sgeisser1/Tr-pfli/app/docs/screenshots/01_uebersicht_desktop.png

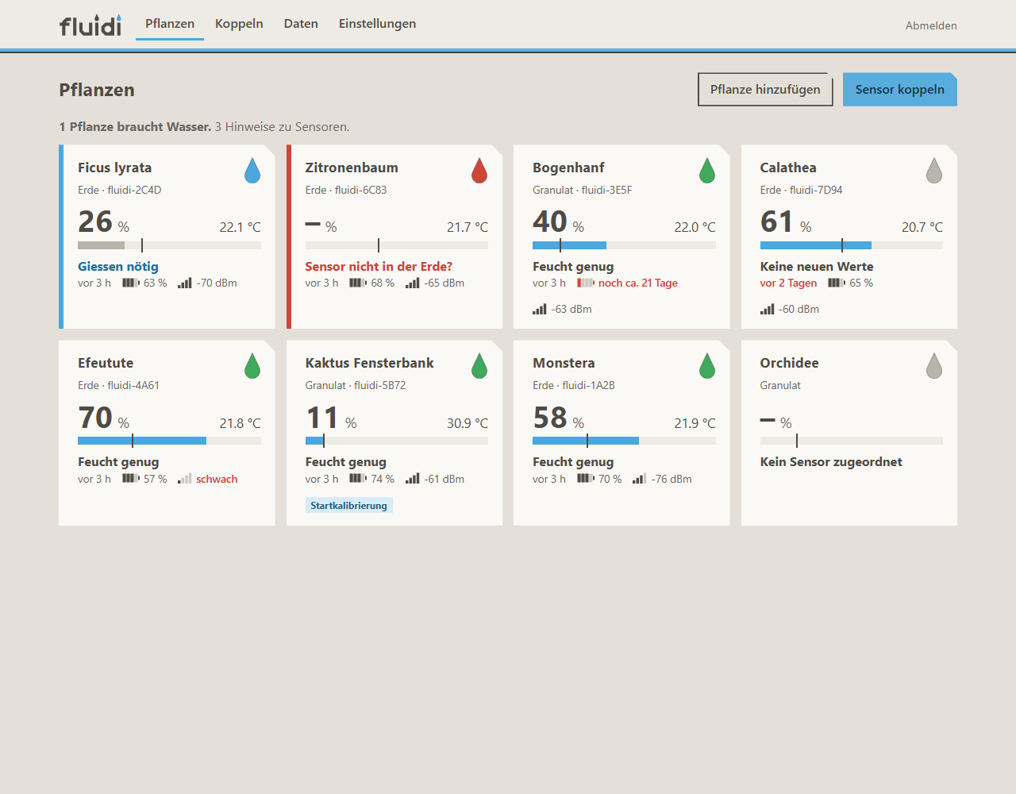
app/docs/screenshots/01_uebersicht_desktop.png
