sgeisser1/Tr-pfli/app/docs/screenshots/02_uebersicht_schmal.png

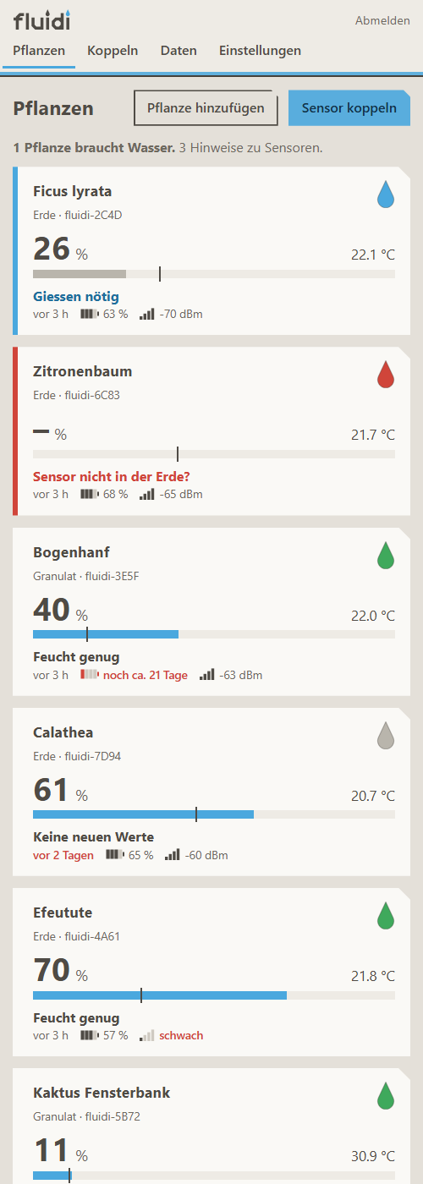
app/docs/screenshots/02_uebersicht_schmal.png
