sgeisser1/Tr-pfli/app/docs/screenshots/03_detail_woche_desktop.png

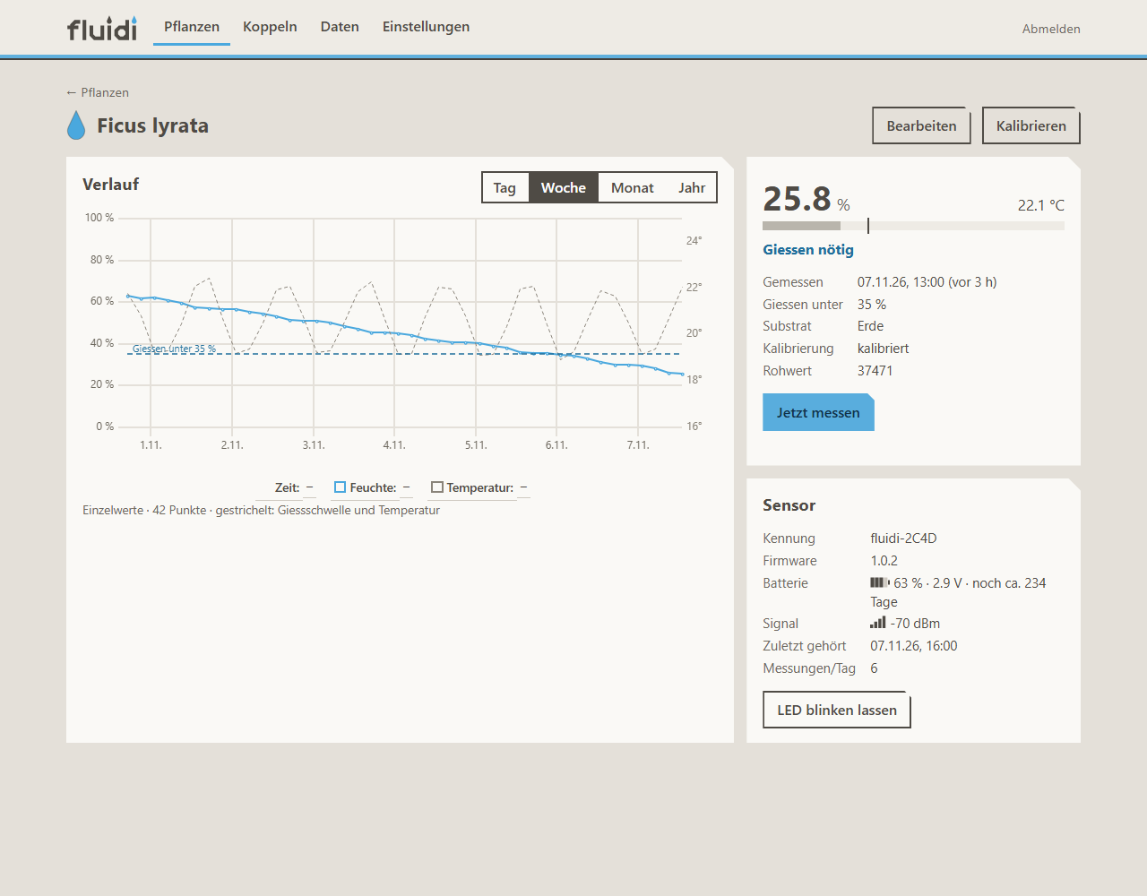
app/docs/screenshots/03_detail_woche_desktop.png
