sgeisser1/Tr-pfli/app/docs/screenshots/04_detail_jahr_schmal.png

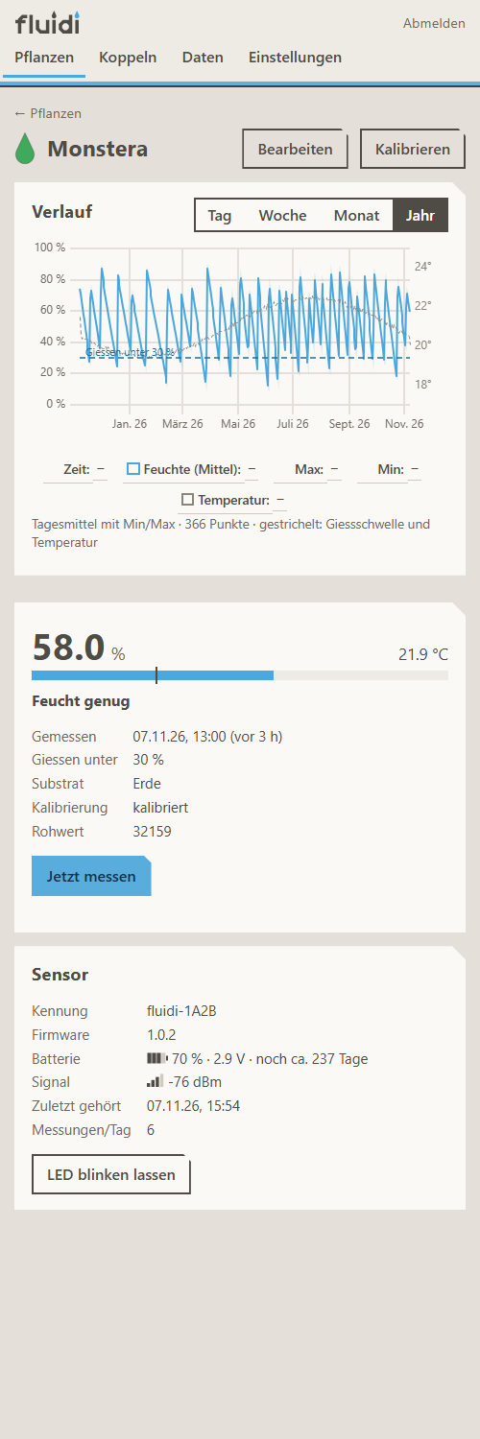
app/docs/screenshots/04_detail_jahr_schmal.png
