sgeisser1/Tr-pfli/app/docs/screenshots/06_bearbeiten.png

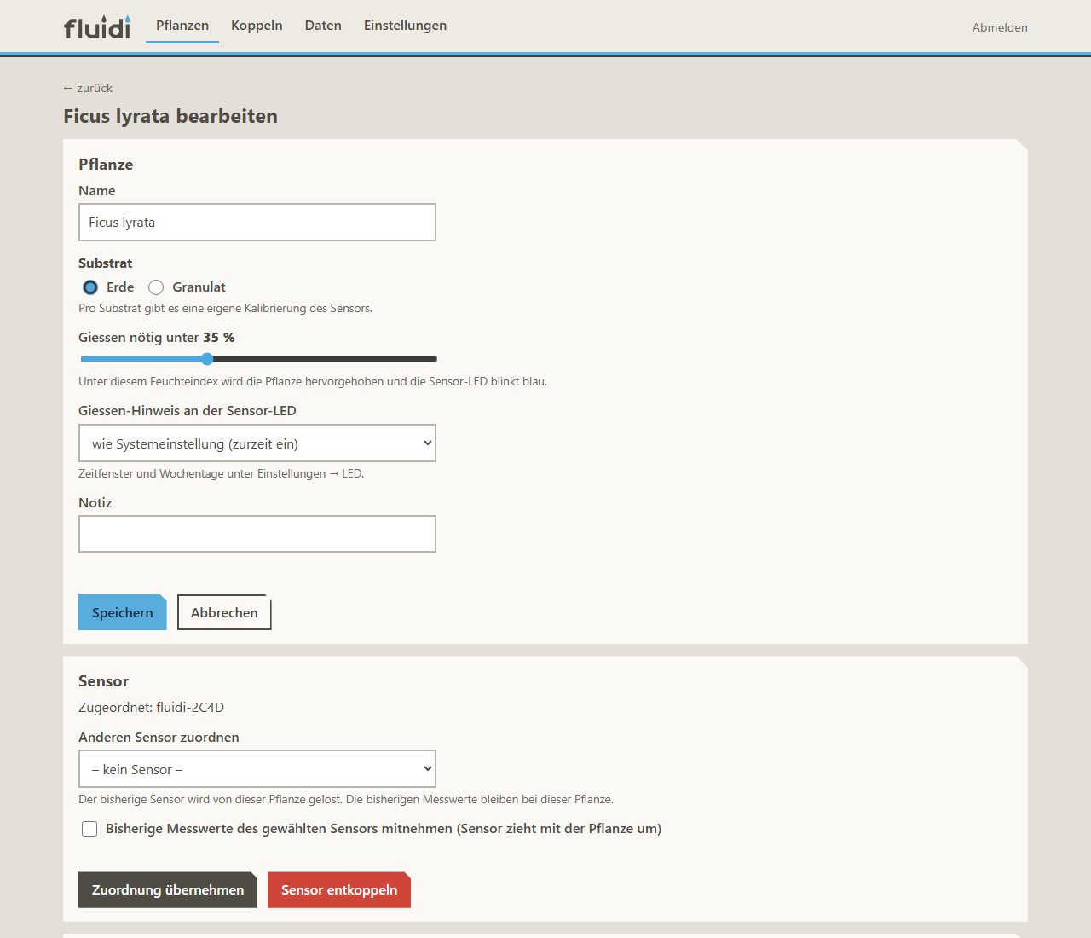
app/docs/screenshots/06_bearbeiten.png
