sgeisser1/Tr-pfli/app/docs/screenshots/08_koppeln.png

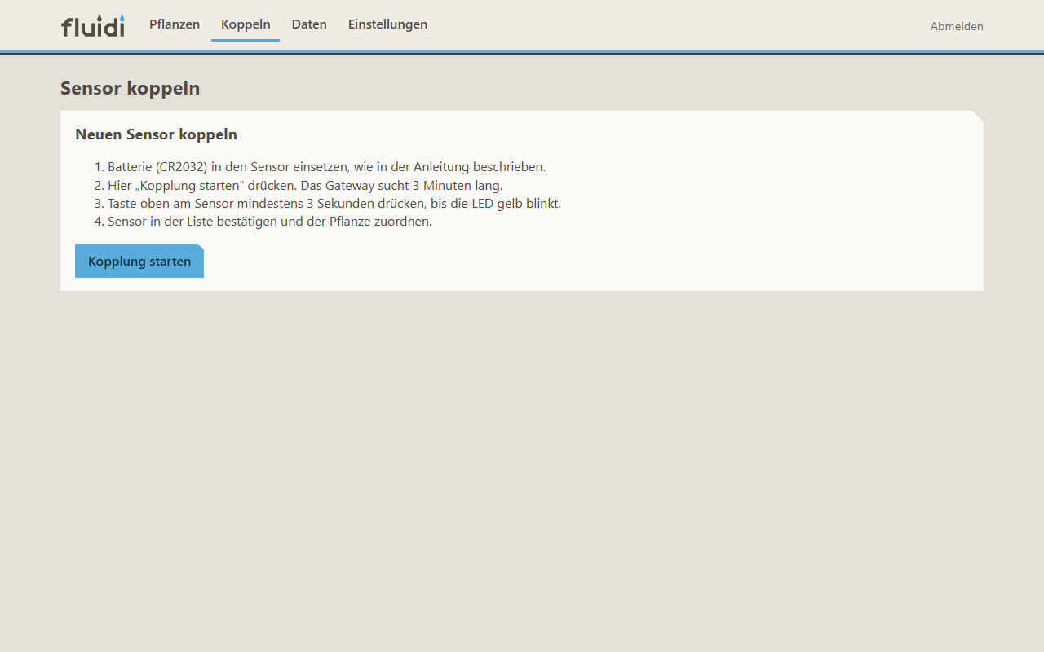
app/docs/screenshots/08_koppeln.png
