sgeisser1/Tr-pfli/app/docs/screenshots/09_einstellungen.png

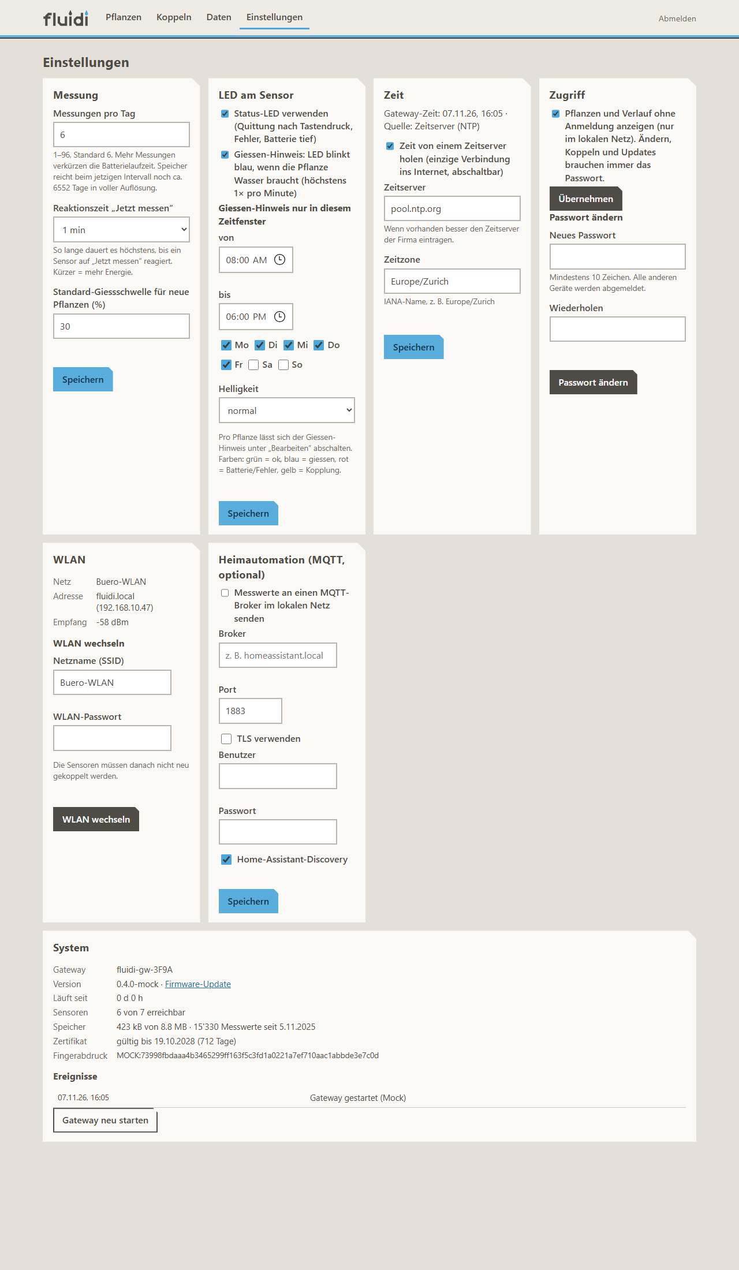
app/docs/screenshots/09_einstellungen.png
