sgeisser1/Tr-pfli/app/docs/screenshots/10_firmware.png

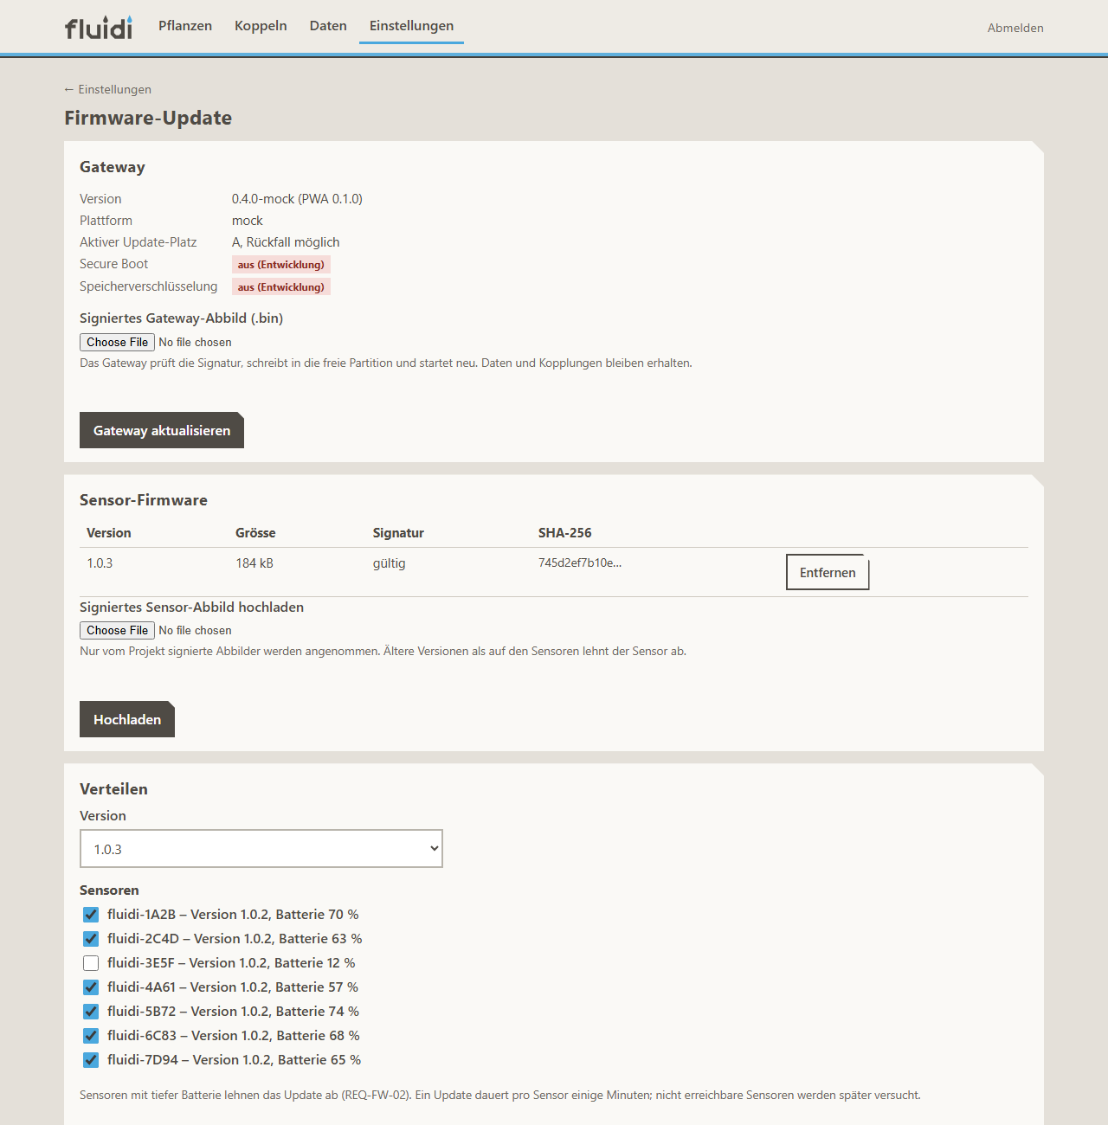
app/docs/screenshots/10_firmware.png
