sgeisser1/Tr-pfli/app/docs/screenshots/11_daten.png

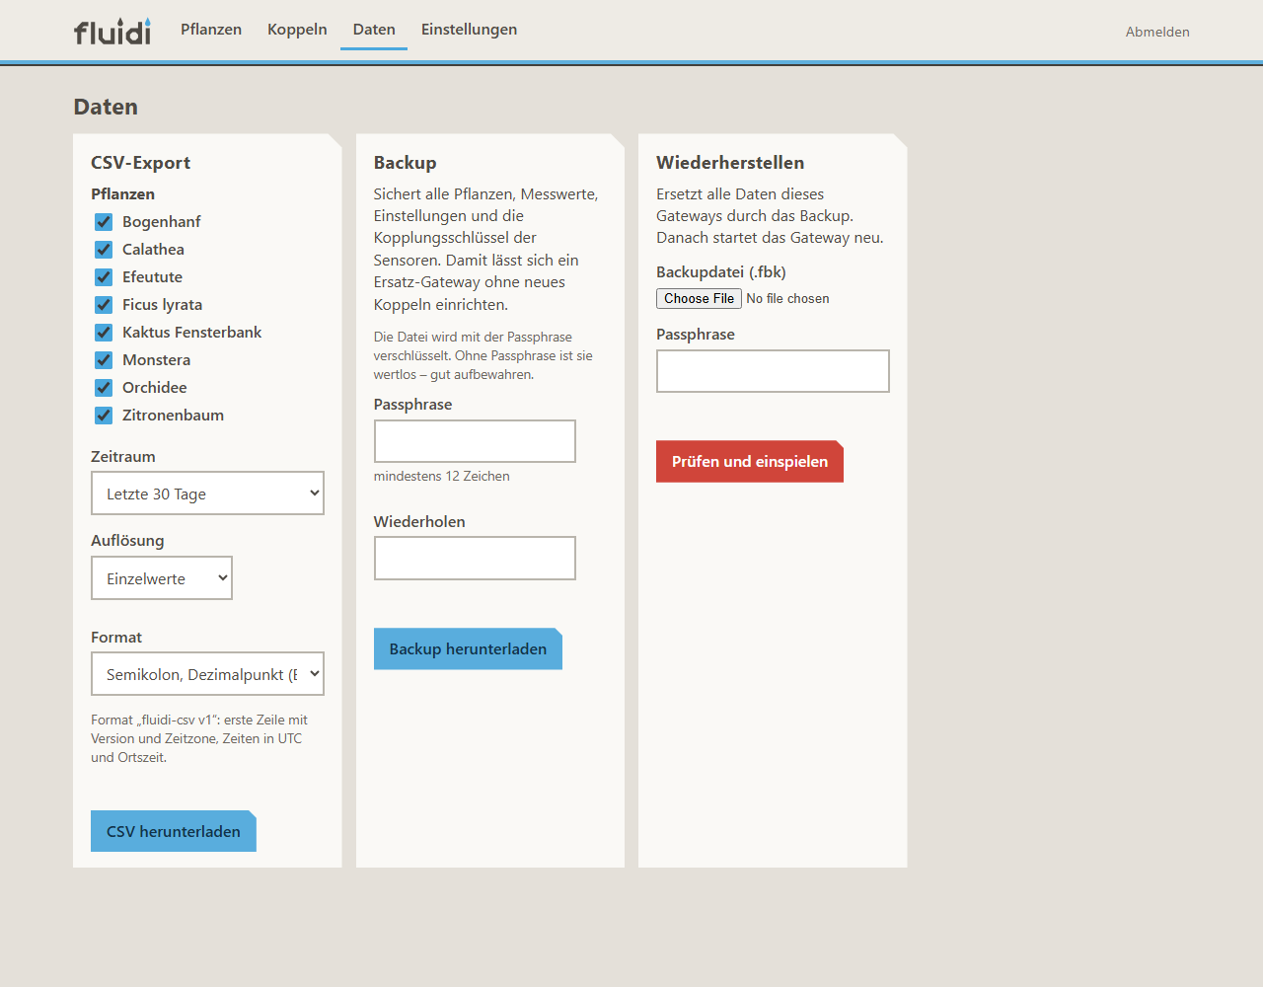
app/docs/screenshots/11_daten.png
