sgeisser1/Tr-pfli/app/docs/screenshots/12_anmelden_schmal.png

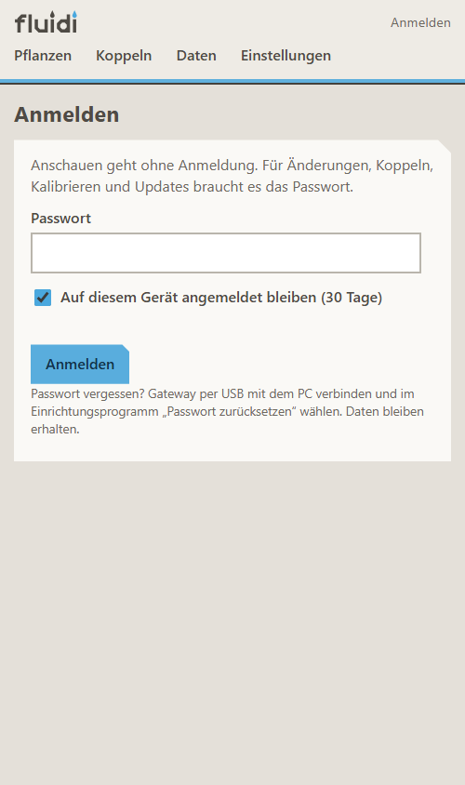
app/docs/screenshots/12_anmelden_schmal.png
