sgeisser1/Tr-pfli/app/docs/screenshots/13_einrichten_schmal.png

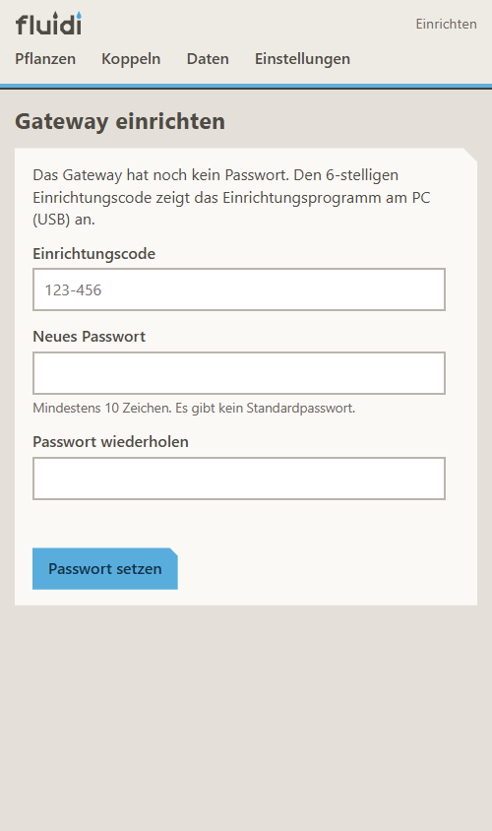
app/docs/screenshots/13_einrichten_schmal.png
