sgeisser1/Tr-pfli/app/docs/screenshots/14_detail_luft_schmal.png

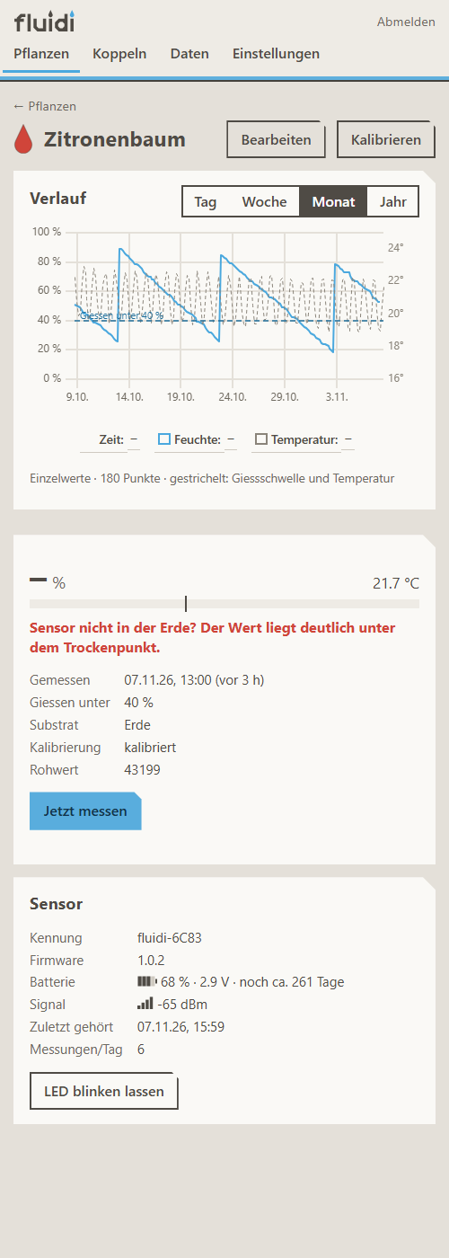
app/docs/screenshots/14_detail_luft_schmal.png
