sgeisser1/Tr-pfli/docs/datasheets/Adafruit_5776_SHT41_Schematic_2023-07.png

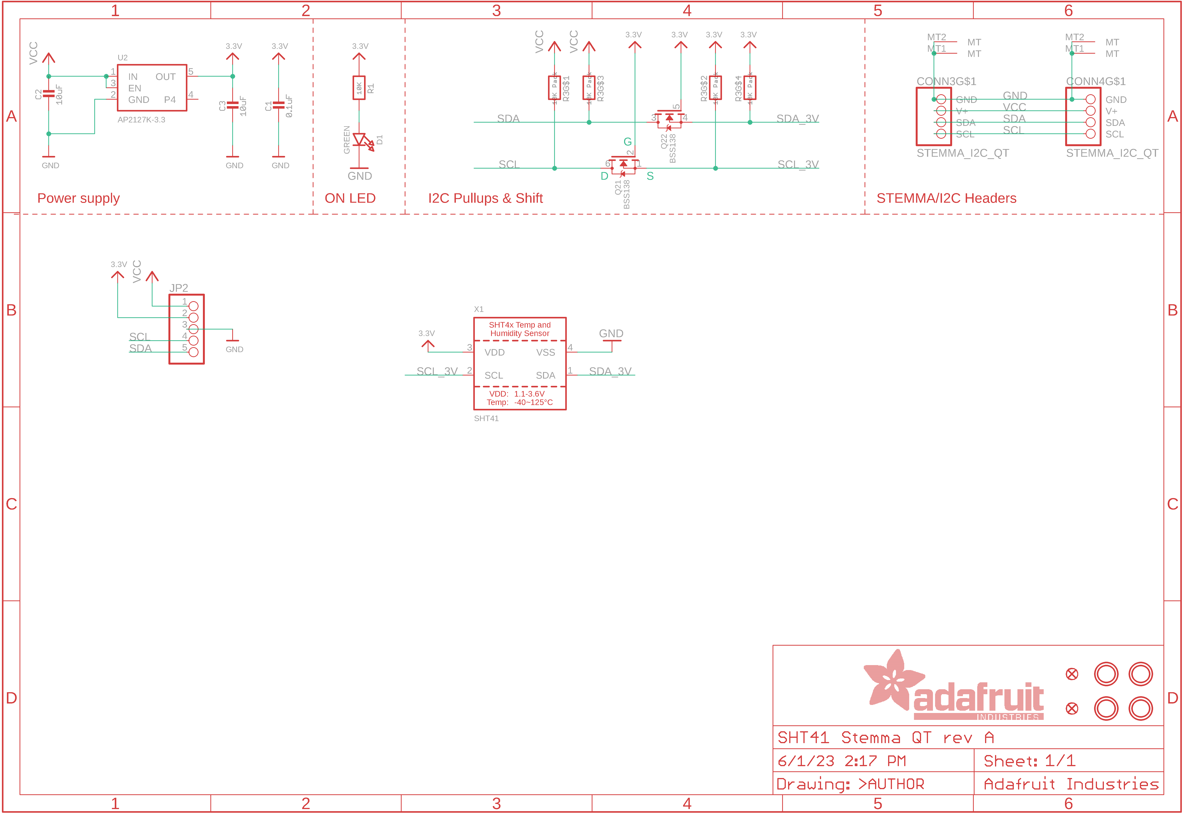
docs/datasheets/Adafruit_5776_SHT41_Schematic_2023-07.png
