sgeisser1/Tr-pfli/docs/datasheets/DFRobot_SEN0428_Dimensions_V0.1.png

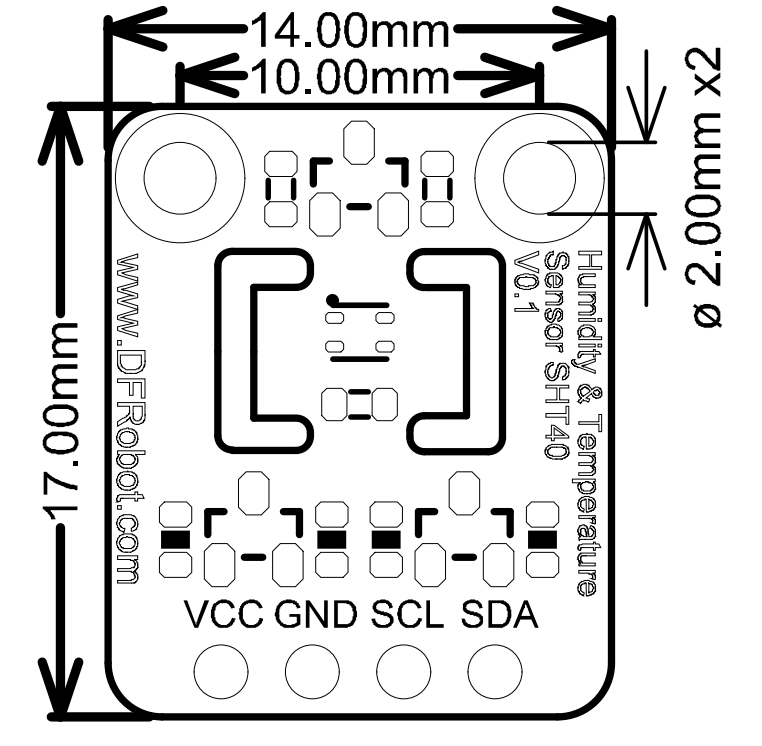
docs/datasheets/DFRobot_SEN0428_Dimensions_V0.1.png
