sgeisser1/Tr-pfli/docs/references/JLCPCB_ExtraCharges_SmallBoards_Tabelle_2026-11-08.png

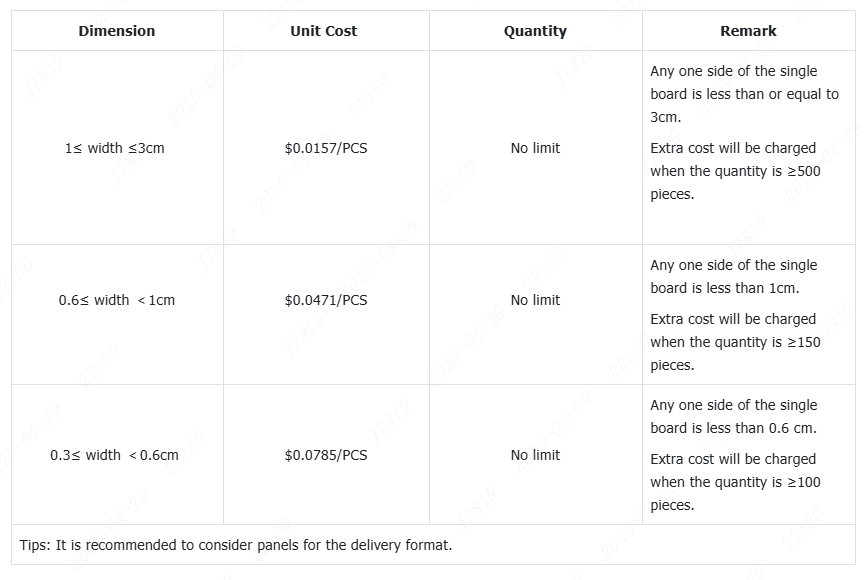
docs/references/JLCPCB_ExtraCharges_SmallBoards_Tabelle_2026-11-08.png
