sgeisser1/Tr-pfli/hardware/programmer/out/behelf_lageplan.png

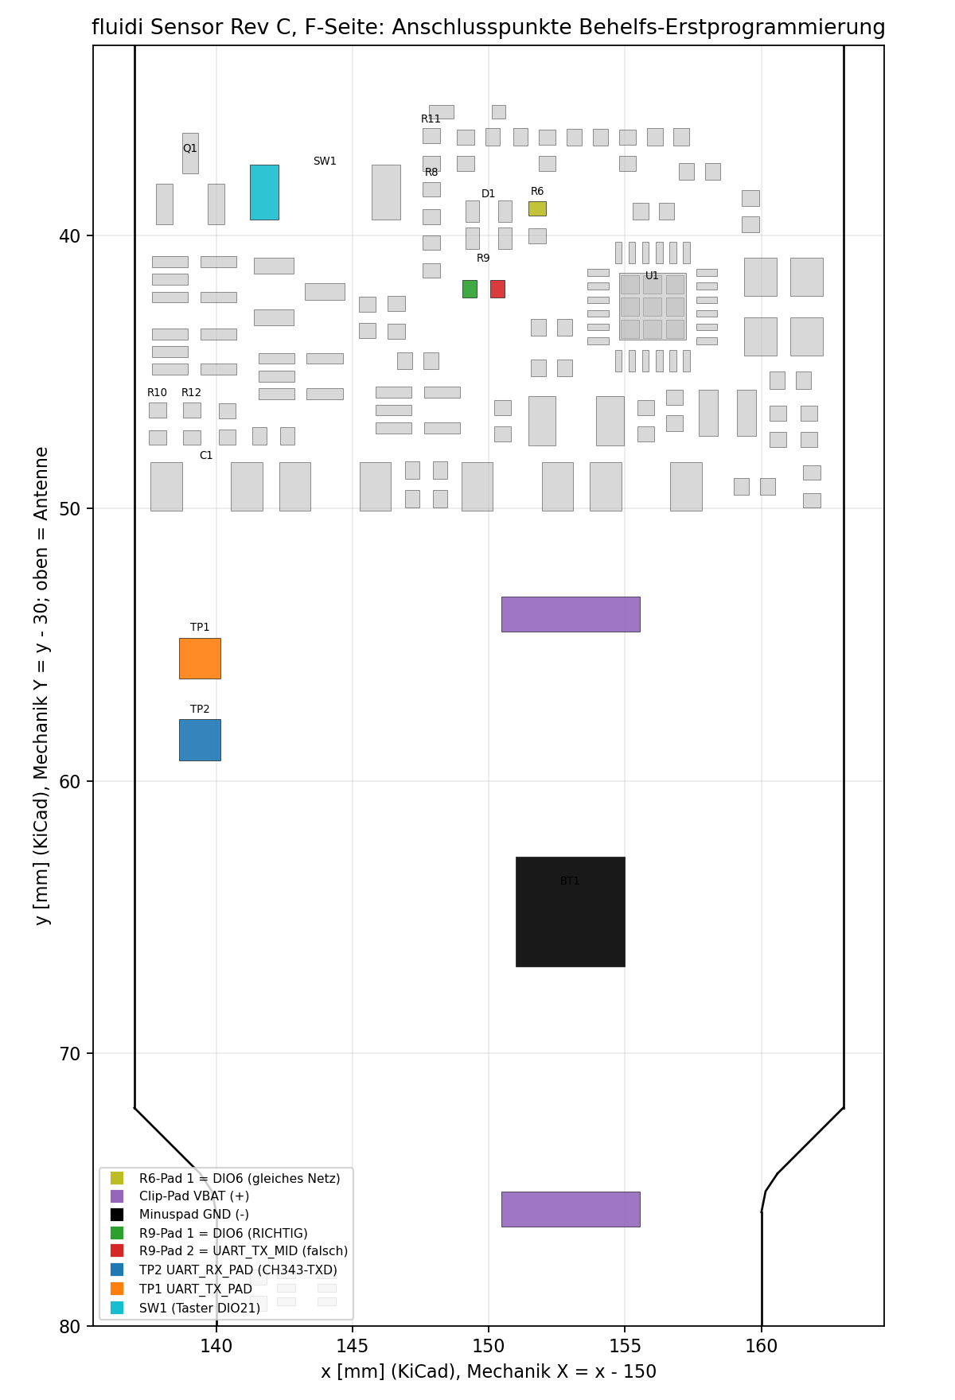
hardware/programmer/out/behelf_lageplan.png
