sgeisser1/Tr-pfli/hardware/sensor/out/floorplan_options.png

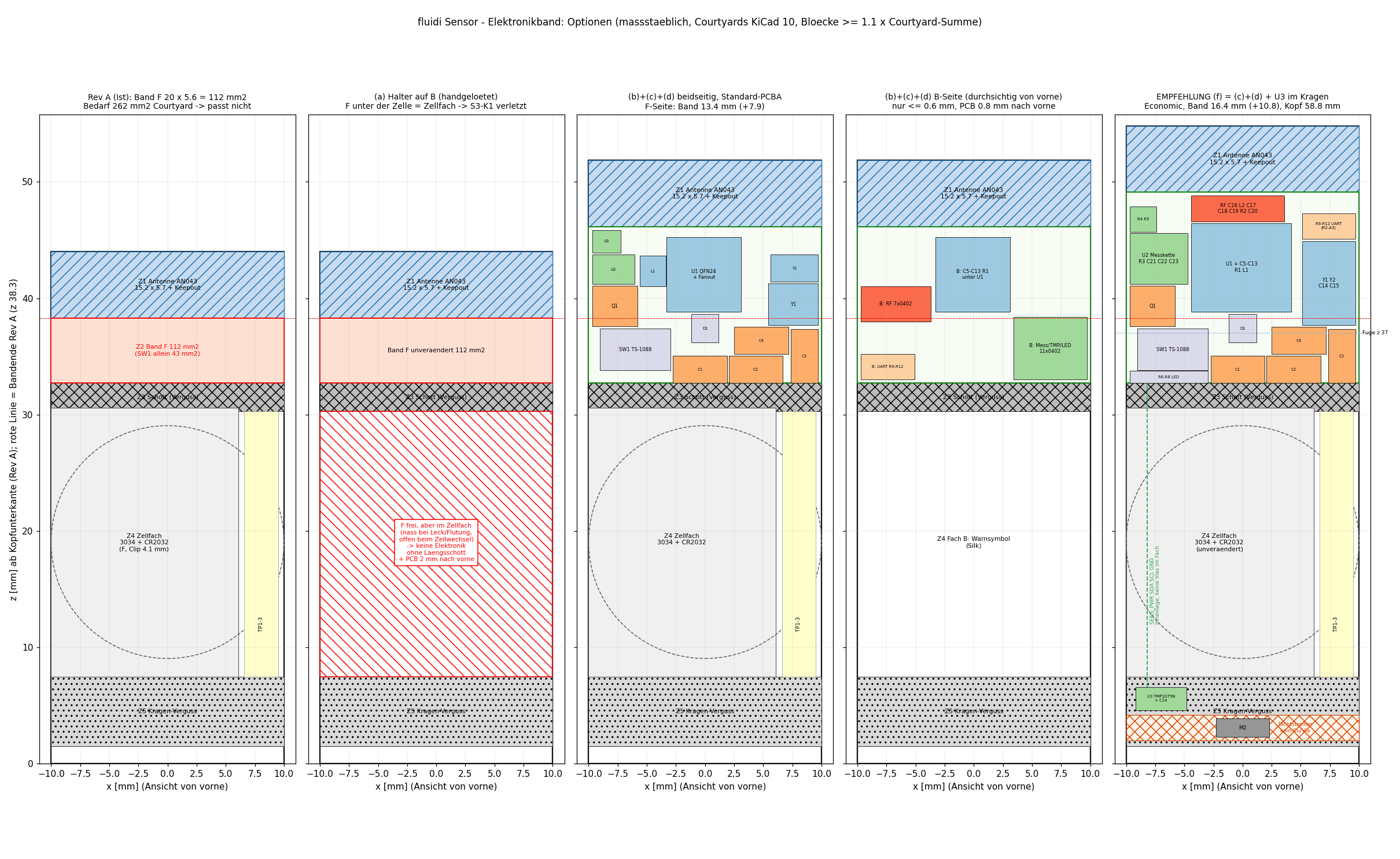
hardware/sensor/out/floorplan_options.png
