sgeisser1/Tr-pfli/hardware/sensor/out/layout_band_routing.png

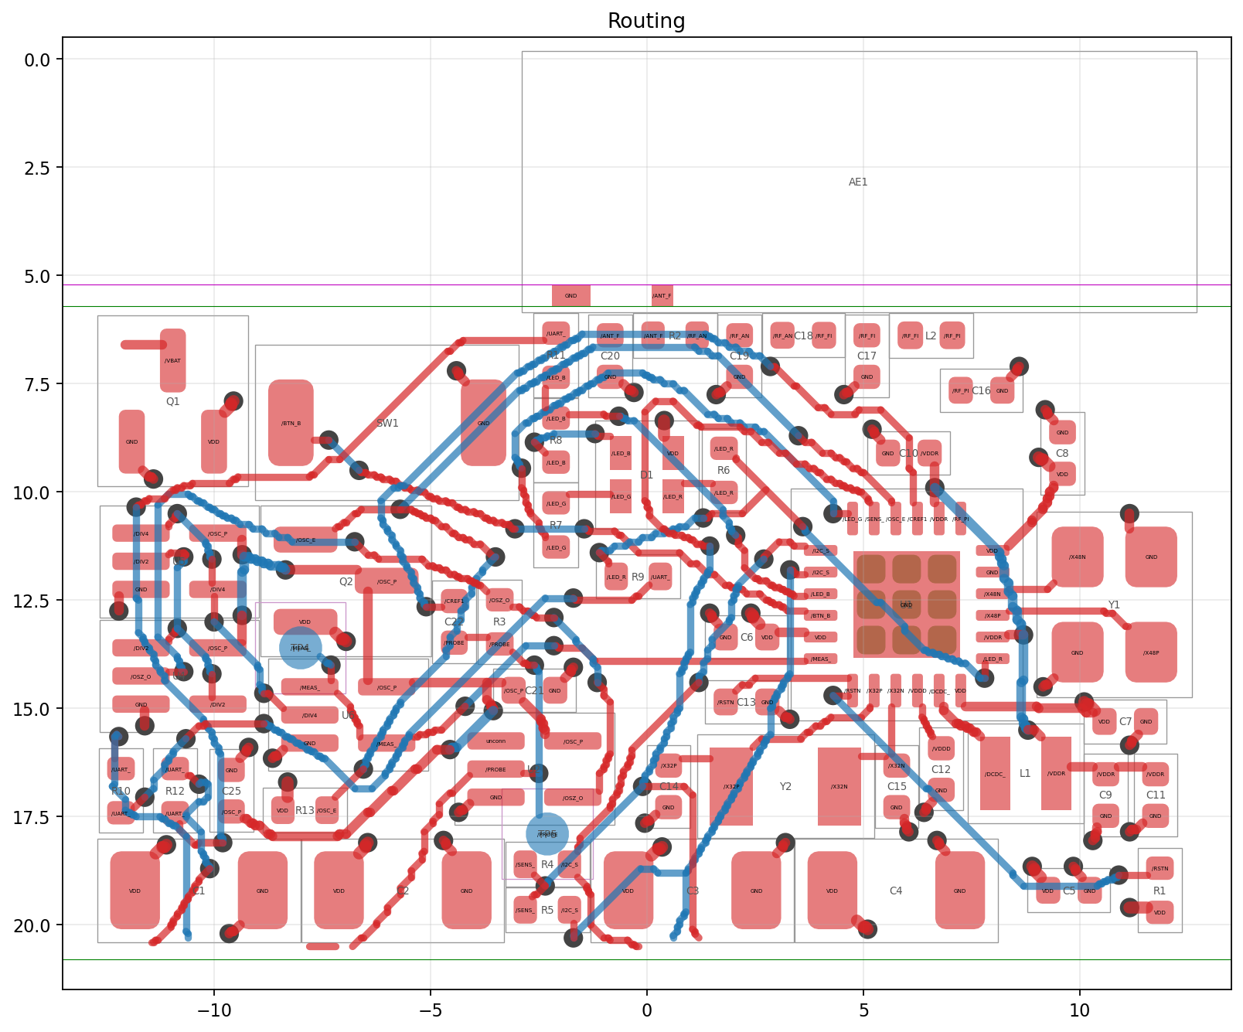
hardware/sensor/out/layout_band_routing.png
