sgeisser1/Tr-pfli/hardware/sensor/out/render/fluidi_sensor_bottom.png

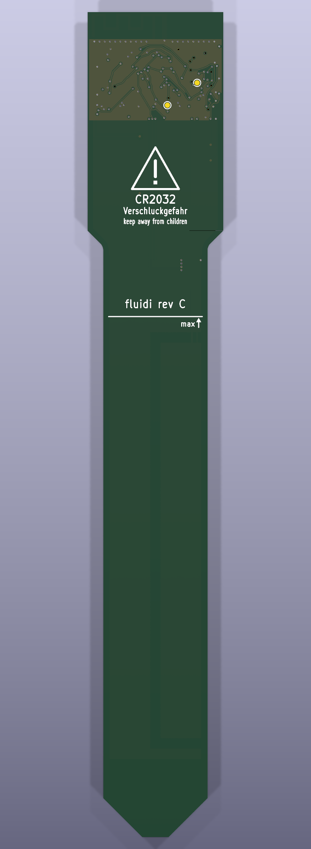
hardware/sensor/out/render/fluidi_sensor_bottom.png
