sgeisser1/Tr-pfli/hardware/sensor/out/render/fluidi_sensor_kopf_top.png

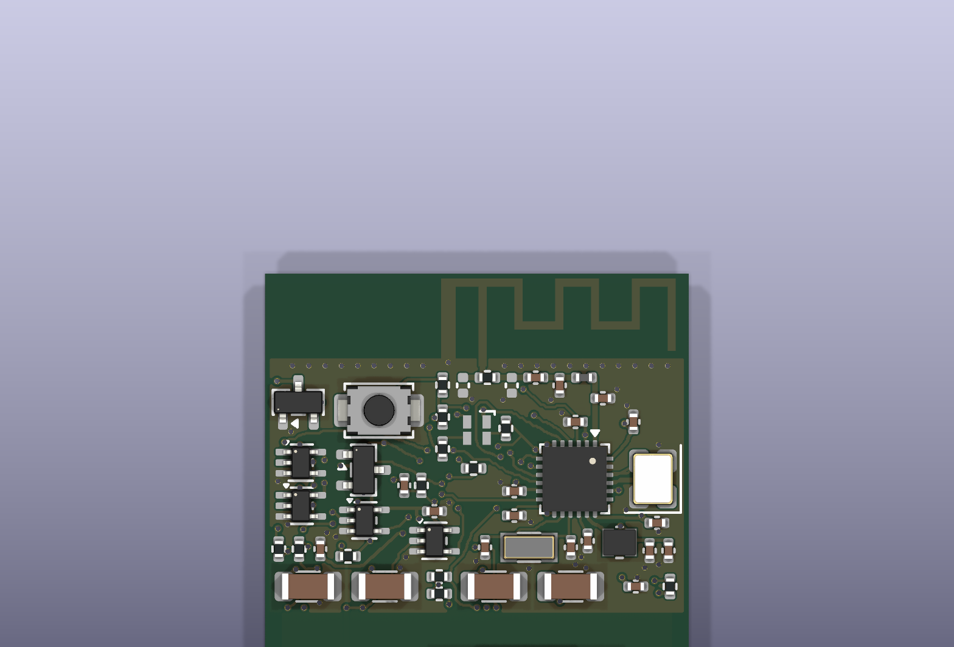
hardware/sensor/out/render/fluidi_sensor_kopf_top.png
