sgeisser1/Tr-pfli/mechanical/gateway_pi/preview.png

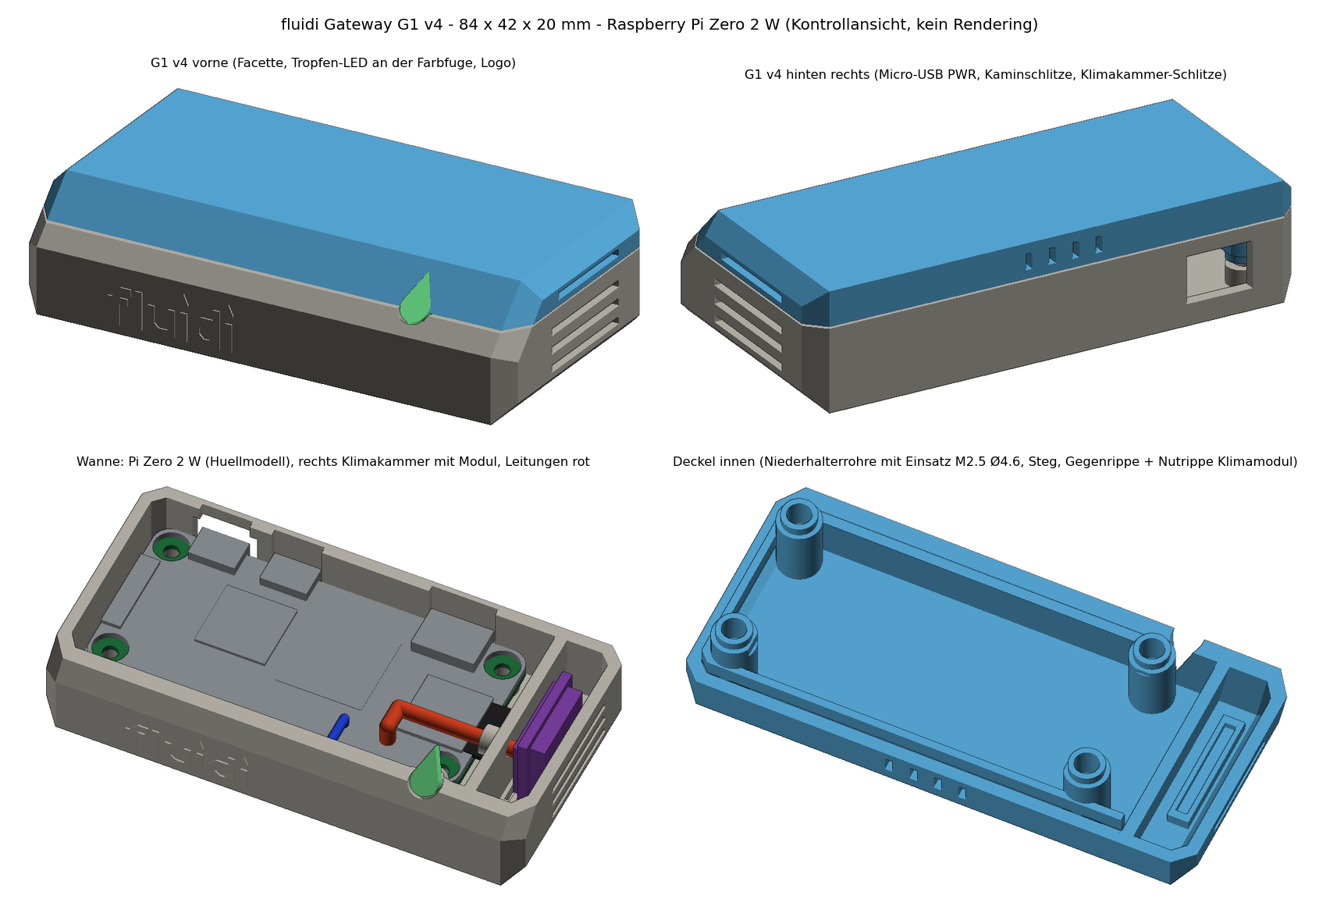
mechanical/gateway_pi/preview.png
