sgeisser1/Tr-pfli/mechanical/interfaces/pcb_rev_b_floorplan.png

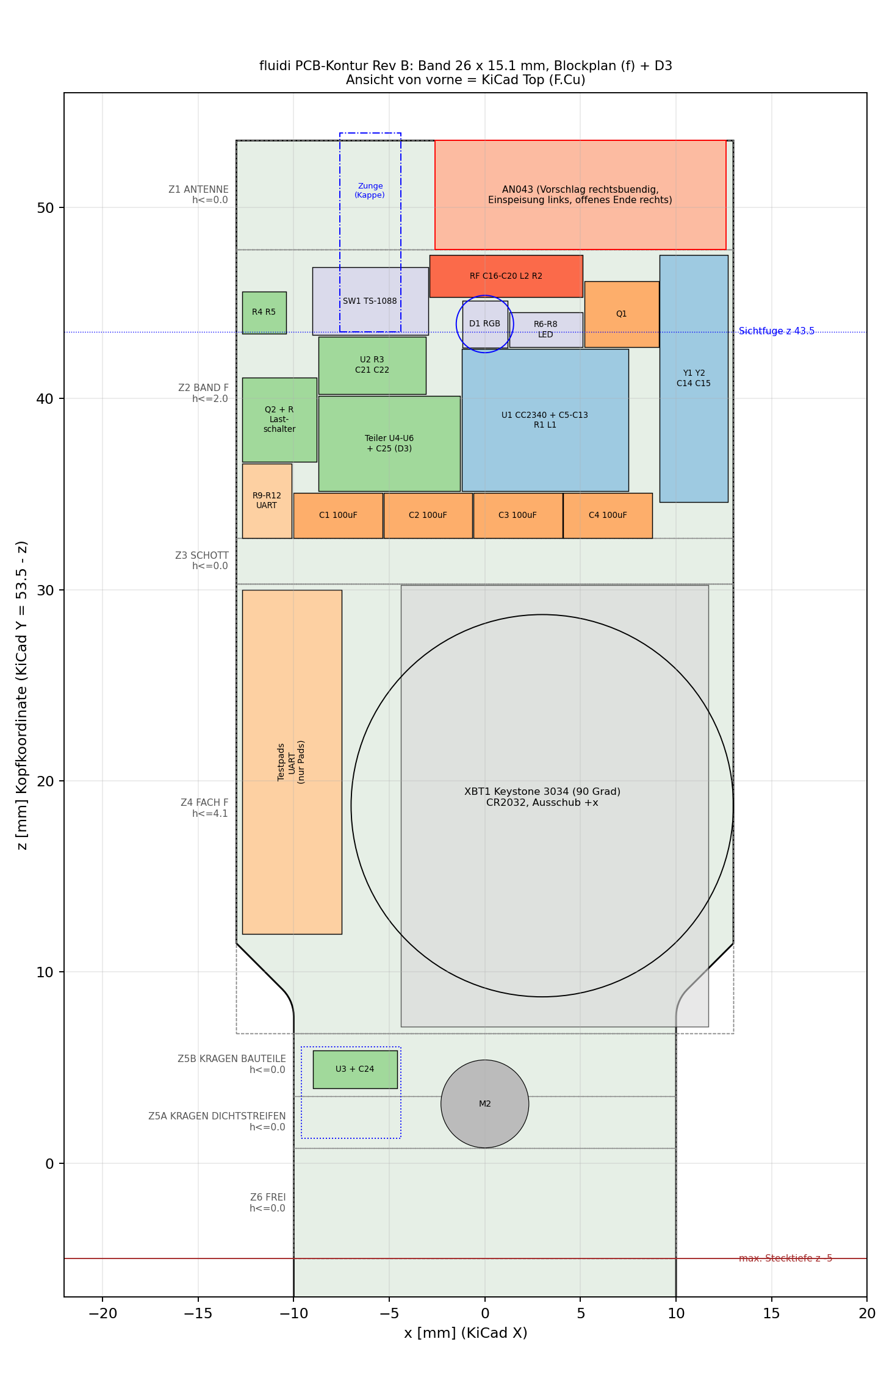
mechanical/interfaces/pcb_rev_b_floorplan.png
