sgeisser1/Tr-pfli/production/rev-C/9_renderings/fluidi_01_topf_led_gruen.png

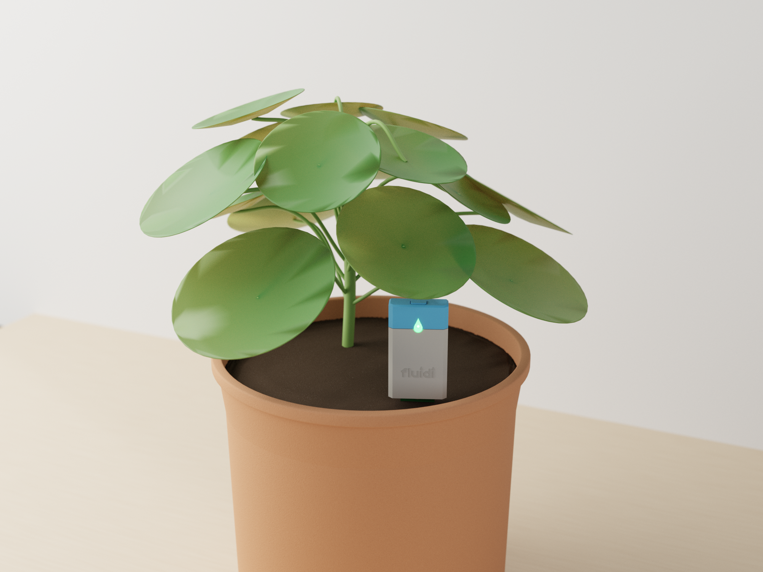
production/rev-C/9_renderings/fluidi_01_topf_led_gruen.png
