sgeisser1/Tr-pfli/production/rev-C/9_renderings/fluidi_02_nah_led_blau.png

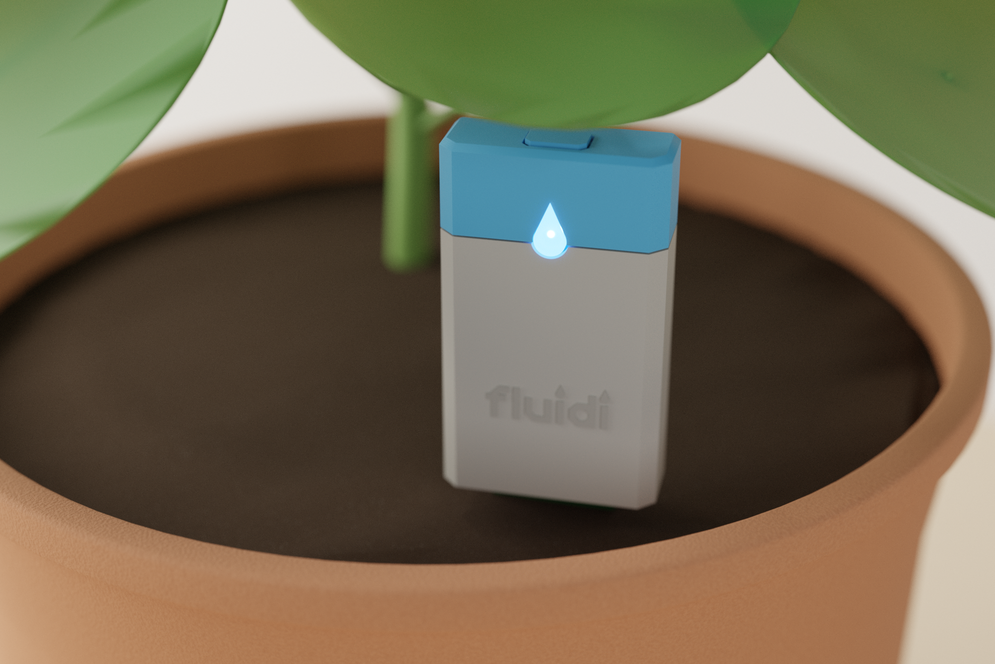
production/rev-C/9_renderings/fluidi_02_nah_led_blau.png
