sgeisser1/Tr-pfli/production/rev-C/9_renderings/fluidi_03_explosion.png

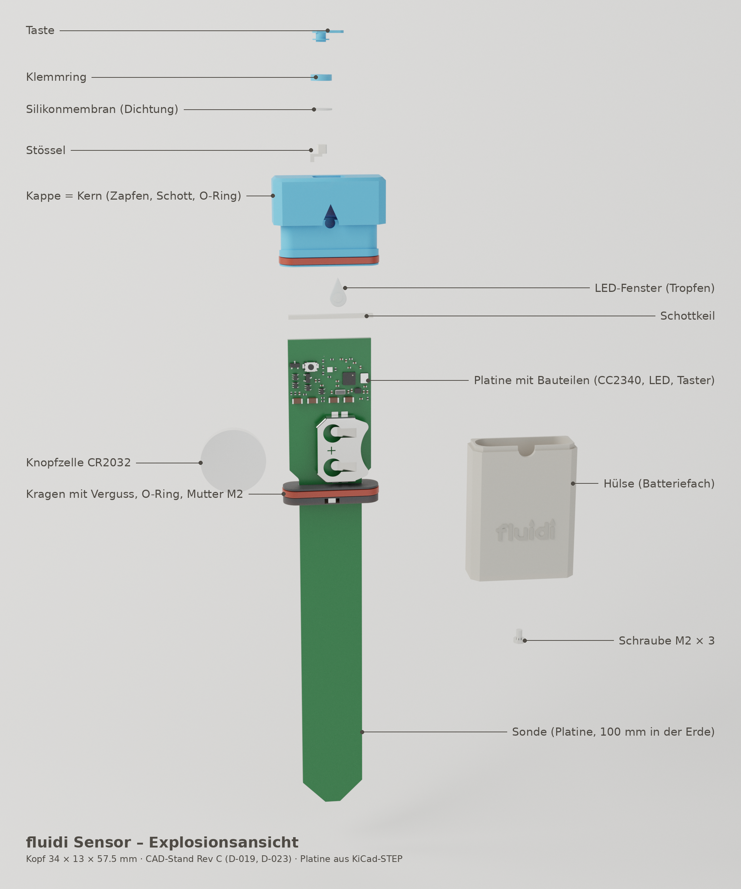
production/rev-C/9_renderings/fluidi_03_explosion.png
