sgeisser1/Tr-pfli/production/rev-C/9_renderings/fluidi_04_batteriewechsel.png

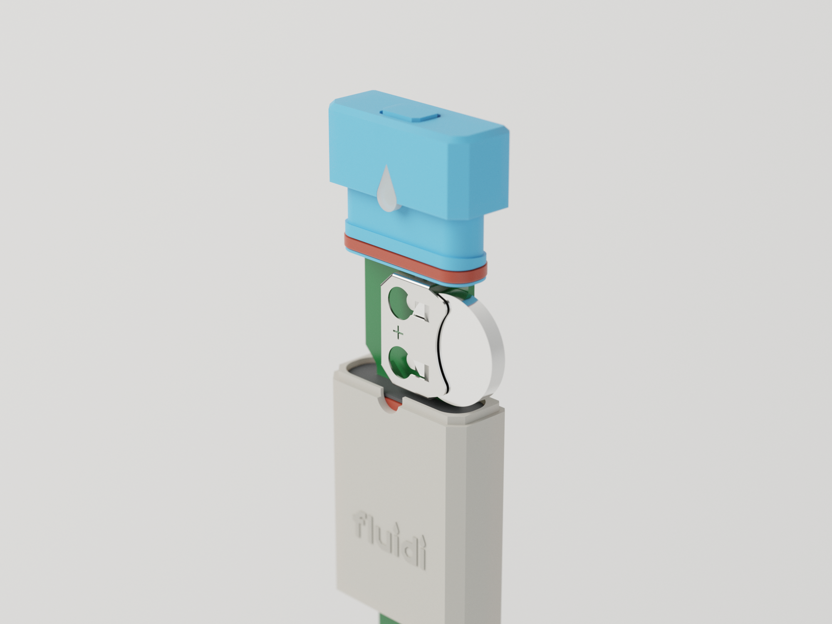
production/rev-C/9_renderings/fluidi_04_batteriewechsel.png
