sgeisser1/Tr-pfli/production/rev-C/9_renderings/fluidi_05_gateway_buero.png

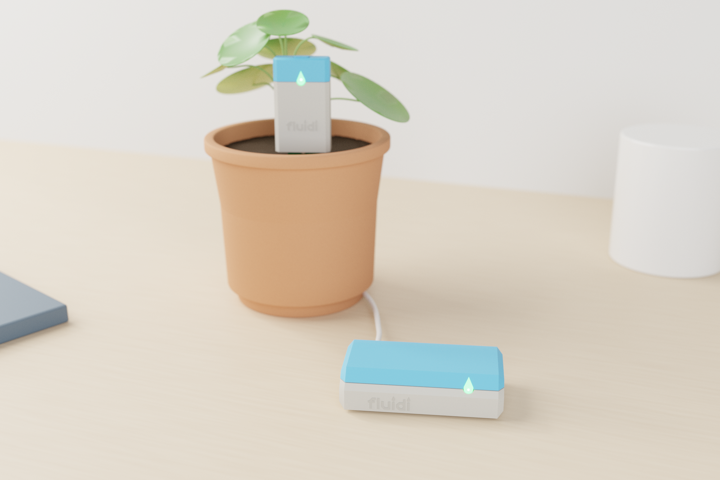
production/rev-C/9_renderings/fluidi_05_gateway_buero.png
