sgeisser1/Tr-pfli/production/rev-C/9_renderings/fluidi_06_produktfoto.png

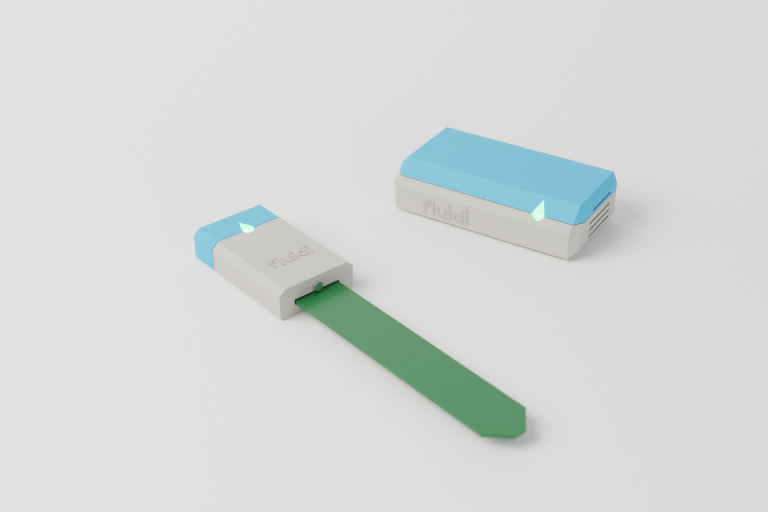
production/rev-C/9_renderings/fluidi_06_produktfoto.png
