sgeisser1/Tr-pfli/production/rev-C/9_renderings/pcb/fluidi_pcb_iso.png

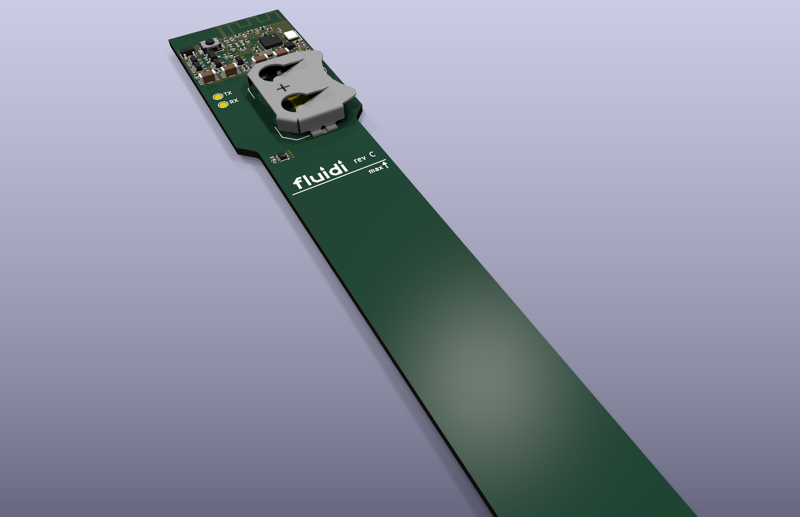
production/rev-C/9_renderings/pcb/fluidi_pcb_iso.png
