sgeisser1/Tr-pfli/production/rev-C/9_renderings/pcb/fluidi_pcb_top.png

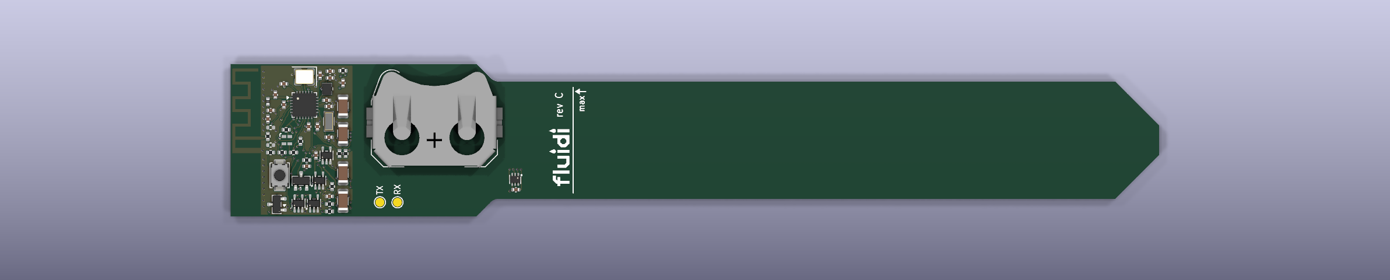
production/rev-C/9_renderings/pcb/fluidi_pcb_top.png
