sgeisser1/Tr-pfli/renders/phase4_prop/prop_nah_V4.png

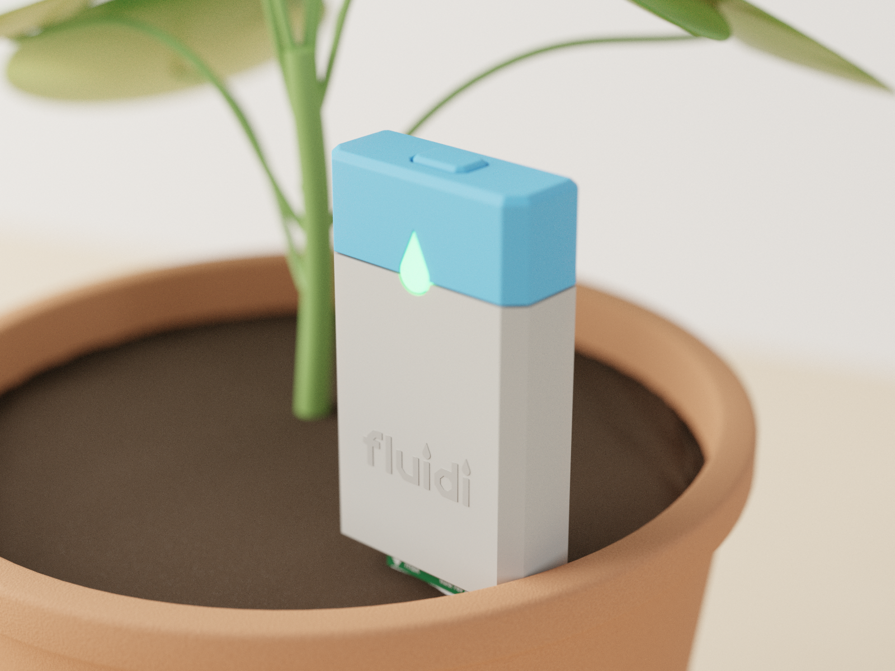
renders/phase4_prop/prop_nah_V4.png
