sgeisser1/Tr-pfli/simulation/field/plots/2d_feldbild_eindringtiefe.png

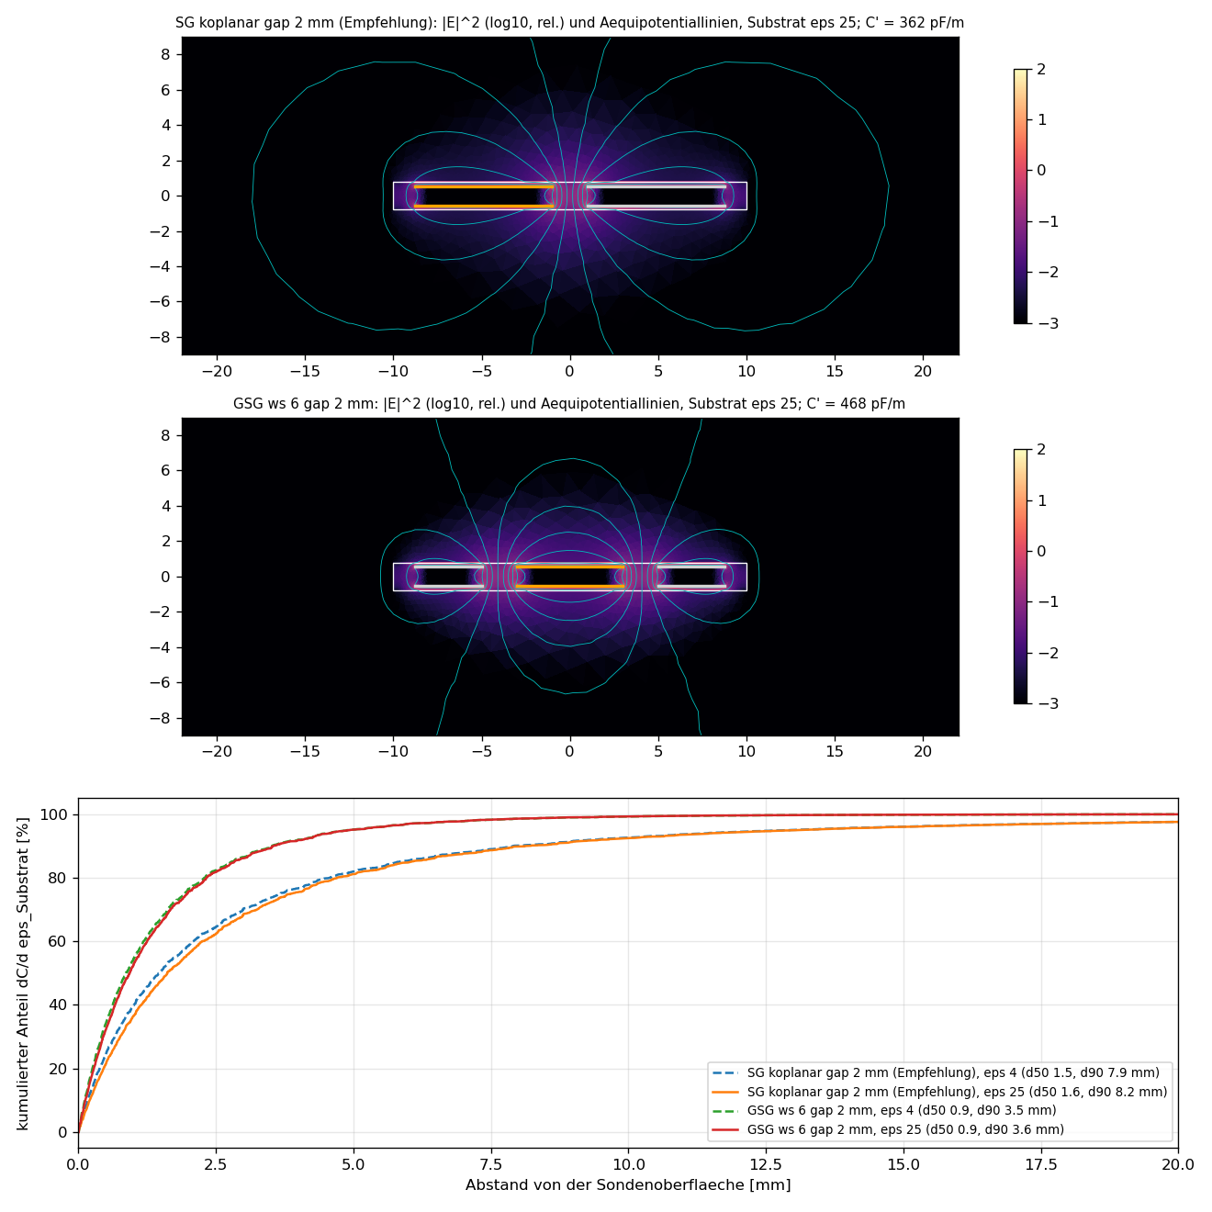
simulation/field/plots/2d_feldbild_eindringtiefe.png
