sgeisser1/Tr-pfli/simulation/field/plots/2d_isolation_2L4L.png

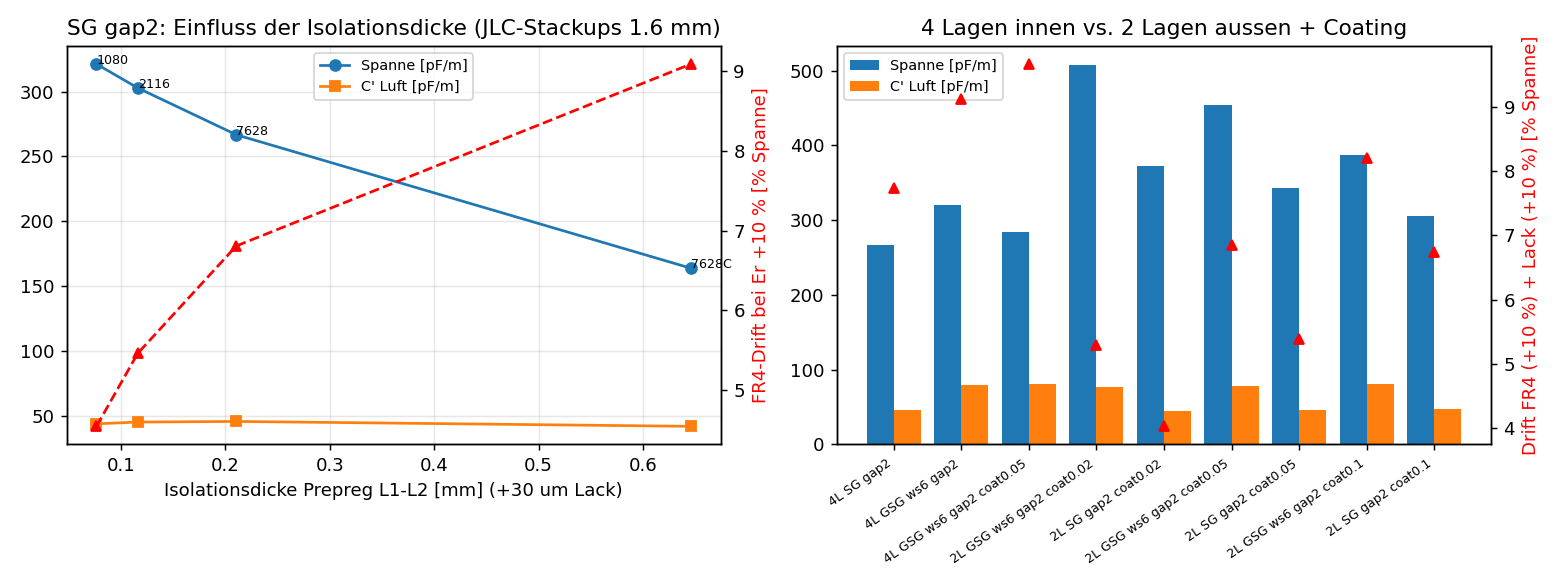
simulation/field/plots/2d_isolation_2L4L.png
