sgeisser1/Tr-pfli/simulation/field/plots/2d_salt_ceff.png

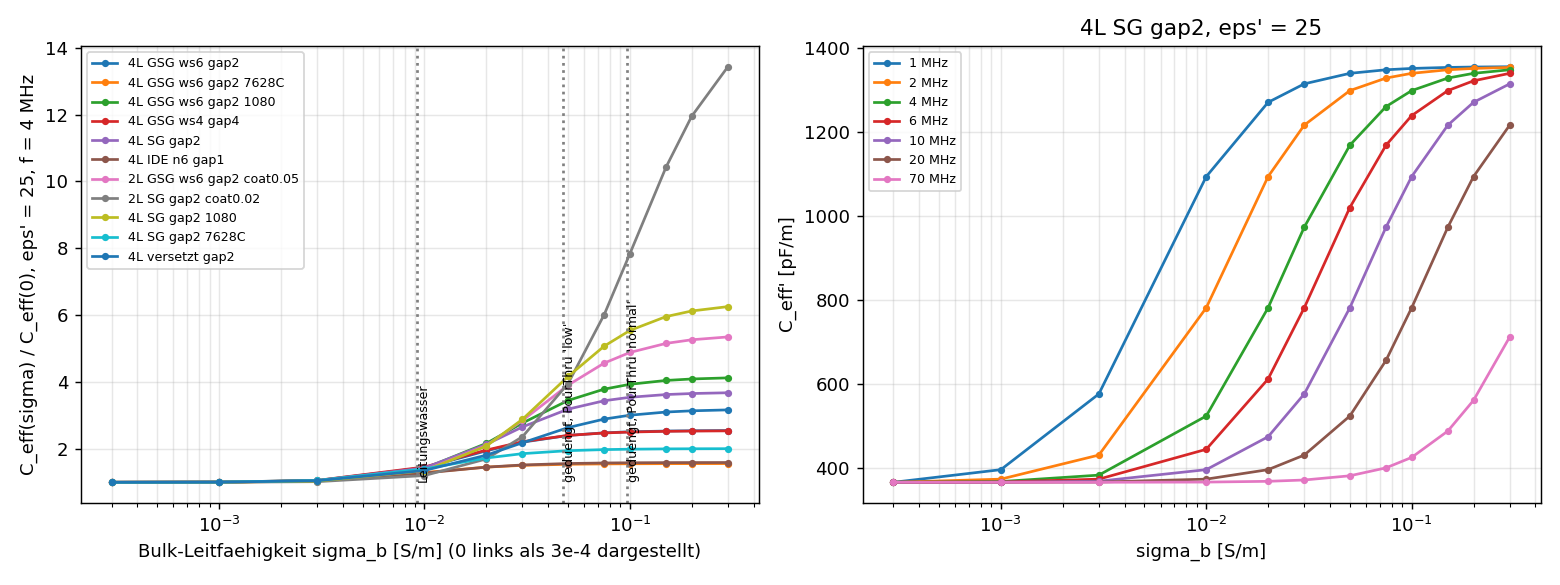
simulation/field/plots/2d_salt_ceff.png
