sgeisser1/Tr-pfli/simulation/field/plots/2d_topologien.png

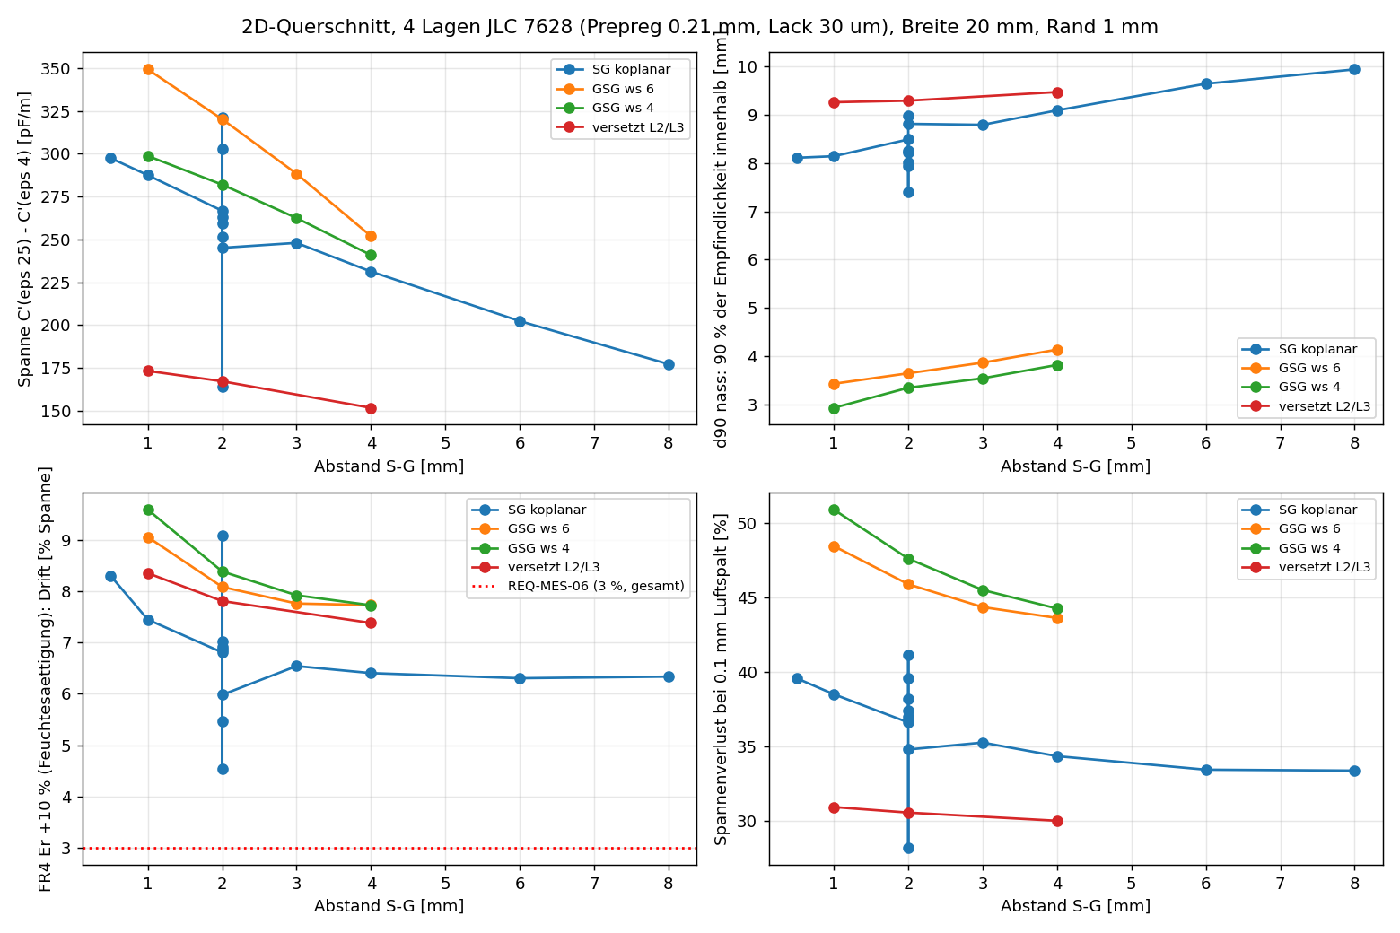
simulation/field/plots/2d_topologien.png
