sgeisser1/Tr-pfli/simulation/field/plots/3d_fill.png

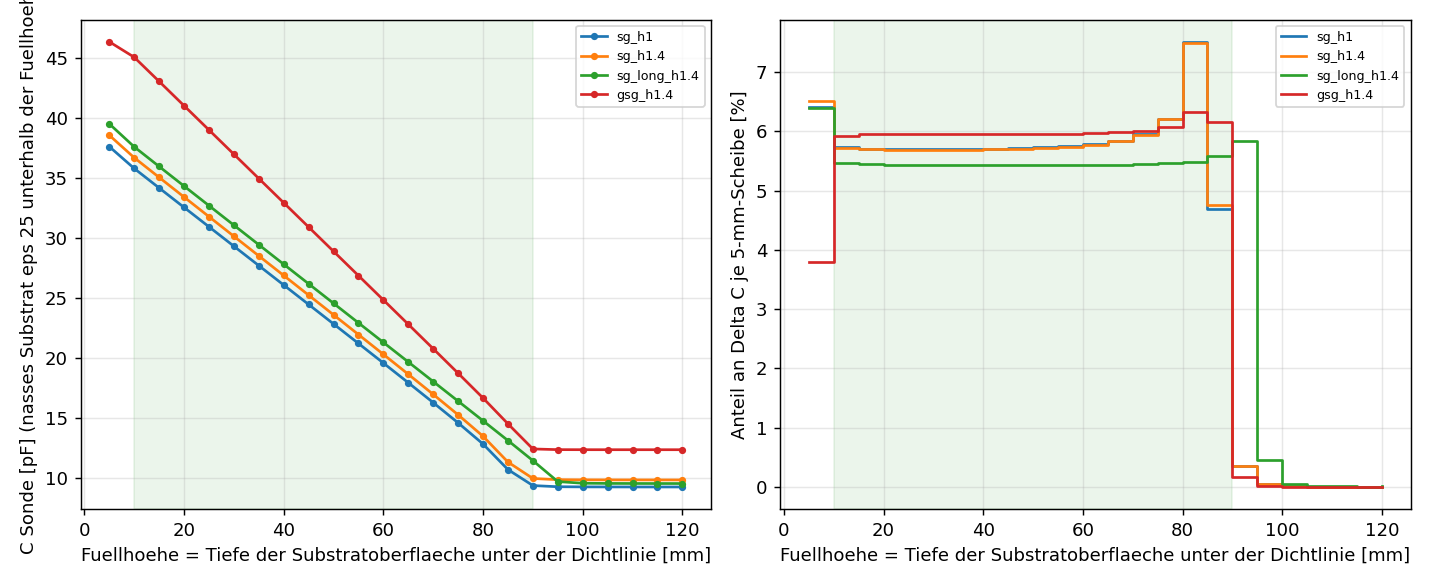
simulation/field/plots/3d_fill.png
