sgeisser1/Tr-pfli/simulation/field/plots/sketch_electrodes.png

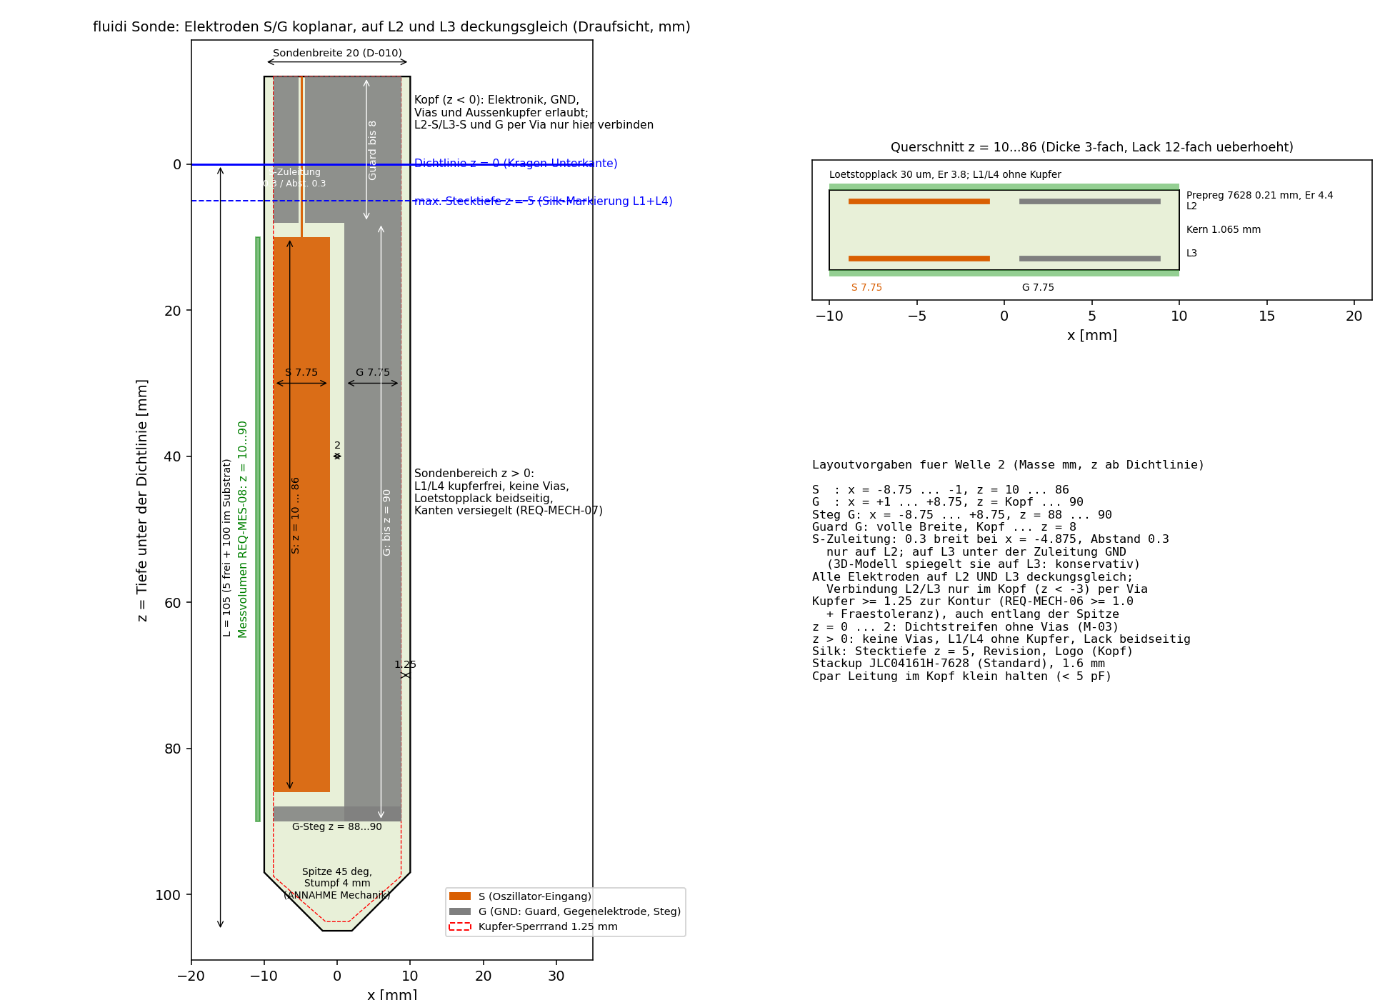
simulation/field/plots/sketch_electrodes.png
