sgeisser1/Tr-pfli/simulation/spice/osc/osc_freq.png

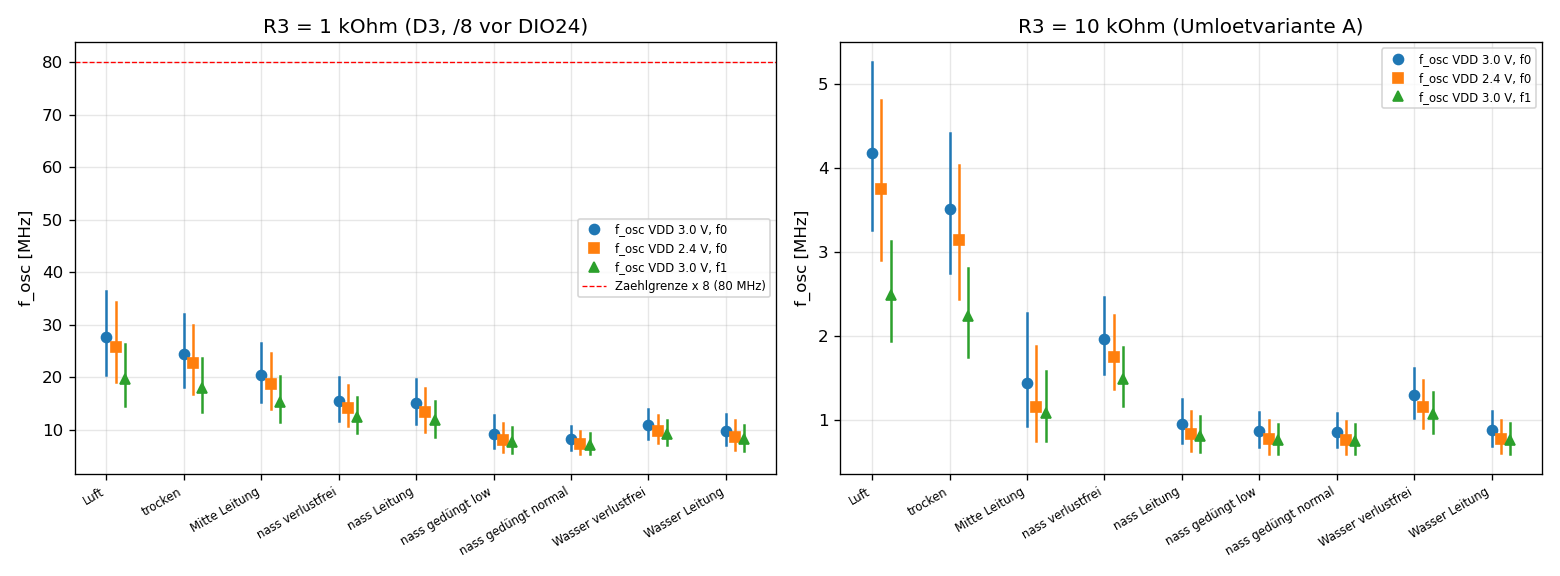
simulation/spice/osc/osc_freq.png
