sgeisser1/Tr-pfli/simulation/spice/osc/osc_waveforms.png

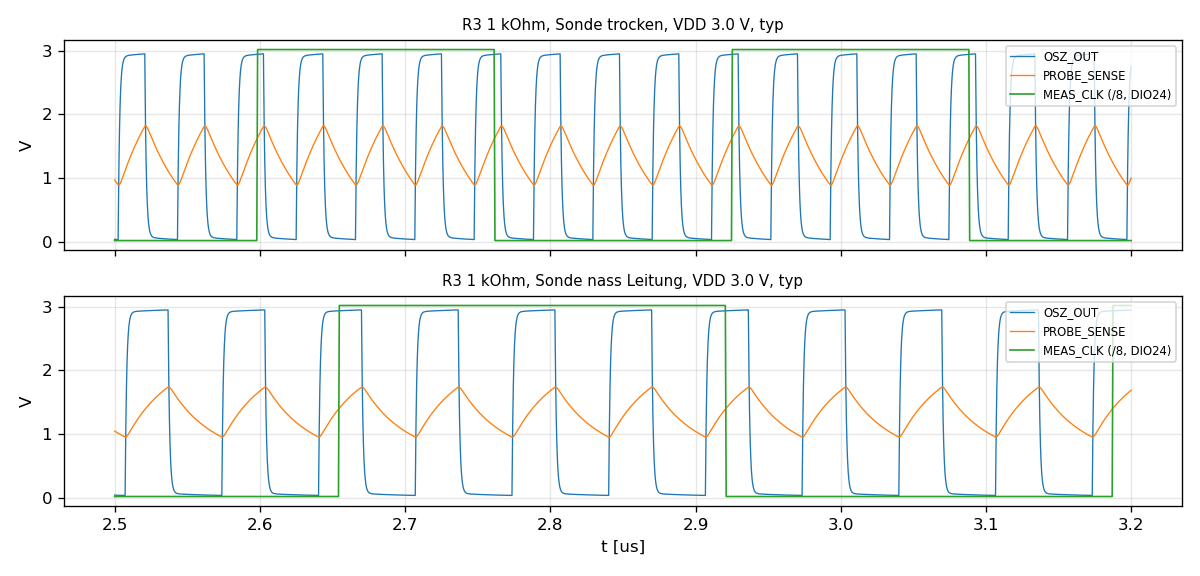
simulation/spice/osc/osc_waveforms.png
