sgeisser1/Tr-pfli/simulation/spice/programmer/prog_uart_pl2303_pwr.png

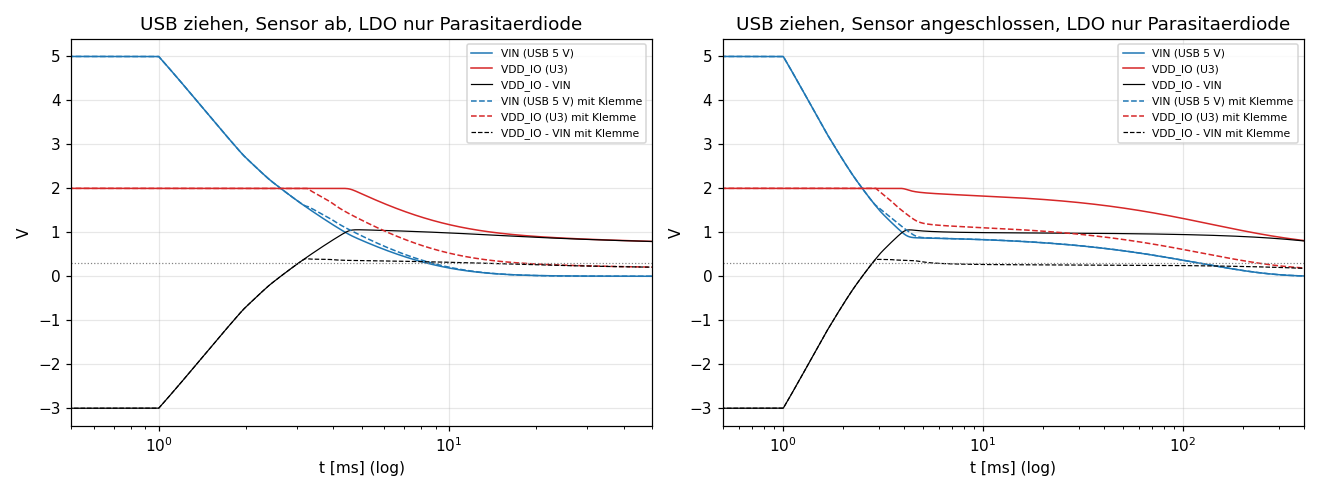
simulation/spice/programmer/prog_uart_pl2303_pwr.png
