sgeisser1/Tr-pfli/simulation/spice/programmer/prog_uart_waveforms.png

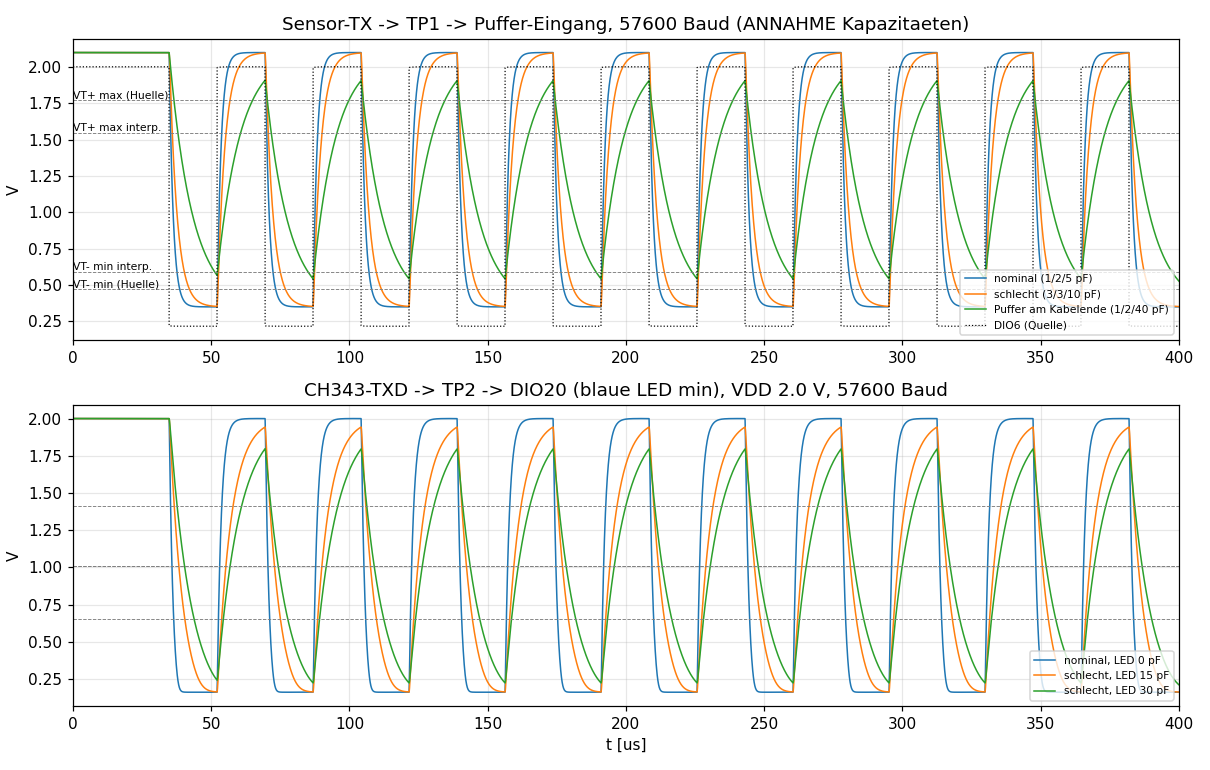
simulation/spice/programmer/prog_uart_waveforms.png
