sgeisser1/Tr-pfli/simulation/spice/supply/supply_drop.png

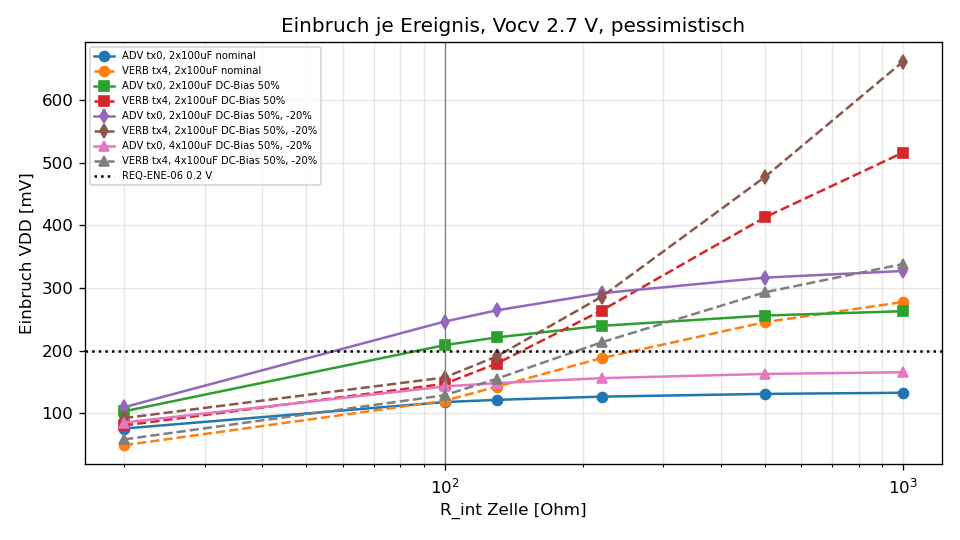
simulation/spice/supply/supply_drop.png
