sgeisser1/Tr-pfli/simulation/spice/supply/supply_waveforms.png

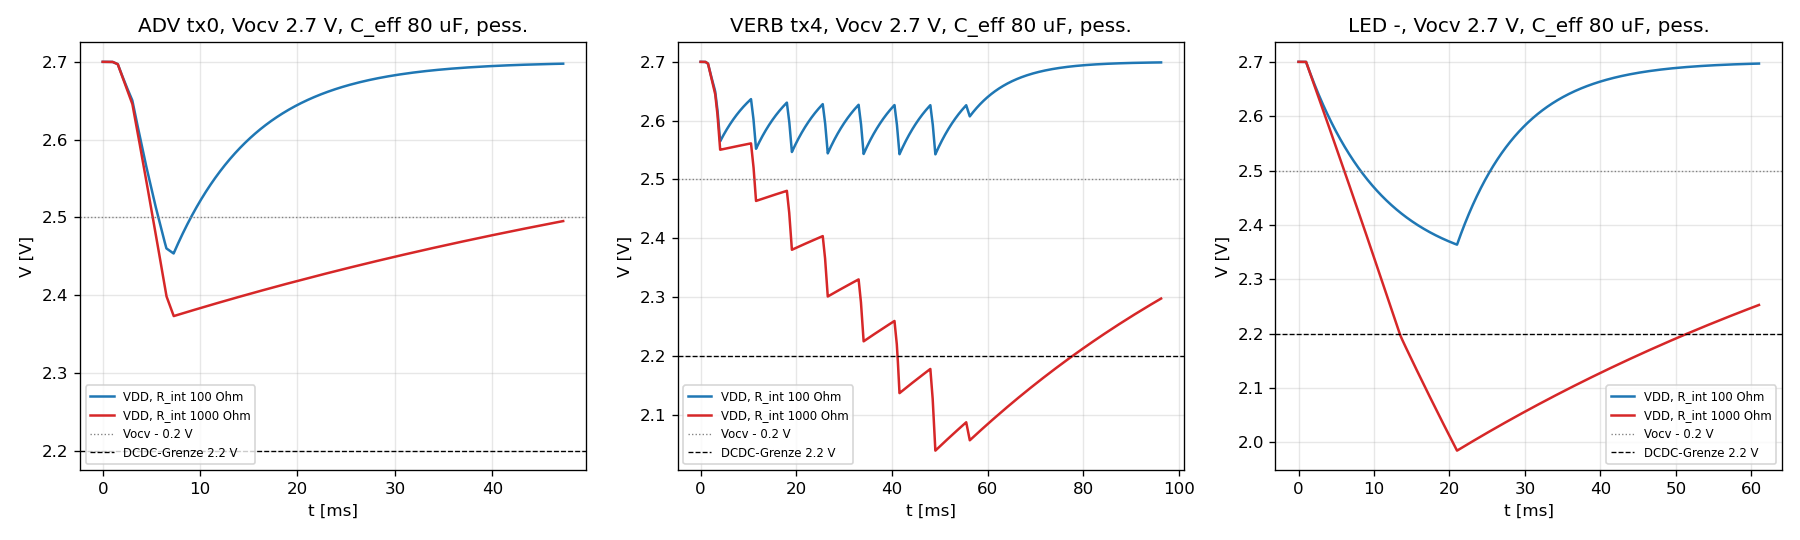
simulation/spice/supply/supply_waveforms.png
