sgeisser1/Tr-pfli/simulation/spice/uart_backfeed/uart_backfeed.png

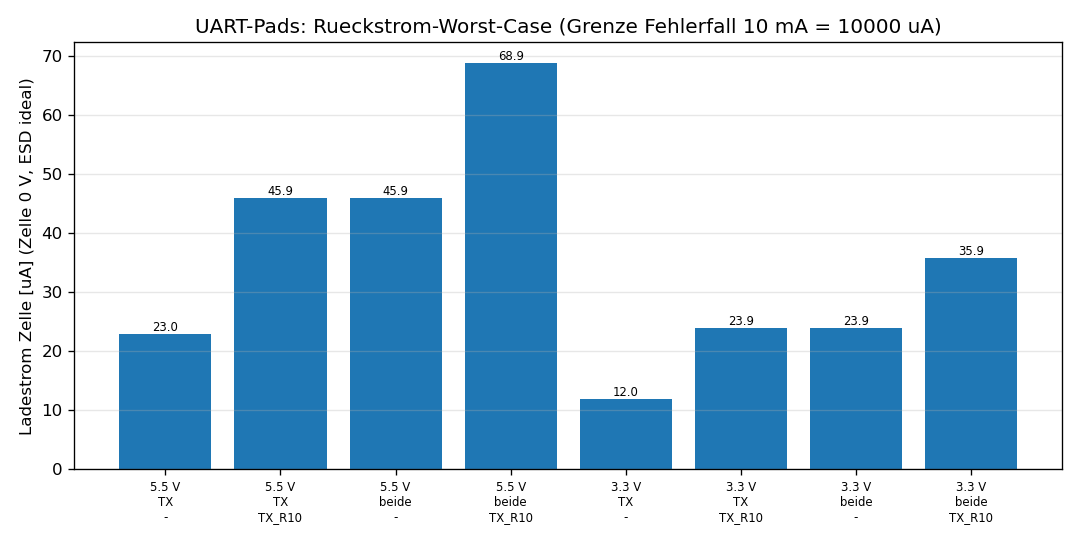
simulation/spice/uart_backfeed/uart_backfeed.png
