sgeisser1/Tr-pfli/docs/references/JLCPCB_PartsPreorder_Auszug_2026-11-09.txt

Quelle: JLCPCB Help Center (HTML), Parts Pre-order / private Teilebibliothek
Abgerufen: 2026-11-09 01:28 mit curl (Browser-User-Agent), HTTP 200; Textauszug (Tags entfernt), nur relevante Zeilen
Verwendung: hardware/sensor/out/ORDER_JLC_REV_C.md Kap. 4/7, docs/manuals/BESTELLEN_JLC.md (Red Team Phase 6 W-4: BT1-Vorrat)
======================================================================

### URL: https://jlcpcb.com/help/article/what-is-jlcpcb-parts-pre-order-service
sha256 Roh-HTML: 3ad3ecb5203fb58fa43836b085f06057ccd1baed9f5be11bd82a5a74c5fb2922
What is JLCPCB Parts Pre-order Service?
say, "parts Pre-order  Service provides customers order components and saves them for their JLCPCB SMT service." Consumers prepay for the parts and buy the required components in advance to ensure sufficient components are ready anytime. Meanwhile, they can immediately arrange the supply of parts through the advance sale for their electronic products. The parts save in their own library, safe and easy. Pre-order service accumulates different demands from people all around the world, is making parts need more clear and easier, therefore JLCPCB cooperates with customers to help complete orders, the order in large quantities, help win more discounts, and create maximum value and benefits for customers.
JLCPCB Parts Pre-order build up supply amid the global shortage
Therefore from this point of view, the production capacity of components is insufficient, and the demand for terminal electronic products has increased day by day, which has increased component consumption. Due to insufficient production capacity but increasing consumer demand is continuing, leading many technology companies or the consumer electronics industry to start a global search for components to ensure stable production and operation. Coupled with the rise of the online education industry in 2020, many schools arrange students to study at home, and the demand for educational electronic products has also grown sharply. Components are downstream products. The insufficient supply of terminal products has caused many consumer electronics companies to directly join the ranks of competing for components. The lack of supply has caused global electronic businesses to panic, and components have also risen due to the situation, and prices have continued to rise. Many merchants are facing the same difficulties that they are pouring more money, but cannot buy it, so the emergence of component pre-order services can reduce the insecurity, help to solve the global shortage.
A good PCB Supplier is expected to have a stable supply foundation: replenishing goods in time when demand increases; inventory prepared even demand decreases. We are facing a global component supply shortage, although every PCB manufacturer makes every effort to ensure that its SMT service is not affected in any way, things are always out of control. Global production capacity cannot keep up when the world is unstable, the reasons many from the global economy, the global political situation, the epidemic, etc. The shortage of components will continue. What should we do?
Therefore, pre-determining components and ensuring a stable supply is one of the ways to solve the problem. As a PCB manufacturer, it is impossible to estimate or correctly understand the component needs of each customer. It is difficult to guarantee that there will be no shortage of materials. When there are many parts in stock, and a customer may order a lot at a time. It seems parts pre-order service make everything go easily. Customers request parts in their account, it is a private library. requesting and saving parts in the personal account, just take them out when you have SMT order needs.
Price discount is one of the advantages of component pre-order service. Since it is purchased online, all prices are open and fair. Customers have a choice for whether to buy after confirming the price of the components. JLCPCB also implements a policy of more refunds and less replenishment for the pre-ordered components, so it's worry less about payment is gone because pre-order service failed cause. As we know, the global PCB company has good service for both price and quality. They are able to gain more low-cost but high-quality parts from global components suppliers. And also we know the components from component agents or original manufacturers, there will be a corresponding purchase price. In order to protect their own interests, MOQ is a common method to components suppliers. Generally speaking, different purchase quantities have a corresponding purchase price. Only when the purchased quantity reaches the corresponding standard line will the price change. Component vendors will naturally give larger customers more favorable prices, while SMEs or individual customers bear greater cost prices. Therefore, JLCPCB is equivalent to providing a platform for the collection of component requirements. When it reaches the larger MOQ of component vendors, the preferential strength will be even greater. Therefore, it is not difficult for us to see that the pre-order service prices of JLCPCB components are more favorable.
How to use  JLCPCB parts pre-order service
Step 1: Log into JLCPCB
My Parts Lib
Order Parts
Step 2: Check the guidelines to determine if there is a need to use the pre-order service
*My Parts Lib Instruction
1. Customer can build their own parts lib for JLCPCB assembly service via pre-ordering parts, there is no inventory cost when using for assembly orders
2. Inventory loss equals 0.03% of minimum package each year
3. Please consider the minimum required quantity and attraction quantity during the assembly process
Step 3: confirm whether the component can be pre-ordered before placing an order
*Basic parts can be pre-ordered, minimum quantity required.
*In-stock extended parts can be pre-ordered, no minimum quantity required.
*Non-stock extended parts recommended to the pre-order, minimum quantity required.
Step 4： Order Parts
*Instruction for the minimum and maximum quantity
*Pre-order parts at LCSC
There is a minimum order quantity requirement
Step 5: Payment
* JLCPCB will email the pre-order customers when the quote is ready to check the price, leading time, etc.
*The order is kept in the shopping cart for 1 hour, and the payment will be automatically canceled if the payment is overdue; when the customer is added to the shopping cart and has not paid, the system will have an email reminder (the link in the email will go to the private library page)
*Please note that those parts are only used for your SMT orders, so they won't be shipped separately.
*Please complete the payment within one hour, or the order will be canceled automatically because the parts' inventory may change each second.
Step 6: Confirmation
check the status of the ordered parts on the " Parts Order History " page.For in-stock items, the parts will usually be shown in your own library immediately after you make the payment.For the pre-order items, the exact price will be confirmed within 48 hours after the initial payment is done. Money will be refunded or will need to be refilled, depending on the final quotation.
Step 7: Cancellation
Step 8: Making new parts request
Making a new part request is a little bit different from the pre-order service, which needs to submit a request, once the “new parts request” is approved, then you can pre-order them.
You can apply for the new parts request, when the new parts request is approved, you can pre-order the parts you requested.

### URL: https://jlcpcb.com/help/article/how-to-build-your-own-parts-library-in-jlcpcb
sha256 Roh-HTML: 8f0fe6c8be98c3f8433d5bbda86f39472ffed2a72c2ab68324b039016f844e31
To solve this issue, JLCPCB provides a pre-order parts service. It allows you to order parts before you place a PCB-assembly order, and hold the inventory at JLCPCB until you need the PCBA service. Therefore you can get enough parts to be assembled on your boards all the time.
Please note that the parts pre-ordering service is for your PCB assembly orders, so the parts won't be shipped separately to you.
Parts pre-ordered from Global Sourcing can only be chosen together with the parts consigned by the customer when making a PCBA order.
For the same part, Global Sourcing&Consigned parts inventory cannot be used together with Pre-order parts&JLCPCB Parts stock. While, Global Sourcing and Consigned part inventory can be used together, the same to Pre-order parts and JLCPCB Parts stock.  For different types of parts, there's no such restriction.
How to pre-order your parts?
My Parts Lib
Order Parts
As JLCPCB needs to keep enough basic parts on the feeder, so the Basic Parts only can be pre-ordered, and there has a minimum order quantity. But normally the basic parts have enough stock, you don't need to pre-order them.
in-stock extended parts
in JLCPCB warehouse, no minimum order quantity is required. You can directly buy those in-stock parts.
non-stock extended parts
in JLCPCB warehouse, you need to pre-order them, and there has a minimum order quantity.
The minimum order quantity (MOQ) for components can vary due to factors such as manufacturing processes, economies of scale, customization, specialization, and supply chain considerations.
Please note that those parts are only used for your PCBA orders, so they won't be shipped separately.
168 hours
, or the order will be cancelled automatically because the parts' inventory may change each second.
For the pre-order items, the exact price will be confirmed within 48 hours after the initial payment is done. Money will be refunded or will need to be refilled, depending on the final quotation.
If you don't want to place a PCB-assembly order at JLCPCB, we recommend that you don't order any parts separately, because inventory cost and pickup service fee are charged when you need to pick up the components.
