sgeisser1/Tr-pfli/hardware/gateway/BOM_GATEWAY.csv

Pos | Teil | Hersteller_Typ | Menge | Preis_CHF_Stk | Status | Preisquelle | Abruf | Lager_Abruf | Beleg_lokal | Bemerkung
G1 | Einplatinenrechner Gateway (D-014) | Raspberry Pi Zero 2 W | 1 | 17.15 | vorhanden | pi-shop.ch https://www.pi-shop.ch/raspberry-pi-zero-2-w | 2026-11-08 | nicht an Lager | docs/references/pi-shop_Gateway-Teile_Auszug_2026-11-08.txt | Beim Auftraggeber vorhanden (D-014) -> nicht im Kaufbetrag, nur im Neuwert. Product Brief docs/datasheets/RaspberryPi_Zero2W_ProductBrief_2024-04.pdf: 5 V 2.5 A Eingang, keine RTC
G2 | Netzteil 5 V 2.5 A Micro-USB (REQ-SAF-DOC-02 gepruefte Speisung) | Raspberry Pi Ltd, Original 12.5 W Micro-USB Steckernetzteil | 1 | 11.90 | kauffertig | pi-shop.ch https://www.pi-shop.ch/raspberry-pi-12-5w-micro-usb-power-supply-2254 | 2026-11-09 | Sofort-Versand ab Lager | docs/datasheets/RaspberryPi_12W5-MicroUSB-PSU_EU-DoC_RP-001257-CF-3.pdf + docs/references/Haendler_Einkauf_Auszug_2026-11-09.txt | EU-Konformitaetserklaerung RP-001257-CF-3 (11.08.2026, LVD EN 62368-1, EMV, RoHS, ErP) lokal, Register GW-PSU (Sicherheit Schluss K-1, F-8 geschlossen). Wareneingang: Typ/CE/Herstellername, Gehaeuse und Kabel unbeschaedigt, Stecker 2-polig, kein Fremdnetzteil. Entfaellt, falls ein Original-Netzteil vorhanden ist
G3 | microSD Industrial 16 GB (Stromausfall/Schreibzyklen, ARCHITECTURE Kap. 14.4) | Kingston SDCIT2/16GB (microSDHC Industrial UHS-I 16 GB, pSLC) | 1 | 27.90 | nicht an Lager | pi-shop.ch https://www.pi-shop.ch/kingston-microsdhc-karte-industrial-uhs-i-16-gb | 2026-11-09 | nicht an Lager | docs/references/Haendler_Einkauf_Auszug_2026-11-09.txt | Datenblatt docs/datasheets/Kingston_SDCIT2_Datasheet_MKD-02122026.pdf S. 1: TLC im pSLC-Modus, bis 3840 TBW/30K P/E, -40...85 C, GATEWAY_SETUP Kap. 1: Industrial/pSLC >= 8 GB. Bezug: pi-shop.ch Art. 10951 (Benachrichtigung bei Lagereingang), Grosshandel alltron.ch meldet 100 Stk auf 23.11.2026 (ANNAHME: pi-shop wird danach beliefert). Sofort lieferbare Alternative gleicher Klasse (gleiche Serie): mediamarkt.ch Marktplatz Ultimus.ch SDCIT2/8GB CHF 56.95 bzw. 16 GB CHF 63.95, versandkostenfrei, Lieferung 19.-23.11. bzw. 27.11.-01.12.2026 -> teuer, nur falls Termin drueckt
G6 | Raumklima-Sensor-Breakout (D-017/D-029, SHT40 an I2C 0x44) | DFRobot Fermion SHT40 Breakout (SEN0428) | 1 | 11.90 | kauffertig | bastelgarage.ch Art. 421989 https://www.bastelgarage.ch/fermion-temperatur-und-feuchtigkeitssensor-sht40 | 2026-11-09 | Lagernd | docs/references/Haendler_Einkauf_Auszug_2026-11-09.txt | D-029 (Teilewahl), D-032 (Halter). 14.0 x 17.0 mm, Bohrungen 2 x Ø2.0 Raster 10.0 (docs/datasheets/DFRobot_SEN0428_Dimensions_V0.1.png), VCC 3.3-5 V, Pinout VCC/GND/SCL/SDA (wiki.dfrobot.com/sen0428). Schaltplan docs/datasheets/DFRobot_SEN0428_Schematic_V0.1.pdf: LDO + 2N7002-Pegelwandler + 10 kOhm Pull-ups (Plan traegt Titel SHTC3 -> PROTOTYP-PRUEFUNG 3V-Schiene/Pull-ups/i2cdetect 0x44). Einbau hochkant 17 (y) x 14 (z) in Bodenschiene (Nut 1.90, Eingriff 1.00) + Deckelrippe (Eingriff 0.80), mechanical/gateway_pi/check_gateway_pi.txt Pkt. 14, Platinendicke 1.6 ANNAHME -> am Muster messen. Ersetzt Grove SHT41 (20 x 40 mm)
G7 | Gehaeuse G1 v4 ASA (Wanne grau + Deckel blau + Fenster) | Eigendruck Bambu (mechanical/gateway_pi/print) | 1 | 0.97 | Eigenfertigung | ANNAHME ASA 0.035 CHF/g (scripts/concept_costs.py ASA_CHF_PER_G) | 2026-11-08 | - | mechanical/gateway_pi/check_gateway_pi.txt Nr. 7 | Wanne 14.0 g + Deckel 9.7 g + Fenster 0.1 g + 4 g AMS-Spuelung (ANNAHME) = 27.8 g
G8a | Gewindeeinsaetze M2.5 Deckel-Niederhalterrohre (4 je Gateway, Packung 100) | Messing M2.5 x 4 x Ø4.6 (bastelgarage.ch Art. 425681) | 1 | 15.90 | kauffertig | bastelgarage.ch Art. 425681 https://www.bastelgarage.ch/m2-5-4mm-gewindeeinsatze-messing-heat-insert-100stk | 2026-11-09 | Lagernd | docs/references/Haendler_Einkauf_Auszug_2026-11-09.txt | D-032: Bohrung 3.9, Rohr Ø7.0 mit Fuss Ø5.6, Bohrtiefe 5.2 (mechanical/gateway_pi/check_gateway_pi.txt Pkt. 33). Ganze Packung gerechnet (kleinere nicht gefunden), Register GW-MECH-INS1
G8b | Schrauben M2.5 x 8 ISO 7380 (4 je Gateway) | Handelsware (Quelle offen) | 4 | 0.25 | kauffertig | ANNAHME (kein Angebot, docs/manuals/EINKAUFSLISTE.csv G8b) | 2026-11-09 | - | - | Einschraubtiefe 3.1 mm (check_gateway_pi.txt Pkt. 46). bastelgarage M2.5-Sortiment DIN 912 ausverkauft und Zylinderkopf. Nylon als Option (PRINT_SETTINGS)
G9 | Status-LED Gateway (D-027 vorlaeufig): 3-mm-LED gruen + Vorwiderstand 470 Ohm an GPIO17, ohne Platine | Kingbright WP710A10GD (LCSC C6001420) + CCO MF1/4W-470R 1 % (LCSC C119317) | 1 | 0.08 | kauffertig | JLC/LCSC-Teilesuche 2026-11-09 01:20 (0.0813 + 0.0112 USD, Kurs 0.8189 + 1.5 %) | 2026-11-09 | 71 / 16455 | docs/manuals/EINKAUFSLISTE.csv G9 | D-027. Red Team W-3c: ueber LCSC mit den Programmieradapter-Teilen bestellen (kein Digi-Key-Versand). LED Datenblatt GW-LED1 lokal; YAGEO MFR-25 bei LCSC nicht an Lager -> Widerstand CCO (Register GW-R2, Datenblatt nicht herunterladbar)
G10 | Litze AWG 28, Schrumpfschlauch | Werkstattbestand | 1 | 0.00 | vorhanden | ANNAHME | 2026-11-08 | - | - | Pi ohne Stiftleiste, Leitungen direkt an die Loetaugen (check_gateway_pi.txt Nr. 5)
G11 | Zusatz-BLE-Empfaenger (nur falls Koexistenz W-7 nicht genuegt) | Seeed XIAO nRF52840 Sense | 1 | 0.00 | vorhanden (optional) | - | 2026-11-08 | - | - | Beim Auftraggeber vorhanden (D-014)
V1 | Versand pi-shop.ch (B-Post Economy, Sammelbestellung G2, G3, Werkstatt) | Schweizer Post | 1 | 7.90 | kauffertig | pi-shop.ch https://www.pi-shop.ch/versandkosten/ | 2026-11-08 | - | docs/references/pi-shop_Gateway-Teile_Auszug_2026-11-08.txt | A-Post 9.90 CHF
V2 | Versand bastelgarage.ch (PostPac Economy, entfaellt ab CHF 80 Warenwert der Sammelbestellung, docs/manuals/EINKAUFSLISTE.md) | Schweizer Post | 1 | 0.00 | kauffertig | bastelgarage.ch https://www.bastelgarage.ch/lieferung-versandkosten | 2026-11-09 | - | docs/references/Haendler_Einkauf_Auszug_2026-11-09.txt | Sammelbestellung bastelgarage.ch laut docs/manuals/EINKAUFSLISTE.md Kap. 7 >= CHF 80 -> versandkostenfrei (sonst PostPac Economy 6.90)
