sgeisser1/Tr-pfli/hardware/sensor/out/fluidi_sensor_bom_raw.csv

Ref | Value | Footprint | LCSC | MPN | Hersteller | JLC | DNP | ExclBOM
BT1 | CR2032 / Keystone 3034TR | fluidi:BatteryHolder_Keystone_3034_1x20mm_NegPad4mm_W23p1 | C5213768 | 3034TR | Keystone | Extended
C1 | 100uF | Capacitor_SMD:C_1206_3216Metric | C15008 | CL31A107MQHNNNE | Samsung Electro-Mechanics | Basic
C2 | 100uF | Capacitor_SMD:C_1206_3216Metric | C15008 | CL31A107MQHNNNE | Samsung Electro-Mechanics | Basic
C3 | 100uF | Capacitor_SMD:C_1206_3216Metric | C15008 | CL31A107MQHNNNE | Samsung Electro-Mechanics | Basic
C4 | 100uF | Capacitor_SMD:C_1206_3216Metric | C15008 | CL31A107MQHNNNE | Samsung Electro-Mechanics | Basic
C5 | 10uF | Capacitor_SMD:C_0402_1005Metric | C15525 | CL05A106MQ5NUNC | Samsung Electro-Mechanics | Basic
C6 | 100nF | Capacitor_SMD:C_0402_1005Metric | C1525 | CL05B104KO5NNNC | Samsung Electro-Mechanics | Basic
C7 | 100nF | Capacitor_SMD:C_0402_1005Metric | C1525 | CL05B104KO5NNNC | Samsung Electro-Mechanics | Basic
C8 | 100nF | Capacitor_SMD:C_0402_1005Metric | C1525 | CL05B104KO5NNNC | Samsung Electro-Mechanics | Basic
C9 | 10uF | Capacitor_SMD:C_0402_1005Metric | C15525 | CL05A106MQ5NUNC | Samsung Electro-Mechanics | Basic
C10 | 100nF | Capacitor_SMD:C_0402_1005Metric | C1525 | CL05B104KO5NNNC | Samsung Electro-Mechanics | Basic
C11 | 100nF | Capacitor_SMD:C_0402_1005Metric | C1525 | CL05B104KO5NNNC | Samsung Electro-Mechanics | Basic
C12 | 1uF | Capacitor_SMD:C_0402_1005Metric | C52923 | CL05A105KA5NQNC | Samsung Electro-Mechanics | Basic
C13 | 100nF | Capacitor_SMD:C_0402_1005Metric | C1525 | CL05B104KO5NNNC | Samsung Electro-Mechanics | Basic
C14 | 15pF | Capacitor_SMD:C_0402_1005Metric | C1548 | 0402CG150J500NT | FH (Fenghua) | Basic
C15 | 15pF | Capacitor_SMD:C_0402_1005Metric | C1548 | 0402CG150J500NT | FH (Fenghua) | Basic
C16 | 1.5pF | Capacitor_SMD:C_0402_1005Metric | C1552 | 0402CG1R5C500NT | FH (Fenghua) | Preferred
C17 | 1.5pF | Capacitor_SMD:C_0402_1005Metric | C1552 | 0402CG1R5C500NT | FH (Fenghua) | Preferred
C18 | 15pF | Capacitor_SMD:C_0402_1005Metric | C1548 | 0402CG150J500NT | FH (Fenghua) | Basic
C19 | DNM | Capacitor_SMD:C_0402_1005Metric |  | nicht bestueckt (Wert nach Abstimmung) | - | - | DNP
C20 | DNM | Capacitor_SMD:C_0402_1005Metric |  | nicht bestueckt (Wert nach Abstimmung) | - | - | DNP
C21 | 100nF | Capacitor_SMD:C_0402_1005Metric | C1525 | CL05B104KO5NNNC | Samsung Electro-Mechanics | Basic
C22 | 22pF | Capacitor_SMD:C_0402_1005Metric | C1555 | 0402CG220J500NT | FH (Fenghua) | Basic
C24 | 100nF | Capacitor_SMD:C_0402_1005Metric | C1525 | CL05B104KO5NNNC | Samsung Electro-Mechanics | Basic
C25 | 100nF | Capacitor_SMD:C_0402_1005Metric | C1525 | CL05B104KO5NNNC | Samsung Electro-Mechanics | Basic
D1 | RGB 1615 | fluidi:LED_RGB_TUOZHAN_1615 | C7496855 | P4-1615G2B2R4TS2-06T-001-24 | TUOZHAN | Extended
L1 | 10uH | fluidi:L_Sunlord_WPN201610H | C89132 | WPN201610H100MT | Sunlord | Extended
L2 | 2.7nH | Inductor_SMD:L_0402_1005Metric | C27123 | SDCL1005C2N7STDF | Sunlord | Extended
Q1 | AO3401A | Package_TO_SOT_SMD:SOT-23 | C15127 | AO3401A | Alpha & Omega | Basic
Q2 | AO3401A | Package_TO_SOT_SMD:SOT-23 | C15127 | AO3401A | Alpha & Omega | Basic
R1 | 100k | Resistor_SMD:R_0402_1005Metric | C25741 | 0402WGF1003TCE | UNI-ROYAL | Basic
R2 | 0R | Resistor_SMD:R_0402_1005Metric | C17168 | 0402WGF0000TCE | UNI-ROYAL | Basic
R3 | 1k | Resistor_SMD:R_0402_1005Metric | C11702 | 0402WGF1001TCE | UNI-ROYAL | Basic
R4 | 4.7k | Resistor_SMD:R_0402_1005Metric | C25900 | 0402WGF4701TCE | UNI-ROYAL | Basic
R5 | 4.7k | Resistor_SMD:R_0402_1005Metric | C25900 | 0402WGF4701TCE | UNI-ROYAL | Basic
R6 | 470 | Resistor_SMD:R_0402_1005Metric | C25117 | 0402WGF4700TCE | UNI-ROYAL | Basic
R7 | 200 | Resistor_SMD:R_0402_1005Metric | C25087 | 0402WGF2000TCE | UNI-ROYAL | Basic
R8 | 100 | Resistor_SMD:R_0402_1005Metric | C25076 | 0402WGF1000TCE | UNI-ROYAL | Basic
R9 | 100k | Resistor_SMD:R_0402_1005Metric | C25741 | 0402WGF1003TCE | UNI-ROYAL | Basic
R10 | 100k | Resistor_SMD:R_0402_1005Metric | C25741 | 0402WGF1003TCE | UNI-ROYAL | Basic
R11 | 100k | Resistor_SMD:R_0402_1005Metric | C25741 | 0402WGF1003TCE | UNI-ROYAL | Basic
R12 | 100k | Resistor_SMD:R_0402_1005Metric | C25741 | 0402WGF1003TCE | UNI-ROYAL | Basic
R13 | 100k | Resistor_SMD:R_0402_1005Metric | C25741 | 0402WGF1003TCE | UNI-ROYAL | Basic
SW1 | TS-1088 | Button_Switch_SMD:SW_SPST_TS-1088-xR020 | C720477 | TS-1088-AR02016 | XUNPU | Basic
U1 | CC2340R52E0RGER | Package_DFN_QFN:VQFN-24-1EP_4x4mm_P0.5mm_EP2.45x2.45mm | C20416850 | CC2340R52E0RGER | Texas Instruments | Extended
U2 | SN74LVC1G14DCKR | Package_TO_SOT_SMD:SOT-353_SC-70-5 | C35740 | SN74LVC1G14DCKR | Texas Instruments | Extended
U3 | TMP1075NDRLR | fluidi:SOT-563_TI_DRL0006A | C3663690 | TMP1075NDRLR | Texas Instruments | Extended
U4 | SN74LVC1G80DCKR | Package_TO_SOT_SMD:SOT-353_SC-70-5 | C473331 | SN74LVC1G80DCKR | Texas Instruments | Extended
U5 | SN74LVC1G80DCKR | Package_TO_SOT_SMD:SOT-353_SC-70-5 | C473331 | SN74LVC1G80DCKR | Texas Instruments | Extended
U6 | SN74LVC1G80DCKR | Package_TO_SOT_SMD:SOT-353_SC-70-5 | C473331 | SN74LVC1G80DCKR | Texas Instruments | Extended
Y1 | 48MHz 8pF | Crystal:Crystal_SMD_3225-4Pin_3.2x2.5mm | C2925606 | XC32M4-48.000-F08NLDT | HCI (Suzhou HangJing) | Extended
Y2 | 32.768kHz 9pF | Crystal:Crystal_SMD_3215-2Pin_3.2x1.5mm | C99010 | Q13FC13500003 | Seiko Epson | Extended
