sgeisser1/Tr-pfli/docs/datasheets/INDEX.csv

Ref | Funktion | Hersteller | Teilenummer | LCSC | Basic/Extended | Gehaeuse/Footprint | Dok-Revision | Quelle-URL | Abrufdatum | Lokaler Pfad | Bemerkung
U-SOC1 | BLE-SoC Kandidat | Texas Instruments | CC2340R52E0RGER | C20416850 | Extended | VQFN-24 4x4 | SWRS272F (2026-05) | https://www.ti.com/lit/ds/symlink/cc2340r5.pdf | 2026-11-06 | docs/datasheets/TI_CC2340R5_Datasheet_SWRS272F.pdf | Datenblatt gilt fuer CC2340R2 und CC2340R5 / JLC Lager 9278, 1.34 USD @10+ (2026-11-06)
U-SOC1-TRM | BLE-SoC Referenzhandbuch | Texas Instruments | CC23xx | - | - | - | SWCU193A (2024-08) | https://www.ti.com/lit/ug/swcu193/swcu193.pdf | 2026-11-06 | docs/datasheets/TI_CC23xx_TechnicalReferenceManual_SWCU193A.pdf | Technical Reference Manual (Timer, Bootloader, LPCOMP)
U-SOC1-AN1 | HW-Design-Guide BLE-SoC | Texas Instruments | CC23xx/CC27xx | - | - | - | SWRA834A (2026-02) | https://www.ti.com/lit/pdf/swra834 | 2026-11-06 | docs/appnotes/TI_CC23xx_HWDesignGuide_SWRA834A.pdf | Referenzdesigns, RF-Filter, Bootloader-Pins, Layout
ANT-AN043 | PCB-Antenne 2.4 GHz klein | Texas Instruments | AN043 | - | - | 15.2 x 5.7 mm | SWRA117D | https://www.ti.com/lit/an/swra117d/swra117d.pdf | 2026-11-06 | docs/appnotes/TI_AN043_SmallPCBAntenna_SWRA117D.pdf | Meander-IFA, Referenz fuer schmale PCB
U-SOC2 | BLE-SoC Kandidat | WCH (Nanjing Qinheng) | CH592F | C39831287 | Extended | QFN-28 4x4 | V1.9 | https://raw.githubusercontent.com/openwch/ch592/main/Datasheet/CH592DS1_EN.PDF | 2026-11-06 | docs/datasheets/WCH_CH592_Datasheet_V1.9.pdf | Quelle: offizielles WCH-GitHub openwch/ch592 (wch-ic.com ist JS-Seite ohne Direktlink) / JLC Lager 27866, 0.67 USD @10+
U-SOC3 | BLE-SoC Kandidat (verworfen) | WCH (Nanjing Qinheng) | CH582F | C3001175 | Extended | QFN-28 4x4 | V1.9 | https://raw.githubusercontent.com/openwch/ch583/main/Datasheet/CH583DS1_en.PDF | 2026-11-06 | docs/datasheets/WCH_CH583_Datasheet_V1.9.pdf | Datenblatt CH583/CH582 / CH582 VDD min 2.3 V (S.138 Tab. 20-2) -> verworfen
U-SOC4 | BLE-SoC Kandidat | Nordic Semiconductor | nRF52832-QFAA-R | C77540 | Extended | QFN-48 6x6 | - | https://docs.nordicsemi.com/bundle/ps_nrf52832 | 2026-11-06 | - | NICHT HERUNTERLADBAR: Cloudflare-Bot-Schutz (docs-be.nordicsemi.com, infocenter.nordicsemi.com) / manuell laden
U-SOC5 | BLE-SoC Kandidat | Nordic Semiconductor | nRF52805-CAAA-R | C1512175 | Extended | WLCSP-28 2.5x2.5 | - | https://docs.nordicsemi.com/bundle/ps_nrf52805 | 2026-11-06 | - | NICHT HERUNTERLADBAR (Cloudflare) / WLCSP fuer JLC/Handloeten ungeeignet
U-SOC6 | BLE-SoC Kandidat | Nordic Semiconductor | nRF52810-QCAA-R | C519278 | Extended | QFN-32 5x5 | - | https://docs.nordicsemi.com/bundle/ps_nrf52810 | 2026-11-06 | - | NICHT HERUNTERLADBAR (Cloudflare)
U-SOC7 | BLE-SoC Kandidat | Nordic Semiconductor | nRF52833-QDAA-R | C2895249 | Extended | QFN-40 5x5 | - | https://docs.nordicsemi.com/bundle/ps_nrf52833 | 2026-11-06 | - | NICHT HERUNTERLADBAR (Cloudflare)
U-SOC8 | BLE-SoC Kandidat | Silicon Labs | EFR32BG22C224F512GM32-C | C1015253 | Extended | QFN-32 4x4 | - | https://www.silabs.com/documents/public/data-sheets/efr32bg22-datasheet.pdf | 2026-11-06 | - | NICHT HERUNTERLADBAR: HTTP 403 (Akamai) / manuell laden
U-CDC1 | Kapazitaets-Digital-Wandler | Texas Instruments | FDC1004DGSR | C2865994 | Extended | VSSOP-10 | SNOSCY5C (2024-10) | https://www.ti.com/lit/ds/symlink/fdc1004.pdf | 2026-11-06 | docs/datasheets/TI_FDC1004_Datasheet_SNOSCY5C.pdf | VDD 3.0-3.6 V, Anregung 25 kHz
U-CDC1-AN | App Note kapazitive Messung | Texas Instruments | FDC1004 | - | - | - | SNOA927A (2021-06) | https://www.ti.com/lit/an/snoa927a/snoa927a.pdf | 2026-11-06 | docs/appnotes/TI_FDC1004_CapSensingBasics_SNOA927A.pdf | Grundlagen, Shield
U-CDC2 | Kapazitaets-Digital-Wandler (LC) | Texas Instruments | FDC2212DNTR | C968585 | Extended | WSON-12 4x4 | SNOSCZ5B (2024-10) | https://www.ti.com/lit/ds/symlink/fdc2212.pdf | 2026-11-06 | docs/datasheets/TI_FDC2212_Datasheet_SNOSCZ5B.pdf | VDD 2.7-3.6 V, 0.01-10 MHz / JLC Lager nur 310
U-OSC1 | Schmitt-Trigger RC-Oszillator | Texas Instruments | SN74LVC1G14DCKR | C35740 | Extended | SC-70-5 | SCES218AA (2025-10) | https://www.ti.com/lit/ds/symlink/sn74lvc1g14.pdf | 2026-11-06 | docs/datasheets/TI_SN74LVC1G14_Datasheet_SCES218AA.pdf | auch SOT-23-5 C7835 (Lager 227396)
U-T1 | Bodentemperatur digital | Texas Instruments | TMP1075DSGR | C2870250 | Extended | WSON-8 2x2 | SBOS854F (2024-06) | https://www.ti.com/lit/ds/symlink/tmp1075.pdf | 2026-11-06 | docs/datasheets/TI_TMP1075_Datasheet_SBOS854F.pdf | +-1 C max -40..75 C (DSG) / Alternative TMP1075NDRLR C3663690 SOT-563 +-1 C -10..60 C
U-T2 | Bodentemperatur digital (verworfen) | Texas Instruments | TMP102AIDRLR | C99269 | Extended | SOT-563 | SBOS397I (2024-06) | https://www.ti.com/lit/ds/symlink/tmp102.pdf | 2026-11-06 | docs/datasheets/TI_TMP102_Datasheet_SBOS397I.pdf | +-2 C max -25..85 C -> erfuellt REQ-TMP-01 nicht garantiert
U-T3 | Bodentemperatur digital praezise | Texas Instruments | TMP117AIDRVR | C699536 | Extended | WSON-6 2x2 | SNOSD82D (2022-09) | https://www.ti.com/lit/ds/symlink/tmp117.pdf | 2026-11-06 | docs/datasheets/TI_TMP117_Datasheet_SNOSD82D.pdf | +-0.3 C max / teurer
RT-NTC1 | Bodentemperatur NTC | Murata | NCP15XH103F03RC | C77131 | Extended | 0402 | - | https://www.murata.com/en-global/products/productdetail?partno=NCP15XH103F03RC | 2026-11-06 | - | NICHT HERUNTERLADBAR: Murata-PDF-API liefert HTML / manuell laden
RT-NTC2 | Bodentemperatur NTC | Murata | NCP18XH103F03RB | C13564 | Extended | 0603 | - | https://www.murata.com/en-us/products/productdetail?partno=NCP18XH103F03RB | 2026-11-06 | - | NICHT HERUNTERLADBAR / laut Octopart/RS NRND bzw. abgekuendigt (Sekundaerquelle) -> nicht verwenden
Y-LF1 | 32.768-kHz-Quarz | Seiko Epson | Q13FC13500004 | C32346 | Basic | SMD3215-2P | - | - | 2026-11-06 | - | Datenblatt noch nicht geladen / Lastkapazitaet gegen SoC-Bereich pruefen (CC2340: 6-12 pF, DS S.27)
BT1 (Kand. CC) | Knopfzelle Li/MnO2 225 mAh | Renata | CR2032 MFR | - | nicht bestueckt | Ø20 x 3.2 mm | Rev. CR2032MFR.07 / 06.2021 | https://www.renata.com/en/downloads/?product=cr2032-mfr&fileid=b6020c63213e306540522d7121 | 2026-11-06 | docs/datasheets/Renata_CR2032MFR_Datasheet_Rev07.pdf | Swiss Made, -30..+85 C, ab 60 C Renata konsultieren
BT1 (Kand. CC) | Knopfzelle Li/MnO2 540 mAh | Renata | CR2450N | - | nicht bestueckt | Ø24.5 x 5.0 mm | Rev. CR2450N.08 / 08.2019 | https://www.renata.com/en/downloads/?product=cr2450n&fileid=9f8cfd15a2edecb64af4a7a69d | 2026-11-06 | docs/datasheets/Renata_CR2450N_Datasheet_Rev08.pdf | -40..+85 C, ab 70 C Renata konsultieren
BT1 (Kand. CC) | Knopfzelle Li/MnO2 950 mAh | Renata | CR2477N | - | nicht bestueckt | Ø24.5 x 7.7 mm | Rev. CR2477N.08 / 08.2019 | https://www.renata.com/en/downloads/?product=cr2477n&fileid=ddf767e9b62d9de0e394ce33ed | 2026-11-06 | docs/datasheets/Renata_CR2477N_Datasheet_Rev08.pdf | -40..+85 C, ab 70 C Renata konsultieren
- | Sicherheitshinweise 3-V-Lithiumzellen | Renata | 3V Lithium Safety Guidelines | - | - | - | Rev. 10/02 | https://www.renata.com/en/downloads/?product=cr2032-mfr&fileid=68c9bfea3edf06129d29d1811a | 2026-11-06 | docs/appnotes/Renata_3VLithium_SafetyGuidelines.pdf | Ladeschutz (Dioden), kindersicheres Fach, keine direkte Sonne
BT1 (Vergleich) | Knopfzelle 225 mAh | Panasonic | CR2032 | - | nicht bestueckt | Ø20 x 3.2 mm | Stand Februar 2026 | https://energy.panasonic.com/dam/master/pdf/en/datasheet/lithium/CR2032_Datasheet_EN.pdf | 2026-11-06 | docs/datasheets/Panasonic_CR2032_Datasheet_2026-02.pdf | -30..+85 C, ab 70 C Panasonic konsultieren
BT1 (Vergleich) | Knopfzelle 620 mAh | Panasonic | CR2450 | - | nicht bestueckt | Ø24.5 x 5.0 mm | Stand Februar 2026 | https://energy.panasonic.com/dam/master/pdf/en/datasheet/lithium/CR2450_Datasheet_EN.pdf | 2026-11-06 | docs/datasheets/Panasonic_CR2450_Datasheet_2026-02.pdf | -30..+85 C
BT1 (Vergleich) | Knopfzelle 1000 mAh | Panasonic | CR2477 | - | nicht bestueckt | Ø24.5 x 7.7 mm | Stand Juli 2024 | https://energy.panasonic.com/dam/master/pdf/en/datasheet/lithium/CR2477_Datasheet_EN.pdf | 2026-11-06 | docs/datasheets/Panasonic_CR2477_Datasheet_2024-07.pdf | -30..+85 C, 10.5 g
BT1 (Vergleich) | Knopfzelle hitzebestaendig 550 mAh | Maxell | CR2450HR | C115412 | nicht bestueckt (LCSC Lager 0) | Ø24.5 x 5.0 mm | Data Sheet (ohne Rev.) | https://maxell.com.tw/assets/download/CR%20Heat%20Resistant%20Lithium%20Manganese%20Dioxide%20Battery/CR2450HR_table.pdf | 2026-11-06 | docs/datasheets/Maxell_CR2450HR_Datasheet_table.pdf | -40..+125 C, laut Maxell nur fuer Geraetehersteller
BT1 (Vergleich) | Knopfzelle 570 mAh | Varta | CR2450 (6450) | - | nicht bestueckt | Ø24.5 x 5.0 mm | Date of issue 2014-09-03 | Mirror (Hornbach), aus Phase-1-Pruefung | 2026-11-06 | docs/datasheets/Varta_CR2450-6450_Datasheet_2014-09.pdf | Entladung -20..65 C, kein Original-Download bei Varta gefunden
BT1 (Vergleich) | Knopfzelle 630/550 mAh | Ansmann | CR2450 | - | nicht bestueckt | Ø24.5 x 5.0 mm | Data sheet no. 5020112 (2010) | aus Phase-1-Pruefung (Ansmann) | 2026-11-06 | docs/datasheets/Ansmann_CR2450_Datasheet_5020112.pdf | Betrieb -20..60 C -> fuer RB-03 ungeeignet
BT1 (Vergleich) | Knopfzelle 254 mAh | Energizer | CR2032 | - | nicht bestueckt | Ø20 x 3.2 mm | Form UltimateCR2032EU0920 | aus Phase-1-Pruefung (Energizer) | 2026-11-06 | docs/datasheets/Energizer_CR2032_Datasheet_EU0920.pdf | Pulsdiagramm 6.8 mA, IR-Kurve
BT1 (Vergleich) | Knopfzelle CR2032 | Murata | CR2032 | - | - | - | - | https://www.murata.com/products/productdata/8808561147934/CR2032-DATASHEET.pdf | 2026-11-06 | NICHT HERUNTERLADBAR | murata.com liefert Fehlerseite (Bot-Sperre)
BT1 (Vergleich) | Knopfzelle CR2450 | Energizer | CR2450 | - | - | - | - | https://data.energizer.com/pdfs/cr2450.pdf | 2026-11-06 | NICHT HERUNTERLADBAR | liefert HTML statt PDF
BT1 (Kand. LI) | LiPo-Pack 130 mAh mit Schutzschaltung | Renata | ICP401230UPR | - | nicht bestueckt | 31 x 12.7 x 4.5 mm | Rev. ICP401230 V02 08/2019 | https://www.renata.com/en/downloads/?product=icp401230upr&fileid=c3ffa3e27d8b9b28a9de2a7c18 | 2026-11-06 | docs/datasheets/Renata_ICP401230UPR_Datasheet_V02.pdf | Laden 0..45 C, Entladen -20..60 C, Lagern -20..45 C, Schutzschaltungsdaten 'on request'
BT1 (Kand. LI) | LiPo-Pack 80 mAh mit Schutzschaltung | Renata | ICP501022UPM | - | nicht bestueckt | 24 x 10 x 5.5 mm | Rev. ICP501022 V02 08/2019 | https://www.renata.com/en/downloads/?product=icp501022upm&fileid=1ee829f0b5a731cd359417fdfe | 2026-11-06 | docs/datasheets/Renata_ICP501022UPM_Datasheet_V02.pdf | IEC62133, Temperaturgrenzen wie oben
BT1 (Kand. LI) | LiPo-Pack 155 mAh mit Schutzschaltung | Renata | ICP402025PC-01 | - | nicht bestueckt | 27.5 x 20.5 x 4.3 mm | Rev. ICP402025 V02 08/2019 | https://www.renata.com/en/downloads/?product=icp402025pc-01&fileid=7c3ca5178ae13a0827c8eaa4b0 | 2026-11-06 | docs/datasheets/Renata_ICP402025PC-01_Datasheet_V02.pdf | mit Stecker
BT1 (Kand. LI) | LiPo-Pack 135 mAh mit Schutzschaltung | Renata | ICP501230PS-03 | - | nicht bestueckt | 31.5 x 12 x 5.5 mm | Rev. ICP501230 V04 08/2019 | https://www.renata.com/en/downloads/?product=icp501230ps-03&fileid=c1e31d433098c6e9ba5da180bf | 2026-11-06 | docs/datasheets/Renata_ICP501230PS-03_Datasheet_V04.pdf | mit Litzen
BT1 (Kand. LI) | LiPo-Pack 85 mAh | Renata | ICP390831PR | - | nicht bestueckt | 33 x 8.7 x 4.3 mm | Rev. ICP390831PR V01 11/2022 | https://www.renata.com/en/downloads/?product=icp390831pr&fileid=b620afd221a9d466451d0bdeb9 | 2026-11-06 | docs/datasheets/Renata_ICP390831PR_Datasheet_V01.pdf | schmal
XBT1 (Kand.) | Halter CR2032 SMD, Clip | TE Connectivity (Linx) | BAT-HLD-001 | C7501066 | Extended | SMD 22.9 x 15.3 mm, Minuspol = PCB-Pad | Rev. E1 (11/15/23) | https://www.lcsc.com/datasheet/lcsc_datasheet_2411212321_TE-Connectivity-BAT-HLD-001_C7501066.pdf | 2026-11-06 | docs/datasheets/TE_BAT-HLD-001_Drawing_RevE1.pdf | Phosphorbronze vernickelt, Herstellerzeichnung via LCSC
XBT1 (Kand.) | Halter CR2032 SMD, Gehaeuse | Q&J | CR2032-BS-6-1 | C70377 | Extended | SMD | Zeichnung (chin.) | https://www.lcsc.com/datasheet/lcsc_datasheet_1811061923_Q-J-CR2032-BS-6-1_C70377.pdf | 2026-11-06 | docs/datasheets/QJ_CR2032-BS-6-1_Drawing.pdf | Phosphorbronze, guenstig, Lager 57793
XBT1 (Kand.) | Halter CR2032 SMD | Keystone | 3034TR | C5213768 | Extended | SMD 21.2 mm | Katalog M65 (2015) | https://wmsc.lcsc.com/wmsc/upload/file/pdf/v2/lcsc/2303201000_Keystone-3034TR_C5213768.pdf | 2026-11-06 | docs/datasheets/Keystone_3034_Catalog_M65.pdf | Phosphorbronze, Zinn-Nickel
XBT1 (Kand.) | Halter CR2450 SMD, Gehaeuse LCP | MYOUNG | BS-24-B4AA016 | C964809 | Extended | SMD 37 x 29.75 mm Pads, H 7.5 mm | A/0 (2018-05-30) | https://www.lcsc.com/datasheet/lcsc_datasheet_2012181809_MYOUNG-BS-24-B4AA016_C964809.pdf | 2026-11-06 | docs/datasheets/MYOUNG_BS-24-B4AA016_Drawing_A0.pdf | Kontakte Phosphorbronze vergoldet, -25..85 C
XBT1 (Kand.) | Halter CR2477 SMD, Clip | MYOUNG | MY-2477-02 | C2979175 | Extended | SMD 37 x 22.9 mm, H 8.3 mm, Minuspol = PCB-Pad | A/0 (2021-04-26) | https://wmsc.lcsc.com/wmsc/upload/file/pdf/v2/lcsc/2203021630_MYOUNG-MY-2477-02_C2979175.pdf | 2026-11-06 | docs/datasheets/MYOUNG_MY-2477-02_Drawing_A0.pdf | C5191 Phosphorbronze vernickelt, -25..85 C
Q1 (Kand. CC) | Verpolschutz P-MOSFET | Alpha & Omega | AO3401A | C15127 | Basic | SOT-23 | Rev 3.1 December 2023 | https://www.aosmd.com/res/datasheets/AO3401A.pdf | 2026-11-06 | docs/datasheets/AOS_AO3401A_Datasheet_Rev3.1.pdf | VGS(th) -0.5..-1.3 V, RDS(on) 85 mOhm @ -2.5 V, IGSS 100 nA
Q1 (Alt.) | Verpolschutz P-MOSFET | Diodes Inc. | DMG2305UX-7 | C150470 | Extended | SOT-23 | DS36196 Rev. 8-2 | https://www.diodes.com/assets/Datasheets/DMG2305UX.pdf | 2026-11-06 | docs/datasheets/Diodes_DMG2305UX_Datasheet_DS36196Rev8.pdf | VGS(th) max -0.9 V, RDS(on) 200 mOhm @ -1.8 V
D1 (Alt.) | Schottky (Rueckstromsperre/Verpol) | Jiangsu Changjing (CJ) | RB751S-40 | C8524 | Extended | SOD-523 | - | https://www.lcsc.com/datasheet/lcsc_datasheet_1809212211_Jiangsu-Changjing-Electronics-Technology-Co---Ltd--RB751S-40_C8524.pdf | 2026-11-06 | docs/datasheets/CJ_RB751S-40_Datasheet.pdf | VF 0.37 V @ 1 mA, IR 0.5 uA @ 30 V, als Verpolschutz zu viel Spannungsverlust
C1 (Kand.) | Pufferkondensator 100 uF 6.3 V X5R 1206 | Murata | GRM31CR60J107ME39L | C77085 | Extended | 1206 | Spezifikation (ohne Rev.) | https://www.lcsc.com/datasheet/lcsc_datasheet_1810201321_Murata-Electronics-GRM31CR60J107ME39L_C77085.pdf | 2026-11-06 | docs/datasheets/Murata_GRM31CR60J107ME39L_Datasheet.pdf | IR > 50 Ohm*F (S.2) -> max 6 uA bei 3 V, DC-Bias-Kurve nicht enthalten
C1 (Kand.) | Pufferkondensator 100 uF 6.3 V X5R 1206 | Samsung | CL31A107MQHNNNE | C15008 | Basic | 1206 | Katalog November 2015 | https://www.lcsc.com/datasheet/lcsc_datasheet_2304140030_Samsung-Electro-Mechanics-CL31A107MQHNNNE_C15008.pdf | 2026-11-06 | docs/datasheets/Samsung_CL31A107MQHNNNE_Catalog_2015-11.pdf | Allg. MLCC-Katalog, IR nach Dauertest 25 MOhm*uF (S.55), typenspezifisches Datenblatt nicht gefunden
U2 (Kand. LI) | Laderegler 1 Zelle, TS/NTC, OVP 6.65 V, 30 V abs. max | Texas Instruments | BQ21040DBVR | C202311 | Extended | SOT-23-6 | SLUSCE2D (Jan. 2019) | https://www.ti.com/lit/ds/symlink/bq21040.pdf | 2026-11-06 | docs/datasheets/TI_BQ21040_Datasheet_RevD.pdf | Ladestrom per ISET-Widerstand (Hardware), TS 0/45 C, offener NTC: 237 kOhm TS-GND noetig (S.3)
U2 (Alt.) | Laderegler, JEITA-TS, 30 V | Texas Instruments | BQ24040DSQR | C81080 | Extended | WSON-10 2x2 | SLUS941H (Feb. 2021) | https://www.ti.com/lit/ds/symlink/bq24040.pdf | 2026-11-06 | docs/datasheets/TI_BQ24040_Datasheet_RevH.pdf | laedt 45..60 C mit 4.1 V weiter -> Renata-Zelle nur 0..45 C
U2 (Alt.) | Laderegler 10..250 mA, 30 V | Texas Instruments | BQ25100YFPR | C527572 | Extended | DSBGA-6 | SLUSBV8C (Nov. 2014) | https://www.ti.com/lit/ds/symlink/bq25100.pdf | 2026-11-06 | docs/datasheets/TI_BQ25100_Datasheet_RevC.pdf | IOUT(PDWN) 75 nA, WLCSP, JLC-Lager 0 (BQ25100BYFPR C2871905: 6 Stk)
U2 (verworfen) | Laderegler | Microchip | MCP73831T-2ACI/OT | C424093 | Extended | SOT-23-5 | DS20001984H | https://ww1.microchip.com/downloads/aemDocuments/documents/APID/ProductDocuments/DataSheets/MCP73831-Family-Data-Sheet-DS20001984H.pdf | 2026-11-06 | docs/datasheets/Microchip_MCP73831_Datasheet_RevH.pdf | kein NTC-Eingang, VDD abs. max 7 V -> REQ-SAF-LI-02/-08 nicht erfuellt
U2 (verworfen) | Laderegler | TOPPOWER | TP4056-42-ESOP8 | C16581 | Extended (Preferred) | ESOP-8 | - | https://www.lcsc.com/datasheet/lcsc_datasheet_1809261820_TOPPOWER-Nanjing-Extension-Microelectronics-TP4056-42-ESOP8_C16581.pdf | 2026-11-06 | docs/datasheets/TOPPOWER_TP4056_Datasheet.pdf | VCC abs. max 8 V, kein OVP -> REQ-SAF-LI-08 nur mit externem OVP
U3 (Kand. LI) | Li-Ion-Schutz-IC 1 Zelle | Texas Instruments | BQ29700DSER | C183096 | Extended | WSON-6 1.5x1.5 | SLUSBU9I (Aug. 2024) | https://www.ti.com/lit/ds/symlink/bq2970.pdf | 2026-11-06 | docs/datasheets/TI_BQ2970_Datasheet_RevI.pdf | INORMAL 4 uA typ / 5.5 uA max (S.5), braucht externe Doppel-N-FET
U3 (Alt.) | Li-Ion-Schutz-IC 1 Zelle | PUOLOP | DW01A | C351410 | Extended | SOT-23-6 | - | https://www.lcsc.com/datasheet/lcsc_datasheet_1912111437_PUOLOP-DW01A_C351410.pdf | 2026-11-06 | docs/datasheets/PUOLOP_DW01A_Datasheet.pdf | ICC 3.0 typ / 6.0 uA max (S.4), VOD 2.4..2.6 V
Q2 (Alt.) | Doppel-N-MOSFET fuer Schutz-IC | FUXINSEMI | FS8205A | C908265 | Extended | SOT-23-6 | - | https://www.lcsc.com/datasheet/lcsc_datasheet_2010271837_FUXINSEMI-FS8205A_C908265.pdf | 2026-11-06 | docs/datasheets/FUXINSEMI_FS8205A_Datasheet.pdf | IDSS 1 uA @ 20 V
U3 (Alt.) | Schutz-IC mit integriertem FET | XySemi | XB5353A | C80628 | Extended | SOT-23-5 | - | https://www.lcsc.com/datasheet/lcsc_datasheet_1811151533_XySemi-XB5353A_C80628.pdf | 2026-11-06 | docs/datasheets/XySemi_XB5353A_Datasheet.pdf | IOPE 2.8 typ / 6 uA max (S.3)
U4 (Kand. LI) | LDO 3.0/3.3 V, 25 nA IQ | Texas Instruments | TPS7A0230PDBVR | C3747031 | Extended | SOT-23-5 | SBVS277C (Sept. 2022) | https://www.ti.com/lit/ds/symlink/tps7a02.pdf | 2026-11-06 | docs/datasheets/TI_TPS7A02_Datasheet_RevC.pdf | IGND 25 nA typ, 60 nA max (S.6), VIN 1.5..6.0 V
U4 (Alt.) | LDO 3.3 V | Richtek | RT9080-33GJ5 | C841192 | Extended | TSOT-23-5 | DS9080-05 (June 2017) | https://www.lcsc.com/datasheet/lcsc_datasheet_2009192305_Richtek-Tech-RT9080-33GJ5_C841192.pdf | 2026-11-06 | docs/datasheets/Richtek_RT9080_Datasheet_DS9080-05.pdf | IQ 2 uA (S.1)
U4 (Alt.) | LDO 3.3 V | Torex | XC6206P332MR-G | C5446 | Basic | SOT-23-3 | ETR0305_004b | https://www.lcsc.com/datasheet/lcsc_datasheet_2304140030_Torex-Semicon-XC6206P332MR-G_C5446.pdf | 2026-11-06 | docs/datasheets/Torex_XC6206_Datasheet_ETR0305-004b.pdf | IDD 1.0 typ / 3.0 uA max (S.4)
U4 (Alt.) | LDO 3.3 V, 30 V | Holtek | HT7533-1 | C14289 | Basic | SOT-89-3 | Rev. 2.80 (2024-04-10) | https://www.lcsc.com/datasheet/lcsc_datasheet_2312191111_Holtek-Semicon-HT7533-1_C14289.pdf | 2026-11-06 | docs/datasheets/Holtek_HT7533_Datasheet_V2.80.pdf | ISS 2.5 typ / 4.0 uA max (S.5)
J1 (Kand. LI) | USB-C Buchse 6 Pin (nur Laden) | SHOU HAN | TYPE-C 6P | C456012 | Extended | SMD | - | https://www.lcsc.com/datasheet/lcsc_datasheet_2012031006_SHOU-HAN-TYPE-C-6P_C456012.pdf | 2026-11-06 | docs/datasheets/SHOUHAN_TYPE-C-6P_Datasheet.pdf | Rating 5 V 3 A, -30..85 C (S.3)
D2 (Kand. LI) | TVS VBUS 20 V | Littelfuse | SMAJ20A | C148209 | Extended | SMA | Revised 11/20/15 | https://www.lcsc.com/datasheet/lcsc_datasheet_2304140030_Littelfuse-SMAJ20A_C148209.pdf | 2026-11-06 | docs/datasheets/Littelfuse_SMAJ_Datasheet.pdf | VR 20 V, VBR 22.2..24.5 V, VC 32.4 V @ 12.3 A, IR 1 uA (S.2)
F1 (Kand. LI) | PPTC VBUS 1206 500 mA 24 V | DOWO | 500mA/24V | C2984676 | Extended | 1206 | - | https://wmsc.lcsc.com/wmsc/upload/file/pdf/v2/lcsc/2203252253_DOWO-500mA-24V_C2984676.pdf | 2026-11-06 | docs/datasheets/DOWO_PPTC1206-500mA-24V_Datasheet.pdf | Vmax 24 V
RT1 (Kand. LI) | NTC 10 k B3380 0402 | Murata | NCP15XH103F03RC | C77131 | Extended | 0402 | Katalog | https://www.lcsc.com/datasheet/lcsc_datasheet_2304140030_Murata-Electronics-NCP15XH103F03RC_C77131.pdf | 2026-11-06 | docs/datasheets/Murata_NCP15XH103F03RC_Datasheet.pdf | thermische Kopplung an Zelle konstruktiv loesen
- | White Paper Knopfzellen und Pulsstrom | Texas Instruments | SWRA349 | - | - | - | SWRA349 | aus Phase-1-Pruefung (ti.com) | 2026-11-06 | docs/appnotes/TI_SWRA349_WhitePaper.pdf | Nutzbare Kapazitaet mit/ohne Puffer-C, IR-Verlauf
- | Schutzschaltungsdaten LiPo-Pack | Renata | ICP-Serie Safety Circuit | - | - | - | - | Renata: 'Safety Circuit on request' | 2026-11-06 | NICHT VERFUEGBAR | Ruhestrom/Schwellen der zelleninternen PCM bei Renata anfragen
- | DC-Bias-Kurve 100 uF 1206 | Murata | GRM31CR60J107ME39 (SimSurfing) | - | - | - | - | https://ds.murata.co.jp/simsurfing/ | 2026-11-06 | NICHT HERUNTERLADBAR | murata.com Bot-Sperre, DC-Bias als ANNAHME 50 %
GW-MCU1 | Gateway-Modul Variante A (WLAN+BLE, BLE-Central, HTTPS) | Espressif | ESP32-S3-WROOM-1 (-N8/-N16, ggf. R2/R8) |  | n/a (Fertigboard) | Modul 18.0x25.5 mm | Datasheet v1.8 | https://www.espressif.com/sites/default/files/documentation/esp32-s3-wroom-1_wroom-1u_datasheet_en.pdf | 2026-11-06 | docs/datasheets/Espressif_ESP32-S3-WROOM-1_Datasheet_v1.8.pdf | Kandidat Gateway (Phase 2) | BLE RX 93 mA, TX 202 mA @9 dBm (S. 28 Tab. 6-5) | Flash 100k Zyklen (S. 30 Tab. 6-8)
GW-MCU1-SoC | SoC zu GW-MCU1 | Espressif | ESP32-S3 |  | n/a | QFN56 | Datasheet v2.2 | https://www.espressif.com/sites/default/files/documentation/esp32-s3_datasheet_en.pdf | 2026-11-06 | docs/datasheets/Espressif_ESP32-S3_Datasheet_v2.2.pdf | Kandidat Gateway (Phase 2) | BLE RX 93 mA (S. 67 Tab. 5-8)
GW-MCU2 | Gateway-Modul Variante A' (WLAN6+BLE5, NimBLE-Controller) | Espressif | ESP32-C6-WROOM-1 |  | n/a (Fertigboard) | Modul | Datasheet v1.4 | https://www.espressif.com/sites/default/files/documentation/esp32-c6-wroom-1_wroom-1u_datasheet_en.pdf | 2026-11-06 | docs/datasheets/Espressif_ESP32-C6-WROOM-1_Datasheet_v1.4.pdf | Alternative | BLE RX 73 mA (S. 27 Tab. 6-5) | nur 1 CPU-Kern
GW-SBC1 | Gateway Variante B (Linux, BlueZ, SQLite) | Raspberry Pi Ltd | Raspberry Pi Zero 2 W |  | n/a (Fertigboard) | 65x30 mm | Product Brief April 2024 | https://datasheets.raspberrypi.com/rpizero2/raspberry-pi-zero-2-w-product-brief.pdf | 2026-11-06 | docs/datasheets/RaspberryPi_Zero2W_ProductBrief_2024-04.pdf | Kandidat | 5 V 2.5 A Eingang, BT 4.2/BLE, Produktion bis mind. Jan 2030 (S. 2) | kein RTC | ausfuehrliches Datenblatt nicht vorhanden (nur Product Brief)
GW-RTC | Echtzeituhr mit Pufferung fuer Gateway (REQ-GW-09, OP-GW-3, W-8), Vorschlag Phase 5 | Analog Devices (Maxim) | DS3231 (auf Adafruit PiRTC 4282) |  | n/a (Fertigmodul) | SO-16 300 mil (IC2 /SO im Adafruit-Schaltplan) | 19-5170 Rev 10 (3/15) | https://cdn-shop.adafruit.com/product-files/3013/DS3231.pdf | 2026-11-08 | docs/datasheets/Maxim_DS3231_Datasheet_19-5170Rev10.pdf | +-2 ppm 0-40 C (S. 1), IBATT max 3.0 uA (S. 3), VBAT-Pin UL-anerkannt gegen Rueckladung Lithium-Primaerzelle (S. 9 Pin 14); I2C 0x68 (Guide S. 10; Datenblatt Slave-Adresse 1101000), keine Kollision mit SHT4x 0x44. Kopie vom Adafruit-CDN, weil analog.com aus WSL nicht erreichbar (2026-11-08) -> ob Rev 10 die neueste ist, nicht geprueft
GW-RTC-MOD | RTC-Modul Gateway (DS3231 + CR1220-Halter, ohne Ladepfad) | Adafruit | PiRTC Precise DS3231 (4282) |  | n/a (Fertigmodul) | 21.3 x 20.0 x 13.6 mm inkl. Buchsenleiste (Produktseite) | Eagle-Schaltplan Commit 2021-02-22 | https://github.com/adafruit/Adafruit-PiRTC-DS3231-PCB | 2026-11-08 | docs/datasheets/Adafruit_4282_PiRTC-DS3231_Schematic_2021-02-22.sch | Netz VBAT = nur B1(+) und IC2 VBAT -> kein Ladepfad (hardware/gateway/check_rtc_schematic.py); Masse/Preis: docs/references/Adafruit_4282_PiRTC-DS3231_Produktseite_Auszug_2026-11-08.txt, pi-shop.ch CHF 18.90 an Lager (2026-11-08). Passt nicht in CAD-Rahmen 15 x 12 x 4 mm -> Mechanik
GW-RTC-AN (AppNote) | RTC am Raspberry Pi einrichten (dtoverlay=i2c-rtc,ds3231) | Adafruit | Adding a Real Time Clock to Raspberry Pi (Learn Guide) | - | - | - | Last updated 2026-04-07 | https://cdn-learn.adafruit.com/downloads/pdf/adding-a-real-time-clock-to-raspberry-pi.pdf | 2026-11-08 | docs/appnotes/Adafruit_AddingRTC-RaspberryPi_Guide_2026-04-07.pdf | Adresse 0x68 S. 10, dtoverlay=i2c-rtc,ds3231 S. 11; PiRTC auf Pins 1-6
GW-RTC-CELL | Pufferzelle RTC | offen | CR1220 (Lithium-Primaerzelle 3 V) |  | n/a (Zukauf) | CR1220 | - | - | 2026-11-08 | - | KEIN Datenblatt lokal (Hersteller offen) -> beim Kauf ablegen; Preis ANNAHME 3.00 CHF (hardware/gateway/BOM_GATEWAY.csv G5)
GW-CLIM1-BRD (Kandidat) | SHT4x-Breakout Gateway (D-017) | Seeed Studio | Grove - Temperature & Humidity Sensor (SHT41) |  | n/a (Fertigmodul) | 20 x 40 mm (Haendlerangabe) | - | https://www.pi-shop.ch/grove-temperature-humidity-sensor-sht41 | 2026-11-08 | - | Breakout-Schaltplan NICHT lokal (Regler/Pull-ups unbekannt) -> Orchestrator melden; pi-shop.ch CHF 8.90, nicht an Lager (2026-11-08). Masse 20 x 40 mm belegt: docs/references/Seeed_Grove-SHT4x_Wiki_Auszug_2026-11-08.txt (Bauhoehe nicht angegeben). Passt nicht in Klimakammer G1 v4 (innen 8 x 38 x 16, check_gateway_pi.txt 14)
GW-PSU | Netzteil Gateway 5 V 2.5 A Micro-USB | Raspberry Pi Ltd | Original 12.5 W Micro-USB Steckernetzteil |  | n/a (Zukauf) | Steckernetzteil | EU DoC RP-001257-CF-3 (Date of Issue 11 August 2026) | https://pip-assets.raspberrypi.com/categories/499-approvals/documents/RP-001257-CF-3-EU%20CE%20Declaration%20of%20Conformity.pdf | 2026-11-09 | docs/datasheets/RaspberryPi_12W5-MicroUSB-PSU_EU-DoC_RP-001257-CF-3.pdf | EU-Konformitaetserklaerung S. 1-2: RoHS 2011/65/EU, EMV 2014/30/EU, LVD 2014/35/EU, ErP 2009/125/EC + (EU) 2019/1782; Normen EN 55032/55035, EN 62368-1:2014+A11:2017, EN IEC 63000, EN 50563 (S. 2). Schliesst F-8/Register-Luecke G2 (Sicherheit Schluss K-1). Wareneingang: Typ/CE/Herstellername, Gehaeuse und Kabel unbeschaedigt, Stecker 2-polig, kein Fremdnetzteil. pi-shop.ch Art. 11715 CHF 11.90
GW-SD | microSD Gateway (Industrial, pSLC) G3 | Kingston | SDCIT2/16GB (microSDHC Industrial UHS-I 16 GB, Alternativen SDCIT2/8GB) |  | n/a (Zukauf) | microSD | MKD-02122026 (PDF 2026-04-06) | https://www.kingston.com/datasheets/SDCIT2_en.pdf | 2026-11-09 | docs/datasheets/Kingston_SDCIT2_Datasheet_MKD-02122026.pdf | Datenblatt S. 1: TLC im pSLC-Modus, bis 3840 TBW / 30K P/E (hoechste Kapazitaet, Fussnote 3), -40...85 C, Varianten 8/16/32/64/128 GB (S. 2). pi-shop.ch Art. 10951 CHF 27.90 nicht an Lager (2026-11-09); Grosshandel alltron.ch: 16 GB Lager 0, 100 Stk bestellt auf 23.11.2026; mediamarkt.ch Marktplatz (Ultimus.ch) 16 GB CHF 63.95 / 8 GB CHF 56.95 an Lager (docs/references/Haendler_Einkauf_Auszug_2026-11-09.txt)
Y-LF2 (Konz. A/C) | 32.768-kHz-Quarz 9 pF fuer CC2340 (CL 6-12 pF) | Seiko Epson | Q13FC13500003 (FC-135) | C99010 | Extended | SMD3215-2P | LCSC-Kopie (Herstellerkatalog FC-135R/135/255, chin.) | https://www.lcsc.com/datasheet/lcsc_datasheet_1810181110_Seiko-Epson-Q13FC13500003_C99010.pdf | 2026-11-06 | docs/datasheets/Epson_Q13FC13500003_Datasheet_LCSC-2018-10.pdf | LCSC-Datenblatt; +-20 ppm, B -0.04 ppm/K2 max, ESR 70 kOhm max (S.1); Lager 33692, 0.204 USD (JLC-API 2026-11-06)
Y-LF1 (Konz. B) | 32.768-kHz-Quarz 12.5 pF fuer CH592 (intern 12-27 pF) | Seiko Epson | Q13FC13500004 (FC-135) | C32346 | Basic | SMD3215-2P | LCSC-Kopie | https://www.lcsc.com/datasheet/lcsc_datasheet_2404180925_Seiko-Epson-Q13FC13500004_C32346.pdf | 2026-11-06 | docs/datasheets/Epson_Q13FC13500004_Datasheet_LCSC-2024-04.pdf | LCSC-Datenblatt; CL 12.5 pF -> NICHT fuer CC2340 (6-12 pF, SWRS272F S.27); Lager 483710, 0.1715 USD (JLC-API 2026-11-06)
Y-HF1 (Konz. A/C) | 48-MHz-Quarz CC2340 | TAITIEN | XXHCELNANF-48MHZ | C5160139 | Extended | SMD3225-4P | LCSC-Kopie | https://wmsc.lcsc.com/wmsc/upload/file/pdf/v2/lcsc/2210111800_TAITIEN-Elec-XXHCELNANF-48MHZ_C5160139.pdf | 2026-11-06 | docs/datasheets/TAITIEN_XXHCELNANF-48MHZ_Datasheet_LCSC-2022-10.pdf | LCSC-Datenblatt; Toleranz/ESR gegen CC2340-DS S.27 in Phase 3 pruefen; Lager 1804, 0.143 USD (JLC-API 2026-11-06)
Y-HF2 (Konz. B) | 32-MHz-Quarz CH592 | YXC | X322532MOB4SI | C9009 | Extended | SMD3225-4P | LCSC-Kopie | https://www.lcsc.com/datasheet/lcsc_datasheet_2403291504_YXC-Crystal-Oscillators-X322532MOB4SI_C9009.pdf | 2026-11-06 | docs/datasheets/YXC_X322532MOB4SI_Datasheet_LCSC-2024-03.pdf | LCSC-Datenblatt; CL 12 pF; Lager 296728, 0.0957 USD (JLC-API 2026-11-06)
L1 (alle) | Leistungsspule 10 uH DC/DC (CC2340 VDDR bzw. CH592 VSW) | Sunlord | WPN201610H100MT | C89132 | Extended | 0806 (2.0 x 1.6 x 1.0 mm) | LCSC-Kopie (Katalog WPN, Rev. 2023/06/01) | https://wmsc.lcsc.com/wmsc/upload/file/pdf/v2/lcsc/2310241732_Sunlord-WPN201610H100MT_C89132.pdf | 2026-11-06 | docs/datasheets/Sunlord_WPN201610H100MT_Datasheet_LCSC-2023-10.pdf | LCSC-Datenblatt; DCR max 0.826 Ohm, Isat max 0.80 A, Irms max 0.65 A (S.2); kein Basic-Leistungsinduktor 10 uH gefunden; Lager 5075, 0.0418 USD (JLC-API 2026-11-06)
L2 (Konz. C) | Spule 10 uH 0603 fuer LC-Tank FDC2212 (NICHT fuer DC/DC) | Sunlord | SDFL1608S100KTF | C1035 | Basic | 0603 | LCSC/JLC-Kopie | JLC dataManualFileAccessIdUrl (C1035) | 2026-11-06 | docs/datasheets/Sunlord_SDFL1608S100KTF_Datasheet_LCSC-2023-10.pdf | LCSC-Datenblatt; Nennstrom nur 3 mA (JLC-Attribut) -> als DC/DC-Spule ungeeignet (Korrektur zu research_elektronik.md 3.3/10); Lager 418483, 0.0279 USD (JLC-API 2026-11-06)
L-RF (Konz. A/C) | HF-Spule 2.7 nH 0402 LC-Filter | Sunlord | SDCL1005C2N7STDF | C27123 | Extended | 0402 | LCSC/JLC-Kopie (Serie SDCL1005) | JLC dataManualFileAccessIdUrl (C27123) | 2026-11-06 | docs/datasheets/Sunlord_SDCL1005-Serie_Datasheet_LCSC-2023-10.pdf | LCSC-Datenblatt; TI-Referenz 2.8 nH (SWRA834A S.5) -> 2.7 nH, Abstimmung PROTOTYP-PRUEFUNG; Option 2 nH C43365 (Pi-Netz); Lager 110991
C-RF (Konz. A/C) | C 1.5 pF C0G 0402 LC-Filter | FH (Fenghua) | 0402CG1R5C500NT | C1552 | Extended | 0402 | LCSC-Kopie (Serie 0402CG) | https://www.lcsc.com/datasheet/lcsc_datasheet_2304140030_FH--Guangdong-Fenghua-Advanced-Tech-0402CG220J500NT_C1555.pdf | 2026-11-06 | docs/datasheets/FH_0402CG-Serie_Datasheet_LCSC-2023-04.pdf | LCSC-Datenblatt (gilt fuer C1548 15 pF Basic, C1555 22 pF Basic, C1551 1.2 pF Ext.); Lager 171124, 0.0045 USD
C (alle) | MLCC 0402 100 nF / 1 uF / 4.7 uF (C1525, C52923, C23733) | Samsung Electro-Mechanics | CL05B104KO5NNNC; CL05A105KA5NQNC; CL05A475MP5NRNC | C1525; C52923; C23733 | Basic | 0402 | LCSC-Kopie (Samsung-MLCC-Katalog) | https://datasheet.lcsc.com/datasheet/pdf/02336ea48ea44ca18c72517dd3cb7b47.pdf | 2026-11-06 | docs/datasheets/Samsung_CL05-Serie_Datasheet_LCSC-2023-04.pdf | LCSC-Datenblatt; Lager 34.7 Mio / 11.7 Mio / 1.08 Mio (JLC-API 2026-11-06)
C (alle) | MLCC 10 uF 6.3 V X5R 0402 | Samsung Electro-Mechanics | CL05A106MQ5NUNC | C15525 | Basic | 0402 | LCSC-Kopie | https://www.lcsc.com/datasheet/lcsc_datasheet_2208231630_Samsung-Electro-Mechanics-CL05A106MQ5NUNC_C15525.pdf | 2026-11-06 | docs/datasheets/Samsung_CL05A106MQ5NUNC_Datasheet_LCSC-2022-08.pdf | LCSC-Datenblatt; Lager 9187221, 0.0258 USD
R (alle) | Dickschicht-R 0402 1 % (0R, 100R, 470R, 1k, 2.2k, 4.7k, 5.1k, 10k, 22k, 100k, 237k, 1M) | UNI-ROYAL | 0402WGF-Serie | C17168; C25076; C25117; C11702; C25879; C25900; C25905; C25744; C25768; C25741; C27001; C26083 | Basic (C27001 237k: Extended) | 0402 | LCSC-Kopie | https://www.lcsc.com/datasheet/lcsc_datasheet_2411221126_UNI-ROYAL-Uniroyal-Elec-0402WGF1002TCE_C25744.pdf | 2026-11-06 | docs/datasheets/UNI-ROYAL_0402WGF-Serie_Datasheet_LCSC-2024-11.pdf | LCSC-Datenblatt; alle per JLC-API 2026-11-06 geprueft
D1 (alle) | Status-LED rot 0603 | Hubei KENTO | KT-0603R | C2286 | Basic | 0603 | LCSC-Kopie | https://www.lcsc.com/datasheet/lcsc_datasheet_1810231112_Hubei-KENTO-Elec-KT-0603R_C2286.pdf | 2026-11-06 | docs/datasheets/KENTO_KT-0603R_Datasheet_LCSC-2018-10.pdf | LCSC-Datenblatt; VF 1.8-2.4 V; Lager 6652313, 0.0077 USD; gruene 0603 nur Extended (C72043 Lager 0)
SW1 (alle) | Taster SMD 5.1 x 5.1 mm | XKB Connection | TS-1187A-B-A-B | C318884 | Basic | SMD-4P 5.1x5.1 | LCSC-Kopie | https://www.lcsc.com/datasheet/lcsc_datasheet_2304140030_XKB-Connection-TS-1187A-B-A-B_C318884.pdf | 2026-11-06 | docs/datasheets/XKB_TS-1187A-B-A-B_Datasheet_LCSC-2023-04.pdf | LCSC-Datenblatt; 1.6 N, 100000 Zyklen, Hoehe 1.5 mm (JLC-Attribut); Lager 968165
D2 (alle) | Rueckstromsperre Programmier-Versorgung | Jiangsu Changjing (CJ) | 1N4148WS | C2128 | Basic | SOD-323 | LCSC-Kopie | https://www.lcsc.com/datasheet/lcsc_datasheet_1810101110_Jiangsu-Changjing-Electronics-Technology-Co---Ltd--1N4148WS_C2128.pdf | 2026-11-06 | docs/datasheets/CJ_1N4148WS_Datasheet_LCSC-2018-10.pdf | LCSC-Datenblatt; IR 1 uA @ 75 V (JLC-Attribut); zusammen mit 100 Ohm = 2 Rueckstrombegrenzungen (REQ-SAF-CC-03)
Q3 (Konz. C) | N-MOSFET Schalter Batteriespannungsteiler | Jiangsu Changjing (CJ) | 2N7002 | C8545 | Basic | SOT-23 | LCSC-Kopie | https://www.lcsc.com/datasheet/lcsc_datasheet_2304140030_Jiangsu-Changjing-Electronics-Technology-Co---Ltd--2N7002_C8545.pdf | 2026-11-06 | docs/datasheets/CJ_2N7002_Datasheet_LCSC-2023-04.pdf | LCSC-Datenblatt; Lager 4181046, 0.0171 USD
U-WLAN (C-WLAN) | WLAN/BLE-SoC (nur Variante C-WLAN, Bewertung) | Espressif | ESP32-C3 | - | - | QFN32 | Datasheet v2.4 | https://www.espressif.com/sites/default/files/documentation/esp32-c3_datasheet_en.pdf | 2026-11-06 | docs/datasheets/Espressif_ESP32-C3_Datasheet_v2.4.pdf | Deep-sleep 5 uA (S.57 Tab. 5-9), TX 335 mA Spitze (S.56 Tab. 5-7), VDD 3.0-3.6 V (S.54 Tab. 5-2)
U-WLAN-Mod (C-WLAN) | WLAN-Modul mit PCB-Antenne | Espressif | ESP32-C3-MINI-1-N4 | C2838502 | Extended | SMD 13.2 x 16.6 x 2.4 mm | Datasheet v2.2 | https://www.espressif.com/sites/default/files/documentation/esp32-c3-mini-1_datasheet_en.pdf | 2026-11-06 | docs/datasheets/Espressif_ESP32-C3-MINI-1_Datasheet_v2.2.pdf | Abmessungen S.3; JLC Lager 12670, 2.6865 USD @20 (JLC-API 2026-11-06); nur Kurzbewertung
Y-HF1 (Konz. A/A-32/C, v0.2) | 48-MHz-Quarz CC2340 (ersetzt C5160139) | HCI (Suzhou HangJing) | XC32M4-48.000-F08NLDT | C2925606 | Extended | SMD3225-4P | LCSC-Kopie (Seriendatenblatt XC32M4) | https://wmsc.lcsc.com/wmsc/upload/file/pdf/v2/lcsc/2205251400_HCI-XC32M4-48-000-F08NLDT_C2925606.pdf | 2026-11-06 | docs/datasheets/HCI_XC32M4-48.000-F08NLDT_Datasheet_LCSC-2022-05.pdf | LCSC-Datenblatt; Serie: CL 6-32 pF waehlbar, ESR < 40 Ohm (30-54 MHz), +-10 ppm (S.1); CL 8 pF laut JLC-Attribut/Bestellcode F08 (ANNAHME bis Herstellerbestaetigung); CC2340 verlangt CL 5-9 pF, ESR <= 60 Ohm (SWRS272F S.26); Lager 8817, 0.0993 USD (JLC-API 2026-11-06)
C (alle, v0.2) | C0G 0402 15 pF / 22 pF / 100 pF (C1548, C1555, C1546) | FH (Fenghua) | 0402CG150J500NT; 0402CG220J500NT; 0402CG101J500NT | C1548; C1555; C1546 | Basic | 0402 | LCSC-Kopie (Serie 0402CG) | https://www.lcsc.com/datasheet/lcsc_datasheet_2304140030_FH--Guangdong-Fenghua-Advanced-Tech-0402CG220J500NT_C1555.pdf | 2026-11-06 | docs/datasheets/FH_0402CG-Serie_Datasheet_LCSC-2023-04.pdf | Seriendatenblatt deckt die Werte ab (Pruefbericht Fertigung k-3); C1546 100 pF neu als Cref2 (Messkette v0.2); Lager 1.2 / 1.7 / 2.7 Mio
XBT1 (geprueft, nicht lieferbar) | Halter CR2450 kompakt | Keystone | 3008TR (SMT) / 3009 (THM) | C238100 / C238101 | Extended | SMD/THM 25.4 x 22.6 mm | Katalog M65 (3008) | - | 2026-11-06 | docs/datasheets/Keystone_3034_Catalog_M65.pdf | JLC-Lager nur 4 (3008TR) bzw. 21 (3009) Stk (JLC-API 2026-11-06) -> fuer Serie nicht verfuegbar
U-T1 (Konz. A/A-32/B/C, v0.3) | Bodentemperatur digital, VSSOP-8 (E2) | Texas Instruments | TMP1075DGKR | C2864807 | Extended | VSSOP-8 3 x 3 mm | SBOS854F | https://www.ti.com/lit/ds/symlink/tmp1075.pdf | 2026-11-06 | docs/datasheets/TI_TMP1075_Datasheet_SBOS854F.pdf | Datenblatt gilt fuer D/DGK/DSG; DGK: +-1 C -40..110 C (S.4 Tab. 4-1), Pinout DGK Abb. 5-2 / Tab. 5-1 (S.5): SDA 1, SCL 2, ALERT 3, GND 4, A2 5, A1 6, A0 7, V+ 8; nicht leadless -> keine Roentgengebuehr; Lager 15773, 0.3995 USD @1 / 0.316 @10 (JLC-API 2026-11-06, bestaetigt Projektleiter)
REF-LI1 | Herstellerregeln Rueckstrom Lithium-Knopfzellen (Back-up-Schaltung) | Maxell | CR Coin Type Lithium Manganese Dioxide Battery - Warnings | - | - | - | 12e (2012) | maxell.com.tw (via Sicherheits-Agent) | 2026-11-06 | docs/references/Maxell_CR_Warnings_12e_2012.pdf | S.2 "Circuit Design for Back-up Use": Ladung durch Leckstrom <= 1 % Nennkapazitaet; Strom bei Diodenausfall max. 10 mA (CR2032) / 15 mA (CR2450)
REF-LI2 | Panasonic Lithium Handbook, Design Tips (Reverse current blocking diode) | Panasonic | Lithium Handbook LiThb-BSG | - | - | - | 2005 | master-instruments.com.au (via Sicherheits-Agent) | 2026-11-06 | docs/references/Panasonic_LithiumHandbook_DesignTips_LiThb-BSG_2005.pdf | S.1: Gesamtladung ueber Nutzungsdauer <= 3 % der Nennkapazitaet (Knopfzellen); Diode und Schutzwiderstand in Serie
D1 (RGB, gewaehlt) | Status-LED RGB gemeinsame Anode 1615 | TUOZHAN (ShenZhen TUOZHAN Optoelectronics) | F.1615.00026/P4-1615G2B2R4TS2-06T-001-24 | C7496855 | Extended | SMD-4P 1.6x1.5 mm (Pin 1 = Anode, 2 = R, 3 = G, 4 = B; S.4) | A0 (2021-12-26) | https://datasheet.lcsc.com/datasheet/pdf/105736f0352aed0945b821dfe5f0605e.pdf?productCode=C7496855 | 2026-11-07 | docs/datasheets/TUOZHAN_P4-1615G2B2R4TS2-06T-001-24_Datasheet_A0.pdf | LCSC-Datenblatt; VF@5mA R 1.8-2.2, G 2.5-2.9, B 2.6-3.0 V; Iv@5mA R 70-90, G 250-350, B 60-80 mcd; 120 Grad; VR 5 V; IF 30 mA (S.5); JLC 2026-11-07: Lager 74324, 0.0131 USD @1, 0.0114 @500
D1 (RGB, Zweitquelle) | Status-LED RGB gemeinsame Anode 1615 | XINGLIGHT | XL-1615RGBC-RF | C965840 | Extended | SMD-4P 1.6x1.5 mm (Pinbelegung vor Einsatz gegen S.8 pruefen) | LCSC 2024-10 | https://datasheet.lcsc.com/datasheet/pdf/0158170cd0ba772dd3d9a22a67a63b28.pdf?productCode=C965840 | 2026-11-07 | docs/datasheets/XINGLIGHT_XL-1615RGBC-RF_Datasheet_LCSC-2024-10.pdf | LCSC-Datenblatt; VF@20mA R 1.8-2.4, G/B 2.6-3.4 V (S.4); Iv@20mA B 120-180 mcd; JLC 2026-11-07: Lager 715582, 0.0197 USD @1; nur Zweitquelle (VF-Spezifikation nur bei 20 mA)
D1 (Referenz Kennlinie) | RGB-LED 1010 (nicht gewaehlt, liefert I-U-Kennlinie 1-10 mA) | Foshan NationStar Optoelectronics | FC-B1010RGBT-HG | C158099 | Extended | SMD-4P 1.0x1.0 mm | A1 (2024-07-25) | https://datasheet.lcsc.com/datasheet/pdf/b6b25b1f7fcd4dfbc4615cf841db1550.pdf?productCode=C158099 | 2026-11-07 | docs/datasheets/NationStar_FC-B1010RGBT-HG_Datasheet_A1.pdf | LCSC-Datenblatt; VF@2mA G 2.2-3.2 (typ 2.6), B 2.3-3.2 (typ 2.7) V, Iv@2mA B 3-10 mcd (S.2/13); I-U-Kurve S.3/13 fuer SPICE-Modell; JLC Lager 11466, 0.027 USD
R-LED-G | Vorwiderstand LED gruen 200R 0402 1 % | UNI-ROYAL | 0402WGF2000TCE | C25087 | Basic | 0402 | LCSC-Kopie (Serie) | https://www.lcsc.com/datasheet/lcsc_datasheet_2411221126_UNI-ROYAL-Uniroyal-Elec-0402WGF1002TCE_C25744.pdf | 2026-11-07 | docs/datasheets/UNI-ROYAL_0402WGF-Serie_Datasheet_LCSC-2024-11.pdf | Seriendatenblatt wie R (alle); JLC 2026-11-07: Basic, Lager 1752012, 0.0029 USD;VERALTET (Konzeptname; Rev C: R7 im Block Rev C): R 470R C25117 und B 100R C25076 bereits in R (alle)"
U-LEDCP (verworfen) | Inverter-Ladungspumpe fuer LED (Option, nicht empfohlen) | Texas Instruments | LM2664M6X/NOPB | C108573 | Extended | SOT-23-6 | SNVS005E (Dez. 2014) | https://www.ti.com/lit/ds/symlink/lm2664.pdf | 2026-11-07 | docs/datasheets/TI_LM2664_Datasheet_SNVS005E.pdf | V+ 1.8-5.5 V, IQ 220/500 uA, ISD 1 uA typ (S.5, V+ = 5 V); JLC 2026-11-07: Lager 162442, 0.3337 USD; verworfen (Pin, Ruhestrom, Kosten)
GW-AN1 (AppNote) | Hardware-Design-Richtlinie ESP32-S3 (Antennen-Keepout, 15 mm Freiraum im Gehaeuse) | Espressif | ESP32-S3 Hardware Design Guidelines | - | - | - | Release master (PDF erzeugt 2026-11-05) | https://docs.espressif.com/projects/esp-hardware-design-guidelines/en/latest/esp32s3/esp-hardware-design-guidelines-en-master-esp32s3.pdf | 2026-11-07 | docs/appnotes/Espressif_ESP32-S3_HardwareDesignGuidelines_master-2026-11.pdf | Abschn. 1.4.7 (Doku-S.30, PDF-S.33): mind. 15 mm Freiraum in alle Richtungen im Gehaeuse
GW-ANT1 (Kandidat) | FPC-Antenne 2.4 GHz U.FL fuer XIAO ESP32-S3 (A-02) | Seeed Studio | FPC Antenna A-02 (1.16 dBi) | - | n/a (Zukauf) | FPC mit U.FL-Kabel | - | https://www.unmannedtechshop.co.uk/blogs/knowledge-base/xiao-fpc-antenna-a01-vs-a02-esp32-c3-c5-s3 | 2026-11-07 | - | KEIN Herstellerdatenblatt lokal (nur Haendlerangaben: 2400-2500 MHz, 1.16 dBi Spitze, VSWR <= 4.5); CH-Preis nicht gefunden -> Orchestrator melden
GW-ANT2 (Kandidat) | FPC-Antenne 2.4 GHz U.FL selbstklebend 100 mm Kabel | TE Connectivity Linx | ANT-2.4-FPC-LV100UF | - | n/a (Zukauf) | FPC 45x7 (Haendlerangabe), U.FL/MHF1 | - | https://www.digikey.ch/en/products/detail/te-connectivity-linx/ANT-2-4-FPC-LV100UF/16570602 | 2026-11-07 | - | Datenblatt NICHT ladbar (te.com: Access Denied aus WSL) -> Orchestrator melden; DigiKey CH 2026-11-07: CHF 3.77 @1, 3.643 @10, Lager 944, 4.3 dBi (> zertifizierte Antenne, EIRP pruefen)
GW-BRD1 | Gateway-Board (ESP32-S3R8, 16 MB Flash PY25Q128HA, 8 MB PSRAM in-package, U.FL) | Seeed Studio | XIAO ESP32-S3 Plus | - | n/a (Fertigboard) | XIAO-Formfaktor (Masse nicht geprueft) | Schematic V1.1 (2026-01-15) | https://files.seeedstudio.com/wiki/SeeedStudio-XIAO-ESP32S3/res/XIAO_ESP32S3_Plus_V1.1_SCH_260115.pdf | 2026-11-07 | docs/datasheets/Seeed_XIAO-ESP32S3-Plus_Schematic_V1.1-260115.pdf | Kein Hersteller-Datenblatt fuer das Board | Flash-Baustein PY25Q128HA-DFH-IR (Schaltplan S. 4), Block Diagram S. 3 (Internal PSRAM, External Flash) | Speicherangaben 16 MB Flash/8 MB PSRAM/ESP32-S3R8 laut Wiki-Auszug docs/references/Seeed_XIAO-ESP32S3_Wiki_Auszug_2026-11-07.txt | Lizenz Schaltplan CC BY-SA 4.0 | Board hat Li-Lade-Schaltung (BAT-Pads) -> im Gateway unbeschaltet lassen (S2-W06)
TOOL-UART1 (Werkzeug) | USB-UART-Bruecke fuer Programmieradapter (VIO 1.8 V extern) | WCH (Board: Waveshare CH343 USB UART Board) | CH343G | - | n/a (Werkzeug, nicht auf Sensor-PCB) | SSOP-16 (CH343G) auf Fertigboard | V1E | https://files.waveshare.com/upload/a/a3/CH343DS1-en.PDF | 2026-11-07 | docs/datasheets/WCH_CH343_Datasheet_V1E.pdf | VIO 1.7-5.5 V (S. 8 Tab. 6.2), kein Rueckstrom VIO->VDD5/V3 (S. 4 Abschn. 5.2), RXD mit internem Pull-up IPUP 3-21 uA bei VIO 1.8 V, VIL max 0.5 V (S. 8) -> ueber 2 x 100 kOhm nicht lesbar, Puffer im Adapter noetig (PROTOCOL/INSTALL-Anleitung), Board-Preis Waveshare USD 3.49 (Micro), eckstein-shop.de EUR 4.15 (Type-C), 2026-11-07
REF-FLD1 | FR4 Dk/Df trocken und feuchtegesaettigt 1 MHz-1.5 GHz (Feldsimulation Sonde) | DuPont Advanced Fiber Systems (S. Khan) | Comparison of the Dielectric Constant and Dissipation Factors of non-woven Aramid/FR4 and Glass/FR4 Laminates | - | - | - | 1999 (PDF 2000-09) | https://hallaweb.jlab.org/tech/Detectors/public_html/manuals/data_sheets-manuals/D-F/D/dupont/comparison.pdf | 2026-11-07 | docs/references/DuPont_Khan_DkDf_Aramid-vs-GlassFR4_1999.pdf | Tab. 1 (S.5): Glass/FR4 7628, 25 degC: Dk 4.83/Df 0.015 @1 MHz trocken, 5.38/0.020 gesaettigt 85/85 (0.68 %); 4.69/0.012 bzw. 5.15/0.018 @10 MHz
REF-FLD2 | Bodendielektrik, Maxwell-Wagner-Effekt, Porenwasser-Leitfaehigkeit (Feldsimulation Sonde) | Wageningen UR (M. A. Hilhorst) | Dielectric Characterisation of Soil (Dissertation) | - | - | - | 1998 | https://edepot.wur.nl/202070 | 2026-11-07 | docs/references/WUR_Hilhorst_DielectricCharacterisationOfSoil_Thesis_1998.pdf | Kap. 2.4 Maxwell-Wagner (S.21 ff.), Kap. 4.2 Gl. 4.16/4.17 sigma_p aus eps' und sigma_b (S.83-87); Scan mit OCR-Text
REF-FLD3 | Leitfaehigkeit Trinkwasser Kanton Zuerich (Feldsimulation Salz) | Kantonales Labor Zuerich | Trinkwasseruntersuchung Wasserversorgung Aesch ZH | - | - | - | Probenahme 2026-02-02 | https://www.aesch-zh.ch/_doc/6785845 | 2026-11-07 | docs/references/KantonalesLaborZH_Trinkwasser_Aesch_2026-02.pdf | Leitfaehigkeit 307-359 uS/cm @25 degC (S.2-3), Einzelprobe 721 uS/cm
REF-FLD4 | Schutzlack Er/Df fuer 2-Lagen-Vergleich (Feldsimulation Sonde) | MG Chemicals | 4200UV UV Curable Conformal Coating TDS | - | - | - | ohne Rev. | https://res.cloudinary.com/iwh/image/upload/q_auto,g_center/assets/1/26/4200UV-_Data_Sheet.pdf | 2026-11-07 | docs/references/MGChemicals_4200UV_TDS.pdf | S.2: Dielectric Constant 3.3 @1 MHz, Df 0.03 (ASTM D150), Schichtdicke 50-125 um; nur Beispielwert Acryl-/UV-Lack, nicht gewaehlt
REF-VG2 | SDB Vergussmasse ER2223 Teil A (Harz), EN | Electrolube | Epoxy Resin ER2223 part A SDS | - | - | - | Revision 0 (2016-10-19) | https://res.cloudinary.com/electrolube/image/upload/v1573042102/044-ER2223A-SDS532_n9s3vc.pdf | 2026-11-08 | docs/references/Electrolube_ER2223-PartA_SDS_Rev0-2016-10-19_EN.pdf | S.1: Warning, H315 H317 H319 H411; S.6 Abschn. 8: Handschuhe EN 374 (Material vom Handschuhhersteller), Schutzbrille EN 166
REF-VG3 | SDB Vergussmasse ER2223 Teil A, aktueller Stand (schwedisch) | Electrolube | Epoxy Resin ER2223 part A SDS | - | - | - | Revision 0.64 (2023-10-27) | https://docs.rs-online.com/857a/A700000014863335.pdf | 2026-11-08 | docs/references/Electrolube_ER2223-PartA_SDS_Rev0.64-2023-10-27_SV.pdf | S.1 Produktcodes EER2223RP250G, EER2223K5K; S.2 H315 H317 H319 H411; deutschsprachige Fassung nicht gefunden -> beim Haendler anfordern
REF-VG4 | SDB Vergussmasse ER2223 Teil B (Haerter), ungarisch | Electrolube | Epoxy Resin ER2223 part B SDS | - | - | - | 2023-10-02 | https://media.distrelec.com/Web/Downloads/20/71/30116965_hun_hu_20231030_msds.pdf | 2026-11-08 | docs/references/Electrolube_ER2223-PartB_SDS_2023-10-02_HU.pdf | S.2: Gefahr, H302 H314 H317 H318 H373; S.3: 4,4-Methylenbis(cyclohexylamin) CAS 1761-71-3 60-100 %; nur ungarisch gefunden (H-Saetze sprachunabhaengig) -> SDB in DE/EN/FR/IT beim Haendler anfordern, Voraussetzung vor dem ersten Beutel (offen); Datei enthaelt ab S. 14 zusaetzlich Teil A (HU, 2023-10-27)
REF-VG5 | Vergleich Vergussmasse (gefuellt, CTE 30, Tg nicht angegeben) - nicht gewaehlt, Rueckfall F-1 | Electrolube | ER2221 TDS | - | - | - | Revision 8 (Mar 2019) | https://res.cloudinary.com/electrolube/image/upload/v1573044143/ER2221_zbl4ld.pdf | 2026-11-08 | docs/references/Electrolube_ER2221_TDS_Rev8-2019-03.pdf | S.1: 6000 mPa s, 13.91:1 Gewicht, 60 min; S.2: CTE 30, 1.88 g/ml, Permittivitaet 6.0 @50 Hz; kein Tg
REF-VG6 | SDB ER2221 Teil A (Vergleich) | Electrolube | Epoxy Resin ER2221 Part A SDS | - | - | - | Revision 1.2 (2019-10-09) | https://www.farnell.com/datasheets/3201851.pdf | 2026-11-08 | docs/references/Electrolube_ER2221-PartA_SDS_Rev1.2-2019-10-09_EN.pdf | S.1 Warning, H315 ...; Teil B nicht beschafft
REF-VG7 | Vergleich Vergussmasse (Tg/HDT zu tief) - ausgeschieden | Electrolube | ER2188 TDS | - | - | - | Revision 3 (Dec 2015) | https://www.simpex.ch/wp-content/uploads/2021/03/Technisches-Datenblatt_EER2188.pdf | 2026-11-08 | docs/references/Electrolube_ER2188_TDS_Rev3-2015-12.pdf | S.2: Deflection Temperature 50 C, CTE 40, gefuellt; S.1: 9000 mPa s, 10.97:1
REF-VG8 | Vergleich Vergussmasse (Tg 89 C, 22000 cP) - nicht gewaehlt (H360) | MG Chemicals | 832HT TDS | - | - | - | Ver. 6.2 (2026-06-18) | https://mgchemicals.com/downloads/tds/tds-832ht-2parts.pdf | 2026-11-08 | docs/references/MGChemicals_832HT_TDS_V6.2-2026-06-18.pdf | S.2: Tg 89 C, CTE 86, 22000 cP, 1.6:1 Vol.; S.3: Er 2.8 @1 MHz (als untere Er-Grenze in coat_epoxy.py), Lap shear ABS 3.5 N/mm2
REF-VG9 | SDB 832HT Kit (Vergleich) | MG Chemicals | 832HT Kit SDS (WHMIS/HCS) | - | - | - | Ver. 6.13 (2026-07-17) | https://mgchemicals.com/downloads/kits/01%20English%20Can-USA/sds-832ht-kit.pdf | 2026-11-08 | docs/references/MGChemicals_832HT-Kit_SDS_V6.13-2026-07-17_EN-CA.pdf | S.2-3: Teil A Repr. 1B H360, H315 H317 H319 H411; S.15-16: Teil B H314 H317 H411
REF-VG10 | Vergleich Vergussmasse (Tg 49 C) - ausgeschieden | MG Chemicals | 832B TDS | - | - | - | Ver. 5.4 (2026-04-29) | https://mgchemicals.com/downloads/tds/tds-832b-2parts.pdf | 2026-11-08 | docs/references/MGChemicals_832B_TDS_V5.4-2026-04-29.pdf | S.2: Tg 49 C, 3300 cP
REF-VG11 | Vergleich Vergussmasse gefuellt (Tg 117 C) - nicht gewaehlt (Kosten) | Henkel | Loctite Stycast 2651-40 W1 + Cat 9 TDS | - | - | - | May 2019 | https://datasheets.tdx.henkel.com/LOCTITE-STYCAST-2651-40-W1-CAT-9-en_GL.pdf | 2026-11-08 | docs/references/Henkel_LoctiteStycast2651-40W1-Cat9_TDS_2019-05.pdf | S.1: Tg 117 C TMA, CTE 60, 100:9 Gewicht, 45 min, Er 3.9 @1 MHz; SDB nicht beschafft (Henkel-Portal)
REF-VG12 | Vergleich Stycast 2651-40 mit Cat 9M (Mischviskositaet) | Henkel | Loctite Stycast 2651-40 Cat 9M TDS | - | - | - | March 2022 | https://datasheets.tdx.henkel.com/LOCTITE-STYCAST-2651-40-CAT-9M-en_GL.pdf | 2026-11-08 | docs/references/Henkel_LoctiteStycast2651-40-Cat9M_TDS_2022-03.pdf | S.1: Mischviskositaet 9733 mPa s, Tg 78 C, CTE 48
C1 C2 | MLCC 100 uF 6.3 V X5R 1206 | Samsung Electro-Mechanics | CL31A107MQHNNNE | C15008 | Basic | Capacitor_SMD:C_1206_3216Metric | siehe INDEX (bestehender Eintrag) | - | 2026-11-07 | docs/datasheets/Samsung_CL31A107MQHNNNE_Catalog_2015-11.pdf | VERALTET (Ref-Block Schaltplan Rev A/B-Entwurf; gueltig ist Block Rev C 2026-11-08, W-7): Schaltplan Rev A, Wert 100uF, 2 Stk; JLC-Abfrage 2026-11-07: base, Lager 1598560, 0.109 USD @1"
C6 C7 C8 C10 C11 C13 C21 C24 | MLCC 100 nF 16 V X7R 0402 | Samsung Electro-Mechanics | CL05B104KO5NNNC | C1525 | Basic | Capacitor_SMD:C_0402_1005Metric | siehe INDEX (bestehender Eintrag) | - | 2026-11-07 | docs/datasheets/Samsung_CL05-Serie_Datasheet_LCSC-2023-04.pdf | VERALTET (Ref-Block Schaltplan Rev A/B-Entwurf; gueltig ist Block Rev C 2026-11-08, W-7): Schaltplan Rev A, Wert 100nF, 8 Stk; JLC-Abfrage 2026-11-07: base, Lager 34377126, 0.0031 USD @1"
C12 | MLCC 1 uF 25 V X5R 0402 | Samsung Electro-Mechanics | CL05A105KA5NQNC | C52923 | Basic | Capacitor_SMD:C_0402_1005Metric | siehe INDEX (bestehender Eintrag) | - | 2026-11-07 | docs/datasheets/Samsung_CL05-Serie_Datasheet_LCSC-2023-04.pdf | VERALTET (Ref-Block Schaltplan Rev A/B-Entwurf; gueltig ist Block Rev C 2026-11-08, W-7): Schaltplan Rev A, Wert 1uF, 1 Stk; JLC-Abfrage 2026-11-07: base, Lager 11569897, 0.0058 USD @1"
C14 C15 C18 | MLCC 15 pF C0G 0402 | FH (Fenghua) | 0402CG150J500NT | C1548 | Basic | Capacitor_SMD:C_0402_1005Metric | siehe INDEX (bestehender Eintrag) | - | 2026-11-07 | docs/datasheets/FH_0402CG-Serie_Datasheet_LCSC-2023-04.pdf | VERALTET (Ref-Block Schaltplan Rev A/B-Entwurf; gueltig ist Block Rev C 2026-11-08, W-7): Schaltplan Rev A, Wert 15pF, 3 Stk; JLC-Abfrage 2026-11-07: base, Lager 1206221, 0.0026 USD @1"
C22 | MLCC 22 pF C0G 0402 | FH (Fenghua) | 0402CG220J500NT | C1555 | Basic | Capacitor_SMD:C_0402_1005Metric | siehe INDEX (bestehender Eintrag) | - | 2026-11-07 | docs/datasheets/FH_0402CG-Serie_Datasheet_LCSC-2023-04.pdf | VERALTET (Ref-Block Schaltplan Rev A/B-Entwurf; gueltig ist Block Rev C 2026-11-08, W-7): Schaltplan Rev A, Wert 22pF, 1 Stk; JLC-Abfrage 2026-11-07: base, Lager 1709535, 0.0019 USD @1"
C23 | MLCC 100 pF C0G 0402 | FH (Fenghua) | 0402CG101J500NT | C1546 | Basic | Capacitor_SMD:C_0402_1005Metric | siehe INDEX (bestehender Eintrag) | - | 2026-11-07 | docs/datasheets/FH_0402CG-Serie_Datasheet_LCSC-2023-04.pdf | VERALTET (Ref-Block Schaltplan Rev A/B-Entwurf; gueltig ist Block Rev C 2026-11-08, W-7): Schaltplan Rev A, Wert 100pF, 1 Stk; JLC-Abfrage 2026-11-07: base, Lager 2680322, 0.003 USD @1"
D1 | RGB-LED 1615 gem. Anode | TUOZHAN | P4-1615G2B2R4TS2-06T-001-24 | C7496855 | Extended | fluidi:LED_RGB_TUOZHAN_1615 | siehe INDEX (bestehender Eintrag) | - | 2026-11-07 | docs/datasheets/TUOZHAN_P4-1615G2B2R4TS2-06T-001-24_Datasheet_A0.pdf | VERALTET (Ref-Block Schaltplan Rev A/B-Entwurf; gueltig ist Block Rev C 2026-11-08, W-7): Schaltplan Rev A, Wert RGB 1615, 1 Stk; JLC-Abfrage 2026-11-07: expand, Lager 74324, 0.0131 USD @1"
R1 R9 R10 R11 R12 | R 100 kOhm 1 % 0402 | UNI-ROYAL | 0402WGF1003TCE | C25741 | Basic | Resistor_SMD:R_0402_1005Metric | siehe INDEX (bestehender Eintrag) | - | 2026-11-07 | docs/datasheets/UNI-ROYAL_0402WGF-Serie_Datasheet_LCSC-2024-11.pdf | VERALTET (Ref-Block Schaltplan Rev A/B-Entwurf; gueltig ist Block Rev C 2026-11-08, W-7): Schaltplan Rev A, Wert 100k, 5 Stk; JLC-Abfrage 2026-11-07: base, Lager 8800911, 0.0012 USD @1"
R2 | R 0 Ohm 0402 | UNI-ROYAL | 0402WGF0000TCE | C17168 | Basic | Resistor_SMD:R_0402_1005Metric | siehe INDEX (bestehender Eintrag) | - | 2026-11-07 | docs/datasheets/UNI-ROYAL_0402WGF-Serie_Datasheet_LCSC-2024-11.pdf | VERALTET (Ref-Block Schaltplan Rev A/B-Entwurf; gueltig ist Block Rev C 2026-11-08, W-7): Schaltplan Rev A, Wert 0R, 1 Stk; JLC-Abfrage 2026-11-07: base, Lager 17052344, 0.0012 USD @1"
R3 R4 R5 | R 4.7 kOhm 1 % 0402 | UNI-ROYAL | 0402WGF4701TCE | C25900 | Basic | Resistor_SMD:R_0402_1005Metric | siehe INDEX (bestehender Eintrag) | - | 2026-11-07 | docs/datasheets/UNI-ROYAL_0402WGF-Serie_Datasheet_LCSC-2024-11.pdf | VERALTET (Ref-Block Schaltplan Rev A/B-Entwurf; gueltig ist Block Rev C 2026-11-08, W-7): Schaltplan Rev A, Wert 4.7k, 3 Stk; JLC-Abfrage 2026-11-07: base, Lager 15773138, 0.0017 USD @1"
R6 | R 470 Ohm 1 % 0402 | UNI-ROYAL | 0402WGF4700TCE | C25117 | Basic | Resistor_SMD:R_0402_1005Metric | siehe INDEX (bestehender Eintrag) | - | 2026-11-07 | docs/datasheets/UNI-ROYAL_0402WGF-Serie_Datasheet_LCSC-2024-11.pdf | VERALTET (Ref-Block Schaltplan Rev A/B-Entwurf; gueltig ist Block Rev C 2026-11-08, W-7): Schaltplan Rev A, Wert 470, 1 Stk; JLC-Abfrage 2026-11-07: base, Lager 3053499, 0.001 USD @1"
R8 | R 100 Ohm 1 % 0402 | UNI-ROYAL | 0402WGF1000TCE | C25076 | Basic | Resistor_SMD:R_0402_1005Metric | siehe INDEX (bestehender Eintrag) | - | 2026-11-07 | docs/datasheets/UNI-ROYAL_0402WGF-Serie_Datasheet_LCSC-2024-11.pdf | VERALTET (Ref-Block Schaltplan Rev A/B-Entwurf; gueltig ist Block Rev C 2026-11-08, W-7): Schaltplan Rev A, Wert 100, 1 Stk; JLC-Abfrage 2026-11-07: base, Lager 11747227, 0.0012 USD @1"
Y2 | Quarz 32.768 kHz 9 pF FC-135 | Seiko Epson | Q13FC13500003 | C99010 | Extended | Crystal:Crystal_SMD_3215-2Pin_3.2x1.5mm | siehe INDEX (bestehender Eintrag) | - | 2026-11-07 | docs/datasheets/Epson_Q13FC13500003_Datasheet_LCSC-2018-10.pdf | VERALTET (Ref-Block Schaltplan Rev A/B-Entwurf; gueltig ist Block Rev C 2026-11-08, W-7): Schaltplan Rev A, Wert 32.768kHz 9pF, 1 Stk; JLC-Abfrage 2026-11-07: expand, Lager 33668, 0.2038 USD @1"
MECH-OR1 | O-Ring Sensor (Zapfen + Kragen, 2 Stk), Normmass | Norm SAE AS568 / ISO 3601-1 Kl. A (Hersteller offen) | AS568-017 (ID 17.17 x CS 1.78 mm), Silikon oder EPDM ohne Russ | - | n/a (Zukauf) | - | G.T. Weed AS568 Standard O-Ring Sizing (2026-08) | https://www.gtweed.com/wp-content/uploads/AS568-standard-o-ring-sizing.pdf | 2026-11-07 | docs/references/GTWeed_AS568_StandardOringSizing.pdf | Masstabelle S. 2 (Dash -017: CS 0.070+-0.003 in, ID 0.676+-0.009 in), Werkstoffdatenblatt des gewaehlten Lieferanten (Shore A, Temperatur, ohne Russ) noch offen
MECH-SCR1 | Schraube unverlierbar Huelse | Norm ISO 7045 (Hersteller offen) | M2 x 4 A2 Linsenkopf PH1 | - | n/a (Zukauf) | - | - | - | 2026-11-07 | - | Nennmasse (Kopf Ø3.8 x 1.3) ANNAHME bis Lieferantenzeichnung
MECH-NUT1 | Mutter im Kragen eingegossen | Norm ISO 4032 (Hersteller offen) | M2 A2 SW4 x 1.6 | - | n/a (Zukauf) | - | - | - | 2026-11-07 | - | Nennmasse ANNAHME bis Lieferantenzeichnung
MECH-MEM1 | Tastenmembran Sensor | offen | Silikonplatte 0.5 mm, Ø6.4 gestanzt | - | n/a (Zukauf) | - | - | - | 2026-11-07 | - | Shore A 40-60 ANNAHME, PROTOTYP-PRUEFUNG Betaetigungskraft
MAT-ASA | Gehaeusewerkstoff Sensor/Gateway | Bambu Lab | Bambu ASA | - | n/a | Filament 1.75 mm | Technical Data Sheet V2.0 | https://www.additive-x.com/shop/mpattachments/file/viewonline/id/612/product_id/2399 | 2026-11-07 | docs/references/BambuLab_ASA_TechnicalDataSheet_V2.0.pdf | HDT 92 C (ISO 75 1.8 MPa) / 100 C (0.45 MPa), Vicat 106 C, E 2450 MPa XY, Kopie eines Haendlers (nicht von bambulab.com)
MAT-FR4 | Leiterplatten-Basismaterial (Referenzwerte FEM) | Kingboard | KB-6160A (FR-4, Tg 135, IPC-4101E/21) | - | n/a | - | Technical Information (ohne Rev.) | https://www.intectiv.si/wp-content/uploads/2023/08/Technical-data-sheet-KB-6160A-min.pdf | 2026-11-07 | docs/references/Kingboard_KB-6160A_TechnicalInformation.pdf | Biegefestigkeit laengs >=415 / typ. 565 MPa, quer >=345 / typ. 446 MPa (IPC-TM-650 2.4.4), E-Modul nicht angegeben, JLC-Laminat = ANNAHME
SW1 (Kandidat Rev B) | Taster SMD 3.9 x 3.0 mm, H 2.0 mm (Flaechenreduktion Elektronikband) | XUNPU | TS-1088-AR02016 | C720477 | Basic | SMD 4x3 mm, KiCad Button_Switch_SMD:SW_SPST_TS-1088-xR020 | LCSC-Kopie Rev A (2022-06) | https://www.lcsc.com/datasheet/lcsc_datasheet_2304140030_XUNPU-TS-1088-AR02016_C720477.pdf (via JLC dataManualFileAccessIdUrl) | 2026-11-07 | docs/datasheets/XUNPU_TS-1088-AR02016_Datasheet_LCSC-2022-06.pdf | S.1: Koerper 3.90 x 3.00, mit Anschluessen 5.00, Hoehe H 2.0 (Code 020), Betaetiger Oe 1.80, Hub 0.2 +-0.1 mm, Kraft 160 gf (Code 16), Lotpads 2 x (2.0 x 1.05) Mittenabstand 4.45 / aussen 5.50; JLC Basic, Lager 748832, 0.0527 USD @1 (JLC-API 2026-11-07); Kandidat laut hardware/sensor/out/FLOORPLAN_OPTIONS.md
U3 (Kandidat Rev B) | Temperatursensor I2C SOT-563 (Flaechenreduktion Elektronikband) | Texas Instruments | TMP1075NDRLR | C3663690 | Extended | SOT-563 1.6 x 1.6 mm | SBOS854F (2024-06) | https://www.ti.com/lit/ds/symlink/tmp1075.pdf | 2026-11-07 | docs/datasheets/TI_TMP1075_Datasheet_SBOS854F.pdf | TMP1075N: V+ 1.62-3.6 V (S.5 Tab. 6.3), abs. max 4 V (S.5 Tab. 6.1), +-1 C -10..60 C (S.3 Tab. 4-1, S.7 Tab. 6.6), tCONV max 15 ms, One-Shot vorhanden (Kap. 7.4.2), Pinout DRL Abb. 5-4/Tab. 5-1: SCL 1, GND 2, ALERT 3, A0 4, V+ 5, SDA 6; A0 = GND -> 0x48 (Tab. 7-3); nicht leadless; JLC Extended, Lager 20063, 0.5414 USD @1 / 0.4563 @10 (JLC-API 2026-11-07)
GW-SBC1-MD | Gateway Pi Zero 2 W, Masszeichnung (Gehaeuse G1 v4) | Raspberry Pi Ltd | Raspberry Pi Zero 2 W |  | n/a (Fertigboard) | 65 x 30 mm, 4 Bohrungen 3.5 mm vom Rand (Raster 58 x 23) | RP-008358-DS-1 (2021-10-28) | https://pip.raspberrypi.com/documents/RP-008358-DS | 2026-11-07 | docs/datasheets/RaspberryPi_Zero2W_MechanicalDrawing_RP-008358-DS-1.pdf | identisch mit Abb. S. 4 im Product Brief 2024-04; nur Draufsicht: Umriss 65 x 30, Bohrungslage, Header (29 ab Bohrung), Mitten Mini-HDMI 12.4 / USB-OTG 41.4 / USB-PWR 54; KEINE Hoehen, KEIN Bohrungsdurchmesser, KEINE Lage ACT-LED/Antenne
GW-SBC1-SCH | Gateway Pi Zero 2 W, reduzierter Schaltplan | Raspberry Pi Ltd | Raspberry Pi Zero 2 W |  | n/a (Fertigboard) | - | RP-008360-DS-1 | https://pip.raspberrypi.com/documents/RP-008360-DS | 2026-11-07 | docs/datasheets/RaspberryPi_Zero2W_ReducedSchematics_RP-008360-DS-1.pdf | enthaelt Netz STATUS_LED / Bezeichnung STATUS ACT LED (keine Lageangabe)
U-DIV (Var. C/D3) | D-Flipflop als Teiler /2 je Stufe (Vorteiler vor Timer DIO24) | Texas Instruments | SN74LVC1G80DCKR | C473331 | Extended | SOT-353_SC-70-5 (DCK) | SCES221T (2026-08) | https://www.ti.com/lit/ds/symlink/sn74lvc1g80.pdf | 2026-11-07 | docs/datasheets/TI_SN74LVC1G80_Datasheet_SCES221T.pdf | fclock max 160 MHz bei 1.8-5.5 V (S.6 Tab. 5.6), tw >= 2.5 ns; tpd CLK->Q 1.3-4.2 ns @3.3 V (S.7 Tab. 5.8); Cpd 25 pF @3.3 V (S.8 Tab. 5.11); Ausgang Q invertiert (S.13 Tab. 7-1) -> Toggle mit D an Q; Pins D1 CLK2 GND3 Q4 VCC5 (S.3); ICC max 10 uA (S.6) -> geschaltet versorgen; JLC 2026-11-07 Lager 8059, 0.211 USD @1 / 0.169 @50; Entscheidungsvorlage docs/concepts/MESSKETTE_SALZ.md
U-OSC-HF (Var. C) | Unbuffered Inverter fuer Pierce-LC-Oszillator 70-100 MHz | Texas Instruments | SN74LVC1GU04DCKR | C485082 | Extended | SOT-353_SC-70-5 (DCK) | SCES215Y (2017-12) | https://www.ti.com/lit/ds/symlink/sn74lvc1gu04.pdf | 2026-11-07 | docs/datasheets/TI_SN74LVC1GU04_Datasheet_SCES215Y.pdf | tpd 1.1-3.7 ns @3.3 V, 1-4 ns @2.5 V (S.7 Tab. 6.6); Cpd 13 pF @3.3 V (S.7 Tab. 6.8); Oszillator-Anwendung S.11 (ohne Werte); Querstrom im linearen Arbeitspunkt nicht spezifiziert; JLC 2026-11-07 Lager 3895, 0.101 USD @1 / 0.0818 @50; nur Variante C (nicht empfohlen)
L-OSC-HF (Var. C) | Tankspule 220 nH 0402 fuer LC-Oszillator | Sunlord | SDCL1005CR22JTDF | C18834 | Extended | Inductor_SMD:L_0402_1005Metric | LCSC-Kopie Serie SDCL1005 (Revised 2023/06/01) | https://www.lcsc.com/datasheet/lcsc_datasheet_2310301641_Sunlord-SDCL1005CR22JTDF_C18834.pdf | 2026-11-07 | docs/datasheets/Sunlord_SDCL1005-Serie_Datasheet_LCSC-2023-10.pdf | bestehende Seriendatei (Bilddatei, kein Text): S.2 SDCL1005-D: 220 nH, Q min 8 / typ 12 @100 MHz, SRF >= 450 MHz, DCR max 4.0 Ohm, Ir 100 mA; JLC 2026-11-07 Lager 17641, 0.0136 USD @1; nur Variante C
U-SW (Var. B2) | Analogschalter zum Umschalten des Oszillator-R | Texas Instruments | SN74LVC1G66DCKR | C113518 | Extended | SOT-353_SC-70-5 (DCK) | SCES323R (2025-09) | https://www.ti.com/lit/ds/symlink/sn74lvc1g66.pdf | 2026-11-07 | docs/datasheets/TI_SN74LVC1G66_Datasheet_SCES323R.pdf | ron typ 7.5 / max 15 Ohm @3 V, Peak 11.5/25 Ohm (S.7 Tab. 5.5); Cio(off) 6 pF, Cio(on) 13-15 pF @5 V (S.7); Steuereingang braucht einen GPIO (DIO11 statt Cref2); JLC 2026-11-07 Lager 68645, 0.1602 USD @1 / 0.127 @50; nur Variante B2 (nicht empfohlen)
GW-CLIM1 | Raumklima-Sensor im Gateway (D-017), I2C an Pi-GPIO | Sensirion | SHT4x (SHT40/41/45, Breakout) |  | n/a (Breakout-Modul, Typ offen) | DFN 1.5x1.5 (auf Breakout) | Version 7.3 (Juni 2026) | https://sensirion.com/media/documents/33FD6951/6A7C10A0/HT_DS_Datasheet_SHT4x_V7.3.pdf | 2026-11-07 | docs/datasheets/Sensirion_SHT4x_Datasheet_V7.3.pdf | Treiber firmware/gateway/fluidi_gw/climate.py: Adresse 0x44 (S. 1), Befehl 0xFD 6 Byte (S. 12 Tab. 8), tMEAS,h max 8.3 ms (S. 10), CRC-8 Poly 0x31 Init 0xFF (S. 11 Tab. 7), Umrechnung (S. 12 Formel 1/2), VDD 1.08-3.6 V (S. 9) -> 3V3 vom Pi, konkretes Breakout-Modul noch nicht gewaehlt
MECH-OR1 (Rev B) | O-Ring Sensor (Zapfen + Kragen, 2 Stk), Normmass, ersetzt AS568-017 (Kopf V4 34 mm) | Norm SAE AS568 / ISO 3601-1 Kl. A (Hersteller offen) | AS568-019 (ID 20.35 x CS 1.78 mm), Silikon oder EPDM ohne Russ | - | n/a (Zukauf) | - | G.T. Weed AS568 Standard O-Ring Sizing (2026-08) | https://www.gtweed.com/wp-content/uploads/AS568-standard-o-ring-sizing.pdf | 2026-11-07 | docs/references/GTWeed_AS568_StandardOringSizing.pdf | Masstabelle S. 2 (Dash -019: CS 0.070+-0.003 in, ID 0.801+-0.009 in); Nutgrund-Eckradius 3.0 -> Dehnung 2.1 % (mechanical/sensor/check_sensor.txt Pkt. 7); Werkstoffdatenblatt Lieferant offen
EP-K (Rev B) | Vergussmasse Kragen + Schott + Kantenversiegelung Sonde (Epoxid 2K, Tg >= 80 C) - VORSCHLAG Phase 6, Freigabe offen | Electrolube (MacDermid Alpha) | ER2223 Resin Pack 250 g (EER2223RP250G) | - | n/a (Zukauf) | Beutel 250 g (A+B vordosiert 3.45:1) | TDS Revision 4 (Mar 2019) | https://www.simpex.ch/wp-content/uploads/2026/07/TDS-ER2223-Epoxid-Vergussmasse-250g.pdf | 2026-11-08 | docs/references/Electrolube_ER2223_TDS_Rev4-2019-03.pdf | S.1: 800 mPa s gemischt, Topfzeit 30 min, Gelzeit 90 min, 24 h @23 C / 4 h @60 C; S.2: Tg 140 C (Haertebedingung nicht angegeben), CTE 70 ppm, Wasser < 0.25 %, ungefuellt (ANNAHME aus Dichte 1.10 g/ml und SDB A Abschn. 3) -> Abweichung K-4 gefuellt, Sicherheit kein Veto unter A-1..A-5 (docs/reviews/phase6_vergussmasse_sicherheit.md). Neuere TDS-Fassung 09Aug23 (MacDermid Alpha) nicht abrufbar (404) -> anfordern. SDB siehe REF-VG2..4. Bezug Simpex CH CHF 38.20 exkl. MWST, Lieferzeit 8 Wochen (2026-11-08); Distrelec CH 301-16-965. Konzept docs/concepts/vergussmasse_versiegelung.md
R3 | R 1 kOhm 1 % 0402 | UNI-ROYAL | 0402WGF1001TCE | C11702 | Basic | Resistor_SMD:R_0402_1005Metric | siehe INDEX (bestehender Eintrag) | - | 2026-11-07 | docs/datasheets/UNI-ROYAL_0402WGF-Serie_Datasheet_LCSC-2024-11.pdf | VERALTET (Ref-Block Schaltplan Rev A/B-Entwurf; gueltig ist Block Rev C 2026-11-08, W-7): Schaltplan Rev B, Wert 1k, 1 Stk; JLC-Abfrage 2026-11-07: base, Lager 33764059, 0.0013 USD @1"
BT1 | Halter CR2032 SMT (Zelle Panasonic CR2032 lokal) | Keystone | 3034TR | C5213768 | Extended | fluidi:BatteryHolder_Keystone_3034_1x20mm_NegPad4mm_W23p1 | siehe Datenblatt (lokaler Pfad) | - | 2026-11-08 | docs/datasheets/Keystone_3034_Catalog_M65.pdf | REV C (BOM fluidi_sensor_bom_jlc.csv 2026-11-08): Schaltplan/Layout Rev C, Wert CR2032 / Keystone 3034TR, 1 Stk; JLC-Abfrage 2026-11-07: expand, Lager 654, 0.3909 USD @1"
C1 C2 C3 C4 | MLCC 100 uF 6.3 V X5R 1206 | Samsung Electro-Mechanics | CL31A107MQHNNNE | C15008 | Basic | Capacitor_SMD:C_1206_3216Metric | siehe Datenblatt (lokaler Pfad) | - | 2026-11-08 | docs/datasheets/Samsung_CL31A107MQHNNNE_Catalog_2015-11.pdf | REV C (BOM fluidi_sensor_bom_jlc.csv 2026-11-08): Schaltplan/Layout Rev C, Wert 100uF, 4 Stk; JLC-Abfrage 2026-11-07: base, Lager 1598455, 0.109 USD @1"
C5 C9 | MLCC 10 uF 6.3 V X5R 0402 | Samsung Electro-Mechanics | CL05A106MQ5NUNC | C15525 | Basic | Capacitor_SMD:C_0402_1005Metric | siehe Datenblatt (lokaler Pfad) | - | 2026-11-08 | docs/datasheets/Samsung_CL05A106MQ5NUNC_Datasheet_LCSC-2022-08.pdf | REV C (BOM fluidi_sensor_bom_jlc.csv 2026-11-08): Schaltplan/Layout Rev C, Wert 10uF, 2 Stk; JLC-Abfrage 2026-11-07: base, Lager 9181150, 0.0257 USD @1"
C6 C7 C8 C10 C11 C13 C21 C24 C25 | MLCC 100 nF 16 V X7R 0402 | Samsung Electro-Mechanics | CL05B104KO5NNNC | C1525 | Basic | Capacitor_SMD:C_0402_1005Metric | siehe Datenblatt (lokaler Pfad) | - | 2026-11-08 | docs/datasheets/Samsung_CL05-Serie_Datasheet_LCSC-2023-04.pdf | REV C (BOM fluidi_sensor_bom_jlc.csv 2026-11-08): Schaltplan/Layout Rev C, Wert 100nF, 9 Stk; JLC-Abfrage 2026-11-07: base, Lager 34323477, 0.0031 USD @1"
C12 | MLCC 1 uF 25 V X5R 0402 | Samsung Electro-Mechanics | CL05A105KA5NQNC | C52923 | Basic | Capacitor_SMD:C_0402_1005Metric | siehe Datenblatt (lokaler Pfad) | - | 2026-11-08 | docs/datasheets/Samsung_CL05-Serie_Datasheet_LCSC-2023-04.pdf | REV C (BOM fluidi_sensor_bom_jlc.csv 2026-11-08): Schaltplan/Layout Rev C, Wert 1uF, 1 Stk; JLC-Abfrage 2026-11-07: base, Lager 11554661, 0.0058 USD @1"
C14 C15 C18 | MLCC 15 pF C0G 0402 | FH (Fenghua) | 0402CG150J500NT | C1548 | Basic | Capacitor_SMD:C_0402_1005Metric | siehe Datenblatt (lokaler Pfad) | - | 2026-11-08 | docs/datasheets/FH_0402CG-Serie_Datasheet_LCSC-2023-04.pdf | REV C (BOM fluidi_sensor_bom_jlc.csv 2026-11-08): Schaltplan/Layout Rev C, Wert 15pF, 3 Stk; JLC-Abfrage 2026-11-07: base, Lager 1205885, 0.0026 USD @1"
C16 C17 | MLCC 1.5 pF C0G 0402 | FH (Fenghua) | 0402CG1R5C500NT | C1552 | Preferred | Capacitor_SMD:C_0402_1005Metric | siehe Datenblatt (lokaler Pfad) | - | 2026-11-08 | docs/datasheets/FH_0402CG-Serie_Datasheet_LCSC-2023-04.pdf | REV C (BOM fluidi_sensor_bom_jlc.csv 2026-11-08): Schaltplan/Layout Rev C, Wert 1.5pF, 2 Stk; JLC-Abfrage 2026-11-07: expand preferred, Lager 170449, 0.0045 USD @1"
C22 | MLCC 22 pF C0G 0402 | FH (Fenghua) | 0402CG220J500NT | C1555 | Basic | Capacitor_SMD:C_0402_1005Metric | siehe Datenblatt (lokaler Pfad) | - | 2026-11-08 | docs/datasheets/FH_0402CG-Serie_Datasheet_LCSC-2023-04.pdf | REV C (BOM fluidi_sensor_bom_jlc.csv 2026-11-08): Schaltplan/Layout Rev C, Wert 22pF, 1 Stk; JLC-Abfrage 2026-11-07: base, Lager 1709165, 0.0019 USD @1"
D1 | RGB-LED 1615 gem. Anode | TUOZHAN | P4-1615G2B2R4TS2-06T-001-24 | C7496855 | Extended | fluidi:LED_RGB_TUOZHAN_1615 | siehe Datenblatt (lokaler Pfad) | - | 2026-11-08 | docs/datasheets/TUOZHAN_P4-1615G2B2R4TS2-06T-001-24_Datasheet_A0.pdf | REV C (BOM fluidi_sensor_bom_jlc.csv 2026-11-08): Schaltplan/Layout Rev C, Wert RGB 1615, 1 Stk; JLC-Abfrage 2026-11-07: expand, Lager 74324, 0.0131 USD @1"
L1 | Leistungsspule 10 uH 2016 | Sunlord | WPN201610H100MT | C89132 | Extended | fluidi:L_Sunlord_WPN201610H | siehe Datenblatt (lokaler Pfad) | - | 2026-11-08 | docs/datasheets/Sunlord_WPN201610H100MT_Datasheet_LCSC-2023-10.pdf | REV C (BOM fluidi_sensor_bom_jlc.csv 2026-11-08): Schaltplan/Layout Rev C, Wert 10uH, 1 Stk; JLC-Abfrage 2026-11-07: expand, Lager 4839, 0.0418 USD @1"
L2 | HF-Spule 2.7 nH 0402 | Sunlord | SDCL1005C2N7STDF | C27123 | Extended | Inductor_SMD:L_0402_1005Metric | siehe Datenblatt (lokaler Pfad) | - | 2026-11-08 | docs/datasheets/Sunlord_SDCL1005-Serie_Datasheet_LCSC-2023-10.pdf | REV C (BOM fluidi_sensor_bom_jlc.csv 2026-11-08): Schaltplan/Layout Rev C, Wert 2.7nH, 1 Stk; JLC-Abfrage 2026-11-07: expand, Lager 110791, 0.0031 USD @1"
Q1 Q2 | P-MOSFET SOT-23 | Alpha & Omega | AO3401A | C15127 | Basic | Package_TO_SOT_SMD:SOT-23 | siehe Datenblatt (lokaler Pfad) | - | 2026-11-08 | docs/datasheets/AOS_AO3401A_Datasheet_Rev3.1.pdf | REV C (BOM fluidi_sensor_bom_jlc.csv 2026-11-08): Schaltplan/Layout Rev C, Wert AO3401A, 2 Stk; JLC-Abfrage 2026-11-07: base, Lager 1677347, 0.0828 USD @1"
R1 R9 R10 R11 R12 R13 | R 100 kOhm 1 % 0402 | UNI-ROYAL | 0402WGF1003TCE | C25741 | Basic | Resistor_SMD:R_0402_1005Metric | siehe Datenblatt (lokaler Pfad) | - | 2026-11-08 | docs/datasheets/UNI-ROYAL_0402WGF-Serie_Datasheet_LCSC-2024-11.pdf | REV C (BOM fluidi_sensor_bom_jlc.csv 2026-11-08): Schaltplan/Layout Rev C, Wert 100k, 6 Stk; JLC-Abfrage 2026-11-07: base, Lager 8786264, 0.0012 USD @1"
R2 | R 0 Ohm 0402 | UNI-ROYAL | 0402WGF0000TCE | C17168 | Basic | Resistor_SMD:R_0402_1005Metric | siehe Datenblatt (lokaler Pfad) | - | 2026-11-08 | docs/datasheets/UNI-ROYAL_0402WGF-Serie_Datasheet_LCSC-2024-11.pdf | REV C (BOM fluidi_sensor_bom_jlc.csv 2026-11-08): Schaltplan/Layout Rev C, Wert 0R, 1 Stk; JLC-Abfrage 2026-11-07: base, Lager 17023892, 0.0012 USD @1"
R3 | R 1 kOhm 1 % 0402 | UNI-ROYAL | 0402WGF1001TCE | C11702 | Basic | Resistor_SMD:R_0402_1005Metric | siehe Datenblatt (lokaler Pfad) | - | 2026-11-08 | docs/datasheets/UNI-ROYAL_0402WGF-Serie_Datasheet_LCSC-2024-11.pdf | REV C (BOM fluidi_sensor_bom_jlc.csv 2026-11-08): Schaltplan/Layout Rev C, Wert 1k, 1 Stk; JLC-Abfrage 2026-11-07: base, Lager 33764059, 0.0013 USD @1"
R4 R5 | R 4.7 kOhm 1 % 0402 | UNI-ROYAL | 0402WGF4701TCE | C25900 | Basic | Resistor_SMD:R_0402_1005Metric | siehe Datenblatt (lokaler Pfad) | - | 2026-11-08 | docs/datasheets/UNI-ROYAL_0402WGF-Serie_Datasheet_LCSC-2024-11.pdf | REV C (BOM fluidi_sensor_bom_jlc.csv 2026-11-08): Schaltplan/Layout Rev C, Wert 4.7k, 2 Stk; JLC-Abfrage 2026-11-07: base, Lager 15759306, 0.0017 USD @1"
R6 | R 470 Ohm 1 % 0402 | UNI-ROYAL | 0402WGF4700TCE | C25117 | Basic | Resistor_SMD:R_0402_1005Metric | siehe Datenblatt (lokaler Pfad) | - | 2026-11-08 | docs/datasheets/UNI-ROYAL_0402WGF-Serie_Datasheet_LCSC-2024-11.pdf | REV C (BOM fluidi_sensor_bom_jlc.csv 2026-11-08): Schaltplan/Layout Rev C, Wert 470, 1 Stk; JLC-Abfrage 2026-11-07: base, Lager 3010858, 0.001 USD @1"
R7 | R 200 Ohm 1 % 0402 | UNI-ROYAL | 0402WGF2000TCE | C25087 | Basic | Resistor_SMD:R_0402_1005Metric | siehe Datenblatt (lokaler Pfad) | - | 2026-11-08 | docs/datasheets/UNI-ROYAL_0402WGF-Serie_Datasheet_LCSC-2024-11.pdf | REV C (BOM fluidi_sensor_bom_jlc.csv 2026-11-08): Schaltplan/Layout Rev C, Wert 200, 1 Stk; JLC-Abfrage 2026-11-07: base, Lager 1751217, 0.0029 USD @1"
R8 | R 100 Ohm 1 % 0402 | UNI-ROYAL | 0402WGF1000TCE | C25076 | Basic | Resistor_SMD:R_0402_1005Metric | siehe Datenblatt (lokaler Pfad) | - | 2026-11-08 | docs/datasheets/UNI-ROYAL_0402WGF-Serie_Datasheet_LCSC-2024-11.pdf | REV C (BOM fluidi_sensor_bom_jlc.csv 2026-11-08): Schaltplan/Layout Rev C, Wert 100, 1 Stk; JLC-Abfrage 2026-11-07: base, Lager 11744898, 0.0012 USD @1"
SW1 | Taster SMD 3.9x3.0x2.0 | XUNPU | TS-1088-AR02016 | C720477 | Basic | Button_Switch_SMD:SW_SPST_TS-1088-xR020 | siehe Datenblatt (lokaler Pfad) | - | 2026-11-08 | docs/datasheets/XUNPU_TS-1088-AR02016_Datasheet_LCSC-2022-06.pdf | REV C (BOM fluidi_sensor_bom_jlc.csv 2026-11-08): Schaltplan/Layout Rev C, Wert TS-1088, 1 Stk; JLC-Abfrage 2026-11-07: base, Lager 744577, 0.0527 USD @1"
U1 | BLE-SoC 512 kB, VQFN-24 4x4 | Texas Instruments | CC2340R52E0RGER | C20416850 | Extended | Package_DFN_QFN:VQFN-24-1EP_4x4mm_P0.5mm_EP2.45x2.45mm | siehe Datenblatt (lokaler Pfad) | - | 2026-11-08 | docs/datasheets/TI_CC2340R5_Datasheet_SWRS272F.pdf | REV C (BOM fluidi_sensor_bom_jlc.csv 2026-11-08): Schaltplan/Layout Rev C, Wert CC2340R52E0RGER, 1 Stk; JLC-Abfrage 2026-11-07: expand, Lager 9278, 1.4703 USD @1"
U2 | Schmitt-Inverter SC-70-5 | Texas Instruments | SN74LVC1G14DCKR | C35740 | Extended | Package_TO_SOT_SMD:SOT-353_SC-70-5 | siehe Datenblatt (lokaler Pfad) | - | 2026-11-08 | docs/datasheets/TI_SN74LVC1G14_Datasheet_SCES218AA.pdf | REV C (BOM fluidi_sensor_bom_jlc.csv 2026-11-08): Schaltplan/Layout Rev C, Wert SN74LVC1G14DCKR, 1 Stk; JLC-Abfrage 2026-11-07: expand, Lager 98060, 0.0566 USD @1"
U3 | Temperatursensor I2C SOT-563 (TMP1075N, 1.62-3.6 V) | Texas Instruments | TMP1075NDRLR | C3663690 | Extended | fluidi:SOT-563_TI_DRL0006A | siehe Datenblatt (lokaler Pfad) | - | 2026-11-08 | docs/datasheets/TI_TMP1075_Datasheet_SBOS854F.pdf | REV C (BOM fluidi_sensor_bom_jlc.csv 2026-11-08): Schaltplan/Layout Rev C, Wert TMP1075NDRLR, 1 Stk; JLC-Abfrage 2026-11-07: expand, Lager 20063, 0.5414 USD @1"
U4 U5 U6 | D-Flipflop Q invertiert SC-70-5 (Teiler /2) | Texas Instruments | SN74LVC1G80DCKR | C473331 | Extended | Package_TO_SOT_SMD:SOT-353_SC-70-5 | siehe Datenblatt (lokaler Pfad) | - | 2026-11-08 | docs/datasheets/TI_SN74LVC1G80_Datasheet_SCES221T.pdf | REV C (BOM fluidi_sensor_bom_jlc.csv 2026-11-08): Schaltplan/Layout Rev C, Wert SN74LVC1G80DCKR, 3 Stk; JLC-Abfrage 2026-11-07: expand, Lager 8059, 0.211 USD @1"
Y1 | Quarz 48 MHz 8 pF 3225 | HCI (Suzhou HangJing) | XC32M4-48.000-F08NLDT | C2925606 | Extended | Crystal:Crystal_SMD_3225-4Pin_3.2x2.5mm | siehe Datenblatt (lokaler Pfad) | - | 2026-11-08 | docs/datasheets/HCI_XC32M4-48.000-F08NLDT_Datasheet_LCSC-2022-05.pdf | REV C (BOM fluidi_sensor_bom_jlc.csv 2026-11-08): Schaltplan/Layout Rev C, Wert 48MHz 8pF, 1 Stk; JLC-Abfrage 2026-11-07: expand, Lager 8817, 0.0992 USD @1"
Y2 | Quarz 32.768 kHz 9 pF FC-135 | Seiko Epson | Q13FC13500003 | C99010 | Extended | Crystal:Crystal_SMD_3215-2Pin_3.2x1.5mm | siehe Datenblatt (lokaler Pfad) | - | 2026-11-08 | docs/datasheets/Epson_Q13FC13500003_Datasheet_LCSC-2018-10.pdf | REV C (BOM fluidi_sensor_bom_jlc.csv 2026-11-08): Schaltplan/Layout Rev C, Wert 32.768kHz 9pF, 1 Stk; JLC-Abfrage 2026-11-07: expand, Lager 33668, 0.2038 USD @1"
P-U1 (Programmieradapter) | LDO 3.3 V Vorstufe (Einzelfehler <= 3.3 V am Sensor) | Torex | XC6206P332MR-G | C5446 | Basic | SOT-23 (1 VSS, 2 VOUT, 3 VIN) | ETR0305_004b | https://www.lcsc.com/datasheet/lcsc_datasheet_2304140030_Torex-Semicon-XC6206P332MR-G_C5446.pdf | 2026-11-08 | docs/datasheets/Torex_XC6206_Datasheet_ETR0305-004b.pdf | Werkzeug hardware/programmer (nicht auf Sensor-PCB); Pins S. 2, IOUTMAX 200 mA (S. 1), VIN max 6.0 V (S. 4); JLC 2026-11-08: Lager 492937, 0.1477 USD @1
P-U2 P-U3 (Programmieradapter) | LDO 2.0 V fuer Dummy-Zelle (U2) und CH343-VIO (U3) | Torex | XC6206P202MR-G | C2891260 | Extended | SOT-23 (1 VSS, 2 VOUT, 3 VIN) | ETR0305_004b (Seriendatenblatt 1.2-5.0 V) | https://wmsc.lcsc.com/wmsc/upload/file/pdf/v2/lcsc/2109092030_Torex-Semicon-XC6206P202MR-G_C2891260.pdf | 2026-11-08 | docs/datasheets/Torex_XC6206_Datasheet_ETR0305-004b.pdf | Werkzeug; 1.960-2.040 V (S. 5 Tab. E-1), Ishort typ 130 mA (E-6), CIN = CL = 1 uF Keramik (S. 1); LCSC-Einzeldatenblatt nicht ladbar (Bot-Pruefung), lokales Torex-Seriendatenblatt deckt 2.0 V ab; JLC 2026-11-08: Lager 1963, 0.2143 USD @1
P-U4 (Programmieradapter) | Schmitt-Puffer TX (Sensor -> CH343-RXD), am Federstiftkopf | Texas Instruments | SN74AUP1G17DBVR | C183012 | Extended | SOT-23-5 DBV (1 NC, 2 A, 3 GND, 4 Y, 5 VCC) | SCES579J (2017-09) | https://www.ti.com/lit/ds/symlink/sn74aup1g17.pdf | 2026-11-08 | docs/datasheets/TI_SN74AUP1G17_Datasheet_SCES579J.pdf | Werkzeug; Pins S. 3; VT+/VT- S. 5, II 0.1 uA (25 degC) / 0.5 uA (-40..85 degC) S. 7, Ci 1.5 pF; JLC 2026-11-08: Lager 1280, 0.3132 USD @1
P-U4 (verworfen) | Schmitt-Puffer (Alternative, verworfen) | Texas Instruments | SN74LVC1G17DBVR | C7836 | Extended | SOT-23-5 DBV | SCES351Y (2025-10) | https://www.ti.com/lit/ds/symlink/sn74lvc1g17.pdf | 2026-11-08 | docs/datasheets/TI_SN74LVC1G17_Datasheet_SCES351Y.pdf | verworfen: II bis +-5 uA (S. 6 Tab. 5-1) -> bis 1.0 V ueber 2 x 100 kOhm, kein sicheres Low am Puffer (hardware/programmer/README.md Kap. 2.1)
P-C1..C4 (Programmieradapter) | MLCC 1 uF 50 V X7R 0805 (CIN/CL XC6206) | Samsung Electro-Mechanics | CL21B105KBFNNNE | C28323 | Basic | 0805 | Katalog 2015-11 (Teilenummernsystem) | https://www.lcsc.com/datasheet/lcsc_datasheet_2304140030_Samsung-Electro-Mechanics-CL21B105KBFNNNE_C28323.pdf | 2026-11-08 | docs/datasheets/Samsung_CL31A107MQHNNNE_Catalog_2015-11.pdf | Werkzeug; LCSC-Einzeldatenblatt nicht ladbar (Bot-Pruefung) -> Samsung-MLCC-Katalog (21 = 0805, B = X7R); JLC 2026-11-08: Lager 4300707, 0.028 USD @1
P-C5 (Programmieradapter) | MLCC 100 nF 50 V X7R 0805 (Abblock U4) | Samsung Electro-Mechanics | CL21B104KBCNNNC | C1711 | Extended | 0805 | Katalog 2015-11 (Teilenummernsystem) | https://www.lcsc.com/datasheet/lcsc_datasheet_2304140030_Samsung-Electro-Mechanics-CL21B104KBCNNNC_C1711.pdf | 2026-11-08 | docs/datasheets/Samsung_CL31A107MQHNNNE_Catalog_2015-11.pdf | Werkzeug; wie P-C1; JLC 2026-11-08: Lager 1767446, 0.0137 USD @1
P-R1 (Programmieradapter) | R 10 MOhm 1 % 0402 (Pull-up Puffer-Eingang) | UNI-ROYAL | 0402WGF1005TCE | C26082 | Extended | 0402 | Seriendatenblatt 01005-2512 (LCSC 2024-11) | https://www.lcsc.com/datasheet/lcsc_datasheet_2411221126_UNI-ROYAL-Uniroyal-Elec-0402WGF1005TCE_C26082.pdf | 2026-11-08 | docs/datasheets/UNI-ROYAL_0402WGF-Serie_Datasheet_LCSC-2024-11.pdf | Werkzeug; Kap. 6 Resistance Range: 0402 1 % 1 Ohm-10 MOhm (0805 nur < 10 MOhm); JLC 2026-11-08: Lager 10047, 0.0012 USD @1
P-R2 (Programmieradapter) | R 470 Ohm 1 % 1/8 W 0805 (Entladewiderstand VIO, D-031/PA-6) | UNI-ROYAL | 0805W8F4700T5E | C17710 | Basic | 0805 (Resistor_SMD:R_0805_2012Metric) | Seriendatenblatt 01005-2512 (LCSC 2024-11) | https://www.lcsc.com/datasheet/lcsc_datasheet_2206010200_UNI-ROYAL-Uniroyal-Elec-0805W8F4700T5E_C17710.pdf | 2026-11-09 | docs/datasheets/UNI-ROYAL_0402WGF-Serie_Datasheet_LCSC-2024-11.pdf | JLC-Abfrage 2026-11-09: Basic, Lager 1871834, USD 0.0048. Teiledatenblatt C17710 per Skript nicht ladbar (LCSC liefert HTML statt PDF) -> Seriendatenblatt: S. 2 Teilenummer (W8 = 1/8 W), S. 4 Kap. 6 (0805 1 % 0.1 Ohm bis < 10 MOhm, 1/8 W bei 70 degC), S. 5 (150 V). Last 2.04 V^2/465 Ohm = 8.9 mW
P-J3 (Programmieradapter) | Federkontaktstifte TP1/TP2 | - | nicht festgelegt (Handelsware) | - | n/a (Werkzeug) | - | - | - | 2026-11-08 | - | KEIN Datenblatt lokal: Typ, Federkraft, Hub ANNAHME, Festlegung mit mechanik (hardware/programmer/README.md PA-1)
TOOL-UART1-SCH (Werkzeug) | Schaltplan Waveshare CH343 USB UART Board (H1 +5V/GND/+3.3V, H2 TXD/RXD, H3 VIO-Jumper, RXD-LED 2 kOhm, BAV99) | Waveshare | CH343 USB UART Board (Micro) | - | n/a (Werkzeug) | Fertigboard | undatiert (Abruf 2026-11-08) | https://www.waveshare.com/w/upload/6/68/CH343_USB_UART_Board_sch.pdf | 2026-11-08 | docs/references/Waveshare_CH343-USB-UART-Board_Schematic_2026-11-08.pdf | Grundlage fuer Anschluss J1 und SPICE A0 (RXD-LED); Type-C-Variante kann anders belegt sein
MECH-SCR1 (Rev C) | Schraube unverlierbar Huelse, ersetzt M2x4 (V-K, D-023) | Norm ISO 7045 (Hersteller offen) | M2 x 3 A2 Linsenkopf PH1 | - | n/a (Zukauf) | - | - | - | 2026-11-08 | - | Nennmasse (Kopf 3.8 x 1.3) ANNAHME bis Lieferantenzeichnung; Einschraubtiefe 1.4 mm = 3.5 Gaenge (check_sensor.txt 5c)
GW-LED1 (Gateway, Vorschlag) | Status-LED Gateway gruen 3 mm bedrahtet (Lichtschacht G1 v4) | Kingbright | WP710A10GD | - | n/a (Handloetung, Digi-Key 754-1603-ND) | T-1 3 mm, Bund Ø3.2, Koerper 5.4 lang, RM 2.54 (S. 1) | V.10B (2020-04-18) | https://www.kingbrightusa.com/images/catalog/SPEC/WP710A10GD.pdf | 2026-11-08 | docs/datasheets/Kingbright_WP710A10GD_Datasheet_V10B.pdf | VF typ 2.0 / max 2.4 V @10 mA, IF max 25 mA (S. 2); Iv 10/25 mcd @10 mA (S. 1); Digi-Key CH 0.20 CHF (1 Stk), Lager 24503 (2026-11-08); docs/reviews/phase5_gateway_led.md
GW-R1 (Gateway, Vorschlag) | Vorwiderstand Gateway-LED 470 Ohm 1 % 1/4 W bedrahtet | YAGEO | MFR-25FBF52-470R | - | n/a (Handloetung) | axial 6.3 x 2.4 mm (S. 3) | Product specification V.4 (2024-04-03) | https://yageogroup.com/content/Resource%20Library/Datasheet/YAGEO-MFR_DATASHEET.pdf | 2026-11-08 | docs/datasheets/Yageo_MFR_Datasheet_V4.pdf | Bestellschluessel S. 2 (25=1/4 W, F=1 %, B=Bulk, F=100 ppm, 52-=52.4 mm); 1/4 W @70 C, 250 V (S. 3); Digi-Key CH 0.09 CHF (1 Stk), Lager 19960 (2026-11-08)
GW-SOC-PER (Gateway) | SoC-Peripherie (GPIO-Defaultpull Tab. 6-31) fuer Pi Zero 2 W (RP3A0) | Broadcom | BCM2835 ARM Peripherals | - | n/a (Fertigboard) | - | 2012-02-06 | https://pip.raspberrypi.com/documents/RP-008249-DS | 2026-11-08 | docs/datasheets/Broadcom_BCM2835_ARM-Peripherals_Datasheet_2012-02.pdf | S. 102 Tab. 6-31: GPIO17 Pull Low nach Reset; Raspberry-Pi-Doku verweist fuer alle SoC (inkl. RP3A0) auf diese Tabelle (docs/references/RaspberryPi_GPIO-Doku_Auszug_2026-11-08.txt Z. 361)
GW-GPIO-DOC (Gateway) | Raspberry Pi GPIO-Elektrik (VOH/IOH, ~3 mA je Pin, 16 mA sicher) und Overlay gpio-led | Raspberry Pi Ltd | Dokumentation gpio-on-raspberry-pi / gpio-pad-controls / overlays README | - | n/a | - | master bzw. rpi-6.12.y (2026-11-08) | https://github.com/raspberrypi/documentation | 2026-11-08 | docs/references/RaspberryPi_GPIO-Doku_Auszug_2026-11-08.txt | Textauszug mit sha256 der Quellen; raspberrypi.com selbst nur hinter Cloudflare-Abfrage
GW-CLIM1-BRD2 (Gateway G6, Empfehlung D-029) | SHT40-Breakout Klimakammer Gateway (I2C 0x44, 3.3 V) | DFRobot | Fermion SHT40 Breakout SEN0428 | - | n/a (Fertigmodul) | 14.0 x 17.0 mm, 2 Bohrungen Ø2.0 Raster 10.0, 4 Loetaugen VCC/GND/SCL/SDA (Masszeichnung) | Masszeichnung V0.1 (Siebdruck) / Schaltplan V0.1 (2021-01-27) | https://wiki.dfrobot.com/sen0428/ (Schaltplan https://dfimg.dfrobot.com/wiki/19391/SEN0428_fermion-sht40-temperature-humidity-sensor_schematics_V1.0.pdf, Mass https://img.dfrobot.com.cn/wiki/5d6782b68b3b1513c2f4da54/0fad07c83858bd2dbc012c0c1b630bc7.png) | 2026-11-08 | docs/datasheets/DFRobot_SEN0428_Schematic_V0.1.pdf + docs/datasheets/DFRobot_SEN0428_Dimensions_V0.1.png | Wiki: VCC 3.3-5 V, 14 x 17 mm, M2 Raster 10 mm, Pinout VCC/GND/SCL/SDA. Schaltplan: LDO U2 (VCC->3V, Typ nicht angegeben), Pegelwandler 2 x 2N7002, 10 kOhm Pull-ups beidseitig (VCC- und 3V-Seite), C 100 nF/4.7 uF. BEFUND: Schaltplantitel und U1 lauten SHTC3 (SKU-D008, Schwesterprodukt), nicht SHT40 -> Topologie plausibel, Pinbelegung des Sensors im Plan gilt nicht fuer SHT40 -> PROTOTYP-PRUEFUNG (3V-Schiene, Pull-ups messen, i2cdetect 0x44). Adresse 0x44: DFRobot-Bibliothek DFRobot_SHT/src/DFRobot_SHT40.h Z. 20 (SHT40_AD1B 0x44) und Beispiel nutzt AD1B; Sensirion SHT4x V7.3 S. 21/22. Bauhoehe/Platinendicke NICHT angegeben (Haendler: 0.5 mm, unplausibel) -> am Muster messen. bastelgarage.ch Art. 421989 CHF 11.90 lagernd (2026-11-09)
GW-CLIM1-BRD3 (Gateway, verworfen) | SHT41-Breakout STEMMA QT (Vergleich D-029) | Adafruit | Sensirion SHT41 STEMMA QT/Qwiic (5776) | - | n/a (Fertigmodul) | 25.4 x 17.8 mm (1.00 x 0.70 in, Fab Print), Bohrungen Raster 20.3 x 12.7 | Schematic/Fab Print (Learn-Guide-Asset 2023-07-06) | https://learn.adafruit.com/adafruit-sht40-temperature-humidity-sensor/downloads | 2026-11-08 | docs/datasheets/Adafruit_5776_SHT41_FabPrint_2023-07.png + docs/datasheets/Adafruit_5776_SHT41_Schematic_2023-07.png | Passt nicht in die Klimakammer G1 v4 (innen x 8 / y 38 / z 16 mm): 25.4 x 17.8 weder hochkant (17.8 > 16) noch flach (> 8) -> verworfen. play-zone.ch Art. ada-5776 CHF 9.90, > 10 Stk an Lager (2026-11-09)
TOOL-UART2 (Werkzeug, Alternative zu TOOL-UART1) | USB-UART-Bruecke mit externem VCCIO 1.8-5 V fuer Programmieradapter | Prolific (Board: Waveshare PL2303 USB UART Board (type A) V2) | PL2303GS | - | n/a (Werkzeug) | SSOP-16 auf Fertigboard 16.51 x 48.26 mm | Rev. 1.0.4 (2025-12-17) | https://www.prolific.com.tw/wp-content/uploads/2026/01/DS-23190101_PL2303GS.pdf | 2026-11-08 | docs/datasheets/Prolific_PL2303GS_Datasheet_Rev1.0.4.pdf | VDD_IO 1.8 V ... VIN+0.3 V (S. 39 Tab. 11-2a), Abs. max VDD_IO -0.3 ... VIN+0.3 V (S. 39 Tab. 11-1) -> VCCIO NUR bei gesteckter USB (VIN) anlegen; VIL max 0.4 V, VIH min 0.7 x VDD_IO, VOL 0.4 V (S. 39 Tab. 11-2b); RXD mit internem schwachem Pull-up, Wert nicht angegeben (S. 13); 6 Mbit/s bei 1.8 V (S. 40). Board-Schaltplan docs/references/Waveshare_PL2303-USB-UART-Board-TypeA-V2_Schematic_2026-11-08.pdf: Jumper J1 (5V/VCCIO/3.3V), Stecker P2 VCCIO/GND/TXD/RXD, RXD- und TXD-LED je 1 kOhm nach VCCIO (CH343-Board: 2 kOhm). pi-shop.ch Art. 11757 CHF 8.90 Sofort-Versand (2026-11-09). Pruefung Elektronik 2026-11-09: freigegeben mit Bedingungen B1-B6 (hardware/programmer/README.md Kap. 9; SPICE simulation/spice/programmer/prog_uart_pl2303.py). VID/PID 067B:23A3 (S. 22 Tab. 9-1) -> Linux-Treiber pl2303, /dev/ttyUSB0
TOOL-UART2-SCH (Werkzeug) | Schaltplan und Bestueckungsdruck Waveshare PL2303 USB UART Board (type A) V2 (P2 VCCIO/GND/TXD/RXD, Jumper J1 VCC3.3V/VCCIO/VCC5V, RXD-/TXD-LED je 1 kOhm an VCCIO, PWR-LED 1 kOhm an 5 V, C1 4.7 uF VIN, C4 1 uF VCCIO) | Waveshare | PL2303 USB UART Board (type A) V2 | - | n/a (Werkzeug) | Fertigboard 16.51 x 48.26 mm | undatiert (Abruf 2026-11-08) | https://www.waveshare.com/wiki/PL2303_USB_UART_Board_(type_A)_V2 (Abschnitt Schematic) | 2026-11-08 | docs/references/Waveshare_PL2303-USB-UART-Board-TypeA-V2_Schematic_2026-11-08.pdf | Grundlage fuer Anschluss J1 des Programmieradapters (README Kap. 2.1/9) und SPICE prog_uart_pl2303.py; LED-Typen nicht angegeben; Lage J1-Stift 5V laut Bestueckungsdruck S. 2 am Board pruefen
MECH-SCR1 (Phase 6, Vorschlag Mechanik) | Batteriefachschraube Huelse (Furchlippe haelt beim Loesen, NICHT unverlierbar: S K-5 Phase 6), ersetzt ISO 7045 M2x3 PH1 (keine CH-Quelle) | purecrea (Haendler bastelgarage.ch) | M2 x 3 A2 Linsenkopf Torx TX6, Kopfhoehe 1.6 (Art. 422191, 10 Stk) | - | n/a (Zukauf) | - | Produktseite (kein Datenblatt) | https://www.bastelgarage.ch/10-stuck-m2x3mm-linsenkopfschrauben-set-rostfrei | 2026-11-09 | docs/references/bastelgarage_Gewindeeinsatz-Schraube_Auszug_2026-11-09.txt | Kopfhoehe 1.6 laut Haendler (statt 1.3), Kopf-Ø NICHT angegeben -> CAD 3.8 ANNAHME, am Kaufteil messen (zulaessig bis 4.2, check_sensor.txt 5c). Werkzeug TX6 statt PH1 (BATTERIEWECHSEL.md). CHF 3.90/10 Stk, lagernd (2026-11-09)
GW-MECH-INS1 (Gateway G8a) | Gewindeeinsatz M2.5 Deckel-Niederhalterrohre (4 je Gateway) | purecrea (Haendler bastelgarage.ch) | M2.5 x 4 x Ø4.6 Messing vernickelt (SKU M2.5x4x4.6, Art. 425681, 100 Stk) | - | n/a (Zukauf) | - | Produktseite (kein Datenblatt) | https://www.bastelgarage.ch/m2-5-4mm-gewindeeinsatze-messing-heat-insert-100stk | 2026-11-09 | docs/references/bastelgarage_Gewindeeinsatz-Schraube_Auszug_2026-11-09.txt | Empfohlener Bohrdurchmesser 3.9, Bohrtiefe min. 4.5, Einschmelztemperatur Drucktemperatur + 10-20 C (Produktseite). CAD fluidi_gateway_pi.py TUBE: Bohrung 3.9, Tiefe 5.2, Einsatz 0.5 versenkt. CHF 15.90, lagernd (2026-11-09)
MAT-ASA2 (Phase 6, Alternative zu MAT-ASA) | Gehaeusewerkstoff Sensor/Gateway, falls Bambu ASA nicht lieferbar | eSUN | ASA+ 1.75 mm | - | n/a | Filament 1.75 mm | Technical Data Sheet Version 1.0 (Kopf JUN.2024, S. 2 Dec.2023) | https://grobotronics.com/images/eSUN%20ASA%2B%201kg%20datasheet.pdf (Haendlerkopie, esun3d.com hinter Bot-Sperre) | 2026-11-09 | docs/references/eSUN_ASAplus_TDS_V1.0-2024-06.pdf | S. 1: HDT 95.5 C (GB/T 1634, 0.45 MPa; kein 1.8-MPa-Wert), Zug 35.7 MPa, Biegemodul 2364 MPa, Izod 14.9 kJ/m2, Dichte 1.06 (spritzgegossene Proben). S. 2: Duese 250-280, Bett 100-110, Luefter 10-50 %, ermittelt auf Bambu P1S 0.4 mm (Probedruck 275 C). Widerspruch: Haendlerseite grobotronics nennt HDT 78 C (0.45 MPa) -> 7 d 65 C PROTOTYP-PRUEFUNG. bastelgarage.ch Blau 424238/Kaltweiss 424234 lagernd, Grau 424233 ausverkauft (2026-11-09)
MAT-ADH1 (Sensor S7, Vorschlag Mechanik) | Klebstoff Lichtfenster (2K-Epoxid), Kandidat Einkaufsliste S7 | UHU GmbH & Co. KG | UHU plus endfest 300 (33 g, Art. 45643, bastelgarage.ch 422137) | - | n/a (Zukauf) | Tuben Binder + Haerter 33 g | TDS Technisches Merkblatt (PDF 2012-07-31); SDB Version 62 (2026-07-17, ChemV CH) | https://media.hornbach.ch/hb/technicaldatasheet/as.46315187.PDF ; https://asset.conrad.com/media10/add/160267/c1/-/de/000478697SD03/security-datasheet-478697-uhu-plus-endfest-300-two-component-adhesive-45640-33-g.pdf | 2026-11-09 | docs/references/UHU_PlusEndfest300_TDS_2012-07.pdf + docs/references/UHU_PlusEndfest300-33g_SDS_V62-2026-07-17_DE.pdf | TDS S. 1: -40...+100 C, Topfzeit 90 min (20 C), Mischung 1:1 Volumen, FARBE Binder OPAK / Haerter honigfarben (nicht transparent, PRINT_SETTINGS verlangt transparentes 2K-Epoxid -> Mechanik entscheidet), nicht geeignet fuer PE/PP/PTFE/PS; S. 2: Warmhaertung 45 min 70 C. SDB S. 1-2: Achtung, H315/H317/H319 (Binder), Teil EUH205. Haendlerartikel bastelgarage 422137 = endfest 33 g (Typgleichheit 300 beim Wareneingang pruefen). KORREKTUR 2026-11-09 (Mechanik): SDB-PDF S. 14-15 (Haerter, Version 35): Gefahr, H314/H318/H317 (aetzend) - nicht nur H315/H317/H319; S. 18: Nitril > 0.12 mm (Spritzer), Butyl fuer Langzeit. ENTSCHEID-VORSCHLAG Mechanik 2026-11-09: Transparenz NICHT erforderlich (Klebstoff nur im Spalt 0.1 mm am Tropfenrand/Schaftmantel, nicht im Lichtweg, PRINT_SETTINGS Kap. 5); TDS S. 1/2: hochviskos, minimales Laufbestreben; TDS S. 1/S. 5 ASA nicht genannt (PS ungeeignet) -> Haftung ASA PROTOTYP-PRUEFUNG. ER2223 fuer Fenster abgelehnt (schwarz, 800 mPa s).
MECH-GREASE1 (Sensor S6) | Silikonfett fuer O-Ringe AS568-019 | offen | silikonbasiertes O-Ring-Fett (Typ offen) | - | n/a (Zukauf) | Tube | - | - | 2026-11-09 | - | KEIN Datenblatt lokal: Quelle offen (Einkaufsliste S6, Normteile-/Dichtungs-Fachhandel), Datenblatt beim Kauf ablegen. Vertraeglichkeit: nur mit EPDM-O-Ringen (REF-ORING1 PDF-S. 206: Silicone Greases EPDM 1, VMQ 3), duenner Film (S. 50)
GW-MECH-SCR2 (Gateway G8b) | Schrauben Deckel/Pi Gateway M2.5 x 8 (4 je Gateway) | Norm ISO 7380 (Hersteller offen) | M2.5 x 8 A2 Linsenkopf (Nylon als Option) | - | n/a (Zukauf) | - | - | - | 2026-11-09 | - | Normteil, Nennmasse ANNAHME, Einschraubtiefe 3.1 mm (mechanical/gateway_pi/check_gateway_pi.txt Pkt. 46); Quelle offen (Einkaufsliste G8b)
VERG-ZUB (Werkzeug, Verguss) | Zubehoer und Schutzausruestung Verguss V-Z1...V-Z12 (Waage, Pruefgewichte, Flaschen, Becher, Trichter, Pinsel, Spritzen, Handschuhe, Brille/Visier, Schuerze, Halbmaske A, Thermometer, Waermeschrank) | diverse (bastelgarage.ch / offen) | siehe docs/manuals/EINKAUFSLISTE.csv V-Z1...V-Z12 | - | n/a (Werkstattausruestung) | - | - | - | 2026-11-09 | docs/concepts/vergussmasse_versiegelung.md | Anforderungen Konzept Kap. 7.1 und MA-1...MA-5 (Sicherheit R2). Kein Bauteil des Produkts, keine Datenblattpflicht; Ausnahmen beim Kauf ablegen: Bestaendigkeitsliste Nitrilhandschuhe (K-3), Normnachweis Schutzbrille EN 166 und Filter A EN 14387
MAT-WIN1 (Sensor S11, verworfen) | Lichtfenster-Filament (Diffusor), Kandidat Einkaufsliste S11 | eSUN | ASA+ Kaltweiss 1.75 mm (bastelgarage.ch 424234) | - | n/a | Filament 1.75 mm | wie MAT-ASA2 | - | 2026-11-09 | docs/references/eSUN_ASAplus_TDS_V1.0-2024-06.pdf | Statt PETG natur: eSUN PETG-TDS nicht herunterladbar (esun3d.com 404, 2026-11-09), Haendler nennen HDT 64 C bei 0.45 MPa (Suchtreffer, unbestaetigt) < 65 C-Pruefung REQ-MECH-12 -> PETG nicht empfohlen. ASA+ Kaltweiss ist opak-weiss, Diffusorwirkung bei 1 mm = PROTOTYP-PRUEFUNG, Entscheid Mechanik: VERWORFEN 2026-11-09 (TiO2-weiss deckend, Lichtweg Fenster 4.0 mm massiv) -> MAT-WIN2
MAT-WIN2 (Sensor+Gateway S11, Vorschlag Mechanik) | Lichtfenster-Filament (Diffusor, unpigmentiert), Einkaufsliste S11 | Polymaker | Polymaker ASA Natural PF01006 1.75 mm 1 kg (Nachfolger PolyLite ASA | 3djake.ch PM-PF01006, EAN 6938936709992) | - | n/a | Filament 1.75 mm | Technical Data Sheet V6.0 (2025-12-02) | https://3d.nice-cdn.com/upload/file/TDS_Polymaker_ASA-V6.0_2025-12-02_EN.pdf (identisch md5 mit Polymaker-Wiki-Link https://cdn.shopify.com/s/files/1/0548/7299/7945/files/PolyLite_ASA_TDS_EN_V5.4.pdf) | 2026-11-09 | docs/references/Polymaker_ASA_TDS_V6.0-2025-12-02.pdf + docs/references/3DJake_PolymakerASA-Natural_Auszug_2026-11-09.txt | TDS S. 1 (einseitig): HDT 100 C (ISO 75, 1.8 MPa) / 103 C (0.45 MPa), Vicat 105 C, Tg 98 C, Dichte 1.13, E 2379 MPa XY, Zug 43.8 MPa XY; Duese 230-260 C, Bett 75-95 C, Luefter OFF, Kammer geschlossen, Trocknen 70 C 7 h; Light transmission N/A -> Transluzenz ANNAHME (unpigmentiert), LED-Sichtbarkeit PROTOTYP-PRUEFUNG. Shop 2026-11-09: CHF 23.75 (statt 33.00), noch 1 Stk an Lager, Versand CH 8.90 unter CHF 69.90
GW-R2 (Gateway G9, LCSC) | Vorwiderstand Gateway-LED 470 Ohm 1 % 1/4 W bedrahtet (Ersatz fuer GW-R1, LCSC-Lager 0) | CCO (Chian Chia Elec) | MF1/4W-470R 1 % T | C119317 | n/a (Handloetung) | axial D2.3 x L6.5 mm (JLC-Teilesuche) | - | https://www.lcsc.com/datasheet/lcsc_datasheet_2304140030_CCO-Chian-Chia-Elec-MF1-4W-470R-1--T_C119317.pdf | 2026-11-09 | NICHT HERUNTERLADBAR | LCSC-Datenblatt nicht ladbar (Bot-Sperre, 2026-11-09) -> beim Wareneingang ablegen, Orchestrator gemeldet. JLC-Teilesuche 2026-11-09 01:20: Lager 16455, 0.0112 USD @1. Bewertung 470 Ohm/1/4 W fuer 3-mm-LED an GPIO17 unveraendert (phase5_gateway_led.md), YAGEO MFR-25FBF52-470R C1369905 Lager 0
VERG-ZUB-GL (Werkzeug, Verguss, Handschuhe) | Einweg-Chemikalienschutzhandschuh fuer Verguss ER2223 (D-030 Bed. 1, K-3, Sicherheit W-5) | MAPA Professional | Solo 977 (Nitril, Einweg) | - | n/a (PSA) | Groessen 6-10 | Technical Sheet DE (LCA-Daten 2026-09) + Bestaendigkeitstabelle (2024-04-11) | https://mapa.ppe-analytics.com/de/product/376e9891addc57d5d1f7662bafa4a1d0/pdf/technical-sheet ; https://bul.ch/custom/data/shop/1103/documents/1/bestaendigkeitstabellefuermapasolo977.pdf | 2026-11-09 | docs/references/MAPA_Solo977_TechnicalSheet_DE_2026-09.pdf + docs/references/MAPA_Solo977_Bestaendigkeitstabelle_2024-04-11.pdf | TDS S. 1: Einweg, Staerke 0.13 mm, EN ISO 374-1 (spezifischer Chemikalienschutz), EN ISO 374-5, ISO 18889, CE-Baumuster 0075/014/162/08/18/1659. Bestaendigkeitstabelle: u. a. Ammoniakloesung 25 % 16 min (Stufe 1), Schwefelsaeure 40 % 480 min; KEINE Daten fuer 4,4-Methylenbis(cyclohexylamin) CAS 1761-71-3 oder Epoxidharz CAS 25068-38-6 -> Bewertung Sicherheit
DC-PCB (Dummy-Scheibe Weg B) | Leiterplatten PLUS (1.0 mm) + MINUS (2.0 mm), CR2032-Ersatz fuer Clip BT1, ohne Bestueckung | JLCPCB (Fertigung) | fluidi_dummy_plus / fluidi_dummy_minus Rev 1 | - | n/a (nur PCB) | Oe 19.8 mm + Lasche, gestapelt 3.0-3.2 mm | Rev 1 (2026-11-09) | hardware/dummy_cell/README.md | 2026-11-09 | docs/datasheets/Keystone_3034_Catalog_M65.pdf + docs/datasheets/Panasonic_CR2032_Datasheet_2026-02.pdf | Werkzeug; Geometrie nach Keystone M65 S. 1 Fig. 1 (3034: H 4.1, Minuspad >= 3.96 SQ) und CR2032 Oe 20.0 / H 3.2 max (Panasonic S. 1); JLC-Regeln docs/references/JLCPCB_NOTES.md Kap. 3
DC-U1 (Dummy-Scheibe, optional B2) | Schmitt-Puffer TX an TP1 (statt Draht an R9), Handloetung | Texas Instruments | SN74AUP1G17DBVR | C183012 | Extended (nicht JLC-bestueckt, Teil aus Einkaufsliste P3) | SOT-23-5 DBV (1 NC, 2 A, 3 GND, 4 Y, 5 VCC), Footprint SOT-23-5_HandSoldering | SCES579J (2017-09) | https://www.ti.com/lit/ds/symlink/sn74aup1g17.pdf | 2026-11-09 | docs/datasheets/TI_SN74AUP1G17_Datasheet_SCES579J.pdf | wie P-U4; Pins S. 3 Kap. 5 (DBV) geprueft 2026-11-09
DC-R1 (Dummy-Scheibe, optional B2) | R 10 MOhm 1 % 0402 Pull-up Puffereingang, Handloetung | UNI-ROYAL | 0402WGF1005TCE | C26082 | Extended (nicht JLC-bestueckt, Teil aus Einkaufsliste P6) | 0402, Footprint R_0402_1005Metric_Pad0.72x0.64mm_HandSolder | Seriendatenblatt 01005-2512 (LCSC 2024-11) | https://www.lcsc.com/datasheet/lcsc_datasheet_2411221126_UNI-ROYAL-Uniroyal-Elec-0402WGF1005TCE_C26082.pdf | 2026-11-09 | docs/datasheets/UNI-ROYAL_0402WGF-Serie_Datasheet_LCSC-2024-11.pdf | wie P-R1
DC-C1 (Dummy-Scheibe, optional B2) | MLCC 100 nF 50 V X7R 0805 Abblock U1, Handloetung | Samsung Electro-Mechanics | CL21B104KBCNNNC | C1711 | Extended (nicht JLC-bestueckt, Teil aus Einkaufsliste P5) | 0805, Footprint C_0805_2012Metric_Pad1.18x1.45mm_HandSolder | Katalog 2015-11 (Teilenummernsystem) | https://www.lcsc.com/datasheet/lcsc_datasheet_2304140030_Samsung-Electro-Mechanics-CL21B104KBCNNNC_C1711.pdf | 2026-11-09 | docs/datasheets/Samsung_CL31A107MQHNNNE_Catalog_2015-11.pdf | wie P-C5
REF-ORING1 (Mechanik, R K-l2) | Werkstoffwahl O-Ring und Fett (Vertraeglichkeitstabelle, Elastomere) | Parker Hannifin O-Ring Division | Parker O-Ring Handbook ORD 5700 | - | - | - | ORD 5700 (PDF 2007-07, geaendert 2008-05) | https://mfc.arizona.edu/sites/default/files/2022-02/parker_o-ring_handbook.pdf (Kopie Univ. Arizona | Quelle Red Team phase6_redteam_paket.md) | 2026-11-09 | docs/references/Parker_ORD5700_ORingHandbook_2007.pdf | PDF-S. 16 (2-4): EPDM -57...+150 C, vertraeglich Silikonoel/-fett, Wasser; NICHT Mineraloelprodukte. S. 50 Tab. 3-1: Montagefett sparsam, leichter Film. S. 68 Abschn. 3.14.2: Silikonoele/-fette mit allen Dichtwerkstoffen ausser Silikon. Vertraeglichkeitstabelle (Legende S. 162: 1 satisfactory, 3 doubtful): Silicone Greases S. 206 EPDM 1 / VMQ 3; Ammonium Nitrate 2N, Ammonium Phosphate, Ammonium Sulfate S. 165 EPDM 1; Potassium Nitrate/Chloride S. 203 EPDM 1; Water S. 215 EPDM 1. Spaltenzuordnung aus pdftotext-Layout (Kopfzeilen gedreht) -> Seite 206 am Bild gegengeprueft (Silicone Greases: EPDM 1, FVMQ 2, VMQ 3), uebrige Seiten nur Textlayout; S. 206 unten: Ethylene Propylene -57...+121 C (General Service)
