sgeisser1/Tr-pfli/docs/concepts/bom/bom_A.csv

part | qty_per_board | unit_price_usd | unit_price_chf | category | jlc_assembled | joints | moq | attrition | source | tiers | leadless
SoC CC2340R52E0RGER C20416850 | 1 | 1.3375 | 0 | extended | ja | 25 | 1 | 0 | JLC | 1:1.5864|10:1.3375|30:1.2016|100:1.0461|500:0.9774|1000:0.9463 | ja
Quarz 48 MHz 8 pF XC32M4-48.000-F08NLDT C2925606 | 1 | 0.0993 | 0 | extended | ja | 4 | 5 | 2 | JLC | 1:0.0993|50:0.0796|150:0.0698|500:0.0624|3000:0.0565|6000:0.0536 | nein
Quarz 32.768 kHz 9 pF Q13FC13500003 C99010 | 1 | 0.204 | 0 | extended | ja | 2 | 5 | 2 | JLC | 1:0.204|50:0.1629|150:0.1453|500:0.1233|3000:0.096|6000:0.0901 | nein
L 10uH DCDC WPN201610H100MT C89132 | 1 | 0.0418 | 0 | extended | ja | 2 | 5 | 4 | JLC | 1:0.0418|100:0.0339|300:0.03|2000:0.0259|4000:0.0235|10000:0.0223 | nein
C 10uF VDDR/VDDS CL05A106MQ5NUNC C15525 | 2 | 0.0258 | 0 | basic | ja | 2 | 20 | 10 | JLC | 1:0.0258|1000:0.0192|3000:0.0163|10000:0.0141|50000:0.0133|100000:0.0127 | nein
C 100nF Abblock (VDDS x3, VDDR, TMP, OSZ, Reserve) CL05B104KO5NNNC C1525 | 7 | 0.0031 | 0 | basic | ja | 2 | 20 | 10 | JLC | 1:0.0031|1000:0.0023|3000:0.002|10000:0.0017|50000:0.0016|50200:0.0016 | nein
C 1uF VDDD CL05A105KA5NQNC C52923 | 1 | 0.0058 | 0 | basic | ja | 2 | 20 | 12 | JLC | 1:0.0058|1000:0.0044|3000:0.0038|10000:0.0034|50000:0.0032|100000:0.0031 | nein
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
2 Dichtungen (ANNAHME) | 1 | 0 | 0.3 | none | nein | 0 | 1 | 0 | LOKAL |  | nein
Versiegelung Sonde (ANNAHME) | 1 | 0 | 0.4 | none | nein | 0 | 1 | 0 | LOKAL |  | nein
Schraube unverlierbar + Gewindeeinsatz (ANNAHME) | 1 | 0 | 0.2 | none | nein | 0 | 1 | 0 | LOKAL |  | nein
