sgeisser1/Tr-pfli/docs/concepts/bom/bom_B.csv

part | qty_per_board | unit_price_usd | unit_price_chf | category | jlc_assembled | joints | moq | attrition | source | tiers | leadless
SoC CH592F C39831287 | 1 | 0.6696 | 0 | extended | ja | 29 | 1 | 0 | JLC | 1:0.8333|10:0.6696|30:0.5878|100:0.5075|500:0.4584|1000:0.4339 | ja
Quarz 32 MHz X322532MOB4SI C9009 | 1 | 0.0957 | 0 | extended | ja | 4 | 5 | 4 | JLC | 1:0.0957|50:0.0765|150:0.0667|500:0.0587|3000:0.05|6000:0.0482 | nein
Quarz 32.768 kHz 12.5 pF Q13FC13500004 C32346 | 1 | 0.1715 | 0 | basic | ja | 2 | 5 | 1 | JLC | 1:0.1715|50:0.1353|150:0.1174|500:0.1017|3000:0.083|6000:0.0804 | nein
L 10uH DC-DC WPN201610H100MT C89132 | 1 | 0.0418 | 0 | extended | ja | 2 | 5 | 4 | JLC | 1:0.0418|100:0.0339|300:0.03|2000:0.0259|4000:0.0235|10000:0.0223 | nein
C 4.7uF VDCID CL05A475MP5NRNC C23733 | 1 | 0.0118 | 0 | basic | ja | 2 | 20 | 10 | JLC | 1:0.0118|500:0.0092|1500:0.008|10000:0.0072|20000:0.0068|50000:0.0066 | nein
C 10uF CL05A106MQ5NUNC C15525 | 1 | 0.0258 | 0 | basic | ja | 2 | 20 | 10 | JLC | 1:0.0258|1000:0.0192|3000:0.0163|10000:0.0141|50000:0.0133|100000:0.0127 | nein
C 100nF CL05B104KO5NNNC C1525 | 5 | 0.0031 | 0 | basic | ja | 2 | 20 | 10 | JLC | 1:0.0031|1000:0.0023|3000:0.002|10000:0.0017|50000:0.0016|50200:0.0016 | nein
R 0R Pi-Netz 0402WGF0000TCE C17168 | 1 | 0.0011 | 0 | basic | ja | 2 | 20 | 10 | JLC | 1:0.0011|1000:0.0009|3000:0.0007|10000:0.0007|50000:0.0005|50200:0.0005 | nein
Temp TMP1075 VSSOP-8 TMP1075DGKR C2864807 | 1 | 0.316 | 0 | extended | ja | 8 | 5 | 0 | JLC | 1:0.3995|10:0.316|30:0.28|100:0.2358|500:0.2161|1000:0.203 | nein
R 4.7k I2C-Pull-up 0402WGF4701TCE C25900 | 2 | 0.0017 | 0 | basic | ja | 2 | 20 | 10 | JLC | 1:0.0017|1000:0.0013|3000:0.0011|10000:0.001|50000:0.0009|50200:0.0009 | nein
Halter CR2032 CR2032-BS-6-1 C70377 | 1 | 0.142 | 0 | extended | ja | 2 | 5 | 1 | JLC | 1:0.142|50:0.1336|1000:0.111|5000:0.1069 | nein
P-FET Verpolschutz AO3401A C15127 | 1 | 0.0829 | 0 | basic | ja | 3 | 5 | 4 | JLC | 1:0.0829|50:0.0655|150:0.0567|500:0.0495|3000:0.0469|6000:0.0452 | nein
C 100uF Puffer (245 uF pess.) CL31A107MQHNNNE C15008 | 3 | 0.1091 | 0 | basic | ja | 2 | 5 | 4 | JLC | 1:0.1091|100:0.086|300:0.0742|2000:0.0644|4000:0.0609|10000:0.0587 | nein
LED rot KT-0603R C2286 | 1 | 0.0077 | 0 | basic | ja | 2 | 20 | 10 | JLC | 1:0.0077|1000:0.0059|4000:0.0046|8000:0.004|48000:0.0037|100000:0.0036 | nein
R 470R LED 0402WGF4700TCE C25117 | 1 | 0.001 | 0 | basic | ja | 2 | 20 | 10 | JLC | 1:0.001|1000:0.0008|3000:0.0007|10000:0.0006|50000:0.0005|50200:0.0005 | nein
Taster TS-1187A-B-A-B C318884 | 1 | 0.0207 | 0 | basic | ja | 4 | 5 | 8 | JLC | 1:0.0207|200:0.016|600:0.0139|4000:0.0121|8000:0.0115|20000:0.0111 | nein
R 100k Pad-Serie (2 je Leitung) 0402WGF1003TCE C25741 | 4 | 0.0013 | 0 | basic | ja | 2 | 20 | 12 | JLC | 1:0.0013|1000:0.001|3000:0.0009|10000:0.0008|50000:0.0007|50200:0.0007 | nein
Zelle Renata CR2032 | 1 | 0 | 2.65 | none | nein | 0 | 1 | 0 | LOKAL |  | nein
Gehaeuse ASA 10 g + 4 g AMS-Spuelung (ANNAHME) | 1 | 0 | 0.49 | none | nein | 0 | 1 | 0 | LOKAL |  | nein
2 Dichtungen (ANNAHME) | 1 | 0 | 0.3 | none | nein | 0 | 1 | 0 | LOKAL |  | nein
Versiegelung Sonde (ANNAHME) | 1 | 0 | 0.4 | none | nein | 0 | 1 | 0 | LOKAL |  | nein
Schraube unverlierbar + Gewindeeinsatz (ANNAHME) | 1 | 0 | 0.2 | none | nein | 0 | 1 | 0 | LOKAL |  | nein
