sgeisser1/Tr-pfli/hardware/sensor/out/ORDER_JLC_REV_B.md

# fluidi Sensor Rev B – Bestellparameter JLCPCB (ERSETZT)

**Diese Unterlage gilt nicht mehr.** Ab 2026-11-08 gilt für die Bestellung des Sensor-Layouts Rev C (Commit `03341e8`)
ausschliesslich `hardware/sensor/out/ORDER_JLC_REV_C.md` (Red Team W-1/B-1, `docs/reviews/phase4_redteam_gesamt.md`).

Veraltet waren u. a.: 5 statt 4 Via-in-Pad im Zellfach, Oberfläche „HAL lead-free“ in der Platine, fehlender
Platzhalter `JLCJLCJLCJLC`, U3 ohne Rotationskorrektur, offene Preisabfrage. Gegenüberstellung in
ORDER_JLC_REV_C.md Kap. 9. Der Inhalt vom Stand 2026-11-07 ist in der Git-Historie erhalten (`git show 03341e8:hardware/sensor/out/ORDER_JLC_REV_B.md`).
