sgeisser1/Tr-pfli/mechanical/gateway_pi/fluidi_gateway_pi_assembly.step

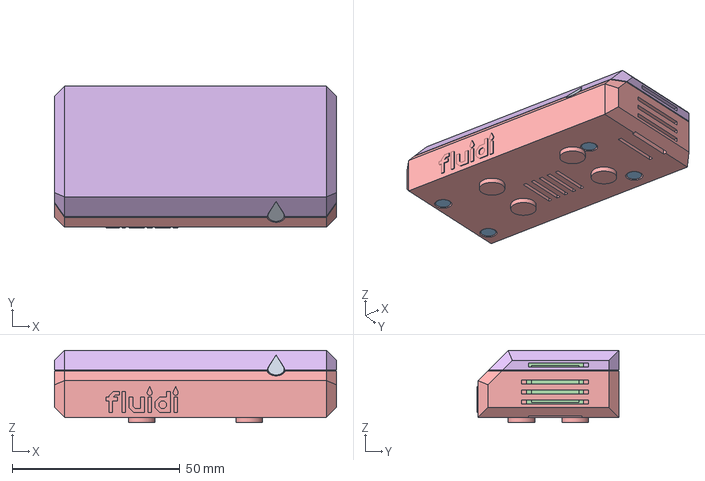
[picture p90: CAD file, 2026-11-09]
mechanical/gateway_pi/fluidi_gateway_pi_assembly.step
84.0 x 42.2 x 21.5 mm
