sgeisser1/Tr-pfli/mechanical/gateway/fluidi_gateway_assembly.step

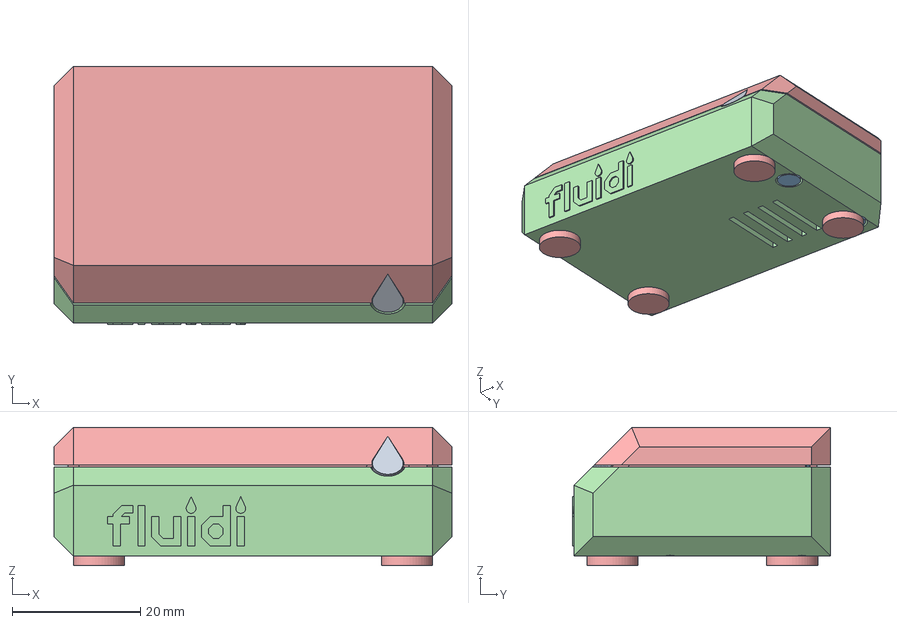
[picture p91: CAD file, 2026-11-07]
mechanical/gateway/fluidi_gateway_assembly.step
62.0 x 40.2 x 21.5 mm
