sgeisser1/Tr-pfli/hardware/sensor/out/fluidi_sensor.step

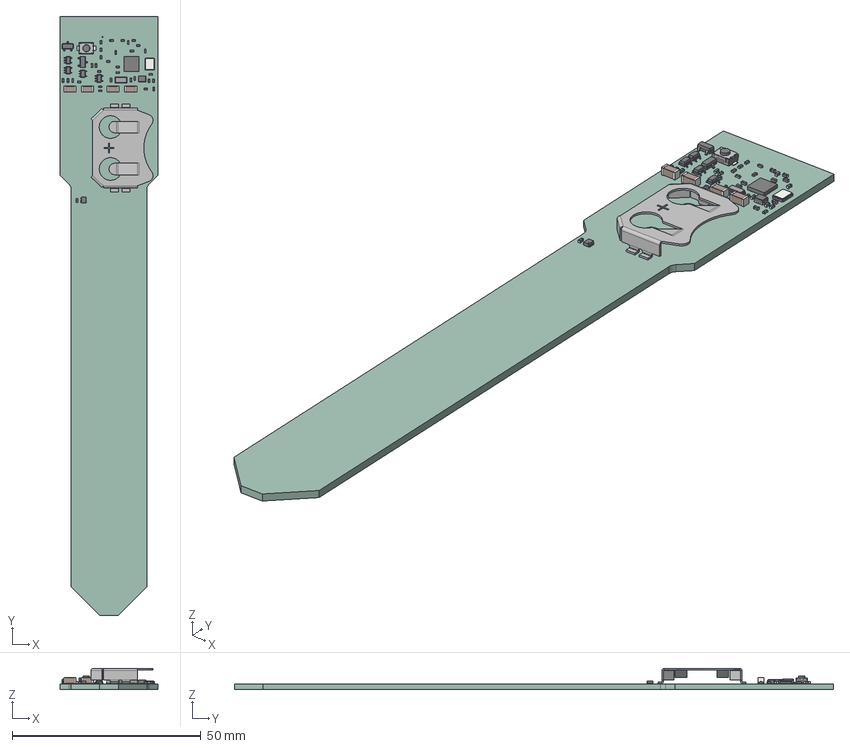
[picture p93: CAD file, 2026-11-08]
hardware/sensor/out/fluidi_sensor.step
26.0 x 158.5 x 5.60 mm
R_0402_1005Metric x 13
C_0402_1005Metric x 18
SOT-353_SC-70-5 x 4
SOT-23 x 2
BatteryHolder_Keystone_3034_1x20mm
SOT_563
C_1206_3216Metric x 4
Crystal_SMD_3215-2Pin_3.2x1.5mm
L_Murata_DFE201610P
Texas_RGE0024H_VQFN-24-1EP_4x4mm_P0.5mm_EP2.7x2.7mm
L_0402_1005Metric
SW_SPST_TS-1088-xR020
Crystal_SMD_3225-4Pin_3.2x2.5mm
fluidi_sensor_PCB
