sgeisser1/Tr-pfli/mechanical/gateway_pi/print/fenster_tropfen_gw.step

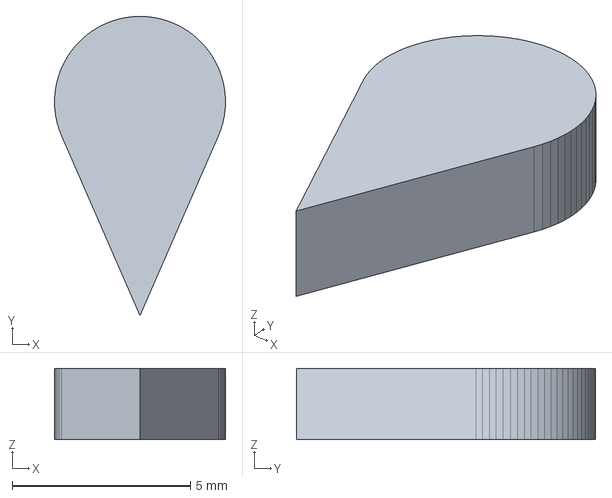
[picture p94: CAD file, 2026-11-09]
mechanical/gateway_pi/print/fenster_tropfen_gw.step
4.80 x 8.40 x 2.00 mm
