sgeisser1/Tr-pfli/mechanical/interfaces/pcb_outline.dxf

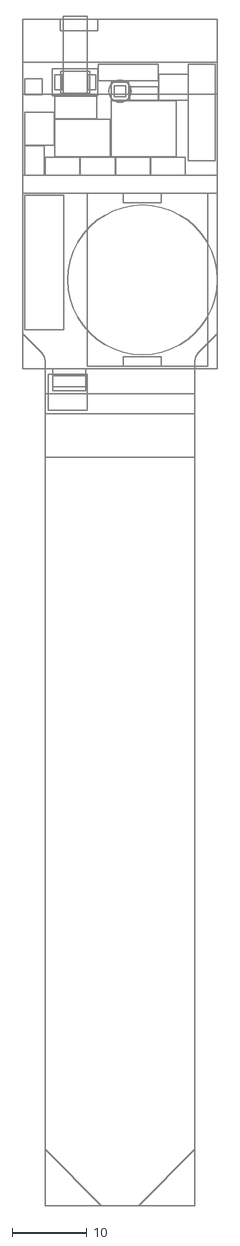
[picture p95: CAD file, 2026-11-07]
mechanical/interfaces/pcb_outline.dxf
26.0 x 158.9
