sgeisser1/Tr-pfli/mechanical/p3_sleeve/p3_sleeve_A1_30x13x48_sonde22.step

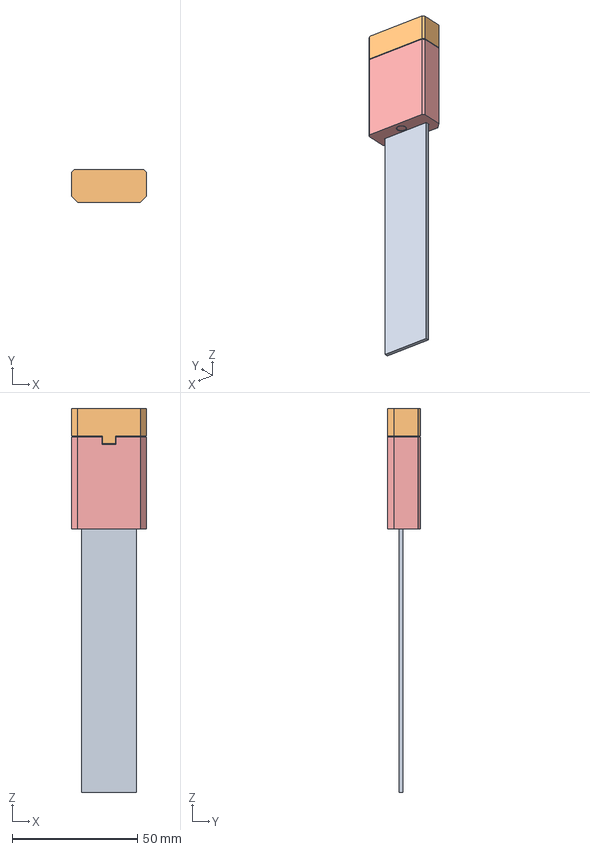
[picture p96: CAD file, 2026-11-07]
mechanical/p3_sleeve/p3_sleeve_A1_30x13x48_sonde22.step
30.0 x 13.0 x 153.0 mm
