sgeisser1/Tr-pfli/mechanical/sensor/fluidi_sensor_mit_pcb.step

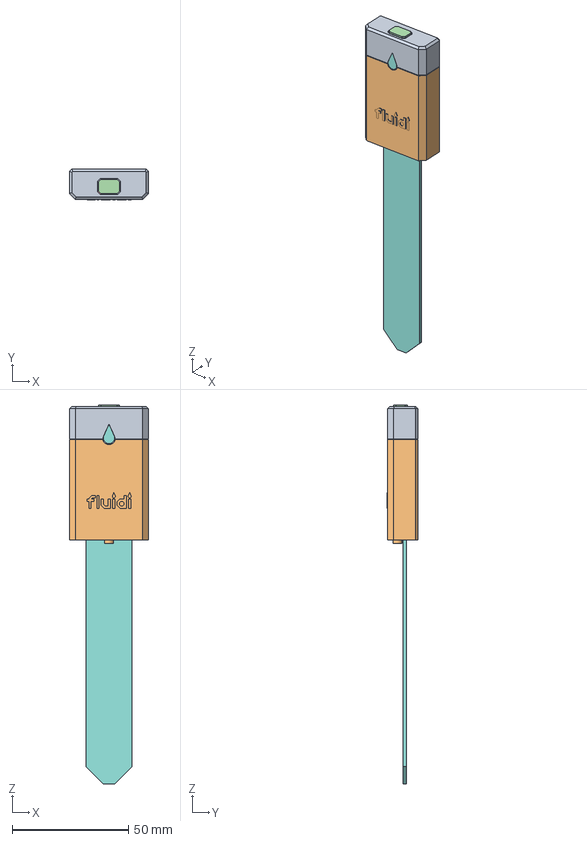
[picture p97: CAD file, 2026-11-08]
mechanical/sensor/fluidi_sensor_mit_pcb.step
34.0 x 13.2 x 163.1 mm
