sgeisser1/Tr-pfli/mechanical/sensor/print/tastenteller.step

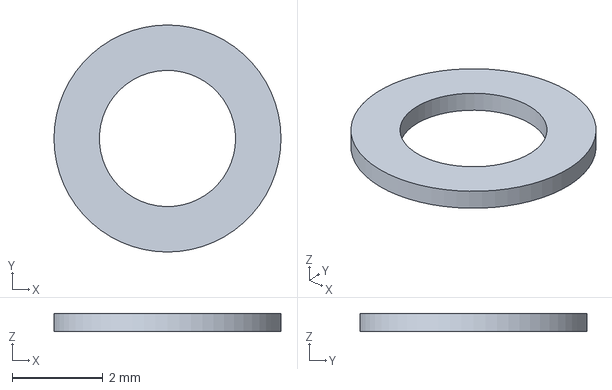
[picture p98: CAD file, 2026-11-08]
mechanical/sensor/print/tastenteller.step
5.00 x 5.00 x 0.4 mm
