sgeisser1/Tr-pfli/production/rev-C/3_druck/gateway_pi/deckel_blau.step

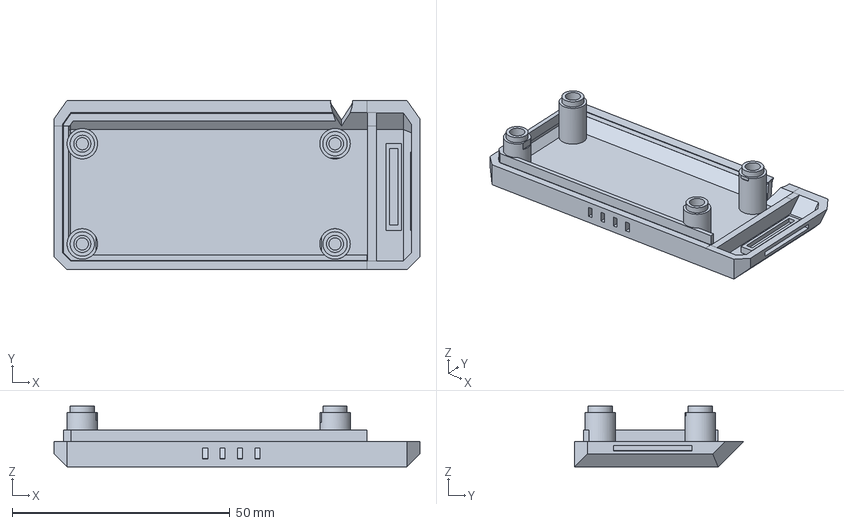
[picture p99: CAD file, 2026-11-09]
production/rev-C/3_druck/gateway_pi/deckel_blau.step
84.0 x 38.9 x 14.0 mm
