sgeisser1/Tr-pfli/production/rev-C/3_druck/sensor/taste_blau.step

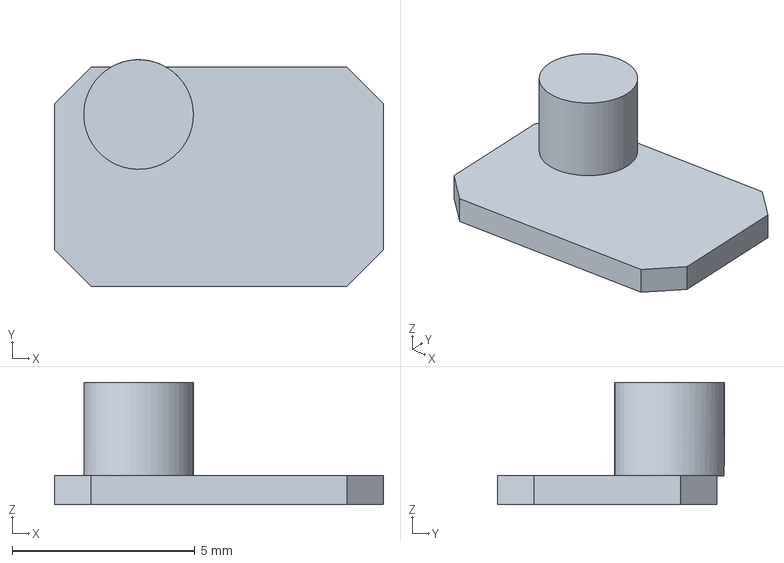
[picture p100: CAD file, 2026-11-08]
production/rev-C/3_druck/sensor/taste_blau.step
9.00 x 6.20 x 3.35 mm
