sgeisser1/Tr-pfli/mechanical/gateway_pi/print/wanne_grau_otg.step

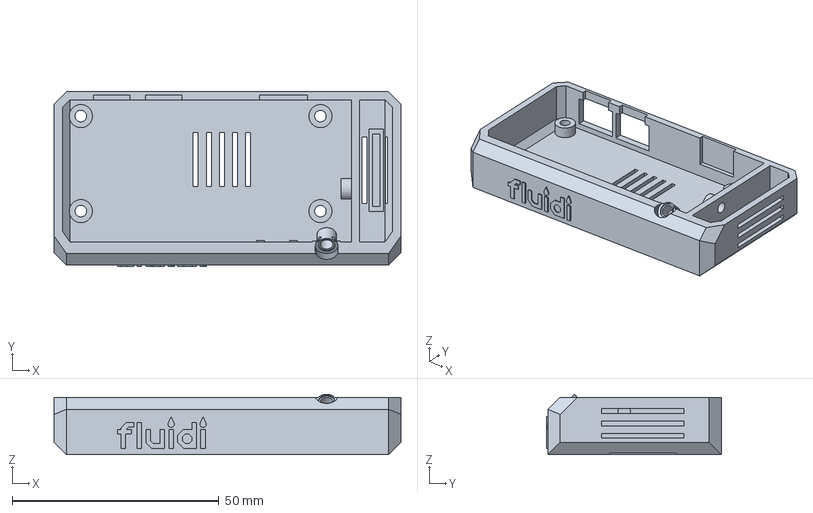
[picture p101: CAD file, 2026-11-09]
mechanical/gateway_pi/print/wanne_grau_otg.step
84.0 x 42.2 x 14.6 mm
