sgeisser1/Tr-pfli/mechanical/p3_sleeve/p3_sleeve_A1_28x13x48_sonde20.step

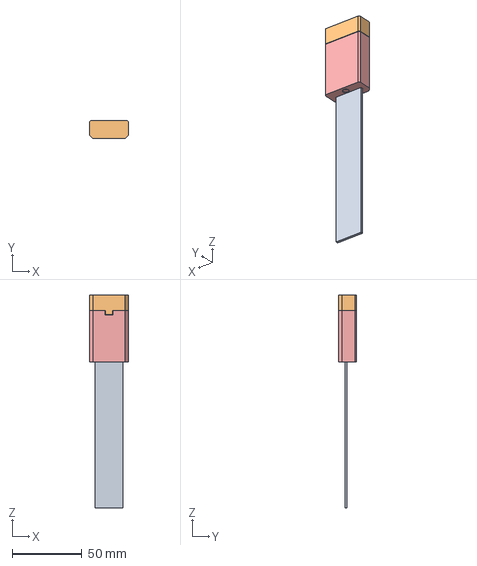
[picture p102: CAD file, 2026-11-07]
mechanical/p3_sleeve/p3_sleeve_A1_28x13x48_sonde20.step
28.0 x 13.0 x 153.0 mm
