sgeisser1/Tr-pfli/mechanical/sensor/print/distanzlehre_24p2.step

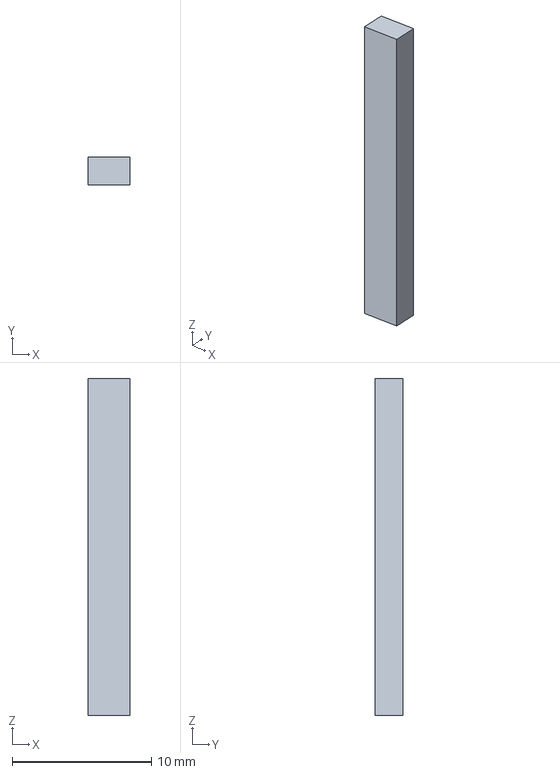
[picture p103: CAD file, 2026-11-08]
mechanical/sensor/print/distanzlehre_24p2.step
3.00 x 2.00 x 24.2 mm
