sgeisser1/Tr-pfli/production/rev-C/3_druck/sensor/huelse_grau.step

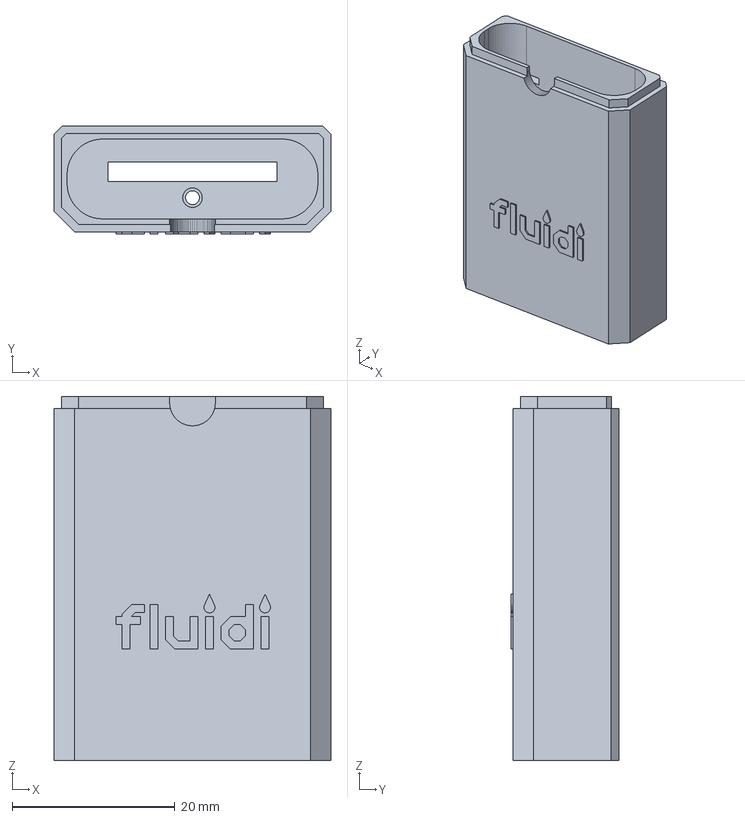
[picture p104: CAD file, 2026-11-08]
production/rev-C/3_druck/sensor/huelse_grau.step
34.0 x 13.2 x 44.7 mm
