sgeisser1/Tr-pfli/mechanical/sensor/fluidi_sensor.FCStd

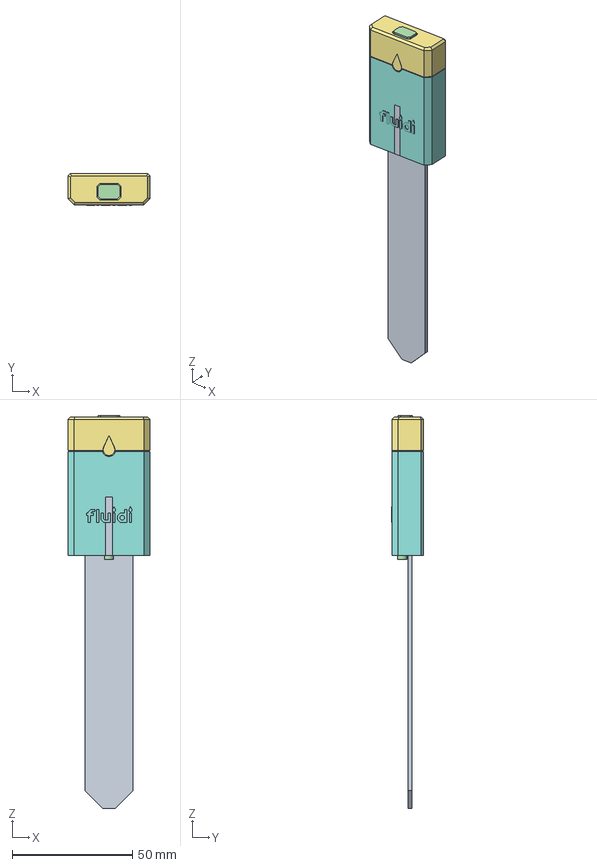
[picture p105: CAD file, 2026-11-08]
mechanical/sensor/fluidi_sensor.FCStd
34.0 x 13.3 x 163.1 mm
PCB
Antenne_AN043
Band_Huelle_F
D1_LED
SW1_Taster
U3_TMP_Kragen
CR2032
Keystone3034
Kragen
Mutter_M2
Verguss_Kragen
Schraube_M2
ORing_Kragen
ORing_Zapfen
Kappe_blau
Schottkeil
Verguss_Schott
Membran_Silikon
Klemmring
Taste_blau
Tastenteller
Stoessel
Fenster_transluzent
Huelse_grau
Distanzlehre_24p2
