sgeisser1/Tr-pfli/mechanical/sensor/print/klemmring.step

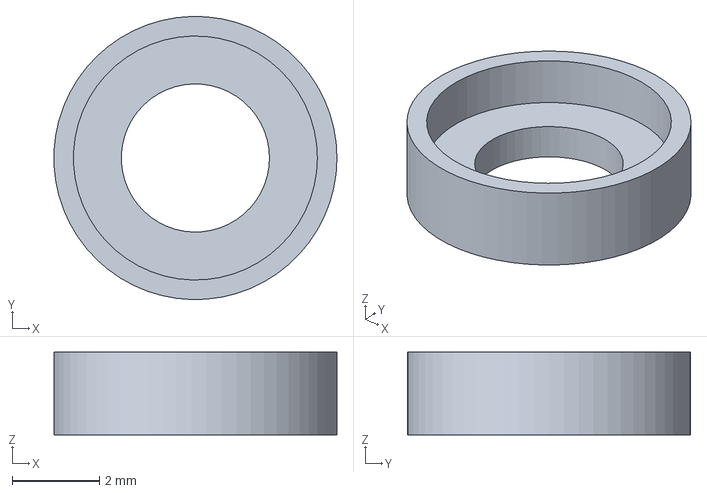
[picture p106: CAD file, 2026-11-08]
mechanical/sensor/print/klemmring.step
6.50 x 6.50 x 1.90 mm
