sgeisser1/Tr-pfli/production/rev-C/3_druck/sensor/kappe_blau.step

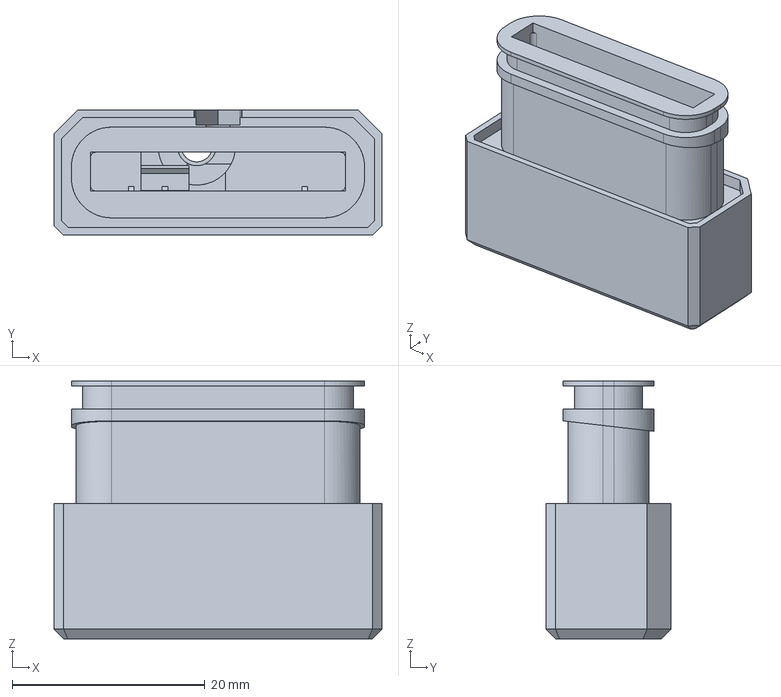
[picture p107: CAD file, 2026-11-08]
production/rev-C/3_druck/sensor/kappe_blau.step
34.0 x 13.0 x 26.7 mm
