sgeisser1/Tr-pfli/mechanical/sensor/print/schottkeil.step

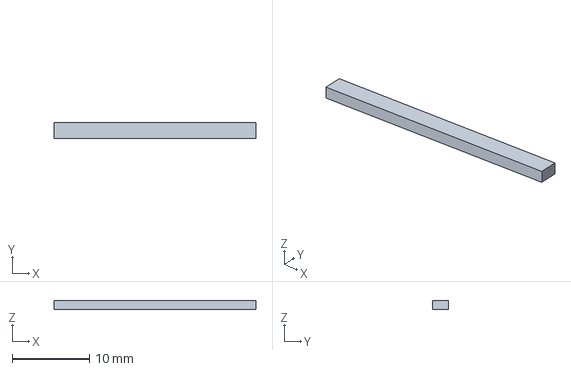
[picture p108: CAD file, 2026-11-08]
mechanical/sensor/print/schottkeil.step
26.1 x 2.05 x 1.20 mm
