sgeisser1/Tr-pfli/mechanical/sensor/print/passprobe_huelse_oben.step

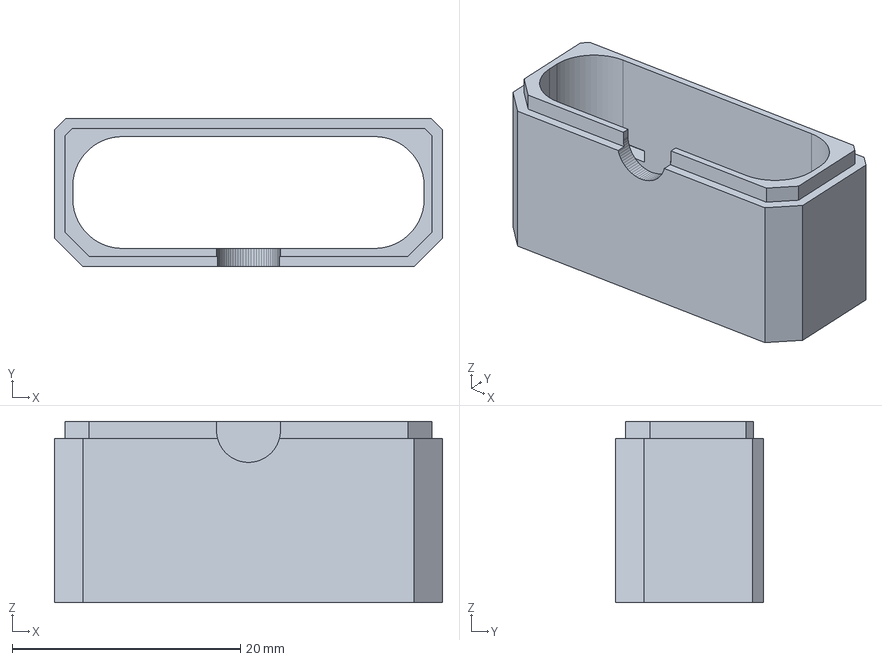
[picture p109: CAD file, 2026-11-08]
mechanical/sensor/print/passprobe_huelse_oben.step
34.0 x 13.0 x 15.9 mm
