sgeisser1/Tr-pfli/production/rev-C/3_druck/sensor/fenster_tropfen.step

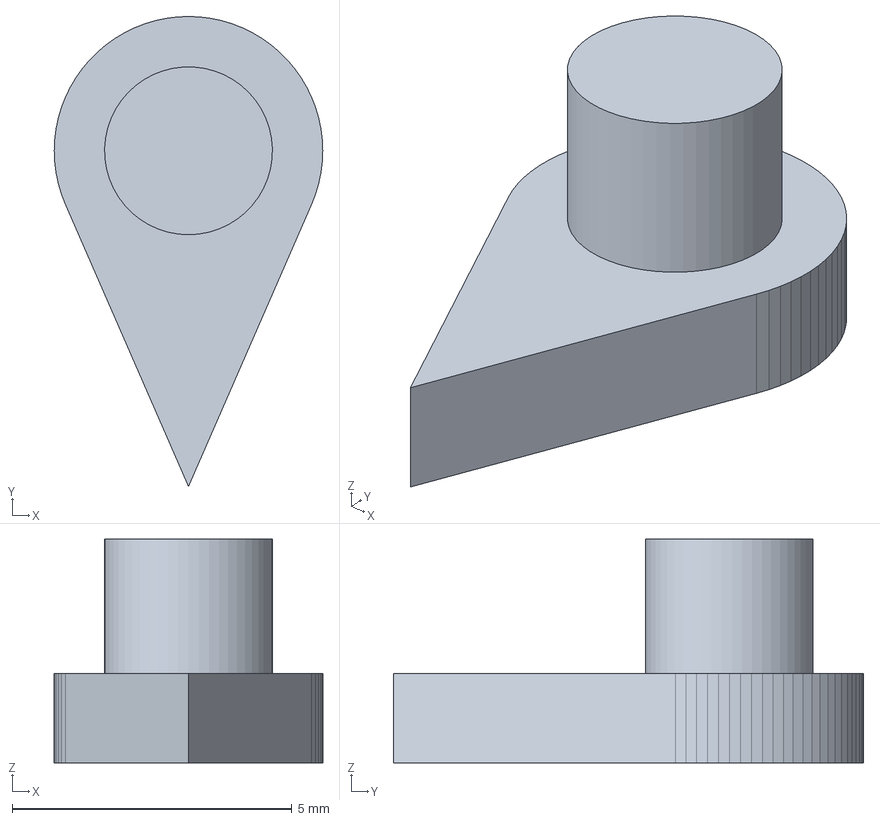
[picture p110: CAD file, 2026-11-08]
production/rev-C/3_druck/sensor/fenster_tropfen.step
4.80 x 8.40 x 4.00 mm
