sgeisser1/Tr-pfli/production/rev-C/3_druck/sensor/stoessel.step

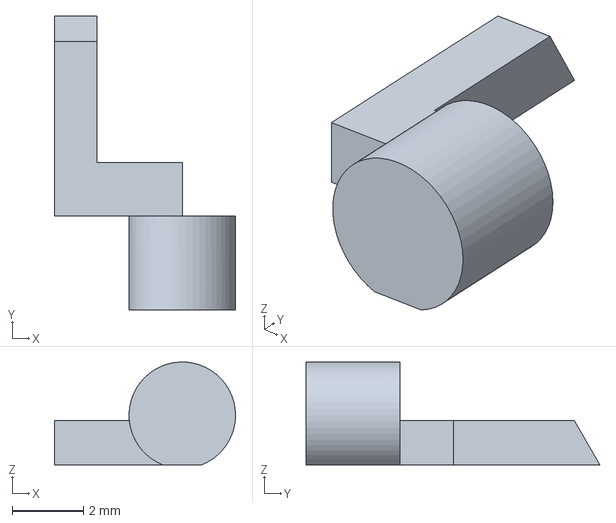
[picture p111: CAD file, 2026-11-08]
production/rev-C/3_druck/sensor/stoessel.step
5.10 x 8.28 x 2.90 mm
