sgeisser1/Tr-pfli/mechanical/sensor/print/passprobe_huelse_unten.step

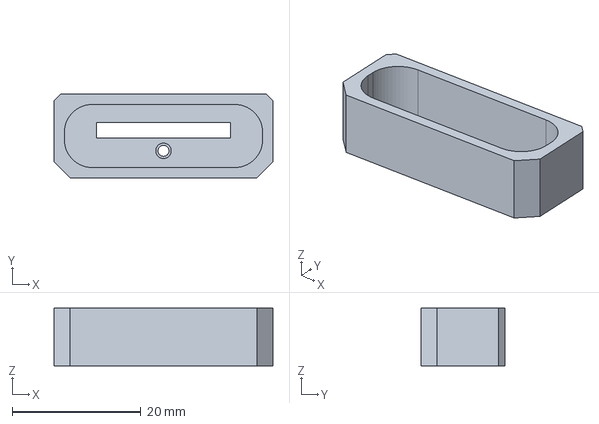
[picture p112: CAD file, 2026-11-08]
mechanical/sensor/print/passprobe_huelse_unten.step
34.0 x 13.0 x 9.00 mm
