sgeisser1/Tr-pfli/mechanical/sensor/print/kragen.step

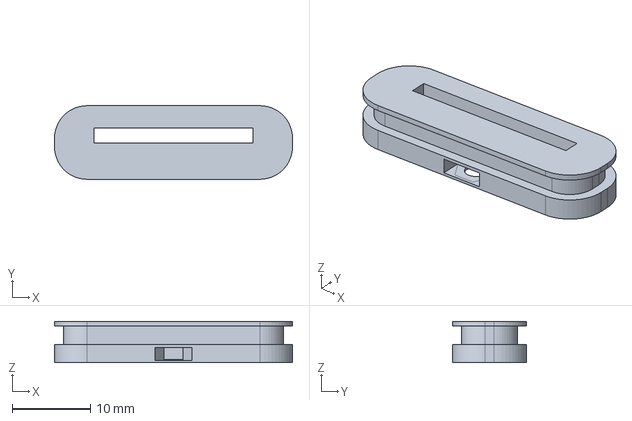
[picture p113: CAD file, 2026-11-08]
mechanical/sensor/print/kragen.step
30.4 x 9.40 x 5.30 mm
