sgeisser1/Tr-pfli/(list of files, cad)

Other CAD files:
mechanical/gateway/fluidi_gateway.FCStd
mechanical/gateway_pi/fluidi_gateway_pi.FCStd
production/rev-C/3_druck/gateway_pi/wanne_grau.step
mechanical/gateway_pi/print/wanne_grau.step
mechanical/sensor/print/distanzlehre_23p5.step
mechanical/gateway/print/deckel_blau.3mf
mechanical/gateway/print/deckel_blau.step
mechanical/gateway/print/deckel_blau.stl
mechanical/gateway/print/fenster_tropfen_gw.3mf
mechanical/gateway/print/fenster_tropfen_gw.step
mechanical/gateway/print/fenster_tropfen_gw.stl
mechanical/gateway/print/wanne_grau.3mf
mechanical/gateway/print/wanne_grau.step
mechanical/gateway/print/wanne_grau.stl
mechanical/gateway_pi/print/deckel_blau.3mf
mechanical/gateway_pi/print/deckel_blau.stl
mechanical/gateway_pi/print/fenster_tropfen_gw.3mf
mechanical/gateway_pi/print/wanne_grau.3mf
mechanical/gateway_pi/print/wanne_grau.stl
mechanical/gateway_pi/print/wanne_grau_otg.3mf
mechanical/gateway_pi/print/wanne_grau_otg.stl
mechanical/p3_sleeve/p3_sleeve_A1_28x13x48_sonde20.FCStd
mechanical/p3_sleeve/p3_sleeve_A1_30x13x48_sonde22.FCStd
mechanical/sensor/print/distanzlehre_24p2.3mf
mechanical/sensor/print/fenster_tropfen.3mf
mechanical/sensor/print/huelse_grau.3mf
mechanical/sensor/print/kappe_blau.3mf
mechanical/sensor/print/klemmring.3mf
mechanical/sensor/print/kragen.3mf
mechanical/sensor/print/passprobe_huelse_oben.3mf
mechanical/sensor/print/passprobe_huelse_unten.3mf
mechanical/sensor/print/schottkeil.3mf
mechanical/sensor/print/stoessel.3mf
mechanical/sensor/print/taste_blau.3mf
mechanical/sensor/print/tastenteller.3mf
production/rev-C/3_druck/gateway_pi/deckel_blau.3mf
production/rev-C/3_druck/gateway_pi/deckel_blau.stl
production/rev-C/3_druck/gateway_pi/fenster_tropfen_gw.3mf
production/rev-C/3_druck/gateway_pi/fenster_tropfen_gw.stl
production/rev-C/3_druck/gateway_pi/wanne_grau.3mf
production/rev-C/3_druck/gateway_pi/wanne_grau.stl
production/rev-C/3_druck/gateway_pi/wanne_grau_otg.3mf
production/rev-C/3_druck/gateway_pi/wanne_grau_otg.stl
production/rev-C/3_druck/sensor/distanzlehre_24p2.3mf
production/rev-C/3_druck/sensor/distanzlehre_24p2.stl
production/rev-C/3_druck/sensor/fenster_tropfen.3mf
production/rev-C/3_druck/sensor/fenster_tropfen.stl
production/rev-C/3_druck/sensor/huelse_grau.3mf
production/rev-C/3_druck/sensor/huelse_grau.stl
production/rev-C/3_druck/sensor/kappe_blau.3mf
production/rev-C/3_druck/sensor/kappe_blau.stl
production/rev-C/3_druck/sensor/klemmring.3mf
production/rev-C/3_druck/sensor/klemmring.stl
production/rev-C/3_druck/sensor/kragen.3mf
production/rev-C/3_druck/sensor/kragen.stl
production/rev-C/3_druck/sensor/passprobe_huelse_oben.3mf
production/rev-C/3_druck/sensor/passprobe_huelse_oben.stl
production/rev-C/3_druck/sensor/passprobe_huelse_unten.3mf
production/rev-C/3_druck/sensor/passprobe_huelse_unten.stl
production/rev-C/3_druck/sensor/schottkeil.3mf
production/rev-C/3_druck/sensor/schottkeil.stl
production/rev-C/3_druck/sensor/stoessel.3mf
production/rev-C/3_druck/sensor/stoessel.stl
production/rev-C/3_druck/sensor/taste_blau.3mf
production/rev-C/3_druck/sensor/taste_blau.stl
production/rev-C/3_druck/sensor/tastenteller.3mf
production/rev-C/3_druck/sensor/tastenteller.stl
renders/phase3/familie.blend
renders/phase3/gateway.blend
renders/phase3/p1_facette.blend
renders/phase3/p2_keil.blend
renders/phase3/p3_stele.blend
renders/phase3/p4_gipfel.blend
renders/phase3_v2/g1v2_familie.blend
renders/phase3_v2/g1v2_gateway.blend
renders/phase3_v2/p3v2_explosion.blend
renders/phase3_v2/p3v2_nah.blend
renders/phase3_v2/p3v2_topf_grau1.blend
renders/phase3_v2/p3v2_topf_grau2.blend
renders/phase3_v2/p3v2_unten.blend
renders/phase3_v3/app_icon_render_2048.blend
renders/phase3_v3/g1v3_familie_3sensoren.blend
renders/phase3_v3/g1v3_gateway.blend
