sgeisser1/Tr-pfli/mechanical/PRINT_SETTINGS.md

# fluidi – Druckeinstellungen Sensor P3 und Gateway G1 v4 für Raspberry Pi Zero 2 W (Bambu Lab P1S)

Stand 2026-11-07, Phase 4b Welle 1; Phase 6 (2026-11-09): Werkstoff-Alternative eSun ASA+ (Kap. 1/2), Gateway-Klimamodul
SEN0428 (D-029), RTC gestrichen (D-028), Gewindeeinsatz Ø4.6 (Kap. 3–5), Batteriefachschraube TX6; Lichtfenster
**Polymaker ASA Natural** und Fensterkleber **UHU plus endfest 300** (Kap. 1, 2, 5; D-033). Phase-6-Prüfung (R W-7, K-l2, K-l7):
Gateway-Status-LED 3 mm im Wannen-Rohr statt LED-Platine, O-Ringe EPDM mit dünnem Fettfilm, Bambu-Studio-Einrichtung Kap. 2a.
Druckdateien werden von den Generatoren erzeugt und liegen bereits in **Druckausrichtung** (auf z = 0, mittig):

```
.venv/bin/python mechanical/gen/fluidi_params.py      # Schnittstelle + Masse
freecadcmd mechanical/gen/fluidi_sensor.py           # mechanical/sensor/print/*.{3mf,stl,step}
freecadcmd mechanical/gen/fluidi_gateway_pi.py       # mechanical/gateway_pi/print/*.{3mf,stl,step}  (Gateway G1 v4, D-014)
freecadcmd mechanical/gen/fluidi_drawings.py         # mechanical/drawings/FL-*.pdf
```

**Gateway:** gültig ist nur **G1 v4 für den Raspberry Pi Zero 2 W** (`mechanical/gateway_pi/`, D-014). Der Ordner
`mechanical/gateway/` (G1 v3 für ESP32/XIAO, `fluidi_gateway.py`) ist durch D-014 ersetzt und wird **nicht gedruckt**.

Die **3MF-Dateien enthalten nur die Geometrie** (FreeCAD-Netzexport, ein Objekt je Datei, bereits in Druckausrichtung) –
kein Drucker-, Filament- oder Prozessprofil. Einstellen in Bambu Studio nach **Kap. 2a**.

## 1 Werkstoff

| | Wahl | Beleg |
|---|---|---|
| Gehäuse (alle tragenden Teile) | **Bambu ASA** (UV- und feuchtebeständig, kein PLA) | `docs/references/BambuLab_ASA_TechnicalDataSheet_V2.0.pdf` S.1–2: HDT **92 °C** (ISO 75, 1.8 MPa) / 100 °C (0.45 MPa), Vicat 106 °C, E 2450 MPa (XY) / 2120 MPa (Z), Zugfestigkeit 52 / 35 MPa (XY / Z) → REQ-MECH-12 (HDT ≥ 80 °C) **erfüllt** |
| Alternative (Phase 6, nur wenn Bambu ASA fehlt) | **eSun ASA+** (bastelgarage.ch Blau 424238 / Kaltweiss 424234 lagernd, Grau 424233 ausverkauft, 2026-11-09) – **bedingt gleichwertig**, siehe unten | `docs/references/eSUN_ASAplus_TDS_V1.0-2024-06.pdf` S. 1: HDT **95.5 °C (GB/T 1634, 0.45 MPa)**, kein 1.8-MPa-Wert; Zug 35.7 MPa, Biegemodul 2364 MPa, Izod 14.9 kJ/m² (spritzgegossene Proben); S. 2: Düse 250–280 °C, Bett 100–110 °C, Lüfter 10–50 %, **auf Bambu P1S 0.4 mm ermittelt** |
| Farben | Hülse/Wanne Warmgrau hell #B9B5AC, Kappe/Taste/Deckel Hellblau (D-010/D-011) | Filamentton nach Musterdruck wählen (P3_FLUIDI.md Kap. 6). **Pigment ohne Russ/Metall** im Antennenbereich (Kappe, Deckel) – **ANNAHME**, beim Filamentkauf prüfen (Elektronikbericht 2.4 Pkt. 3) |
| Lichtfenster | **Polymaker ASA Natural** (PF01006, 1.75 mm, 3djake.ch PM-PF01006), unpigmentiert, Aussenfläche matt (Diffusor). Lichtweg im Fenster massiv: Tropfen 1.6 + Lichtschaft Ø 3.0 × 2.4 = **4.0 mm** (Sensor), Platte 1.6 (Gateway) | `docs/references/Polymaker_ASA_TDS_V6.0-2025-12-02.pdf` S. 1: HDT **100 °C (ISO 75, 1.8 MPa)** / 103 °C (0.45 MPa), Vicat 105 °C, Tg 98 °C → REQ-MECH-12 **erfüllt**; Lichttransmission im TDS „N/A“ → Durchlässigkeit **ANNAHME** (unpigmentiert = milchig-transluzent), PROTOTYP-PRÜFUNG LED-Sichtbarkeit. **Nicht** PETG natur (HDT 64 °C laut Händlern, kein TDS) und **nicht** eSun ASA+ Kaltweiss (TiO₂-weiss deckend, 4 mm massiver Lichtweg; nur als Notlösung mit hohlem Lichtschaft, nicht konstruiert) |
| Kragen, Stössel, Schottkeil, Lehren | ASA, Farbe beliebig (Reste) | im Gehäuse unsichtbar |
| Trocknen | 80 °C, 8 h vor dem Druck, Lagerung < 20 % rF; Polymaker ASA Natural **70 °C, 7 h** | TDS S.1 (eSun ASA+: TDS „N/A“ → gleich wie Bambu ASA, **ANNAHME**); Polymaker-TDS S. 1 |

**Bewertung eSun ASA+ gegen Bambu ASA (Phase 6):**
- **Wärme (REQ-MECH-12):** 95.5 °C bei 0.45 MPa ≥ 80 °C → erfüllt laut Datenblatt. Vergleich bei gleicher Last: Bambu 100 °C,
  eSun 95.5 °C (−4.5 K). Für 1.8 MPa gibt eSun keinen Wert an. Die Gehäuseteile sind bei 65 °C kaum belastet (Wandspannungen
  < 3 MPa, `simulation/fem/REPORT.md`), nur unter dem Schraubenkopf ≈ 11 MPa Pressung lokal. **Widerspruch:** Die
  Händlerseite, die das TDS verlinkt (grobotronics.com), nennt 78 °C bei 0.45 MPa. Darum gilt eSun ASA+ erst nach der
  **PROTOTYP-PRÜFUNG** 7 d bei 65 °C (Hülse mit Schraube angezogen, Kappe mit O-Ringen montiert, Wanne/Deckel):
  keine Verformung > 0.1 mm an Dichtflächen und Schraubensitz, O-Ring-Gleitsitz unverändert.
- **Festigkeit:** Zug 35.7 MPa (spritzgegossen) gegen Bambu 52 MPa (gedruckt XY, angelassen). Gedruckt ist eSun
  vermutlich schwächer (Z-Wert nicht angegeben). Kleinster Sicherheitsfaktor der Gehäuseteile (Kippen Hülsenboden, 2.9 MPa
  Schub, `simulation/fem/REPORT.md`) sinkt mit 0.5 × 35.7 = 18 MPa von ≈ 9 auf ≈ 6 → ausreichend (Soll ≥ 2).
  Biegezunge Kappe: Biegemodul 2364 MPa vs. Bambu E 2450 MPa (XY) → Schaltkraft ≈ −4 %, innerhalb der Toleranz.
- **UV/Feuchte:** Beide Datenblätter nur qualitativ („better resistance to ultraviolet light“ bzw. „exceptional UV“),
  keine Prüfnorm → gleichwertig nach Datenlage, keine Zahl. Wasseraufnahme gibt eSun nicht an.
- **Druckbarkeit P1S:** vom Hersteller auf P1S ermittelt. Bett 100–110 °C laut TDS; der P1S erreicht laut Bambu max.
  100 °C (**ANNAHME**, Herstellerangabe nicht lokal) → 100 °C. Höhere Düsentemperatur 270 °C (Probedruck 275 °C).
- **Pigment:** Blau/Kaltweiss ohne Angabe zu Russ/Metall → wie bisher **ANNAHME**, RSSI-Messung (Antennenbereich Kappe/Deckel).
- **Mischung:** Ein Teil = ein Material. Gleiche Teile einer Serie nicht aus verschiedenen Filamenten (Passungen, Schwindung).
  Vor dem ersten eSun-Teil Passproben (Kap. 4) mit eSun neu drucken.
- **Farbe:** Grau ist auch bei eSun ausverkauft. Kaltweiss statt Warmgrau weicht von D-010 ab → Entscheid Auftraggeber.

## 2 Profil (Bambu Studio, Basis: Systemprofil „Bambu ASA“ + „0.16mm Optimal @BBL P1S“)

Für **eSun ASA+** (Kap. 1, Alternative) gelten dieselben Werte ausser: Filamentprofil „Generic ASA“, Düse **270 °C**
(erste Schicht 275 °C), Bett **100 °C**, Bauteillüfter 10 % (max. 30 %), Flussrate und Pressure Advance mit der
Kalibrierung von Bambu Studio für die Rolle bestimmen (eSun-TDS S. 2: 250–280 / 100–110 °C / 10–50 %).

Für das **Lichtfenster aus Polymaker ASA Natural** (Kap. 1): Filamentprofil „Generic ASA“, Düse **260 °C** (erste Schicht
260 °C), Bett **90 °C**, Bauteillüfter **aus** (Polymaker-TDS S. 1: Düse 230–260 °C, Bett 75–95 °C, Lüfter OFF, geschlossener
Bauraum, Prüfkörper bei 260/90 °C), Schicht 0.12 mm, 100 % Füllung (Fenster ist ohnehin massiv). Wegen der kurzen
Schichtzeit **6–10 Fenster** mit ≥ 10 mm Abstand auf einer Platte drucken (Schichtzeit ≥ 10 s ohne Lüfter). Eigener Druckauftrag,
keine Mischung mit farbigem Filament im selben Teil (Farbverschleppung trübt das Fenster).

| Parameter | Wert | Bemerkung |
|---|---|---|
| Drucker / Düse | P1S, 0.4 mm gehärtet oder Standard | |
| Druckplatte | Engineering Plate oder High Temperature Plate, **Klebestift** | TDS S.1 |
| Düsentemperatur | **260 °C** (erste Schicht 265 °C) | TDS-Bereich 240–270, Prüfkörper bei 260 |
| Betttemperatur | **90 °C** | TDS 80–100 |
| Bauraum | **Haube geschlossen**, 10 min mit Bett 90 °C vorheizen (Ziel 45 °C, TDS 45–60), Deckel/Oberseite zu | P1S hat keine Kammerheizung |
| Bauteillüfter | 10 % (ab Schicht 3), max. 30 % für Kleinteile (< 10 s/Schicht), Hilfslüfter **aus** | TDS 0–80 %; ASA verzieht bei starker Kühlung |
| Schichthöhe | **0.16 mm** Hülse, Kappe, Kragen, Wanne, Deckel; **0.12 mm** Taste, Klemmring, Teller, Stössel, Fenster | Logo-Strich 1.00 mm (Sensor V4) / 1.14 mm (Gateway) |
| Wände | **4** (≈ 1.7 mm) → Wände 1.6/2.0 mm werden massiv | |
| Deck-/Bodenschichten | 6 / 5 | |
| Füllung | **100 %** (Kleinteile), sonst 40 % Gyroid (nur Gateway-Dome) | Sensorwände sind ohnehin massiv |
| Naht | **hinten** („Back“), Naht verbergen; auf den O-Ring-Gleitflächen (Hülse innen z 2–8 und 30–35, Rev B) Naht mit 600er-Papier glätten | Leckkanal quer zur Dichtung vermeiden (Mechanikbericht 2.1) |
| Elefantenfuss | 0.15 mm | Hülse, Kragen, Wanne |
| XY-Lochkompensation | 0.0 (zuerst Passungsprobe drucken, dann ggf. +0.05) | Kap. 4 |
| Geschwindigkeit | Standard „Optimal“, Aussenwand ≤ 120 mm/s | TDS < 250 mm/s |
| Stützen | **keine** (alle Teile stützenfrei, Kap. 3) | |
| Rand (Brim) | Hülse 3 mm Mausohren an den Ecken, Wanne/Deckel 3 mm | Verzug ASA |

## 2a Druckdateien in Bambu Studio einrichten (3MF enthalten keine Profile)

Begründung: Bambu-Studio-Projektdateien (3MF mit Platten, Profilen und Objekt-Einstellungen) erzeugt nur Bambu Studio
selbst; das Format ist herstellerspezifisch und versionsabhängig, Bambu Studio ist in der Projektumgebung nicht
installiert (keine Installation ohne Freigabe). Ein vom Skript geschriebenes Projekt liesse sich hier nicht prüfen →
**abgelehnt**, stattdessen diese Anleitung. Menünamen nach Bambu Studio 1.9/2.x (**ANNAHME**, je nach Version leicht anders).

1. **Drucker:** „Bambu Lab P1S 0.4 nozzle“. **Prozess:** „0.16mm Optimal @BBL P1S“ bzw. „0.12mm Fine @BBL P1S“ (Kap. 2,
   Zeile Schichthöhe). **Filament:** „Bambu ASA“; eSun ASA+ und Polymaker ASA Natural als „Generic ASA“ mit den Werten aus
   Kap. 2 (eigenes Benutzerprofil speichern, z. B. „fluidi eSun ASA+ 270/100“, „fluidi Polymaker ASA Natural 260/90 Lüfter 0“).
2. **Import:** *Datei → Importieren → 3MF/STL* der Dateien aus `mechanical/sensor/print/` bzw. `mechanical/gateway_pi/print/`.
   Frage „als ein Objekt mit mehreren Teilen laden?“ → **Nein**. **Nicht** automatisch ausrichten und nicht drehen: die
   Teile liegen schon in der Ausrichtung aus Kap. 3 (z. B. Kappe und Deckel kopfüber).
3. **Prozess-Werte global** (Prozessprofil kopieren und als „fluidi ASA“ speichern): Wände **4**, Deck/Boden **6/5**,
   Füllung **100 %** (Gateway-Dome 40 % Gyroid), Naht **hinten**, Elefantenfuss **0.15**, XY-Lochkompensation **0.0**
   (nach Passprobe Kap. 4), Stützen **aus**, Aussenwand ≤ 120 mm/s, Bauteillüfter laut Filamentprofil (Kap. 2).
4. **Je Objekt** (Rechtsklick auf das Objekt → *Einstellungen hinzufügen*): Rand (Brim) 3 mm bzw. Mausohren bei Hülse,
   Wanne, Deckel; Kappe zusätzlich „Lücken füllen“ ein, Linienbreite Wand 0.42 (Kap. 3, R3-W3).
5. **Platten** (eine Schichthöhe und ein Filament je Platte; **ANNAHME**: Bambu Studio verlangt bei mehreren Objekten auf
   einer Platte dieselbe Schichthöhe):

| Platte | Teile | Filament | Schicht |
|---|---|---|---|
| S-1 | `passprobe_huelse_unten`, `passprobe_huelse_oben` (einmal, vor allem anderen), danach `huelse_grau` | ASA Warmgrau | 0.16 |
| S-2 | `kappe_blau` (kopfüber) | ASA Hellblau | 0.16 |
| S-3 | `kragen`, `schottkeil`, 2 × `distanzlehre_24p2` | ASA beliebig (Rest) | 0.16 |
| S-4 | `taste_blau`, `klemmring`, `tastenteller`, `stoessel` | ASA Hellblau | 0.12 |
| S-5 | 6–10 × `fenster_tropfen` (+ `fenster_tropfen_gw`), Abstand ≥ 10 mm | Polymaker ASA Natural | 0.12 |
| G-1 | `wanne_grau` (oder `wanne_grau_otg`) | ASA Warmgrau | 0.16 |
| G-2 | `deckel_blau` (kopfüber) | ASA Hellblau | 0.16 |

6. **Prüfen vor dem Druck:** Vorschau „Überhang“ – rote Flächen nur dort, wo Kap. 3 sie als Brücke/45° nennt; geschätzte
   Masse mit der Spalte g in Kap. 3 vergleichen (± 15 %). Projekt als `.3mf` **lokal** speichern (nicht ins Repository:
   versions- und druckerabhängig); Druckzeit in Kap. 3 nachtragen.

## 3 Teile und Druckausrichtung

### Sensor (`mechanical/sensor/print/`, Masse in mm)

| Datei | Teil | Farbe | Ausrichtung (wie exportiert) | Kritische Stellen | g |
|---|---|---|---|---|---|
| `huelse_grau` | Hülse | Warmgrau | stehend, Boden auf dem Bett | Logo-Relief 0.25 auf senkrechter Wand (19.4 mm); Warnsymbol innen vertieft 0.3; Kerbe oben offen; 4 Ablaufschlitze 3 × 1.2 hinten (Brücke 3 mm); Furchlippe Ø 1.7 in den ersten 3 Schichten; Höhe 44.7 | 7.5 |
| `kappe_blau` | Kappe mit Zapfen, Schott, Biegezunge | Hellblau | **kopfüber** (Decke auf dem Bett) | Tastentasche im Bett; Schott = Brücke 5.5 mm; O-Ring-Nut-Flanke 1.35 mm Überhang (ohne Stütze druckbar, Probedruck); Zunge 0.6 mm (P5-M2, 1–2 Bahnen, Arachne) mit Nase; **Nasen-Oberseite 30° zur Waagrechten = kopfüber 60° Überhang auf 1.2 mm** (ohne Stütze, Probedruck; hängt sie durch, Fläche mit 600er nacharbeiten); Führungsrippe vor dem Finger; D-Bohrung Stössel; Boden unter dem Membransitz 0.8 (Sektor zur Platine 0.3, W-1); Ablaufstufe am Zapfen = 0.5 mm Überhang (kopfüber ohne Stütze); dünnste Zapfenwand 0.54 mm hinter den hinteren Nutecken; **Phase 5: 45°-Trichter verbindet Zapfen und Kappenwand (P5-M1, vorher 2 getrennte Körper), Mantel 0.8 um die Membran-Senkung (P5-M3)**; Massbild `mechanical/drawings/FL-S-02_kappe_blau.pdf` | 4.7 |
| `kragen` | Kragen (Vergussform) | beliebig | stehend | Mutterntasche von vorne = Brücke 4.6 mm; Nutflanke 1.35 mm | 0.8 |
| `fenster_tropfen` | Lichtfenster Sensor | Polymaker ASA Natural | Tropfenfläche auf dem Bett, Schaft nach oben | Aussenfläche matt (Bettstruktur Textured PEI oder Engineering Plate = Diffusor; Polymaker-TDS S. 1: PC/Textured PEI) | 0.1 |
| `taste_blau` | Taste 9 × 6 | Hellblau | Oberseite auf dem Bett | Hals Ø 3.0 | 0.1 |
| `klemmring` | Klemmring Membran, **Presssitz 0.05 je Seite** in der Senkung, verpresst die Membran 0.1 mm (R3-W2) | Hellblau | Platte auf dem Bett | Rand 0.4; Unterseite der Schürze = Dichtfläche zur Membran (oberste Lage, nicht nacharbeiten) | < 0.1 |
| `tastenteller` | Teller (auf den Tastenhals gepresst) | Hellblau | flach | 0.4 mm dick = 3 Schichten | < 0.1 |
| `stoessel` | Stössel mit Finger, 60°-Keil unten (P5-M2 Runde 2) | beliebig | flach auf der D-Fläche; Arm und Finger bündig mit der D-Fläche → vollflächig auf dem Bett, stützenfrei (W-3) | Finger 1.25 × 1.2 mm, Keil scharfkantig; Schaft Ø3 D-Profil | < 0.1 |
| `schottkeil` | Schottkeil | beliebig | flach | | < 0.1 |
| `distanzlehre_24p2` | Montage-Lehre Kragen–Schott 24.2 mm (2 Stück, wiederverwendbar; V-K, D-023) | beliebig | stehend | | |
| `passprobe_huelse_unten/_oben` | Passungsproben (vor der ersten Hülse) | Warmgrau | stehend | Gleitsitz Kragen/Zapfen, O-Ring-Verpressung, Furchlippe | |

ASA pro Sensor ≈ **13 g** (Kopf V4, Rev B; Rev A ≈ 9 g) (≈ CHF 0.25, **ANNAHME** CHF 25/kg), kein AMS-Farbwechsel (jedes Teil einfarbig). Druckzeit-Schätzung nach Slicen eintragen.

### Gateway G1 v3 (`mechanical/gateway/print/`) – ersetzt, nicht drucken

G1 v3 für ESP32/XIAO ist durch D-014 (Raspberry Pi Zero 2 W) ersetzt. Die Dateien bleiben nur als Entwicklungsstand im
Repository; gedruckt wird G1 v4 (nächster Abschnitt).

### Gateway G1 v4 für Raspberry Pi Zero 2 W (`mechanical/gateway_pi/print/`, D-014)

Erzeugen: `freecadcmd mechanical/gen/fluidi_gateway_pi.py` (schreibt auch `check_gateway_pi.txt` und `preview.png`).
Aussen 84 × 42 × 20 mm, Profil, Facette, Fuge und Tropfen wie G1 v3; Profil und Material wie Kap. 1–2.

| Datei | Teil | Farbe | Ausrichtung | Kritische Stellen | g |
|---|---|---|---|---|---|
| `wanne_grau` | Wanne mit Pi-Abstandshaltern, **LED-Rohr** für die 3-mm-Status-LED (Bohrung Ø 3.1, Kragen an der Innenfacette), 2 Kabelhalter vorne, Trennwand Klimakammer, Bodenschiene Klimamodul (Nut 1.9, 1.0 tief, mit Endanschlägen), Kabelkanal | Warmgrau | Boden auf dem Bett | Senkkopfbohrungen unten (Brücke über Ø 5.4); Micro-USB-Fenster 11.4 × 7.8 (Brücke 11.4); LED-Rohr Ø 4.7 hängt 45° an der Innenfacette (ohne Stütze; Bohrung Ø 3.1 unter 45° – nach dem Druck mit Bohrer Ø 3.1 von Hand nachreiben, Probedruck); Kabelhalter-Lippe 0.8 Überhang; Kabelkanal Ø 3.0 waagrecht; Stirnschlitze 1.2 hoch (Brücken 20 mm); Schienenwände 0.8 (2 Bahnen) | 13.9 |
| `wanne_grau_otg` | wie oben, zusätzlich Micro-USB-OTG-Fenster (XIAO-Empfänger extern, D-014) | Warmgrau | wie oben | Steg zwischen den Fenstern 1.2 mm | 13.8 |
| `deckel_blau` | Deckel mit 4 Niederhalterrohren Ø 7.0 / Fuss Ø 5.6 (Einsatz M2.5 Ø 4.6, Bohrung 3.9), Steg, Gegenrippe Klimakammer, Nutrippe Klimamodul (D-028: kein RTC-Rahmen mehr) | Hellblau | **kopfüber** | Facette 45°; vordere Rohre stehen auf der Innenfacette; Rohre an HDMI/Micro-USB/microSD-Halter abgeflacht (0.3 Luft); Steg vorne bewusst weggelassen (sonst nicht senkrecht montierbar) | 10.2 |
| `fenster_tropfen_gw` | Lichtfenster | Polymaker ASA Natural | Aussenfläche auf dem Bett | | 0.1 |

Montage: 4 Litzen an die Lötaugen des Klimamoduls **DFRobot SEN0428** (D-029) löten (von der Rückseite, Litzen zeigen
nach −x), Bündel von der Kammer aus durch den Kanal Ø 3.0 (y −2.5) in der Trennwand fädeln, an die Pi-Lötaugen löten
(3V3 Pin 1, SDA Pin 3, SCL Pin 5, GND Pin 6 oder 9; Pi ohne Stiftleiste). Pi auf die 4 Abstandshalter legen (Buchsen in die
inneren Freistiche der Rückwand). Modul senkrecht in die Bodenschiene stecken: **Sensorseite zur Stirnwand (+x),
Lötaugen-Kante zum Kabelkanal (vorn, y −6.5), Bohrungs-Kante hinten**; die Deckelrippe fasst beim Schliessen die
Oberkante (0.8 mm). Kanal mit Silikon vergiessen (Zugentlastung und Luftsperre).
**Status-LED (R W-7, D-027, BOM G9; Schaltung GATEWAY_SETUP Kap. 5.2):** grüne 3-mm-LED Kingbright WP710A10GD
(`docs/datasheets/Kingbright_WP710A10GD_Datasheet_V10B.pdf` S. 1: Flansch Ø 3.2 × 1.0, Spitze–Flanschrückseite 4.6 ± 0.3).
Beine 1 mm hinter dem Flansch abwinkeln und auf ≈ 5 mm kürzen, 470 Ω ans **Anodenbein** (langes Bein), Litzen AWG 28
(≈ 70 mm) an Widerstand bzw. Kathode, Lötstellen mit Schrumpfschlauch. LED **vor dem Pi** von innen in das Rohr hinter dem
Tropfen stecken, bis der Flansch an der Rohrstirn anliegt (Spitze dann 0.1 mm hinter dem Fenster); Flansch mit einem
Tropfen UHU plus endfest 300 an der Stirn fixieren (Schutz wie MONTAGE_SENSOR Kap. 3 Schritt 1; nicht auf die Linse).
Litzen nach unten-vorn zum Boden und zwischen Frontwand und den **2 Kabelhaltern** (Kanal 3.0 breit, unter der Lippe
einfädeln) nach links bis vor die Lötaugen führen, dann über die Platinenkante an **J8 Pin 11 (GPIO17, über 470 Ω)** und
**Pin 14 (GND)** löten. Erst dann den Pi einlegen (`check_gateway_pi.txt` 15: Pi-Kante zur LED 0.42 mm).
Deckel senkrecht aufsetzen, umdrehen, 4 × M2.5 × 8 (ISO 7380, **ANNAHME**) von unten durch Abstandshalter und Pi-Bohrung
in die Einsätze (Kaufteil bastelgarage 425681: Ø 4.6 × 4, Bohrung 3.9, Einschmelzen Kap. 5) – die 4 Schrauben halten Pi
und Deckel zugleich. Nylonschrauben als Option, falls die RSSI-Messung mit
Stahlschrauben schlechter ist (PROTOTYP-PRÜFUNG). microSD bleibt innen (Zugang nach Lösen der 4 Schrauben).

**Vor dem ersten Druck am vorhandenen Pi messen** und in `PI`/`PARTS` des Generators eintragen: Platinendicke
(ANNAHME 1.0), Höhen HDMI/Micro-USB/microSD-Halter/Kamerabuchse, Überstand der microSD-Karte (ANNAHME 2.5),
Umspritzung des Netzteilsteckers (ANNAHME ≤ 10.6 × 7.0).

### Druckvorgabe Zapfenwand an den hinteren Nutecken (Sicherheit R3-W3)

Zwischen O-Ring-Nut (Zapfen, z 31.3 … 33.7) und Elektronikraum bleiben an den hinteren Nutecken nur **0.54 mm** Wand
(`check_sensor.txt` 9). Geometrisch ist ≥ 0.8 mm in Rev C nicht möglich: Die Wand liegt zwischen Nutgrund-Ecke (R 3.0,
O-Ring-Dehnung 2.1 %) und der Platinenecke (x 13.0, y 8.2); ein grösserer Innenradius des Zapfens würde die Platinenecke
schneiden (Ecke darf höchstens R 0.68 haben → Wand ≤ 0.64 mm). Darum für die Kappe:
- Wände 4, Füllung 100 %, „Lücken füllen“ **ein**, Linienbreite Wand 0.42, keine Naht an den hinteren Ecken (Naht hinten-Mitte).
- Nach dem Druck: Kappe gegen eine Lampe halten, die Ecken dürfen kein Licht durchlassen; Prüfung ST-W6 (b).
- Rev D: Wand ≥ 0.8 mm (Platine oder Nut ändern).

## 4 Toleranzen (FDM P1S, 0.4 mm) – im CAD umgesetzt

Fertigungszeichnungen aller Druckteile (Phase 5): `mechanical/drawings/FL-*.pdf`, erzeugt mit
`freecadcmd mechanical/gen/fluidi_drawings.py` (Prüfprotokoll `mechanical/drawings/drawings_check.txt`).

| Fügung | Spiel je Seite | Herkunft |
|---|---|---|
| Hülse innen ↔ Zapfen / Kragen (Gleitsitz) | 0.20 | Mechanikbericht 2.6 |
| O-Ring-Einbauraum radial | 1.35 ± 0.10 → Verpressung 15–33 % (Rev B: AS568-019, Schnur 1.78 ± 0.08, Dehnung 2.1 %) | `check_sensor.txt` Pkt. 7 |
| Dachziegelrand Hülse (0.7) im Kappenschlitz | 0.10 aussen, 0.70 innen (Rev B: Ablaufspalt) | S3-W3 |
| Sichtschale ↔ Zapfen oberhalb der Ablaufstufe (Rev B) | 0.70 (kein Kapillarspalt) | PCB_OUTLINE.md Kap. 7 |
| Sondenschlitz Boden | 0.4 (Sonde inkl. Beschichtung ≤ 2.0 × 20.4) | |
| Platine im Kragen / Schott | 0.15 / 0.2 (mit Epoxid gefüllt) | |
| Fenster in Kappe, Lichtschaft in Zapfen | 0.10 Klebespalt | |
| Taste in Tasche | 0.40 (Sichtspalt, Design) | D-010 |
| Stössel in Rohr | 0.10 | |
| Gateway Deckelsteg in Wanne | 0.15 | |
| Gewindeeinsatz M2.5 (Gateway) | Bohrung Ø **3.9**, Tiefe 5.2 ab Rohrende, Einsatz 0.5 versenkt (Einsatz Ø 4.6 × 4) | Händler bastelgarage 425681: Bohrung 3.9, Tiefe ≥ 4.5 (`docs/references/bastelgarage_Gewindeeinsatz-Schraube_Auszug_2026-11-09.txt`); Wand um die Bohrung 1.15–1.55, im Fuss 0.85 (`check_gateway_pi.txt` 3) |
| G1 v4: Pi-Platine zu Wänden / microSD-Karte zur Trennwand | 0.4 (Buchsenseite) bzw. ≥ 1.0 / 1.5 | `check_gateway_pi.txt` |
| G1 v4: Micro-USB-Umspritzung im Fenster | 0.4 je Seite | |
| G1 v4: Klimamodul SEN0428 in Bodenschiene / Deckelnut | 0.15 je Seite (Nut 1.9 für Platine 1.6 **ANNAHME**), Eingriff 1.0 / 0.8, 0.3 Luft über der Oberkante und an den Endanschlägen | `check_gateway_pi.txt` 14; Platinendicke am Muster messen (Nut = Dicke + 0.3) |
| G1 v4: Deckel-Gegenrippe zur Trennwand | 0.3 (= Fuge) | |
| G1 v4: Status-LED 3 mm im Wannen-Rohr | Bohrung Ø 3.1 für Körper 2.9 (0.10 je Seite), Flansch an der Rohrstirn (Klebesitz); LED-Rohr zum Niederhalterrohr 0.61, Pi-Kante zur LED 0.42 | `check_gateway_pi.txt` 15; WP710A10GD Datenblatt S. 1 |

**Vor der ersten Serie:** `passprobe_huelse_unten` + `kragen` + O-Ring und `passprobe_huelse_oben` + `kappe_blau` drucken
und prüfen: Hülse gleitet mit Silikonfett ohne Klemmen, O-Ring sichtbar verpresst, Schraube M2 × 3 (V-K, D-023) furcht durch die Lippe und
dreht danach frei (Phase 6: Kaufteil M2 × 3 Linsenkopf **Torx TX6**, Kopf 1.6 hoch, bastelgarage 422191; Kopf-Ø messen,
≤ 4.2 zulässig, `check_sensor.txt` 5c). Bei Bedarf XY-Lochkompensation anpassen, nicht die Geometrie.

## 5 Nacharbeit und Montage-Hilfsstoffe

- Hülse: Gleitflächen innen (z 2–8, 30–35) glätten, Ablaufschlitze frei halten, Kerbe innen entgraten (O-Ring läuft darüber).
- Fenster: Aussenseite matt lassen. Kleben mit **UHU plus endfest 300** (2K-Epoxid, `docs/references/UHU_PlusEndfest300_TDS_2012-07.pdf`;
  Vorschlag Mechanik 2026-11-09, Ablauf und Schutzmassnahmen `docs/manuals/MONTAGE_SENSOR.md` Kap. 3 Schritt 1).
  **Transparenz ist nicht nötig:** Der Klebstoff sitzt nur im Spalt 0.1 mm am Tropfenrand und am Mantel des Lichtschafts
  (CAD `fluidi_sensor.py`: Ausschnitt = Tropfen r 2.5, Fenster r 2.4; Bohrung Ø 3.2, Schaft Ø 3.0). Der Lichtweg LED → Schaft-
  Stirnfläche (y 4.0, 2.0 mm vor der LED) → Schaft → Tropfen-Sichtfläche (y 0) läuft durch das Fenstermaterial, nicht durch die
  Klebefuge. Sichtbar bleibt aussen nur der 0.1-mm-Fugenring. Ein heller, deckender Kleber reflektiert am Schaftmantel eher
  zurück als ein schwarzer (ER2223 schwarz, 800 mPa·s, kriecht in 0.1-mm-Spalten auf die Stirnflächen → für das Fenster
  abgelehnt). UHU: Binder 40 000 / Härter 30 000 mPa·s, „minimales Laufbestreben“ (TDS S. 1/S. 2), −40 … +100 °C (S. 1).
  **Pflicht:** Schaft-Stirnfläche (Lichteintritt) und Sichtfläche frei von Klebstoff. Klebeflächen anrauen (TDS S. 4: Körnung 100)
  und mit **Isopropanol** entfetten – **nicht Aceton** (TDS-Empfehlung gilt für Metall; Aceton löst ASA an, **ANNAHME**
  Werkstoffkenntnis). Das TDS nennt ASA weder geeignet noch ungeeignet (S. 1/S. 5: ungeeignet PE, PP, PTFE, **PS**, Weich-PVC;
  ASA ist ein Styrol-Copolymer) → Haftung und Dichtheit **PROTOTYP-PRÜFUNG**.
- O-Ringe: Werkstoff **EPDM** (nicht Silikon), nur ein **dünner Film** Silikonfett (Parker ORD 5700,
  `docs/references/Parker_ORD5700_ORingHandbook_2007.pdf` PDF-S. 206: Silicone Greases EPDM 1 / VMQ 3; S. 50 Tab. 3-1:
  Montagefett sparsam; S. 16: EPDM nicht mit Mineralfett), farbig/ohne Russ bevorzugt (Antenne, **ANNAHME**); Ablauf
  MONTAGE_SENSOR Kap. 7 Schritt 2.
- Gateway: Gewindeeinsätze M2.5 (Ø 4.6 × 4) mit Lötkolben und Einschmelzspitze einsetzen, Temperatur = Drucktemperatur
  + 10–20 °C laut Händler → Bambu ASA **270–280 °C**, eSun ASA+ 280–290 °C. Deckel kopfüber, Einsatz senkrecht ansetzen,
  ohne Druck einsinken lassen bis **0.5 mm unter** die Rohrstirn (Lehre: Schraube M2.5 eindrehen, plan aufsetzen), danach
  ohne Bewegung abkühlen lassen. Im Fuss (unterste 1.5 mm, Wand 0.85) nicht verkanten. **PROTOTYP-PRÜFUNG:** ein Rohr
  probeweise bestücken, Fuss nicht aufgeplatzt, Schraube M2.5 mit Handanzug ohne Mitdrehen des Einsatzes.
- Gateway G1 v4: Status-LED im Wannen-Rohr mit einem Tropfen UHU plus endfest 300 am Flansch fixieren (Kap. 3, Montage).
  Vor dem Kleben das Rohr gegen Licht prüfen (Bohrung durchgehend frei).
