sgeisser1/Tr-pfli/mechanical/sensor/collision_pcb_step.txt

=== fluidi Sensor: Kollisionspruefung Gehaeuse <-> Platine (KiCad-STEP), Schnittstelle Rev C (2026-11-08) ===
Eingaben: hardware/sensor/out/fluidi_sensor.step, hardware/sensor/fluidi_sensor.kicad_pcb; Gehaeuse fluidi_sensor.build()
V-K-Verschiebung (nur falls Layout noch Rev-B-Lage; Layout Rev C: 0): BT1 -0.00 mm, U3 +0.00 mm, C24 +0.00 mm
Quetschrippen: Ueberdeckung Platine / Rippen 0.435 mm3 (gewollt, gequetscht); Kappe sonst ohne Rippen geprueft

A Koordinatenbezug
   Hilfsursprung KiCad (aux_axis_origin) X 150.000 Y 30.000 = Mitte Platinenoberkante (Soll: Kontur x +-13, z 53.5)
   Edge.Cuts (pcbnew, Kopfkoord.): x -13.025 ... 13.025, z -105.025 ... 53.525 (mit Strichbreite 0.05)
   STEP-Platine nach Transformation: x -13.000 ... 13.000, y 6.684 ... 8.200, z -105.000 ... 53.500
   Hinweis: STEP-Platinenkoerper 1.52 mm dick (KiCad: Summe der Dielektrika), Bauteile sitzen auf y = 6.60 (F, Soll 6.60)
   Konturvergleich STEP <-> fluidi_params.outline(): Flaeche 3374.85 / 3374.93 mm2, Abweichung (sym. Differenz) 0.076 mm2

B Bauteile: Lage, Hoehe (Modell bzw. Datenblatt), Zone
   Ref   Footprint                                    x       z  h_mod  h_max  Zone (hmax)                Befund
   AE1   Texas_SWRA117D_2.4GHz_Right               0.35   48.05   0.00   0.00  Z1_ANTENNE (0.0)           Pad/Kupfer
   R2    R_0402_1005Metric                         0.65   47.12   0.35   0.35  Z2_BAND_F (2.0)            ok
   C18   C_0402_1005Metric                         3.61   47.12   0.50   0.50  Z2_BAND_F (2.0)            ok
   L2    L_0402_1005Metric                         6.57   47.12   0.50   0.50  Z2_BAND_F (2.0)            ok
   R11   R_0402_1005Metric                        -2.10   46.66   0.35   0.35  Z2_BAND_F (2.0)            ok
   C20   C_0402_1005Metric                        -0.85   46.64   0.00   0.00  Z2_BAND_F (2.0)            DNP
   C19   C_0402_1005Metric                         2.14   46.64   0.00   0.00  Z2_BAND_F (2.0)            DNP
   C17   C_0402_1005Metric                         5.08   46.64   0.50   0.50  Z2_BAND_F (2.0)            ok
   C16   C_0402_1005Metric                         7.73   45.85   0.50   0.50  Z2_BAND_F (2.0)            ok
   Q1    SOT-23                                  -10.95   45.60   1.20   1.20  Z2_BAND_F (2.0)            ok
   SW1   SW_SPST_TS-1088-xR020                    -6.00   45.10   2.00   2.10  Z2_BAND_F (2.0)            ok nominal, +0.1 Toleranz
   R8    R_0402_1005Metric                        -2.10   44.70   0.35   0.35  Z2_BAND_F (2.0)            ok
   C10   C_0402_1005Metric                         6.05   44.40   0.50   0.50  Z2_BAND_F (2.0)            ok
   C8    C_0402_1005Metric                         9.60   44.40   0.50   0.50  Z2_BAND_F (2.0)            ok
   R6    R_0402_1005Metric                         1.78   44.00   0.35   0.35  Z2_BAND_F (2.0)            ok
   D1    LED_RGB_TUOZHAN_1615                      0.00   43.90   0.70   0.70  Z2_BAND_F (2.0)            ok
   R7    R_0402_1005Metric                        -2.10   42.74   0.35   0.35  Z2_BAND_F (2.0)            ok
   U5    SOT-353_SC-70-5                         -10.80   41.90   1.10   1.10  Z2_BAND_F (2.0)            ok
   R9    R_0402_1005Metric                        -0.20   41.55   0.35   0.35  Z2_BAND_F (2.0)            ok
   Q2    SOT-23                                   -6.95   41.45   1.20   1.20  Z2_BAND_F (2.0)            ok
   U1    VQFN-24-1EP_4x4mm_P0.5mm_EP2.45x2.45mm    6.00   40.90   1.00   1.00  Z2_BAND_F (2.0)            ok
   Y1    Crystal_SMD_3225-4Pin_3.2x2.5mm          10.80   40.90   0.64   0.64  Z2_BAND_F (2.0)            ok
   C22   C_0402_1005Metric                        -4.45   40.50   0.50   0.50  Z2_BAND_F (2.0)            ok
   R3    R_0402_1005Metric                        -3.40   40.50   0.35   0.35  Z2_BAND_F (2.0)            ok
   C6    C_0402_1005Metric                         2.30   40.15   0.50   0.50  Z2_BAND_F (2.0)            ok
   TP4   TestPoint_Pad_D1.0mm                     -8.00   39.90   0.00   0.00  Z2_BAND_F (2.0)            B-Seite, Pad
   U4    SOT-353_SC-70-5                         -10.80   39.25   1.10   1.10  Z2_BAND_F (2.0)            ok
   C21   C_0402_1005Metric                        -2.60   38.92   0.50   0.50  Z2_BAND_F (2.0)            ok
   C13   C_0402_1005Metric                         2.30   38.65   0.50   0.50  Z2_BAND_F (2.0)            ok
   U6    SOT-353_SC-70-5                          -6.90   38.35   1.10   1.10  Z2_BAND_F (2.0)            ok
   C7    C_0402_1005Metric                        11.05   38.20   0.50   0.50  Z2_BAND_F (2.0)            ok
   U2    SOT-353_SC-70-5                          -2.60   37.10   1.10   1.10  Z2_BAND_F (2.0)            ok
   C12   C_0402_1005Metric                         6.80   37.10   0.50   0.50  Z2_BAND_F (2.0)            ok
   L1    L_Sunlord_WPN201610H                      8.75   37.00   1.00   1.00  Z2_BAND_F (2.0)            ok
   C14   C_0402_1005Metric                         0.50   36.70   0.50   0.50  Z2_BAND_F (2.0)            ok
   Y2    Crystal_SMD_3215-2Pin_3.2x1.5mm           3.20   36.70   0.93   0.93  Z2_BAND_F (2.0)            ok
   C15   C_0402_1005Metric                         5.77   36.70   0.50   0.50  Z2_BAND_F (2.0)            ok
   R10   R_0402_1005Metric                       -12.15   36.60   0.35   0.35  Z2_BAND_F (2.0)            ok
   R12   R_0402_1005Metric                       -10.90   36.60   0.35   0.35  Z2_BAND_F (2.0)            ok
   C25   C_0402_1005Metric                        -9.60   36.60   0.50   0.50  Z2_BAND_F (2.0)            ok
   C9    C_0402_1005Metric                        10.60   36.50   0.50   0.50  Z2_BAND_F (2.0)            ok
   C11   C_0402_1005Metric                        11.75   36.50   0.50   0.50  Z2_BAND_F (2.0)            ok
   R13   R_0402_1005Metric                        -7.90   36.15   0.35   0.35  Z2_BAND_F (2.0)            ok
   TP5   TestPoint_Pad_D1.0mm                     -2.30   35.60   0.00   0.00  Z2_BAND_F (2.0)            B-Seite, Pad
   R4    R_0402_1005Metric                        -2.30   34.90   0.35   0.35  Z2_BAND_F (2.0)            ok
   C1    C_1206_3216Metric                       -10.35   34.30   1.60   1.60  Z2_BAND_F (2.0)            ok
   C2    C_1206_3216Metric                        -5.64   34.30   1.60   1.60  Z2_BAND_F (2.0)            ok
   C3    C_1206_3216Metric                         1.05   34.30   1.60   1.60  Z2_BAND_F (2.0)            ok
   C4    C_1206_3216Metric                         5.76   34.30   1.60   1.60  Z2_BAND_F (2.0)            ok
   C5    C_0402_1005Metric                         9.75   34.30   0.50   0.50  Z2_BAND_F (2.0)            ok
   R1    R_0402_1005Metric                        11.85   34.30   0.35   0.35  Z2_BAND_F (2.0)            ok
   R5    R_0402_1005Metric                        -2.30   33.85   0.35   0.35  Z2_BAND_F (2.0)            ok
   TP1   TestPoint_Pad_D1.5mm                    -10.60   28.00   0.00   0.00  Z4_FACH_F (4.1)            Pad/Kupfer
   TP2   TestPoint_Pad_D1.5mm                    -10.60   25.00   0.00   0.00  Z4_FACH_F (4.1)            Pad/Kupfer
   BT1   BatteryHolder_Keystone_3034_1x20mm_Neg    3.00   18.70   4.00   4.10  Z4_FACH_F (4.1)            ok (Fach 4.1)
   U3    SOT-563_TI_DRL0006A                      -6.69    4.90   0.63   0.63  Z5B_KRAGEN_BAUTEILE (0.0)  ok (Feld 0.7)
   C24   C_0402_1005Metric                        -8.45    4.80   0.50   0.50  Z5B_KRAGEN_BAUTEILE (0.0)  ok (Feld 0.7)
   -> Hoehenueberschreitungen: keine
   Quellen h_max: U1 TI_CC2340R5_Datasheet_SWRS272F.pdf S. 77, RGE0024B "1 MAX" (Ersatzmodell RGE0024H 0.8); L1 Sunlord_WPN201610H100MT_Datasheet_LCSC-2023-10.pdf S. 2, WPN201610H C max 1.0 (Ersatzmodell DFE201610P 1.0); D1 TUOZHAN_P4-1615G2B2R4TS2-06T-001-24_Datasheet_A0.pdf S. 4: 0.6 +-0.1, 1.6 x 1.5 +-0.1 (kein Modell im STEP); BT1 Keystone_3034_Catalog_M65.pdf S. 1: H .160 (4.1) (KiCad-Modell 4.0); SW1 XUNPU_TS-1088-AR02016_Datasheet_LCSC-2022-06.pdf S. 1: H 2.0, Allgemeintoleranz 0.5-2: +-0.10; U3 TI_TMP1075_Datasheet_SBOS854F.pdf S. 36, DRL0006A "0.6 MAX" (KiCad-Modell 0.63)

C Kollisionen in Endlage (Schnittvolumen > 1e-04 mm3) und kleinster Abstand je Bauteil
   -> keine Kollision
   (Clip/Zelle: Kontaktfeder des Modells ungespannt, Ueberdeckung 14.78 mm3 beabsichtigt)
   Kleinste Abstaende (<= 3 mm) Bauteil -> Gehaeuse:
   Antenne_Cu   0.70 Kappe_blau, 1.00 Membran_Silikon, 1.26 Stoessel
   BT1          0.48 Schottkeil, 0.48 Kragen, 0.48 Verguss_Kragen
   C1           0.60 Kappe_blau, 1.50 Schottkeil, 1.58 Verguss_Schott
   C2           0.60 Kappe_blau, 1.50 Schottkeil, 1.58 Verguss_Schott
   C24          0.70 Kragen, 3.00 Huelse_grau, 3.15 ORing_Kragen
   C3           0.60 Kappe_blau, 1.50 Schottkeil, 1.58 Verguss_Schott
   C4           0.60 Kappe_blau, 1.50 Schottkeil, 1.58 Verguss_Schott
   Q1           0.76 Kappe_blau, 2.95 Huelse_grau
   Q2           1.00 Kappe_blau, 3.80 Huelse_grau, 4.15 Stoessel
   R10          0.80 Kappe_blau, 3.00 Huelse_grau, 3.12 ORing_Zapfen
   SW1          0.25 Kappe_blau, 1.13 Stoessel, 2.78 Fenster_transluzent
   U3           0.40 Kragen, 2.81 Huelse_grau, 3.02 ORing_Kragen
   (alle anderen Bauteile >= 1.0 mm zum Gehaeuse)

D Lage der Platine in z (Platine + Bauteile + Zelle verschoben, Gehaeuse fest; Kragen per Lehre am Schott)
   freier Weg nach oben bis zum ersten Anschlag: 0.05 mm (PCB/Kappe_blau)
   dz -0.25 mm: keine Kollision
   dz +0.25 mm: PCB/Kappe_blau 2.000 mm3
   dz +0.40 mm: PCB/Kappe_blau 3.200 mm3
   dz +0.70 mm: BT1/Schottkeil 0.357 mm3, U3/Kragen 0.161 mm3, PCB/Kappe_blau 6.591 mm3

E Batterieclip Keystone 3034 und CR2032
   Footprint fluidi:BatteryHolder_Keystone_3034_1x20mm_NegPad4mm_W23p1, Zellmitte (x 3.00, z 18.70), Drehung 90 Grad
   Clipkoerper (Modell): x -4.76 ... 11.65, z 7.08 ... 30.32, Hoehe 4.00 (Datenblatt: x -4.4 ... 11.7, W 23.1, H 4.1)
   Anschlaglappen (reichen bis 0.4 mm ueber F): x -4.76 ... -1.62 -> geschlossenes Ende -x, Einschub/Ausschub +x (bestaetigt)
   Fach (Kragen-Oberkante z 6.60 bis Schott-Unterkante z 30.80): 24.20 mm; Z5B endet z 6.80, Z3 beginnt z 30.30
   Clip-Pads Footprint Rev B (Spanne 23.10), an die V-K-Lage verschoben: z 7.150 ... 30.250 -> Luft Kragen 0.55, Schott 0.55 mm
   Clip-Pads Layoutvorgabe (Spanne W 23.1, Katalogminimum): z 7.15 ... 30.25 (KiCad Y 23.250 ... 46.350) -> Luft Kragen 0.55, Schott 0.55 mm
     Toleranz Pad zur Vergusskante (Anschlag): JLC-Kontur +-0.2 (JLCPCB_NOTES Kap. 3), FDM Anschlag->Schott +-0.1, Lehre +-0.1 (nur Kragen) -> Schott +-0.22 RSS / +-0.30 worst, Kragen +-0.24 RSS / +-0.40 worst
     -> kleinste Luft inkl. Toleranz: Schott 0.33 (RSS) / 0.25 (worst), Kragen 0.31 (RSS) / 0.15 (worst); Forderung LS-W1 >= 0.30: erfuellt (RSS)
     Pads in Zonen: unten oberhalb Z5B-Grenze (z 6.80), oben unterhalb Z3-Grenze (z 30.30)
   Abstand Clip / Zelle - Kragen           0.48 / 2.10
   Abstand Clip / Zelle - Verguss_Kragen   0.48 / 2.10
   Abstand Clip / Zelle - Schottkeil       0.48 / 2.10
   Abstand Clip / Zelle - Verguss_Schott   1.50 / 2.10
   Abstand Clip / Zelle - Kappe_blau       1.50 / 2.10
   Abstand Clip / Zelle - Huelse_grau      0.95 / 1.14
   Abstand Clip / Zelle - ORing_Kragen     2.36 / 2.98
   Abstand Clip / Zelle - ORing_Zapfen     2.26 / 2.89
   Zelle 30 mm nach +x aus-/einschieben (Huelse abgezogen), gegen Gehaeuse und alle Bauteile ausser Clip: frei
   Zelle in montierter Huelse: Weg bis Seitenwand 2.40 mm (Clip haelt die Zelle)
   Testpads (Layout Rev B: TP1-TP3, TP3 entfaellt nach A-1) x -11.35 ... -9.85; Zellrand x -7.00 -> Abstand 2.85 mm (Ausschub +x)

F Taster SW1 gegen Biegezunge der Kappe
   SW1 Button_Switch_SMD:SW_SPST_TS-1088-xR020, Mitte (-6.00, 45.10), Drehung 0; Pads x -8.75...-7.70 z 44.10...46.10, x -4.30...-3.25 z 44.10...46.10
   Modell x -8.50 ... -3.50, z 43.60 ... 46.60, Oberseite y 4.60 (h 2.00)
   Betaetiger Ø1.8: x -6.90 ... -5.10, z 44.20 ... 46.00; Zunge x -7.6 ... -4.4, z ab 43.5 -> seitliche Reserve 0.70 / 0.70 mm, Reserve unten 0.70 mm
   Spalt Zunge - Betaetiger (Modell): 0.25 mm (Soll 0.25, M-4); mit h_max 2.1: 0.15 mm
   kleinster Abstand SW1 - Kappe: 0.25 mm

G RGB-LED D1 unter dem Tropfenfenster
   D1 fluidi:LED_RGB_TUOZHAN_1615 Mitte (0.00, 43.90), Drehung 180; Tropfen-/Lichtschaftmitte (0.00, 43.90) -> Versatz 0.00 mm (Tol. LED +-0.3)
   Abstand LED-Oberseite (0.6 / max 0.7) - Lichtschaft y 4.00: 2.00 / 1.90 mm (Ziel 1.5 ... 2.5)
   Bauteile mit Courtyard im Kreis r 1.8 um D1: R6 h 0.35, R7 h 0.35, R8 h 0.35 (Regel: nur h <= 0.6)
   Lichtschaft Ø3.0 im Zapfen: Abstand zu Bauteilen ausser D1: 2.25 mm

H Antenne AE1
   Footprint RF_Antenna:Texas_SWRA117D_2.4GHz_Right, Speisepunkt (0.35, 48.05); Kupfer x -2.20 ... 12.20, z 47.80 ... 53.20 (Z1 z 47.8 ... 53.5)
   Variante _Right: Einspeisung/Kurzschluss links, offenes Ende rechts (wie Schnittstelle verlangt)
   Abstand Antennenkupfer - Kappe_blau           0.70 mm
   Abstand Antennenkupfer - Huelse_grau          5.17 mm
   Abstand Antennenkupfer - Kragen               41.20 mm
   Abstand Antennenkupfer - Schottkeil           15.80 mm
   Abstand Antennenkupfer - Stoessel             1.26 mm
   Abstand Antennenkupfer - Fenster_transluzent  3.51 mm
   Abstand Antennenkupfer - Taste_blau           2.00 mm
   Abstand Antennenkupfer - Klemmring            1.40 mm
   Abstand Antennenkupfer - Tastenteller         2.12 mm
   Abstand Antennenkupfer - Membran_Silikon      1.00 mm
   Abstand Antennenkupfer - ORing_Zapfen         14.76 mm
   Abstand Antennenkupfer - ORing_Kragen         42.19 mm
   Abstand Antennenkupfer - Mutter_M2            44.60 mm
   Abstand Antennenkupfer - Schraube_M2          44.82 mm
   Abstand Antennenkupfer - Verguss_Kragen       41.20 mm
   Abstand Antennenkupfer - Verguss_Schott       15.88 mm
   Abstand Antennenkupfer - BT1 (Bauteil)        17.48 mm (Metall)
   Abstand Antennenkupfer - SW1 (Bauteil)        2.28 mm (Metall)
   Abstand Antennenkupfer - CR2032               19.20 mm (Metall)

I Kragen und Kragenverguss (Z5A/Z5B)
   Bauteile unterhalb z 6.8: C24, U3
   U3   Koerper x -7.49 ... -5.89 z 4.10 ... 5.70 h 0.63; Pads x -7.76 ... -5.62 z 4.25 ... 5.55; Courtyard x -7.94 ... -5.44 z 3.91 ... 5.89
        Tasche x -9.6 ... -4.4, z 1.3 ... 6.1, Tiefe 1.2: Rand x 2.11 / 1.49, z oben 0.40; Epoxid ueber Koerper 0.57 mm (h_max 0.60: 0.60); Abstand Kragen 0.40, Mutter 4.30 mm
        Feld K-2 x -9.0 ... -4.6, z 3.7 ... 6.1: Pads innerhalb
   C24  Koerper x -8.70 ... -8.20 z 4.30 ... 5.30 h 0.50; Pads x -8.76 ... -8.14 z 4.04 ... 5.56; Courtyard x -8.96 ... -7.94 z 3.84 ... 5.75
        Tasche x -9.6 ... -4.4, z 1.3 ... 6.1, Tiefe 1.2: Rand x 0.90 / 3.80, z oben 0.80; Epoxid ueber Koerper 0.70 mm (h_max 0.50: 0.70); Abstand Kragen 0.70, Mutter 6.29 mm
        Feld K-2 x -9.0 ... -4.6, z 3.7 ... 6.1: Pads innerhalb

J Schott (Verguss z 30.8 ... 32.0, Z3 z 30.3 ... 32.7)
   Pads in Z3: keine
   tiefstes Bauteil im Band: C4 Unterkante z 33.50 -> 1.50 mm ueber Schott-Oberkante (Verguss, Keil)

K Platine (STEP, mit Clip, ohne Zelle) 60 mm von unten durch das Schott einschieben
   frei

L Huelse 160 mm nach unten ueber die Sonde abziehen (mit STEP-Bauteilen und Zelle)
   frei
