sgeisser1/Tr-pfli/simulation/spice/uart_backfeed/uart_backfeed_results.csv

v_quelle | pads | einzelfehler | v_zelle | esd | i_pads_uA | i_zelle_uA | v_vdd | stunden_bis_1pct | abstand_10mA
5.5 | TX | - | 3.0 | ideal | 12.472 | 12.472 | 3.0 | 180.4 | 802
5.5 | TX | - | 3.0 | diode | 9.822 | 9.822 | 3.0 | 229.1 | 1018
5.5 | TX | - | 2.0 | ideal | 17.472 | 17.472 | 2.0 | 128.8 | 572
5.5 | TX | - | 2.0 | diode | 14.769 | 14.769 | 2.0 | 152.3 | 677
5.5 | TX | - | 0.0 | ideal | 22.961 | 22.961 | 0.902 | 98.0 | 436
5.5 | TX | - | 0.0 | diode | 20.219 | 20.219 | 0.902 | 111.3 | 495
5.5 | TX | TX_R10 | 3.0 | ideal | 24.941 | 24.941 | 3.0 | 90.2 | 401
5.5 | TX | TX_R10 | 3.0 | diode | 19.466 | 19.466 | 3.0 | 115.6 | 514
5.5 | TX | TX_R10 | 2.0 | ideal | 34.94 | 34.94 | 2.0 | 64.4 | 286
5.5 | TX | TX_R10 | 2.0 | diode | 29.358 | 29.358 | 2.0 | 76.6 | 341
5.5 | TX | TX_R10 | 0.0 | ideal | 45.912 | 45.912 | 0.903 | 49.0 | 218
5.5 | TX | TX_R10 | 0.0 | diode | 40.251 | 40.251 | 0.903 | 55.9 | 248
5.5 | RX | - | 3.0 | ideal | 12.472 | 12.472 | 3.0 | 180.4 | 802
5.5 | RX | - | 3.0 | diode | 9.822 | 9.822 | 3.0 | 229.1 | 1018
5.5 | RX | - | 2.0 | ideal | 17.472 | 17.472 | 2.0 | 128.8 | 572
5.5 | RX | - | 2.0 | diode | 14.769 | 14.769 | 2.0 | 152.3 | 677
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
