sgeisser1/Tr-pfli/simulation/spice/osc/osc_results.csv

R3 | vdd | probe | corner | cref | f_MHz | f8_MHz | f8_sim | tw_ns | i_osc_mA | i_div_mA | osc_pwr_min
1000.0 | 3.0 | Luft | typ | f0 | 27.7236 | 3.4654 | ja | 16.21 | 2.771 | 4.003 | 2.9996
1000.0 | 3.0 | Luft | typ | f1 | 19.7108 | 2.4638 | ja | 22.63 | 2.156 | 2.846 | 2.9996
1000.0 | 3.0 | Luft | hyst_min | f0 | 36.4403 | 4.555 | ja | 12.3 | 3.421 | 5.261 | 2.9995
1000.0 | 3.0 | Luft | hyst_min | f1 | 26.2541 | 3.2818 | ja | 16.96 | 2.645 | 3.79 | 2.9996
1000.0 | 3.0 | Luft | hyst_max | f0 | 20.4655 | 2.5582 | ja | 22.04 | 2.216 | 2.955 | 2.9996
1000.0 | 3.0 | Luft | hyst_max | f1 | 14.51 | 1.8137 | ja | 30.79 | 1.758 | 2.095 | 2.9996
1000.0 | 3.0 | Luft | mitte_hoch | f0 | 27.1624 | 3.3953 | ja | 18.34 | 2.736 | 3.922 | 2.9996
1000.0 | 3.0 | Luft | mitte_hoch | f1 | 19.1529 | 2.3942 | ja | 26.01 | 2.122 | 2.765 | 2.9996
1000.0 | 3.0 | Luft | mitte_tief | f0 | 27.6636 | 3.458 | ja | 14.38 | 2.744 | 3.994 | 2.9996
1000.0 | 3.0 | Luft | mitte_tief | f1 | 19.7976 | 2.4747 | ja | 19.74 | 2.137 | 2.858 | 2.9996
1000.0 | 3.0 | trocken | typ | f0 | 24.4742 | 3.0593 | ja | 18.33 | 2.527 | 3.533 | 2.9996
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
