sgeisser1/Tr-pfli/simulation/spice/supply/supply_results.csv

mode | burst | tx | cbuf | c_eff_uF | vocv | rint | v_start | v_min | drop | slew_mV_per_us
pess | ADV | tx0 | 2x100uF nominal | 200.0 | 2.7 | 20 | 2.7 | 2.6241 | 0.0759 | 0.028
pess | ADV | tx0 | 2x100uF nominal | 200.0 | 2.7 | 100 | 2.7 | 2.582 | 0.118 | 0.03167
pess | ADV | tx0 | 2x100uF nominal | 200.0 | 2.7 | 130 | 2.7 | 2.5784 | 0.1216 | 0.03167
pess | ADV | tx0 | 2x100uF nominal | 200.0 | 2.7 | 220 | 2.7 | 2.5732 | 0.1267 | 0.032
pess | ADV | tx0 | 2x100uF nominal | 200.0 | 2.7 | 500 | 2.7 | 2.5689 | 0.1311 | 0.032
pess | ADV | tx0 | 2x100uF nominal | 200.0 | 2.7 | 1000 | 2.7 | 2.5671 | 0.1329 | 0.03233
pess | ADV | tx0 | 2x100uF DC-Bias 50% | 100.0 | 2.7 | 20 | 2.7 | 2.5967 | 0.1033 | 0.04233
pess | ADV | tx0 | 2x100uF DC-Bias 50% | 100.0 | 2.7 | 100 | 2.7 | 2.4912 | 0.2088 | 0.05333
pess | ADV | tx0 | 2x100uF DC-Bias 50% | 100.0 | 2.7 | 130 | 2.7 | 2.4788 | 0.2212 | 0.05433
pess | ADV | tx0 | 2x100uF DC-Bias 50% | 100.0 | 2.7 | 220 | 2.7 | 2.4604 | 0.2396 | 0.05533
pess | ADV | tx0 | 2x100uF DC-Bias 50% | 100.0 | 2.7 | 500 | 2.7 | 2.444 | 0.256 | 0.0575
pess | ADV | tx0 | 2x100uF DC-Bias 50% | 100.0 | 2.7 | 1000 | 2.7 | 2.4371 | 0.2629 | 0.06
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
