sgeisser1/Tr-pfli/simulation/spice/probe_osc/results.csv

case | f0_MHz | f1_MHz | C_meas_pF | index_pct
dry | 4.4739 | 2.3095 | 13.475 | 0.00
wet_tap | 1.0186 | 0.8252 | 83.819 | 100.00
wet_fert_low | 0.9232 | 0.7715 | 101.880 | 125.67
wet_fert_normal | 0.9137 | 0.7659 | 103.989 | 128.67
mid_tap | 1.6511 | 1.1094 | 35.050 | 30.67
mid_fert_low | 0.9750 | 0.8012 | 91.362 | 110.72
mid_fert_normal | 0.9368 | 0.7794 | 98.925 | 121.47
air | 5.6054 | 2.5782 | 8.737 | -6.73
wet_nosalt | 2.2336 | 1.5211 | 36.969 | 33.40
