sgeisser1/Tr-pfli/simulation/field/results/coat_epoxy.csv

name | t_coat | er_coat | C_air | C_dry | C_wet | C_water | span | fr4_moist | lack_moist | share_fr4_air | span_rel
4L SG gap2 coat0.0 er2.8 | 0.0 | 2.8 | 45.65816471931801 | 100.04073299506395 | 366.73578058151537 | 710.5435728845304 | 266.69504758645144 | 6.807590470394035 | 0.9314961831805203 | 0.5564659984030191 | 0.0
4L SG gap2 coat0.05 er2.8 | 0.05 | 2.8 | 46.455049356438494 | 99.26926641645079 | 340.97438621273614 | 616.6092742254312 | 241.70511979628535 | 5.861888659023627 | 2.447361865341721 | 0.54844112989262 | -9.370225662726417
4L SG gap2 coat0.1 er2.8 | 0.1 | 2.8 | 47.21585301184413 | 98.559278904284 | 319.5321809639763 | 546.5281126167216 | 220.97290205969233 | 5.260432518163409 | 3.482548304576639 | 0.5411097141928678 | -17.143979965333955
4L SG gap2 coat0.2 er2.8 | 0.2 | 2.8 | 48.639154892377675 | 97.2877287064067 | 285.5310495886773 | 448.5163394534563 | 188.2433208822706 | 4.590435349019859 | 4.833768157199465 | 0.5281183256764701 | -29.41626678641269
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
