sgeisser1/Tr-pfli/simulation/field/results/salt_index_2d.csv

name | f_MHz | case | eps | sigma_b | index | index_tap | err_pp
4L GSG ws6 gap2 | 2 | Leitungswasser (0.035 S/m) | 10 | 0.002625 | 37.38 | 37.38 | 0
4L GSG ws6 gap2 | 2 | Leitungswasser (0.035 S/m) | 25 | 0.009188 | 100 | 100 | 0
4L GSG ws6 gap2 | 2 | geduengt, PourThru 'low' (0.18 S/m) | 10 | 0.0135 | 117.1 | 37.38 | 79.75
4L GSG ws6 gap2 | 2 | geduengt, PourThru 'low' (0.18 S/m) | 25 | 0.04725 | 142.3 | 100 | 42.26
4L GSG ws6 gap2 | 2 | geduengt, PourThru 'normal' (0.37 S/m) | 10 | 0.02775 | 138.3 | 37.38 | 100.9
4L GSG ws6 gap2 | 2 | geduengt, PourThru 'normal' (0.37 S/m) | 25 | 0.09712 | 144.9 | 100 | 44.88
4L GSG ws6 gap2 | 4 | Leitungswasser (0.035 S/m) | 10 | 0.002625 | 32.54 | 32.54 | 0
4L GSG ws6 gap2 | 4 | Leitungswasser (0.035 S/m) | 25 | 0.009188 | 100 | 100 | 0
4L GSG ws6 gap2 | 4 | geduengt, PourThru 'low' (0.18 S/m) | 10 | 0.0135 | 116.6 | 32.54 | 84.02
4L GSG ws6 gap2 | 4 | geduengt, PourThru 'low' (0.18 S/m) | 25 | 0.04725 | 191.6 | 100 | 91.6
4L GSG ws6 gap2 | 4 | geduengt, PourThru 'normal' (0.37 S/m) | 10 | 0.02775 | 174.1 | 32.54 | 141.6
4L GSG ws6 gap2 | 4 | geduengt, PourThru 'normal' (0.37 S/m) | 25 | 0.09712 | 204.1 | 100 | 104.1
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
