sgeisser1/Tr-pfli/simulation/field/results/study2d.csv

name | topo | gap | ndof | C_air | C_dry | C_wet | C_water | span | ratio | S_dry | S_wet | fr4_moist_air | fr4_moist_water | fr4_moist | tc_fr4 | lack_moist | share_soil_wet | share_fr4_air | d50_dry | d90_dry | d50_wet | d90_wet | gap01 | gap05 | ws | n | stack | coat | mask | edge | layers
4L SG gap0.5 | SG | 0.5 | 65940 | 94.543 | 159.541 | 456.97 | 822.463 | 297.429 | 3.83346 | 19.9392 | 10.5276 | 2.31728 | 14.277 | 8.29715 | 0.0581452 | 0.995847 | 0.575945 | 0.729009 | 1.15638 | 7.43243 | 1.54922 | 8.11195 | -39.5626 | -78.787
4L SG gap1 | SG | 1 | 65748 | 66.9839 | 127.932 | 415.385 | 775.097 | 287.453 | 5.20128 | 18.8705 | 10.2998 | 1.5182 | 13.3723 | 7.44523 | 0.0485419 | 0.967601 | 0.619891 | 0.651516 | 1.2924 | 7.62542 | 1.56101 | 8.14441 | -38.4858 | -78.1984
4L SG gap2 | SG | 2 | 65704 | 45.6582 | 100.041 | 366.736 | 710.544 | 266.695 | 7.03221 | 17.011 | 9.7374 | 0.952669 | 12.6625 | 6.80759 | 0.040579 | 0.931496 | 0.663789 | 0.556466 | 1.50046 | 8.27882 | 1.68012 | 8.49254 | -36.5933 | -77.0163
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
