sgeisser1/Tr-pfli/simulation/field/results/study2d_salt.csv

name | eps | f | sigma | G | C
4L GSG ws6 gap2 | 1 | 1e+06 | 0 | 4.33397e-06 | 79.0327
4L GSG ws6 gap2 | 1 | 2e+06 | 0 | 8.66795e-06 | 79.0327
4L GSG ws6 gap2 | 1 | 4e+06 | 0 | 1.73359e-05 | 79.0327
4L GSG ws6 gap2 | 1 | 6e+06 | 0 | 2.60038e-05 | 79.0327
4L GSG ws6 gap2 | 1 | 1e+07 | 0 | 4.33397e-05 | 79.0327
4L GSG ws6 gap2 | 1 | 2e+07 | 0 | 8.66795e-05 | 79.0327
4L GSG ws6 gap2 | 1 | 7e+07 | 0 | 0.000303378 | 79.0327
4L GSG ws6 gap2 | 4 | 1e+06 | 0 | 5.19765e-06 | 152.799
4L GSG ws6 gap2 | 4 | 1e+06 | 0.001 | 0.0021316 | 287.316
4L GSG ws6 gap2 | 4 | 1e+06 | 0.003 | 0.00326527 | 718.917
4L GSG ws6 gap2 | 4 | 1e+06 | 0.01 | 0.001782 | 1125.69
4L GSG ws6 gap2 | 4 | 1e+06 | 0.02 | 0.00099781 | 1184.64
4L GSG ws6 gap2 | 4 | 1e+06 | 0.03 | 0.00070811 | 1196.96
4L GSG ws6 gap2 | 4 | 1e+06 | 0.05 | 0.000469741 | 1203.78
4L GSG ws6 gap2 | 4 | 1e+06 | 0.075 | 0.000349004 | 1206.13
4L GSG ws6 gap2 | 4 | 1e+06 | 0.1 | 0.000288357 | 1207.04
4L GSG ws6 gap2 | 4 | 1e+06 | 0.15 | 0.000227566 | 1207.76
4L GSG ws6 gap2 | 4 | 1e+06 | 0.2 | 0.000197126 | 1208.06
4L GSG ws6 gap2 | 4 | 1e+06 | 0.3 | 0.000166663 | 1208.31
4L GSG ws6 gap2 | 4 | 2e+06 | 0 | 1.03953e-05 | 152.799
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
