sgeisser1/Tr-pfli/app/docs/screenshots/07_kalibrieren.png

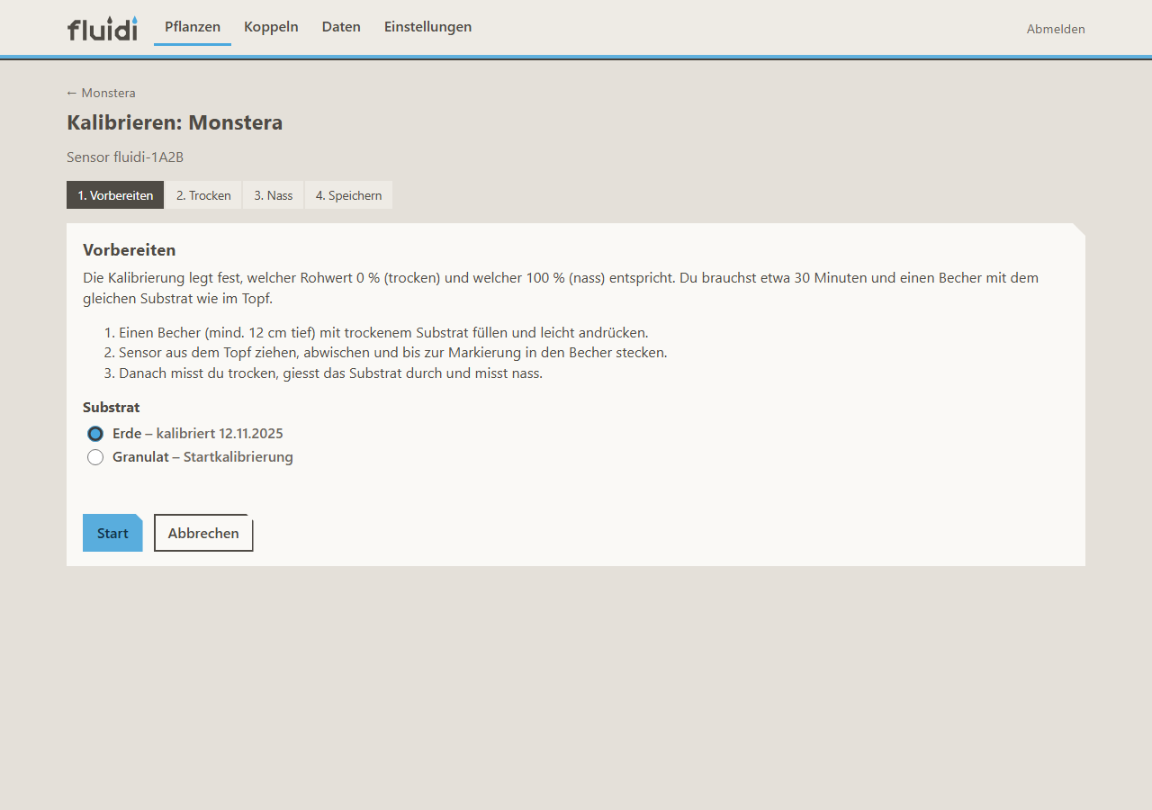
app/docs/screenshots/07_kalibrieren.png
