sgeisser1/Tr-pfli/mechanical/drawings/FL-G-01_wanne_grau.pdf

# Vorderansicht

# Draufsicht

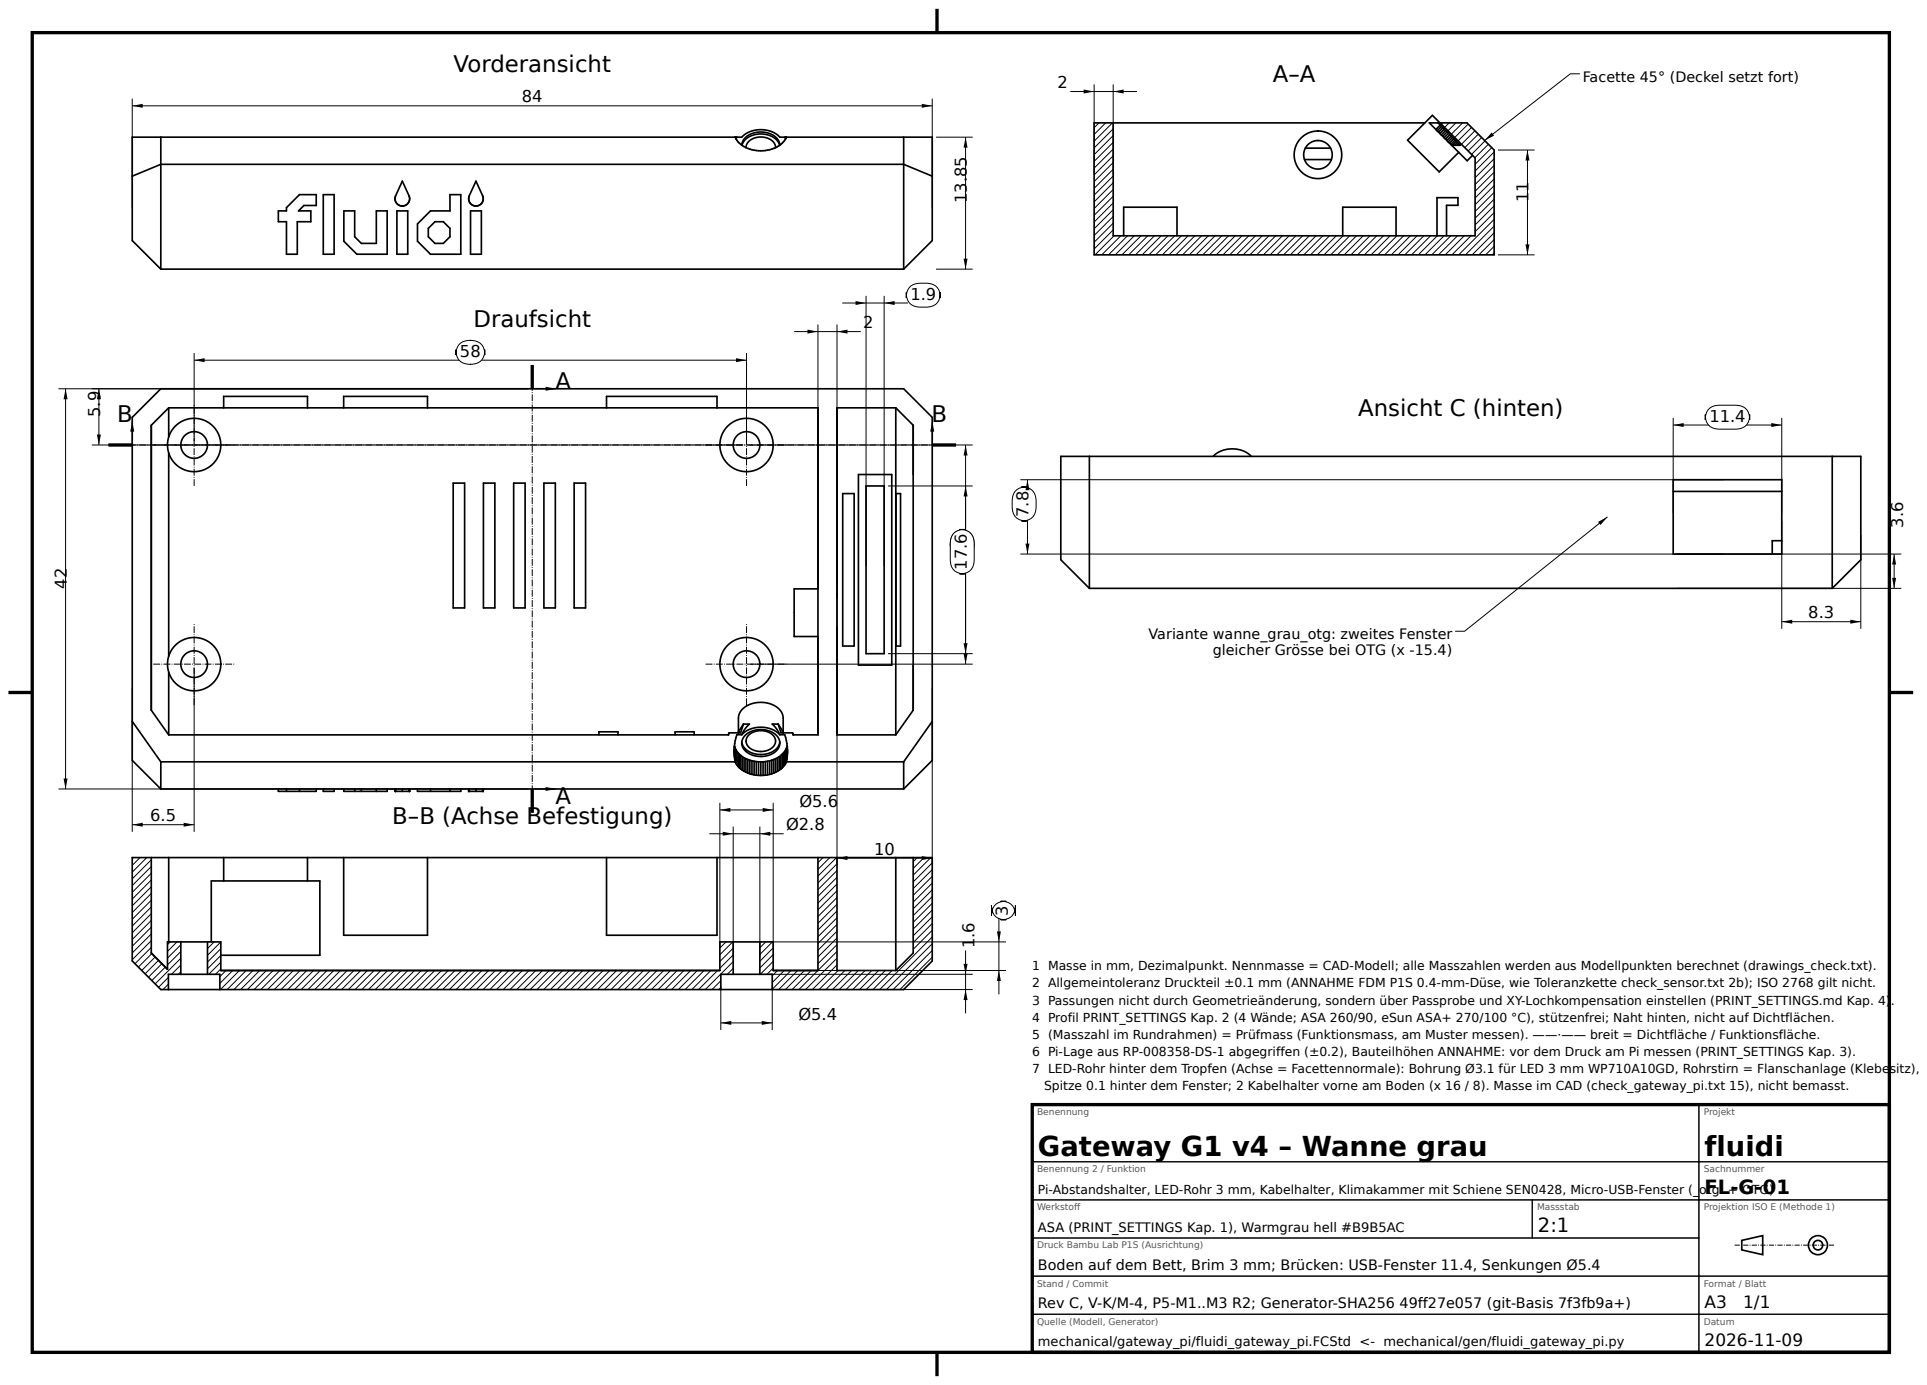
[picture p116: page 1]
Benennung; Projekt fluidi; Sachnummer FL-G-01; Massstab 2:1; Format / Blatt A3 1/1; Datum 2026-11-09; B–B (Achse Befestigung); Ansicht C (hinten)

Facette 45° (Deckel setzt fort)

Variante wanne_grau_otg: zweites Fenster

gleicher Grösse bei OTG (x -15.4)

1 Masse in mm, Dezimalpunkt. Nennmasse = CAD-Modell; alle Masszahlen werden aus Modellpunkten berechnet (drawings_check.txt).
2 Allgemeintoleranz Druckteil ±0.1 mm (ANNAHME FDM P1S 0.4-mm-Düse, wie Toleranzkette check_sensor.txt 2b); ISO 2768 gilt nicht.
3 Passungen nicht durch Geometrieänderung, sondern über Passprobe und XY-Lochkompensation einstellen (PRINT_SETTINGS.md Kap. 4).
4 Profil PRINT_SETTINGS Kap. 2 (4 Wände; ASA 260/90, eSun ASA+ 270/100 °C), stützenfrei; Naht hinten, nicht auf Dichtflächen.
5 (Masszahl im Rundrahmen) = Prüfmass (Funktionsmass, am Muster messen). ——·—— breit = Dichtfläche / Funktionsfläche.
6 Pi-Lage aus RP-008358-DS-1 abgegriffen (±0.2), Bauteilhöhen ANNAHME: vor dem Druck am Pi messen (PRINT_SETTINGS Kap. 3).
7 LED-Rohr hinter dem Tropfen (Achse = Facettennormale): Bohrung Ø3.1 für LED 3 mm WP710A10GD, Rohrstirn = Flanschanlage (Klebesitz),
Spitze 0.1 hinter dem Fenster; 2 Kabelhalter vorne am Boden (x 16 / 8). Masse im CAD (check_gateway_pi.txt 15), nicht bemasst.
Gateway G1 v4 – Wanne grau

Benennung 2 / Funktion
Pi-Abstandshalter, LED-Rohr 3 mm, Kabelhalter, Klimakammer mit Schiene SEN0428, Micro-USB-Fenster (_otg: + OTG)
Werkstoff
ASA (PRINT_SETTINGS Kap. 1), Warmgrau hell #B9B5AC
Druck Bambu Lab P1S (Ausrichtung)
Boden auf dem Bett, Brim 3 mm; Brücken: USB-Fenster 11.4, Senkungen Ø5.4

Projektion ISO E (Methode 1)

Stand / Commit
Rev C, V-K/M-4, P5-M1..M3 R2; Generator-SHA256 49ff27e057 (git-Basis 7f3fb9a+)

Quelle (Modell, Generator)
mechanical/gateway_pi/fluidi_gateway_pi.FCStd <- mechanical/gen/fluidi_gateway_pi.py
