sgeisser1/Tr-pfli/mechanical/drawings/FL-G-02_deckel_blau.pdf

# Vorderansicht

# Draufsicht

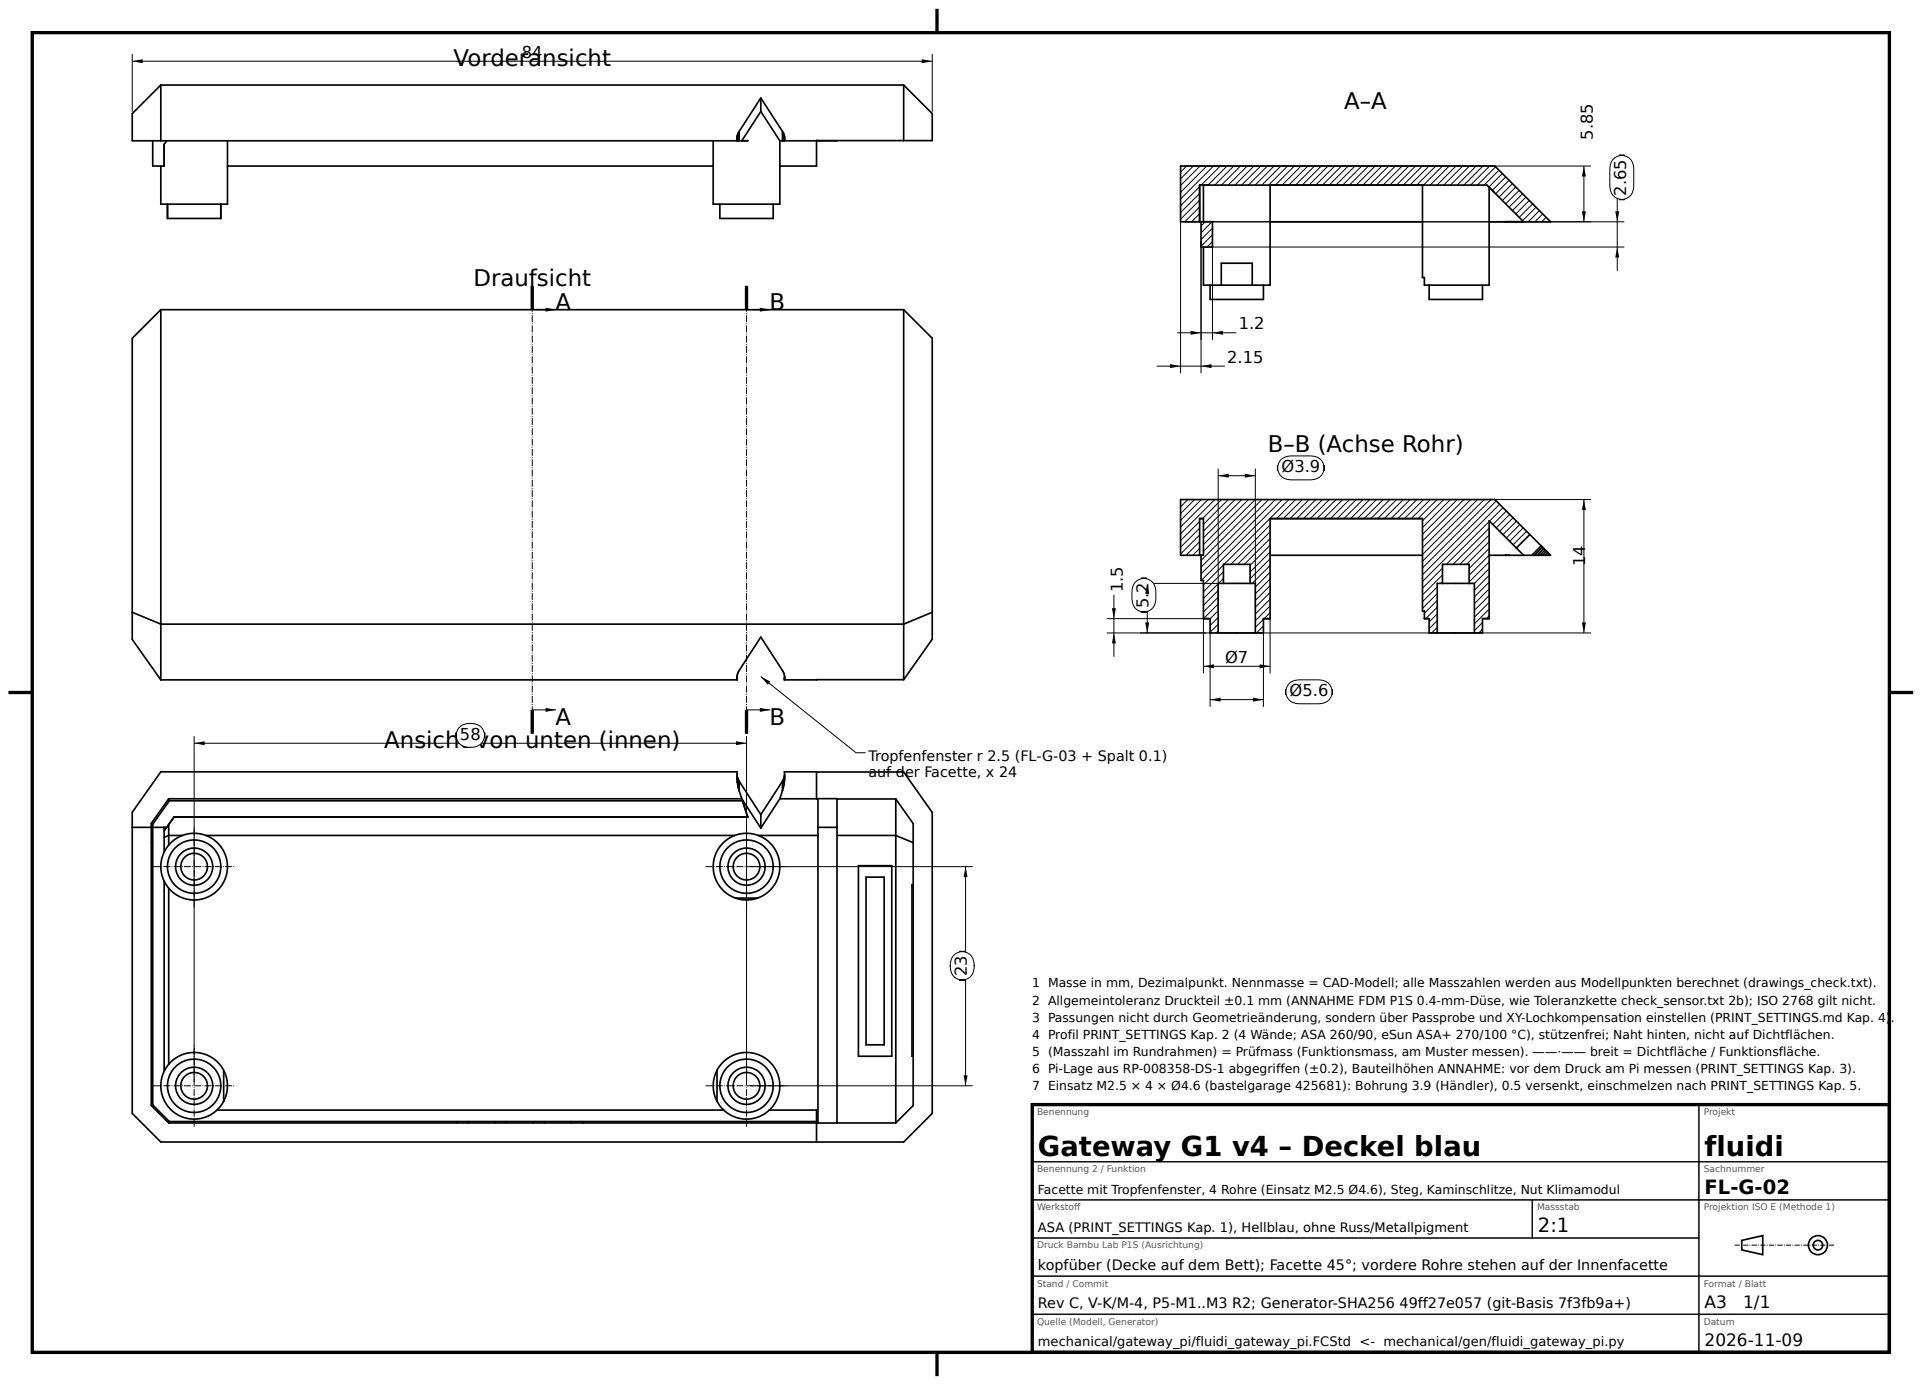
[picture p117: page 1]
Benennung; Projekt fluidi; Sachnummer FL-G-02; Massstab 2:1; Format / Blatt A3 1/1; Datum 2026-11-09; B–B (Achse Rohr)

Ansicht von unten (innen)

Tropfenfenster r 2.5 (FL-G-03 + Spalt 0.1)
auf der Facette, x 24

1 Masse in mm, Dezimalpunkt. Nennmasse = CAD-Modell; alle Masszahlen werden aus Modellpunkten berechnet (drawings_check.txt).
2 Allgemeintoleranz Druckteil ±0.1 mm (ANNAHME FDM P1S 0.4-mm-Düse, wie Toleranzkette check_sensor.txt 2b); ISO 2768 gilt nicht.
3 Passungen nicht durch Geometrieänderung, sondern über Passprobe und XY-Lochkompensation einstellen (PRINT_SETTINGS.md Kap. 4).
4 Profil PRINT_SETTINGS Kap. 2 (4 Wände; ASA 260/90, eSun ASA+ 270/100 °C), stützenfrei; Naht hinten, nicht auf Dichtflächen.
5 (Masszahl im Rundrahmen) = Prüfmass (Funktionsmass, am Muster messen). ——·—— breit = Dichtfläche / Funktionsfläche.
6 Pi-Lage aus RP-008358-DS-1 abgegriffen (±0.2), Bauteilhöhen ANNAHME: vor dem Druck am Pi messen (PRINT_SETTINGS Kap. 3).
7 Einsatz M2.5 × 4 × Ø4.6 (bastelgarage 425681): Bohrung 3.9 (Händler), 0.5 versenkt, einschmelzen nach PRINT_SETTINGS Kap. 5.
Gateway G1 v4 – Deckel blau

Benennung 2 / Funktion
Facette mit Tropfenfenster, 4 Rohre (Einsatz M2.5 Ø4.6), Steg, Kaminschlitze, Nut Klimamodul
Werkstoff
ASA (PRINT_SETTINGS Kap. 1), Hellblau, ohne Russ/Metallpigment
Druck Bambu Lab P1S (Ausrichtung)
kopfüber (Decke auf dem Bett); Facette 45°; vordere Rohre stehen auf der Innenfacette

Projektion ISO E (Methode 1)

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

Quelle (Modell, Generator)
mechanical/gateway_pi/fluidi_gateway_pi.FCStd <- mechanical/gen/fluidi_gateway_pi.py
