sgeisser1/Tr-pfli/mechanical/drawings/FL-G-03_fenster_tropfen_gw.pdf

# Draufsicht (Druckausrichtung)

# Vorderansicht

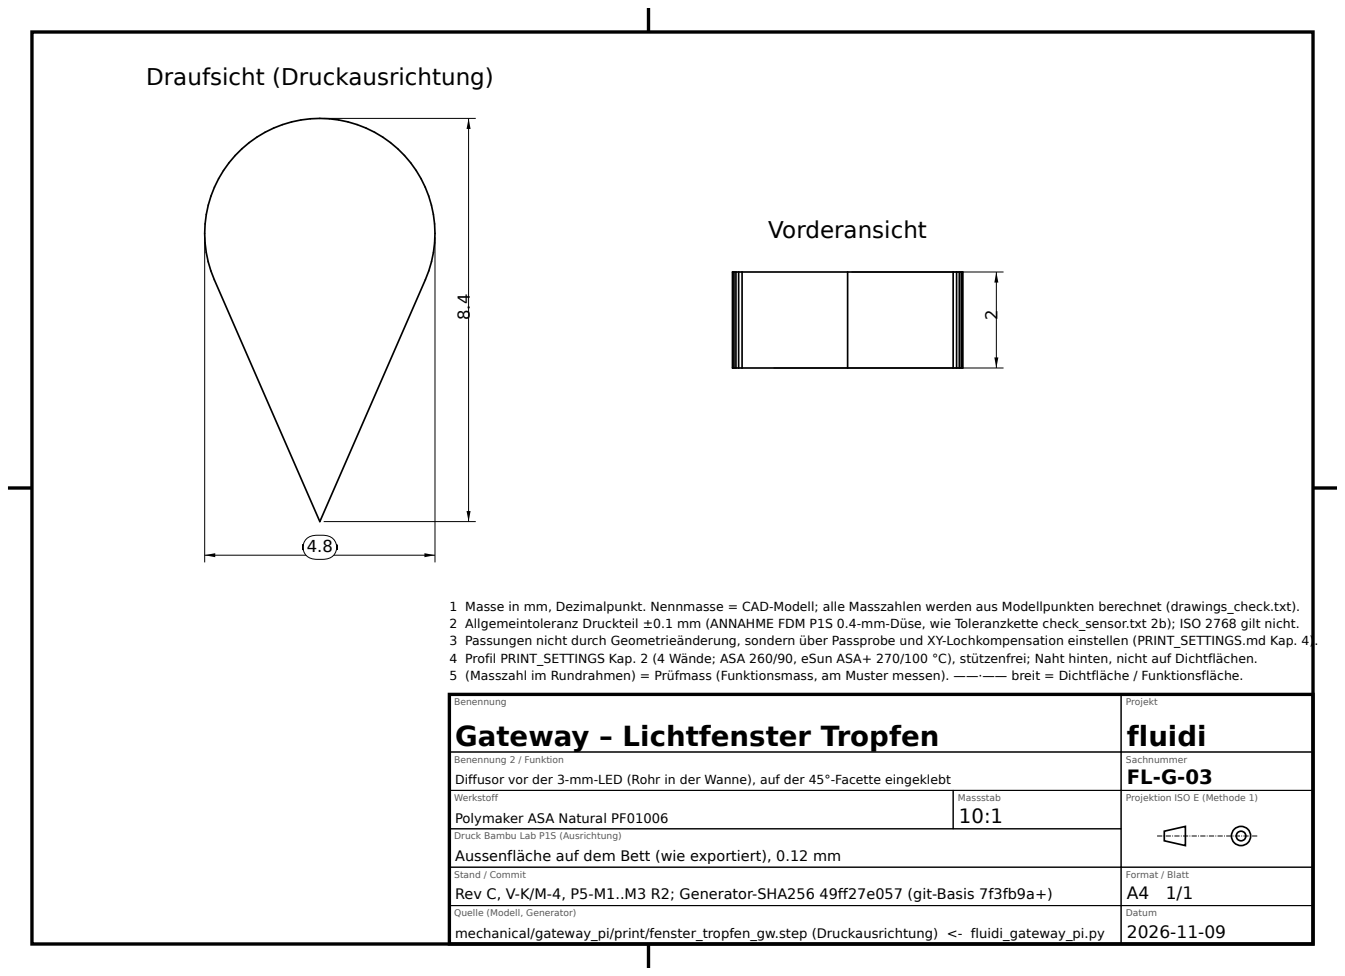
[picture p118: page 1]
Benennung; Projekt fluidi; Sachnummer FL-G-03; Massstab 10:1; Format / Blatt A4 1/1; Datum 2026-11-09

1 Masse in mm, Dezimalpunkt. Nennmasse = CAD-Modell; alle Masszahlen werden aus Modellpunkten berechnet (drawings_check.txt).
2 Allgemeintoleranz Druckteil ±0.1 mm (ANNAHME FDM P1S 0.4-mm-Düse, wie Toleranzkette check_sensor.txt 2b); ISO 2768 gilt nicht.
3 Passungen nicht durch Geometrieänderung, sondern über Passprobe und XY-Lochkompensation einstellen (PRINT_SETTINGS.md Kap. 4).
4 Profil PRINT_SETTINGS Kap. 2 (4 Wände; ASA 260/90, eSun ASA+ 270/100 °C), stützenfrei; Naht hinten, nicht auf Dichtflächen.
5 (Masszahl im Rundrahmen) = Prüfmass (Funktionsmass, am Muster messen). ——·—— breit = Dichtfläche / Funktionsfläche.
Gateway – Lichtfenster Tropfen

Benennung 2 / Funktion
Diffusor vor der 3-mm-LED (Rohr in der Wanne), auf der 45°-Facette eingeklebt
Werkstoff
Polymaker ASA Natural PF01006
Druck Bambu Lab P1S (Ausrichtung)
Aussenfläche auf dem Bett (wie exportiert), 0.12 mm

Projektion ISO E (Methode 1)

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

Quelle (Modell, Generator)
mechanical/gateway_pi/print/fenster_tropfen_gw.step (Druckausrichtung) <- fluidi_gateway_pi.py
