sgeisser1/Tr-pfli/mechanical/drawings/FL-S-01_huelse_grau.pdf

# Vorderansicht

A–A

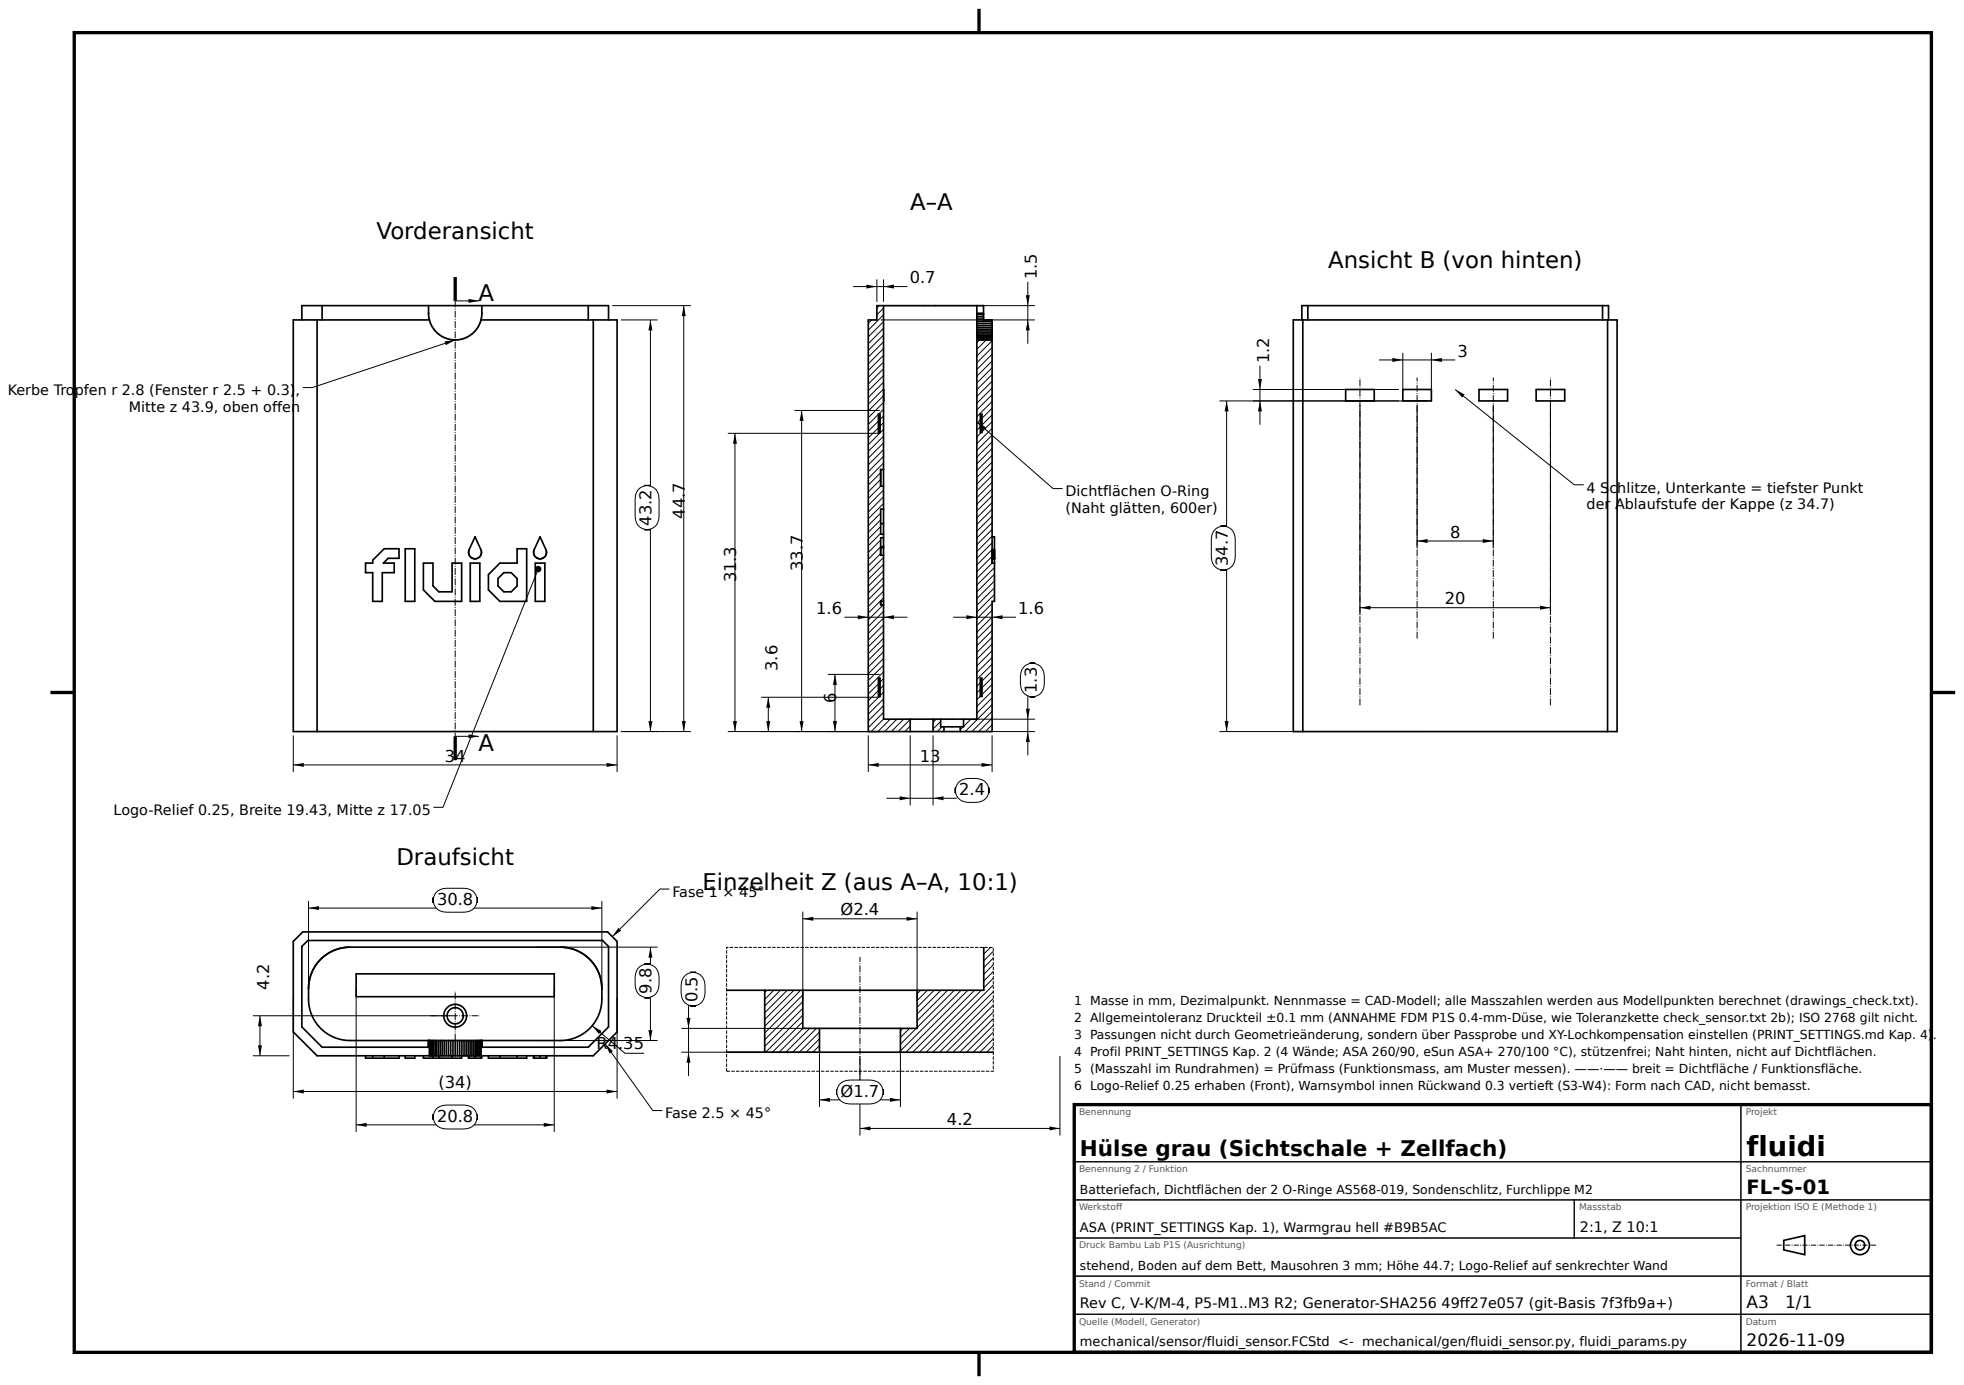
[picture p119: page 1]
Projekt fluidi; Sachnummer FL-S-01; Massstab 2:1, Z 10:1; Format / Blatt A3 1/1; Datum 2026-11-09; Draufsicht; Einzelheit Z (aus A–A, 10:1); Dichtflächen O-Ring (Naht glätten, 600er); Fase 2.5 × 45°; Fase 1 × 45°

Ansicht B (von hinten)

Kerbe Tropfen r 2.8 (Fenster r 2.5 + 0.3),

Mitte z 43.9, oben offen

4 Schlitze, Unterkante = tiefster Punkt
der Ablaufstufe der Kappe (z 34.7)

Logo-Relief 0.25, Breite 19.43, Mitte z 17.05

1 Masse in mm, Dezimalpunkt. Nennmasse = CAD-Modell; alle Masszahlen werden aus Modellpunkten berechnet (drawings_check.txt).
2 Allgemeintoleranz Druckteil ±0.1 mm (ANNAHME FDM P1S 0.4-mm-Düse, wie Toleranzkette check_sensor.txt 2b); ISO 2768 gilt nicht.
3 Passungen nicht durch Geometrieänderung, sondern über Passprobe und XY-Lochkompensation einstellen (PRINT_SETTINGS.md Kap. 4).
4 Profil PRINT_SETTINGS Kap. 2 (4 Wände; ASA 260/90, eSun ASA+ 270/100 °C), stützenfrei; Naht hinten, nicht auf Dichtflächen.
5 (Masszahl im Rundrahmen) = Prüfmass (Funktionsmass, am Muster messen). ——·—— breit = Dichtfläche / Funktionsfläche.
6 Logo-Relief 0.25 erhaben (Front), Warnsymbol innen Rückwand 0.3 vertieft (S3-W4): Form nach CAD, nicht bemasst.

Benennung
Hülse grau (Sichtschale + Zellfach)

Benennung 2 / Funktion
Batteriefach, Dichtflächen der 2 O-Ringe AS568-019, Sondenschlitz, Furchlippe M2
Werkstoff
ASA (PRINT_SETTINGS Kap. 1), Warmgrau hell #B9B5AC
Druck Bambu Lab P1S (Ausrichtung)
stehend, Boden auf dem Bett, Mausohren 3 mm; Höhe 44.7; Logo-Relief auf senkrechter Wand
Stand / Commit
Rev C, V-K/M-4, P5-M1..M3 R2; Generator-SHA256 49ff27e057 (git-Basis 7f3fb9a+)

Projektion ISO E (Methode 1)

Quelle (Modell, Generator)
mechanical/sensor/fluidi_sensor.FCStd <- mechanical/gen/fluidi_sensor.py, fluidi_params.py
