sgeisser1/Tr-pfli/mechanical/drawings/FL-S-02_kappe_blau.pdf

Vorderansicht | A–A | B–B | C–C
A

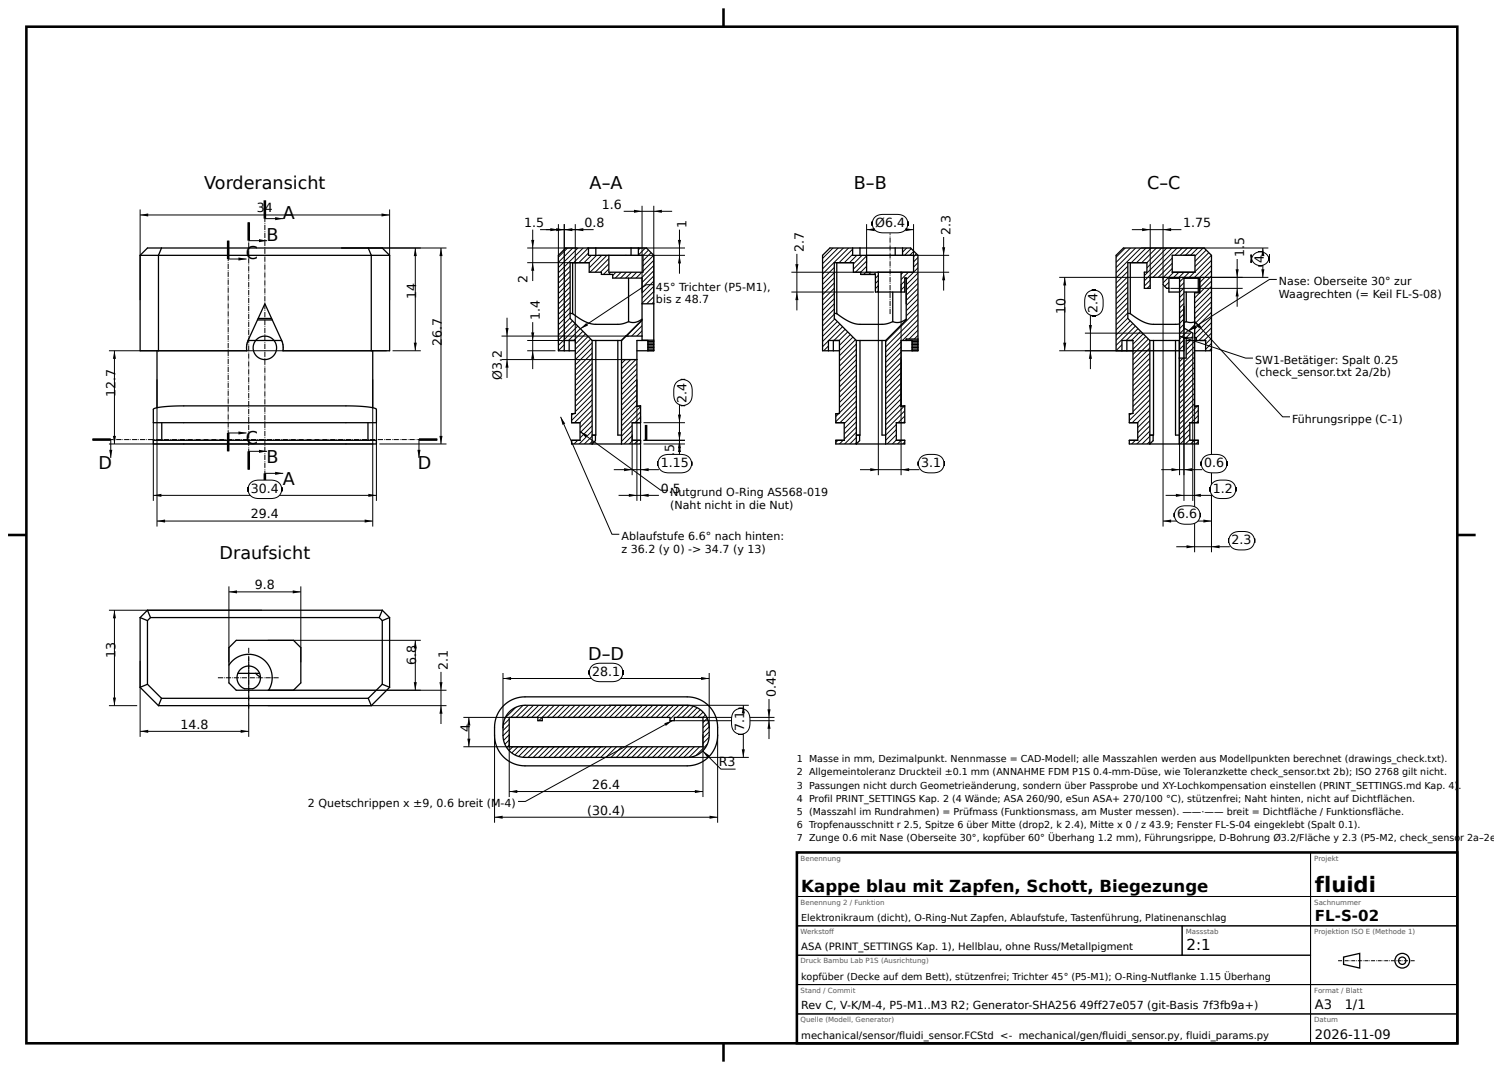
[picture p120: page 1]
Projekt fluidi; Sachnummer FL-S-02; Massstab 2:1; Format / Blatt A3 1/1; Datum 2026-11-09; Draufsicht; 45° Trichter (P5-M1), bis z 48.7; Führungsrippe (C-1); SW1-Betätiger: Spalt 0.25 (check_sensor.txt 2a/2b); (30.4) ² Quetschrippen x ±9, 0.6 breit (M-4)

Nase: Oberseite 30° zur
Waagrechten (= Keil FL-S-08)

B A

Nutgrund O-Ring AS568-019
(Naht nicht in die Nut)

Ablaufstufe 6.6° nach hinten:

1 Masse in mm, Dezimalpunkt. Nennmasse = CAD-Modell; alle Masszahlen werden aus Modellpunkten berechnet (drawings_check.txt).
2 Allgemeintoleranz Druckteil ±0.1 mm (ANNAHME FDM P1S 0.4-mm-Düse, wie Toleranzkette check_sensor.txt 2b); ISO 2768 gilt nicht.
3 Passungen nicht durch Geometrieänderung, sondern über Passprobe und XY-Lochkompensation einstellen (PRINT_SETTINGS.md Kap. 4).
4 Profil PRINT_SETTINGS Kap. 2 (4 Wände; ASA 260/90, eSun ASA+ 270/100 °C), stützenfrei; Naht hinten, nicht auf Dichtflächen.
5 (Masszahl im Rundrahmen) = Prüfmass (Funktionsmass, am Muster messen). ——·—— breit = Dichtfläche / Funktionsfläche.
6 Tropfenausschnitt r 2.5, Spitze 6 über Mitte (drop2, k 2.4), Mitte x 0 / z 43.9; Fenster FL-S-04 eingeklebt (Spalt 0.1).
7 Zunge 0.6 mit Nase (Oberseite 30°, kopfüber 60° Überhang 1.2 mm), Führungsrippe, D-Bohrung Ø3.2/Fläche y 2.3 (P5-M2, check_sensor 2a–2e).

Benennung
Kappe blau mit Zapfen, Schott, Biegezunge

Benennung 2 / Funktion
Elektronikraum (dicht), O-Ring-Nut Zapfen, Ablaufstufe, Tastenführung, Platinenanschlag
Werkstoff
ASA (PRINT_SETTINGS Kap. 1), Hellblau, ohne Russ/Metallpigment
Druck Bambu Lab P1S (Ausrichtung)
kopfüber (Decke auf dem Bett), stützenfrei; Trichter 45° (P5-M1); O-Ring-Nutflanke 1.15 Überhang
Stand / Commit
Rev C, V-K/M-4, P5-M1..M3 R2; Generator-SHA256 49ff27e057 (git-Basis 7f3fb9a+)

Projektion ISO E (Methode 1)

Quelle (Modell, Generator)
mechanical/sensor/fluidi_sensor.FCStd <- mechanical/gen/fluidi_sensor.py, fluidi_params.py
