sgeisser1/Tr-pfli/mechanical/drawings/FL-S-03_kragen.pdf

# Vorderansicht

A–A | B–B (Tasche U3/C24)

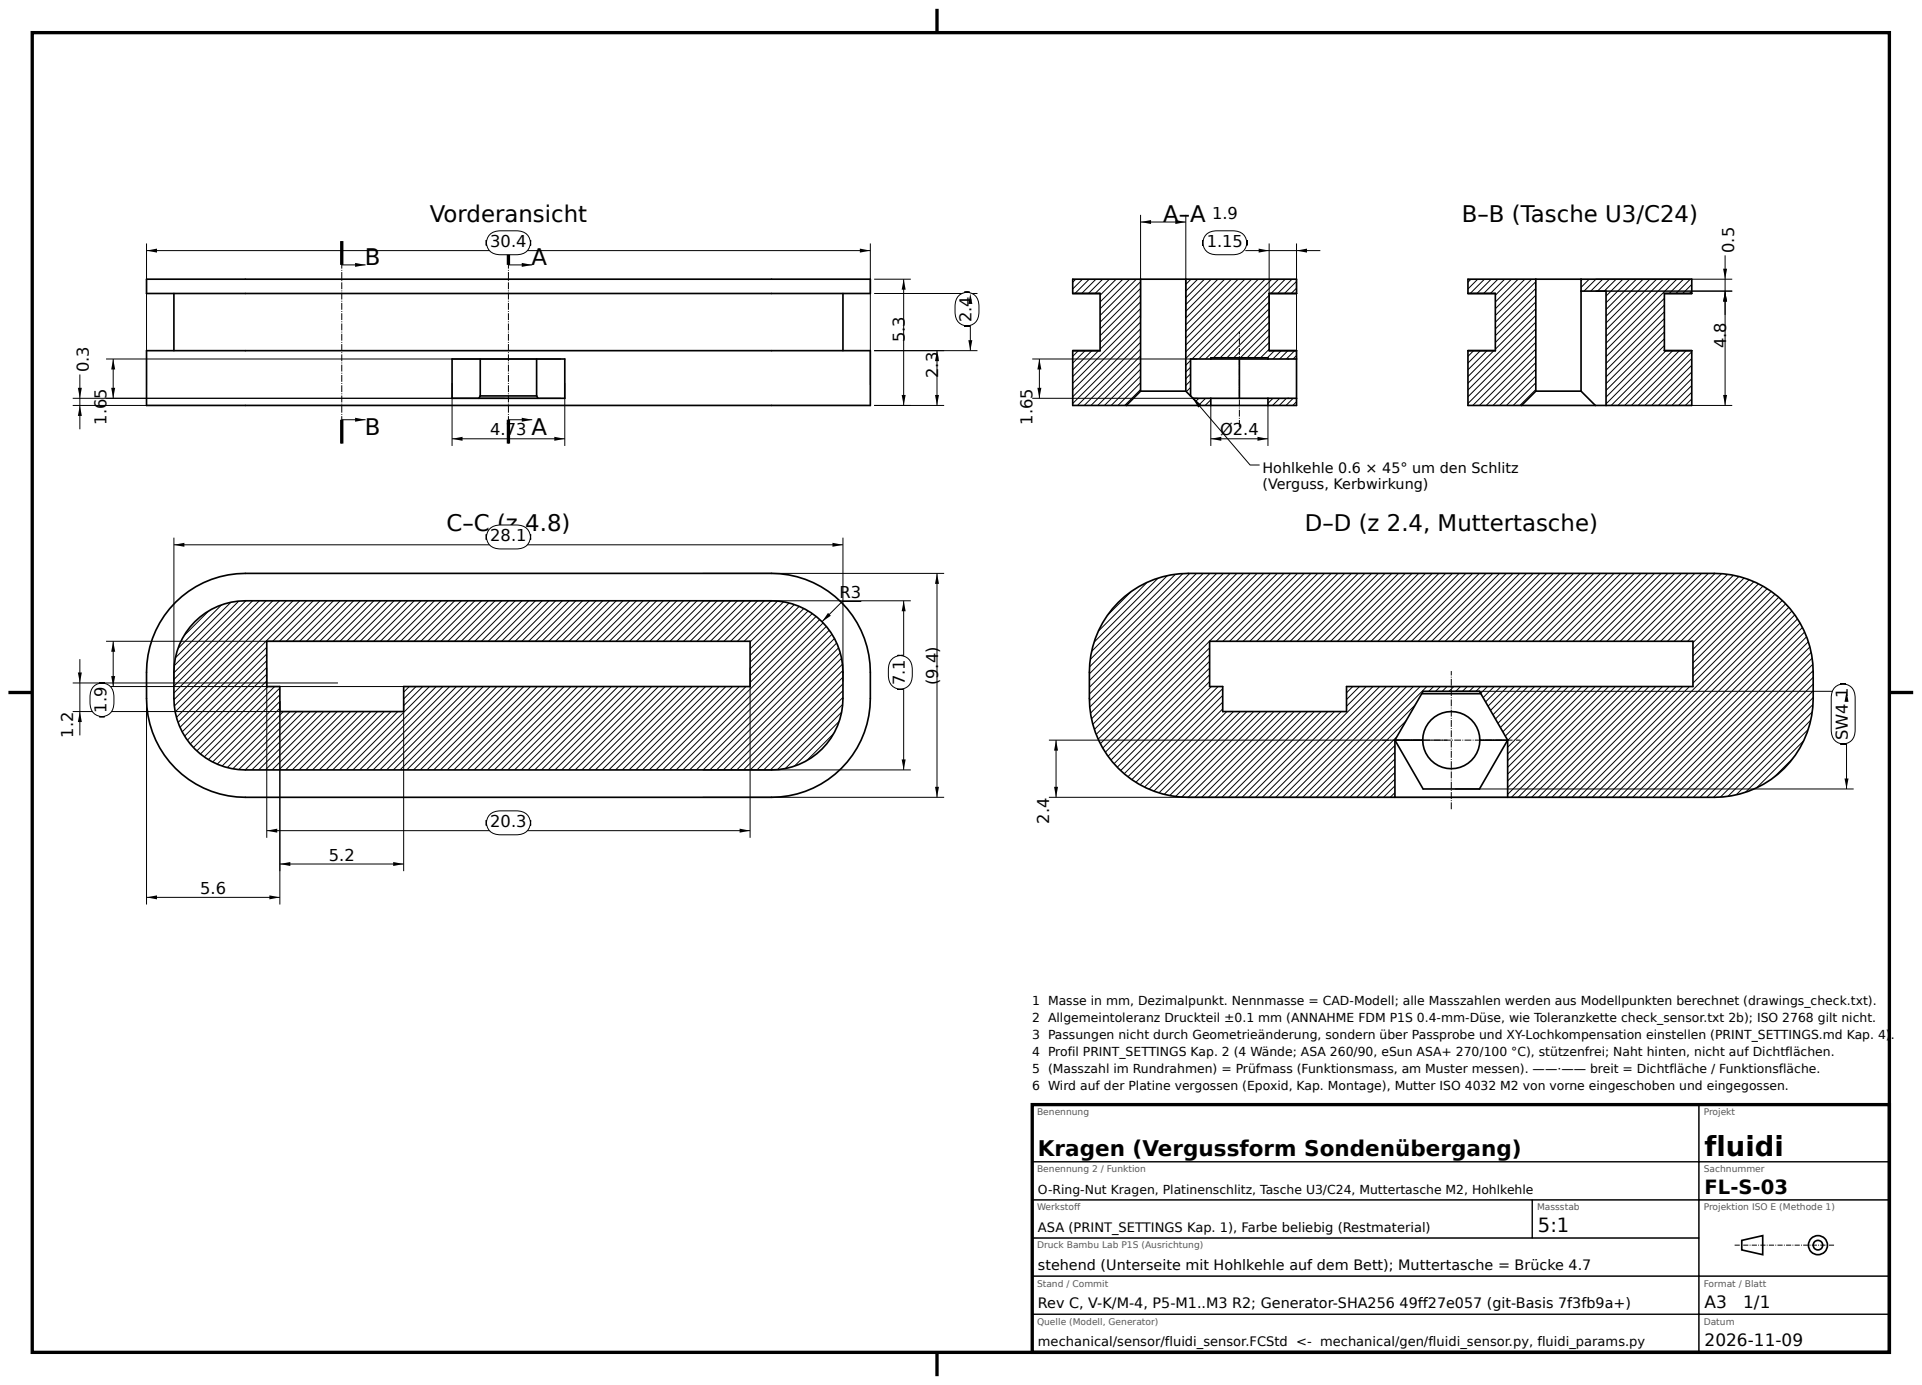
[picture p121: page 1]
Projekt fluidi; Sachnummer FL-S-03; Massstab 5:1; Format / Blatt A3 1/1; Datum 2026-11-09; D–D (z 2.4, Muttertasche)

Hohlkehle 0.6 × 45° um den Schlitz
(Verguss, Kerbwirkung)

1 Masse in mm, Dezimalpunkt. Nennmasse = CAD-Modell; alle Masszahlen werden aus Modellpunkten berechnet (drawings_check.txt).
2 Allgemeintoleranz Druckteil ±0.1 mm (ANNAHME FDM P1S 0.4-mm-Düse, wie Toleranzkette check_sensor.txt 2b); ISO 2768 gilt nicht.
3 Passungen nicht durch Geometrieänderung, sondern über Passprobe und XY-Lochkompensation einstellen (PRINT_SETTINGS.md Kap. 4).
4 Profil PRINT_SETTINGS Kap. 2 (4 Wände; ASA 260/90, eSun ASA+ 270/100 °C), stützenfrei; Naht hinten, nicht auf Dichtflächen.
5 (Masszahl im Rundrahmen) = Prüfmass (Funktionsmass, am Muster messen). ——·—— breit = Dichtfläche / Funktionsfläche.
6 Wird auf der Platine vergossen (Epoxid, Kap. Montage), Mutter ISO 4032 M2 von vorne eingeschoben und eingegossen.

Benennung
Kragen (Vergussform Sondenübergang)

Benennung 2 / Funktion
O-Ring-Nut Kragen, Platinenschlitz, Tasche U3/C24, Muttertasche M2, Hohlkehle
Werkstoff
ASA (PRINT_SETTINGS Kap. 1), Farbe beliebig (Restmaterial)
Druck Bambu Lab P1S (Ausrichtung)
stehend (Unterseite mit Hohlkehle auf dem Bett); Muttertasche = Brücke 4.7

Projektion ISO E (Methode 1)

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

Quelle (Modell, Generator)
mechanical/sensor/fluidi_sensor.FCStd <- mechanical/gen/fluidi_sensor.py, fluidi_params.py
