sgeisser1/Tr-pfli/mechanical/drawings/FL-S-06_klemmring.pdf

# A–A (durch Achse)

Ø6.5

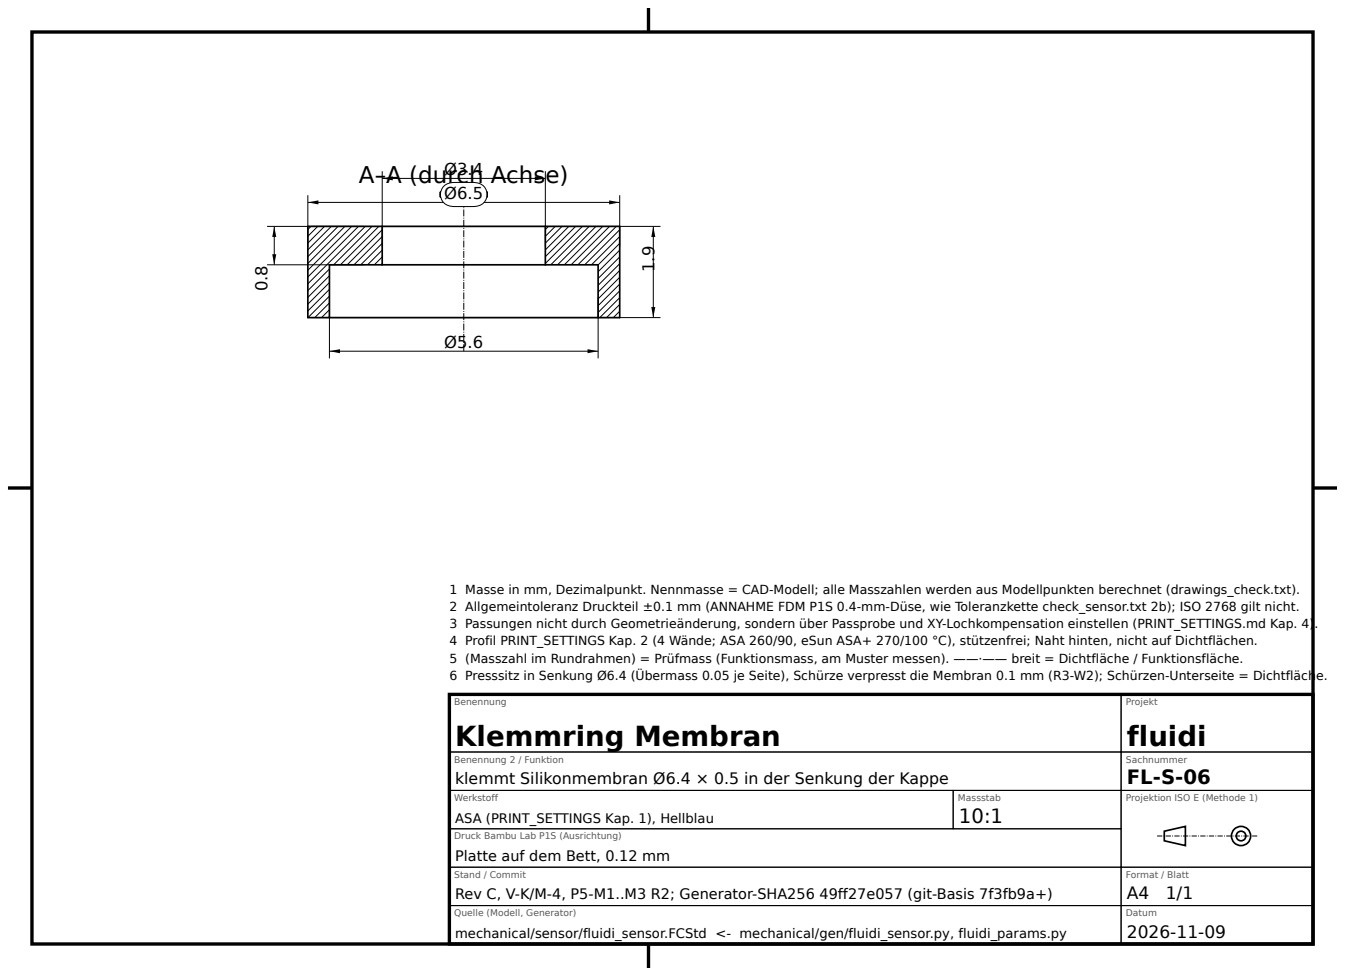
[picture p124: page 1]
Benennung; Projekt fluidi; Sachnummer FL-S-06; Massstab 10:1; Format / Blatt A4 1/1; Datum 2026-11-09

1 Masse in mm, Dezimalpunkt. Nennmasse = CAD-Modell; alle Masszahlen werden aus Modellpunkten berechnet (drawings_check.txt).
2 Allgemeintoleranz Druckteil ±0.1 mm (ANNAHME FDM P1S 0.4-mm-Düse, wie Toleranzkette check_sensor.txt 2b); ISO 2768 gilt nicht.
3 Passungen nicht durch Geometrieänderung, sondern über Passprobe und XY-Lochkompensation einstellen (PRINT_SETTINGS.md Kap. 4).
4 Profil PRINT_SETTINGS Kap. 2 (4 Wände; ASA 260/90, eSun ASA+ 270/100 °C), stützenfrei; Naht hinten, nicht auf Dichtflächen.
5 (Masszahl im Rundrahmen) = Prüfmass (Funktionsmass, am Muster messen). ——·—— breit = Dichtfläche / Funktionsfläche.
6 Presssitz in Senkung Ø6.4 (Übermass 0.05 je Seite), Schürze verpresst die Membran 0.1 mm (R3-W2); Schürzen-Unterseite = Dichtfläche.
Klemmring Membran

Benennung 2 / Funktion
klemmt Silikonmembran Ø6.4 × 0.5 in der Senkung der Kappe

Werkstoff
ASA (PRINT_SETTINGS Kap. 1), Hellblau
Druck Bambu Lab P1S (Ausrichtung)
Platte auf dem Bett, 0.12 mm

Projektion ISO E (Methode 1)

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

Quelle (Modell, Generator)
mechanical/sensor/fluidi_sensor.FCStd <- mechanical/gen/fluidi_sensor.py, fluidi_params.py
