sgeisser1/Tr-pfli/hardware/sensor/out/pdf/fluidi_sensor_bestueckung_B.pdf

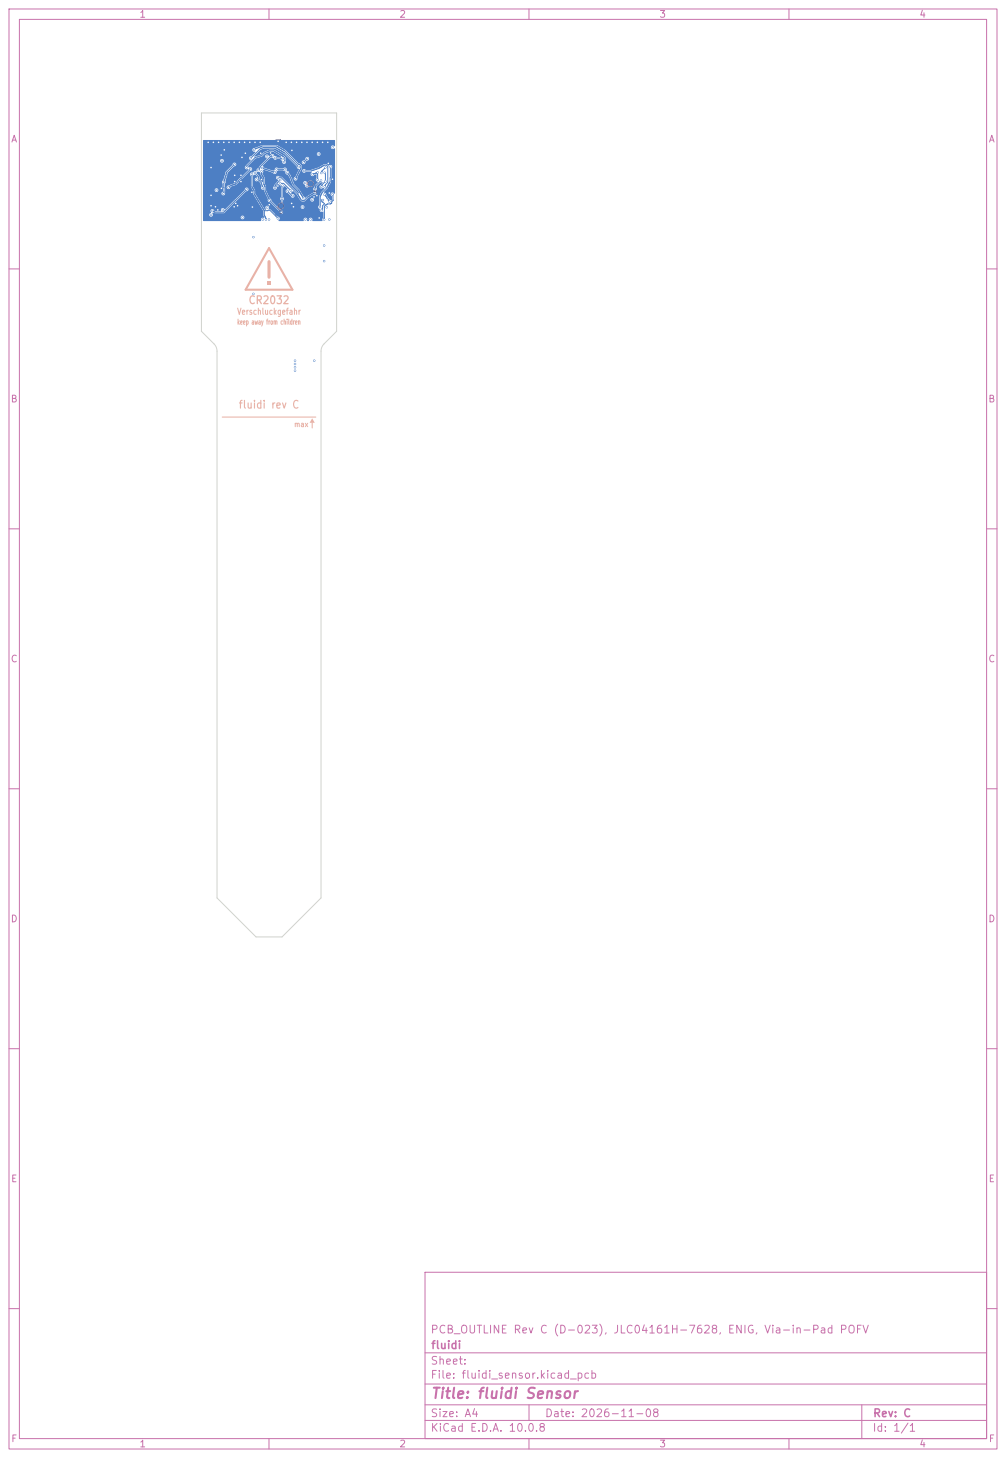
[picture p129: page 1]

1 keep away from childrenmax Verschluckgefahr

PCB_OUTLINE Rev C (D-023), JLC04161H-7628, ENIG, Via-in-Pad POFV
fluidi
Sheet:
File: fluidi_sensor.kicad_pcb
Title: fluidi Sensor

Size: A4 | Rev: C | F Date: 2026-11-08
KiCad E.D.A. 10.0.8 | Id: 1/1
