sgeisser1/Tr-pfli/hardware/sensor/out/pdf/fluidi_sensor_masszeichnung.pdf

# fluidi Sensor - Masszeichnung Platine Rev C

## Blatt 1/3, Massstab 1:1 bei A4-Druck ohne Skalierung

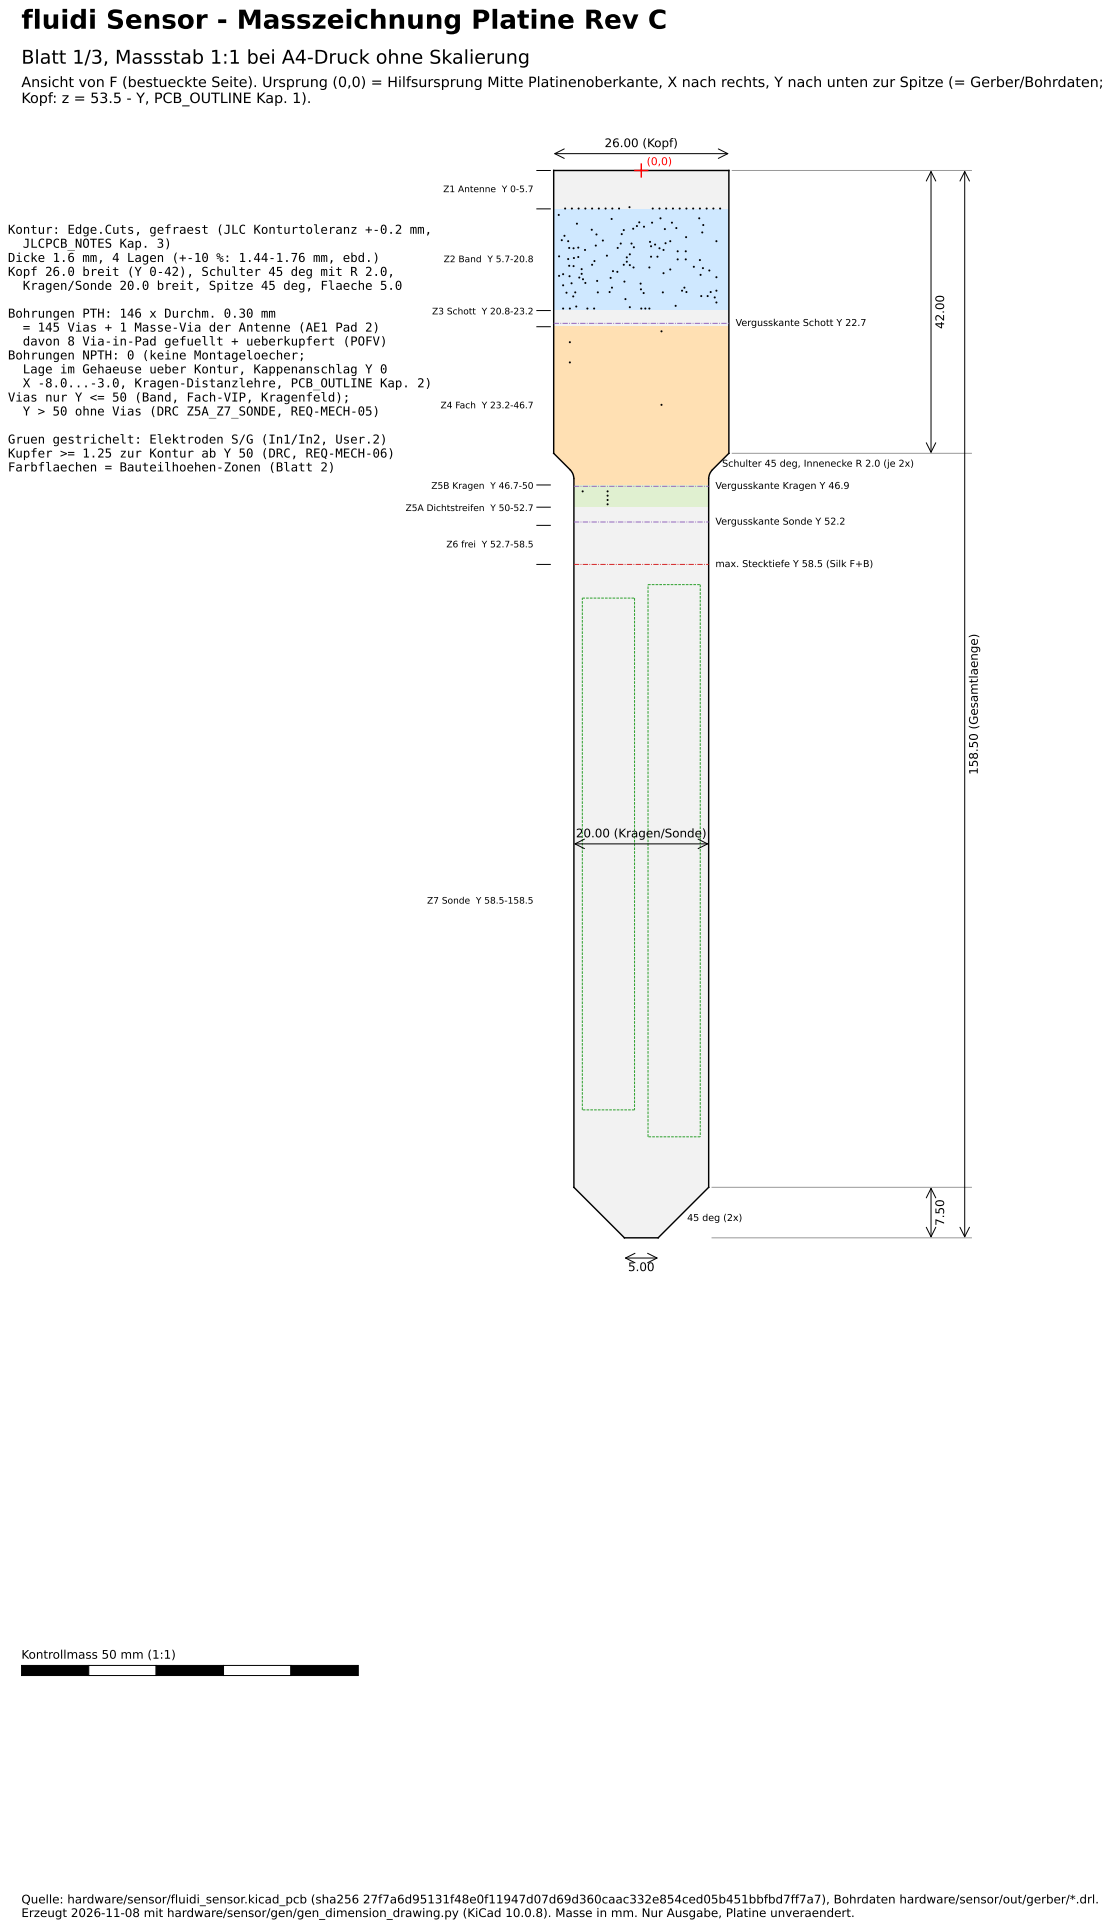
[picture p130: page 1]
Vergusskante Schott Y 22.7; Vergusskante Kragen Y 46.9; Vergusskante Sonde Y 52.2; Z1 Antenne Y 0-5.7; Z2 Band Y 5.7-20.8; Z3 Schott Y 20.8-23.2; Z4 Fach Y 23.2-46.7; Z5B Kragen Y 46.7-50; Z5A Dichtstreifen Y 50-52.7; Z6 frei Y 52.7-58.5; Z7 Sonde Y 58.5-158.5; 158.50 (Gesamtlaenge); 26.00 (Kopf); 20.00 (Kragen/Sonde); 45 deg (2x); Kontrollmass 50 mm (1:1)

Ansicht von F (bestueckte Seite). Ursprung (0,0) = Hilfsursprung Mitte Platinenoberkante, X nach rechts, Y nach unten zur Spitze (= Gerber/Bohrdaten;
Kopf: z = 53.5 - Y, PCB_OUTLINE Kap. 1).

Kontur: Edge.Cuts, gefraest (JLC Konturtoleranz +-0.2 mm,
JLCPCB_NOTES Kap. 3)
Dicke 1.6 mm, 4 Lagen (+-10 %: 1.44-1.76 mm, ebd.)
Kopf 26.0 breit (Y 0-42), Schulter 45 deg mit R 2.0,
Kragen/Sonde 20.0 breit, Spitze 45 deg, Flaeche 5.0

Bohrungen PTH: 146 x Durchm. 0.30 mm
= 145 Vias + 1 Masse-Via der Antenne (AE1 Pad 2)
davon 8 Via-in-Pad gefuellt + ueberkupfert (POFV)
Bohrungen NPTH: 0 (keine Montageloecher;
Lage im Gehaeuse ueber Kontur, Kappenanschlag Y 0
X -8.0...-3.0, Kragen-Distanzlehre, PCB_OUTLINE Kap. 2)
Vias nur Y <= 50 (Band, Fach-VIP, Kragenfeld);
Y > 50 ohne Vias (DRC Z5A_Z7_SONDE, REQ-MECH-05)

Gruen gestrichelt: Elektroden S/G (In1/In2, User.2)
Kupfer >= 1.25 zur Kontur ab Y 50 (DRC, REQ-MECH-06)
Farbflaechen = Bauteilhoehen-Zonen (Blatt 2)

Schulter 45 deg, Innenecke R 2.0 (je 2x)

max. Stecktiefe Y 58.5 (Silk F+B)

Quelle: hardware/sensor/fluidi_sensor.kicad_pcb (sha256 27f7a6d95131f48e0f11947d07d69d360caac332e854ced05b451bbfbd7ff7a7), Bohrdaten hardware/sensor/out/gerber/*.drl.
Erzeugt 2026-11-08 mit hardware/sensor/gen/gen_dimension_drawing.py (KiCad 10.0.8). Masse in mm. Nur Ausgabe, Platine unveraendert.

# fluidi Sensor - Masszeichnung Platine Rev C

## Blatt 2/3, Kopf Y -1...60, Massstab 3:1

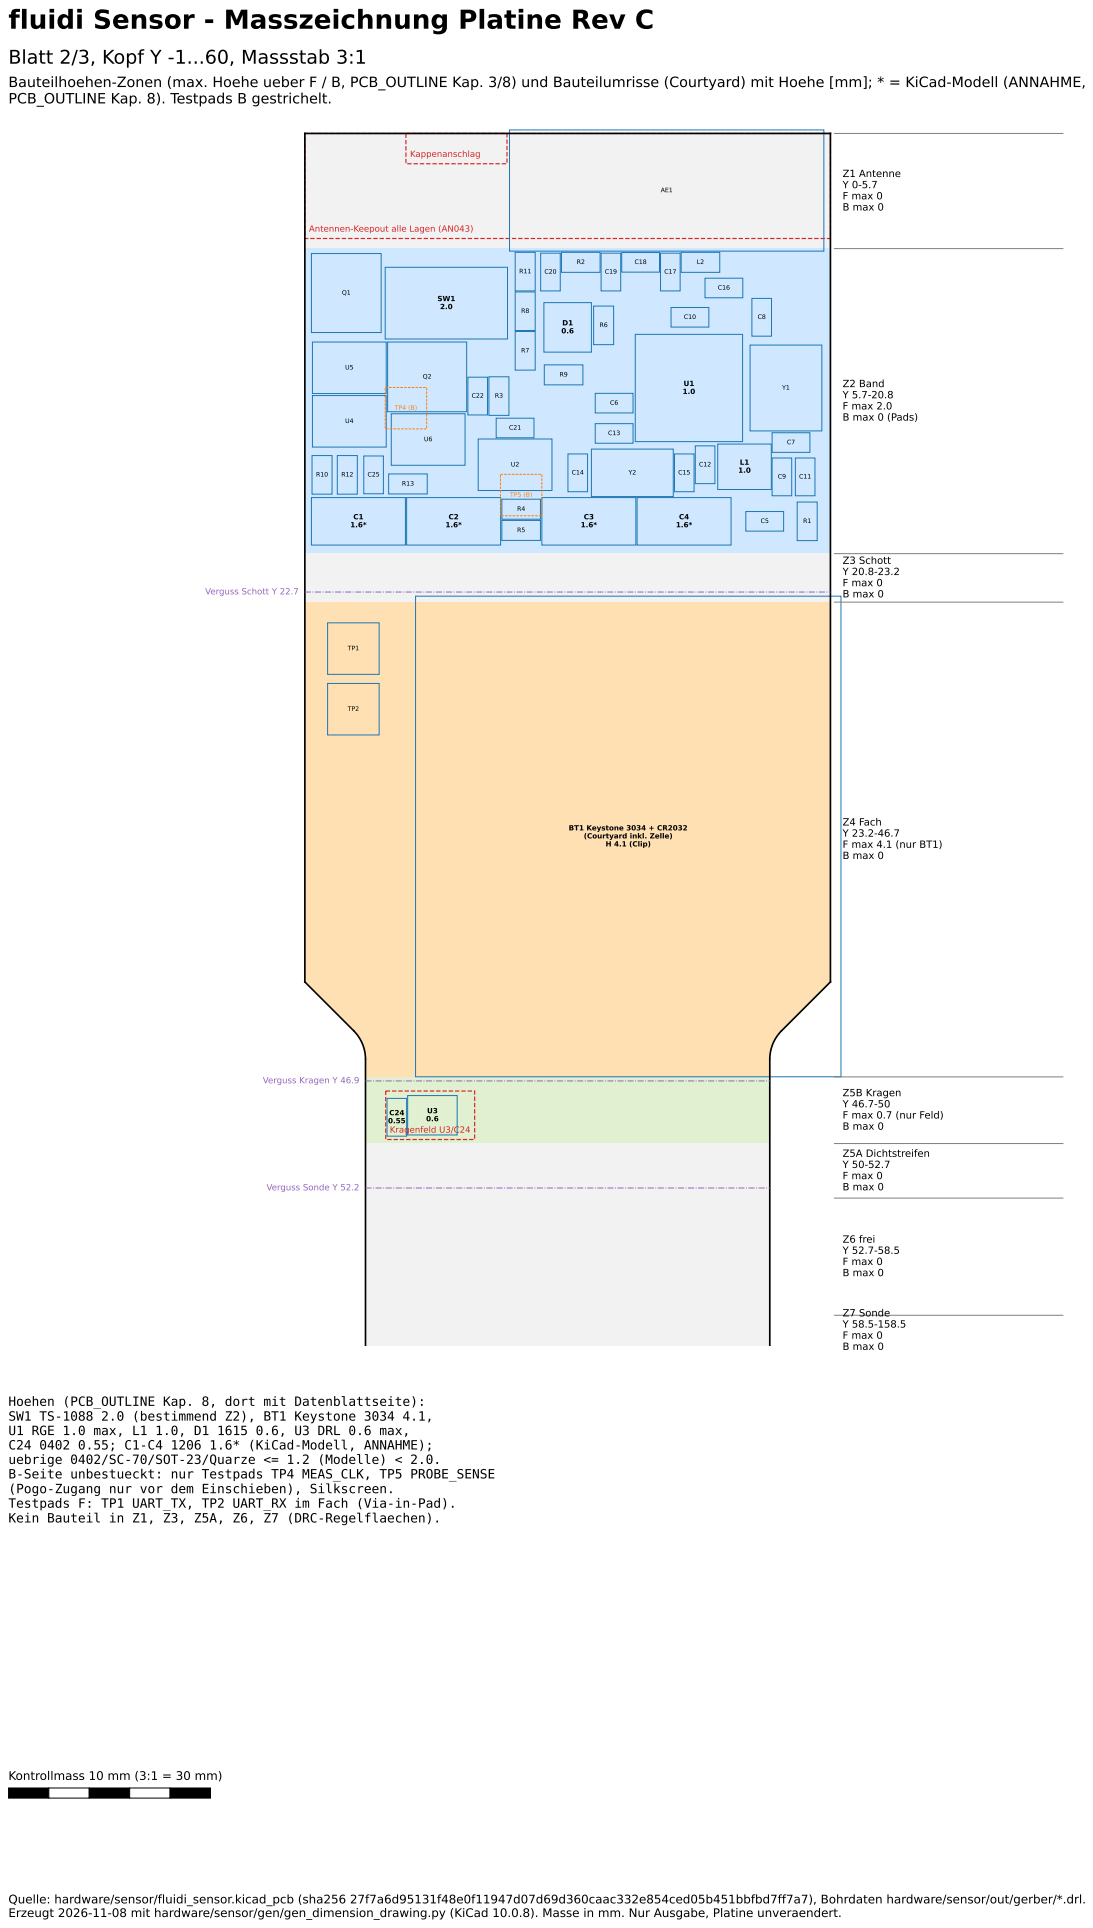
[picture p131: page 2]

Bauteilhoehen-Zonen (max. Hoehe ueber F / B, PCB_OUTLINE Kap. 3/8) und Bauteilumrisse (Courtyard) mit Hoehe [mm]; * = KiCad-Modell (ANNAHME,
PCB_OUTLINE Kap. 8). Testpads B gestrichelt.

Antennen-Keepout alle Lagen (AN043)

Hoehen (PCB_OUTLINE Kap. 8, dort mit Datenblattseite):
SW1 TS-1088 2.0 (bestimmend Z2), BT1 Keystone 3034 4.1,
U1 RGE 1.0 max, L1 1.0, D1 1615 0.6, U3 DRL 0.6 max,
C24 0402 0.55; C1-C4 1206 1.6* (KiCad-Modell, ANNAHME);
uebrige 0402/SC-70/SOT-23/Quarze <= 1.2 (Modelle) < 2.0.
B-Seite unbestueckt: nur Testpads TP4 MEAS_CLK, TP5 PROBE_SENSE
(Pogo-Zugang nur vor dem Einschieben), Silkscreen.
Testpads F: TP1 UART_TX, TP2 UART_RX im Fach (Via-in-Pad).
Kein Bauteil in Z1, Z3, Z5A, Z6, Z7 (DRC-Regelflaechen).

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
