sgeisser1/Tr-pfli/production/rev-C/2_bestellung/fluidi_sensor_layout_lagen.pdf

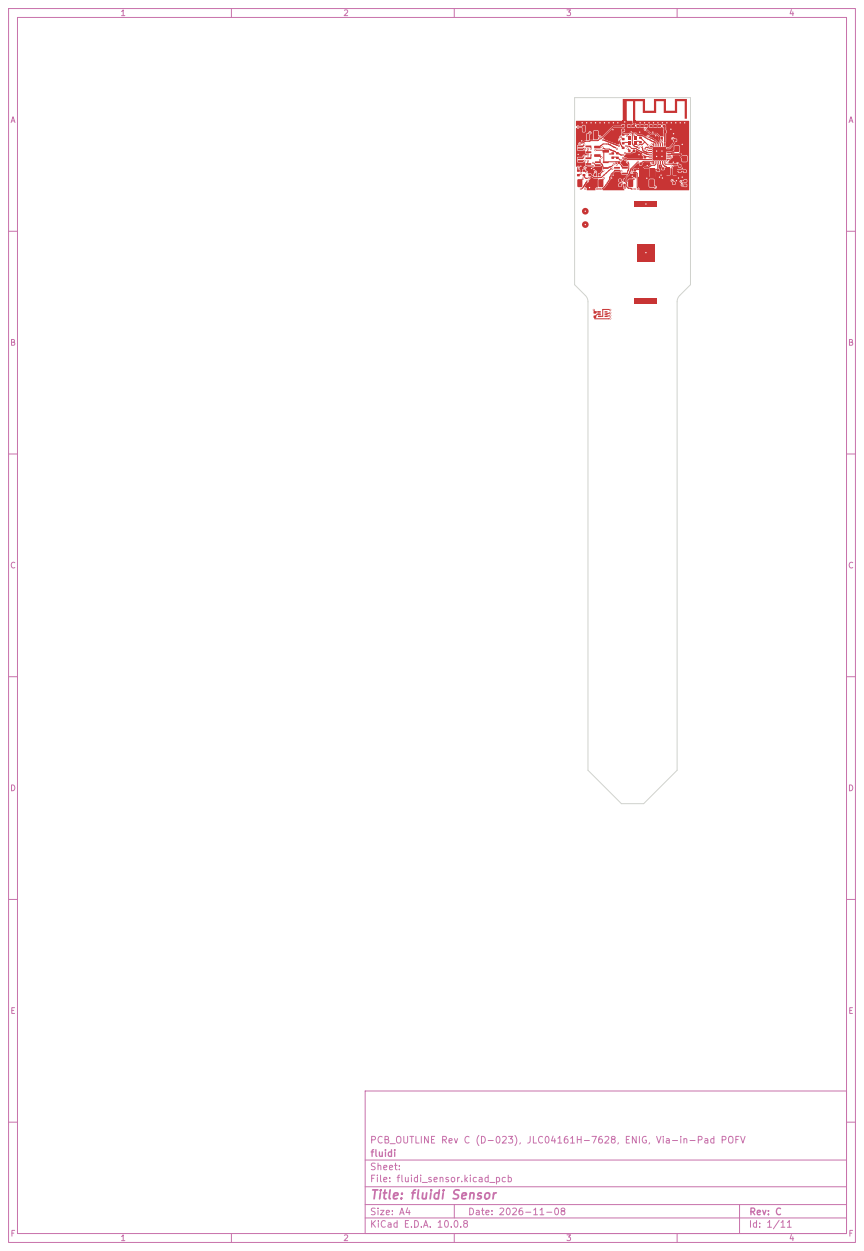
[picture p132: page 1]

PCB_OUTLINE Rev C (D-023), JLC04161H-7628, ENIG, Via-in-Pad POFV
fluidi
Sheet:
File: fluidi_sensor.kicad_pcb
Title: fluidi Sensor

Size: A4 | Rev: C | F Date: 2026-11-08
KiCad E.D.A. 10.0.8 | Id: 1/11

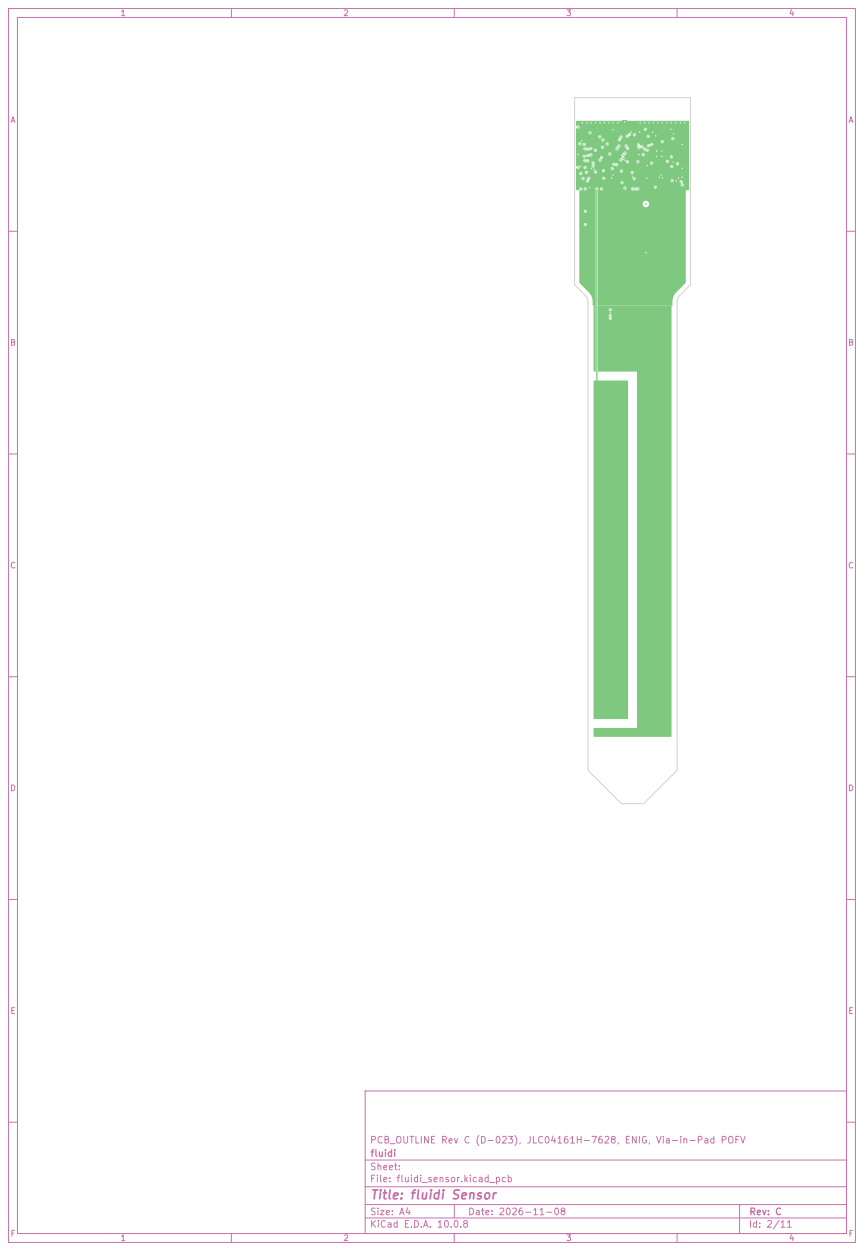
[picture p133: page 2]

PCB_OUTLINE Rev C (D-023), JLC04161H-7628, ENIG, Via-in-Pad POFV
fluidi
Sheet:

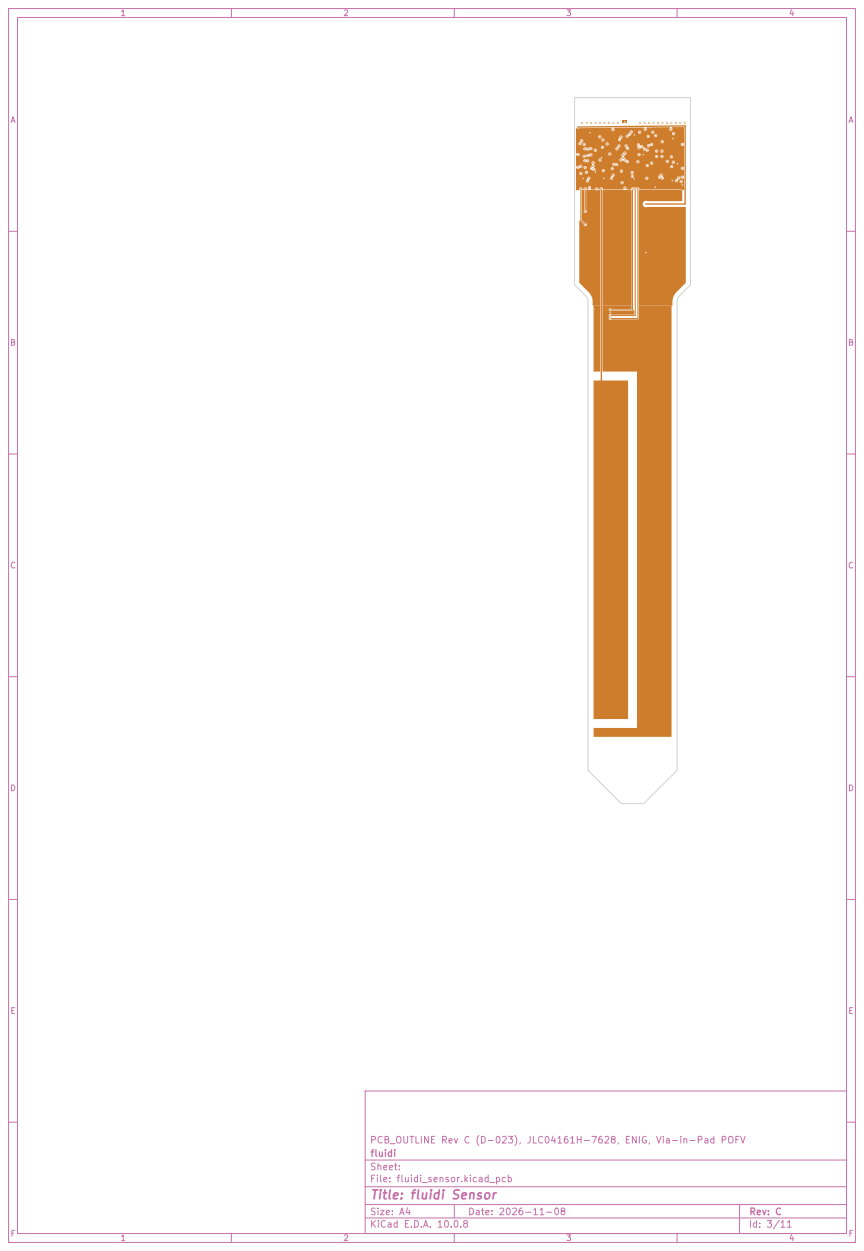
[picture p134: page 3]

PCB_OUTLINE Rev C (D-023), JLC04161H-7628, ENIG, Via-in-Pad POFV
fluidi
Sheet:

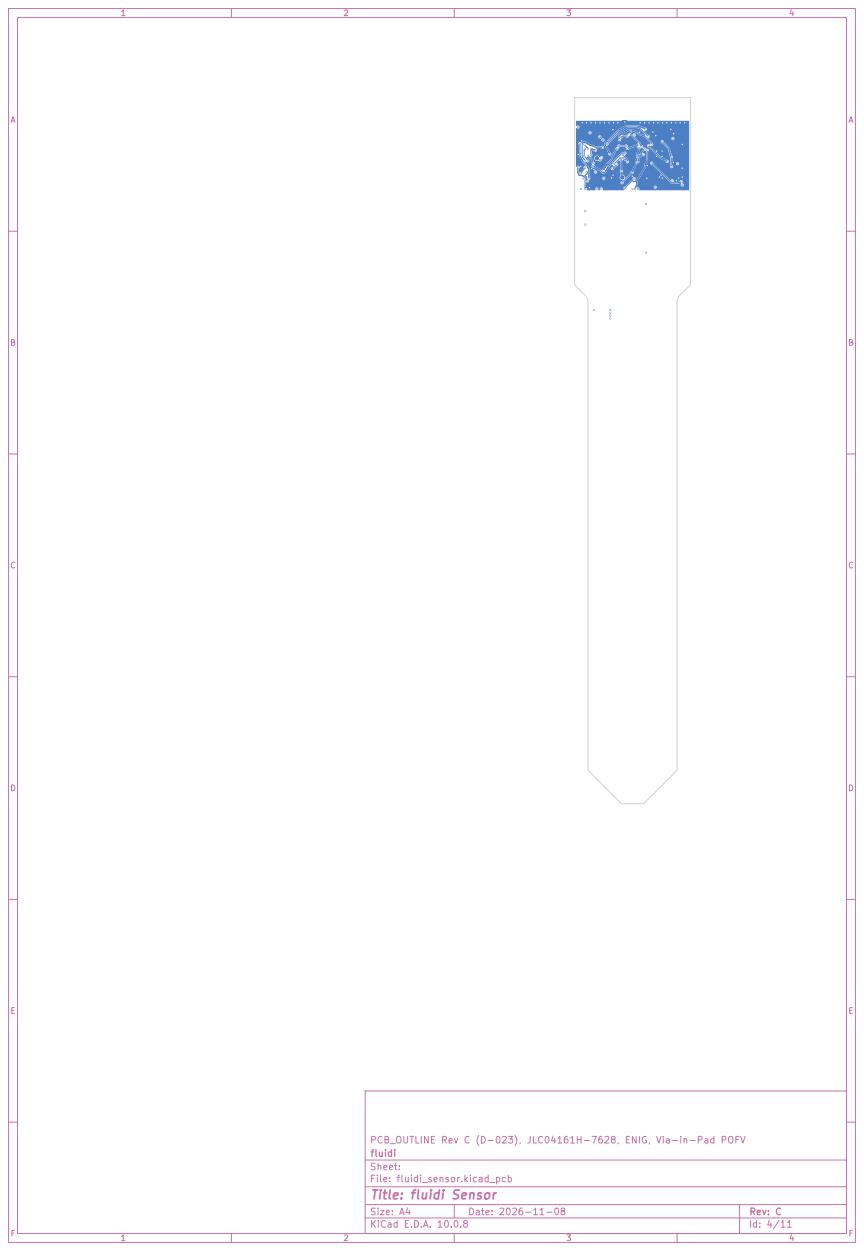
[picture p135: page 4]

PCB_OUTLINE Rev C (D-023), JLC04161H-7628, ENIG, Via-in-Pad POFV
fluidi
Sheet:

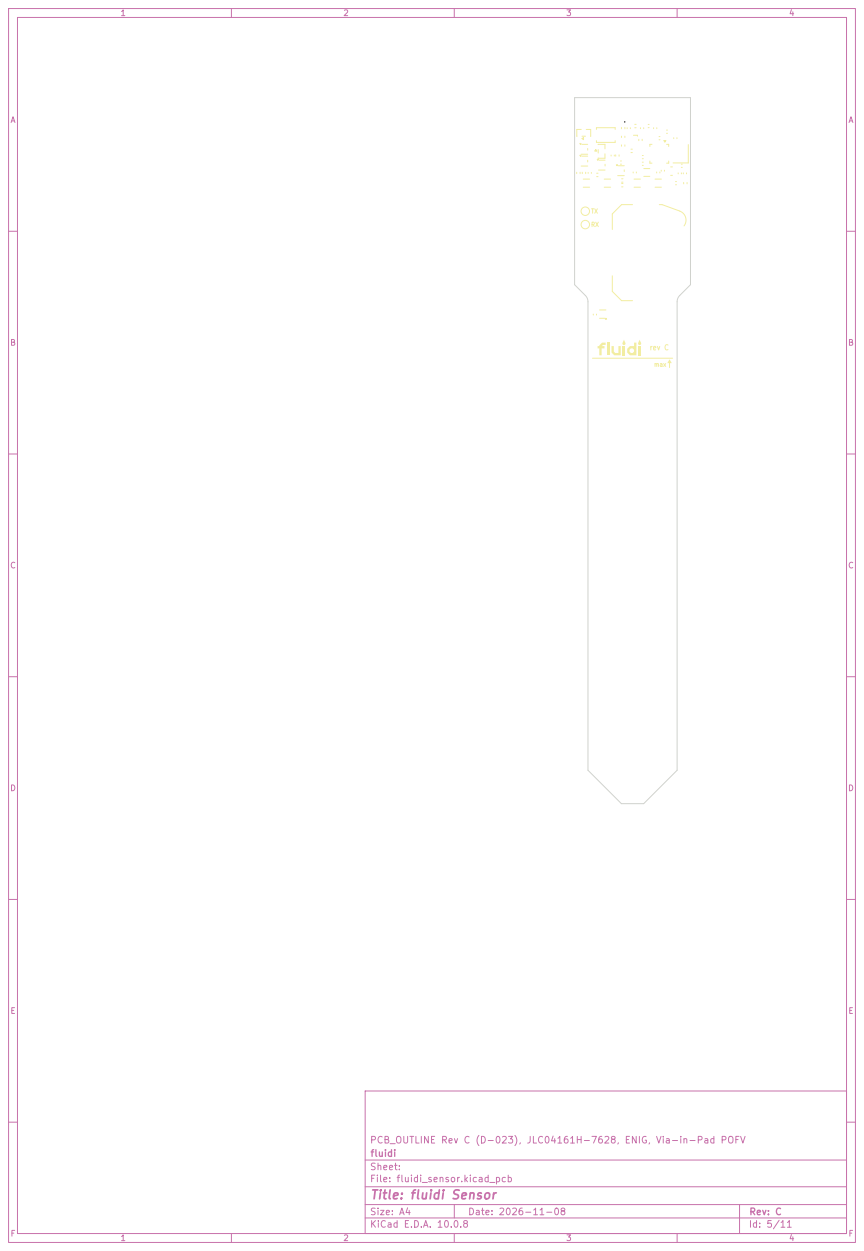
[picture p136: page 5]

PCB_OUTLINE Rev C (D-023), JLC04161H-7628, ENIG, Via-in-Pad POFV
fluidi
Sheet:

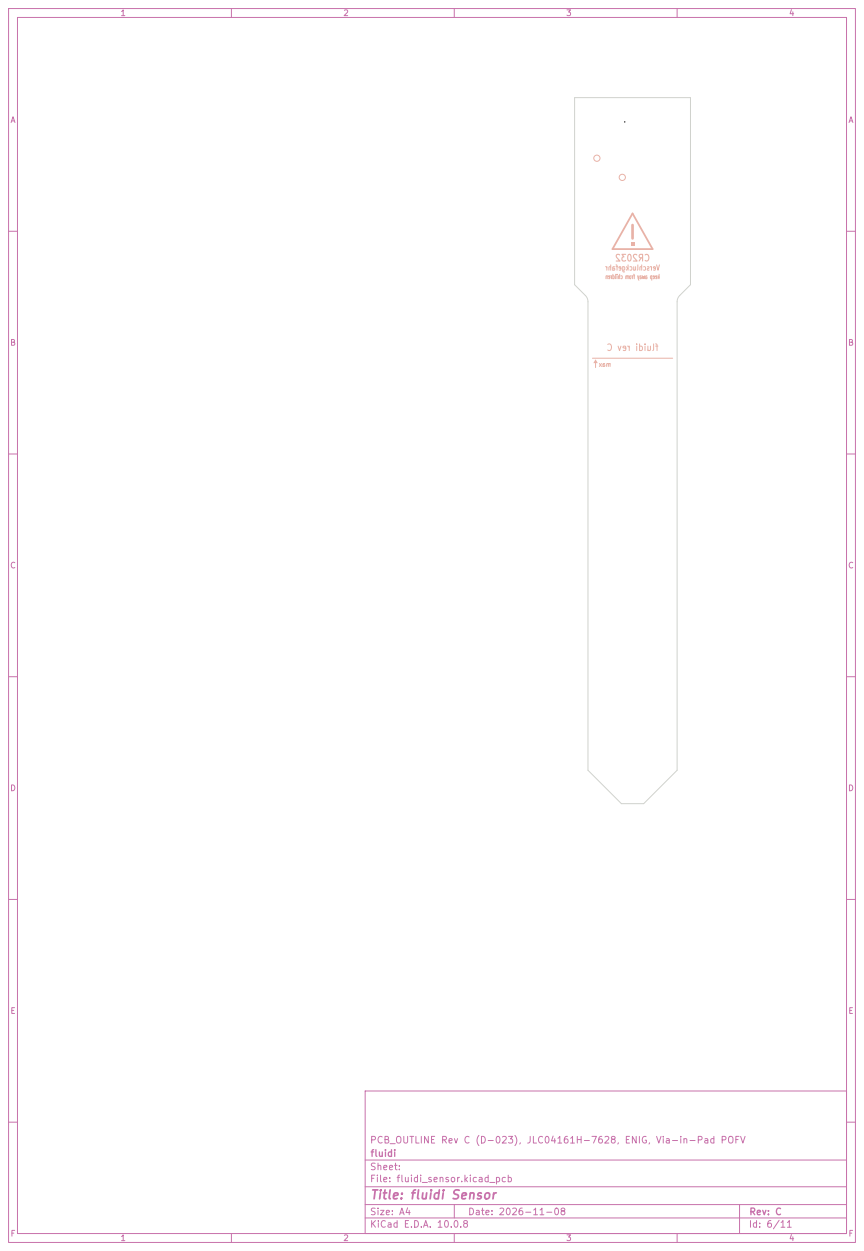
[picture p137: page 6]

PCB_OUTLINE Rev C (D-023), JLC04161H-7628, ENIG, Via-in-Pad POFV
fluidi
Sheet:

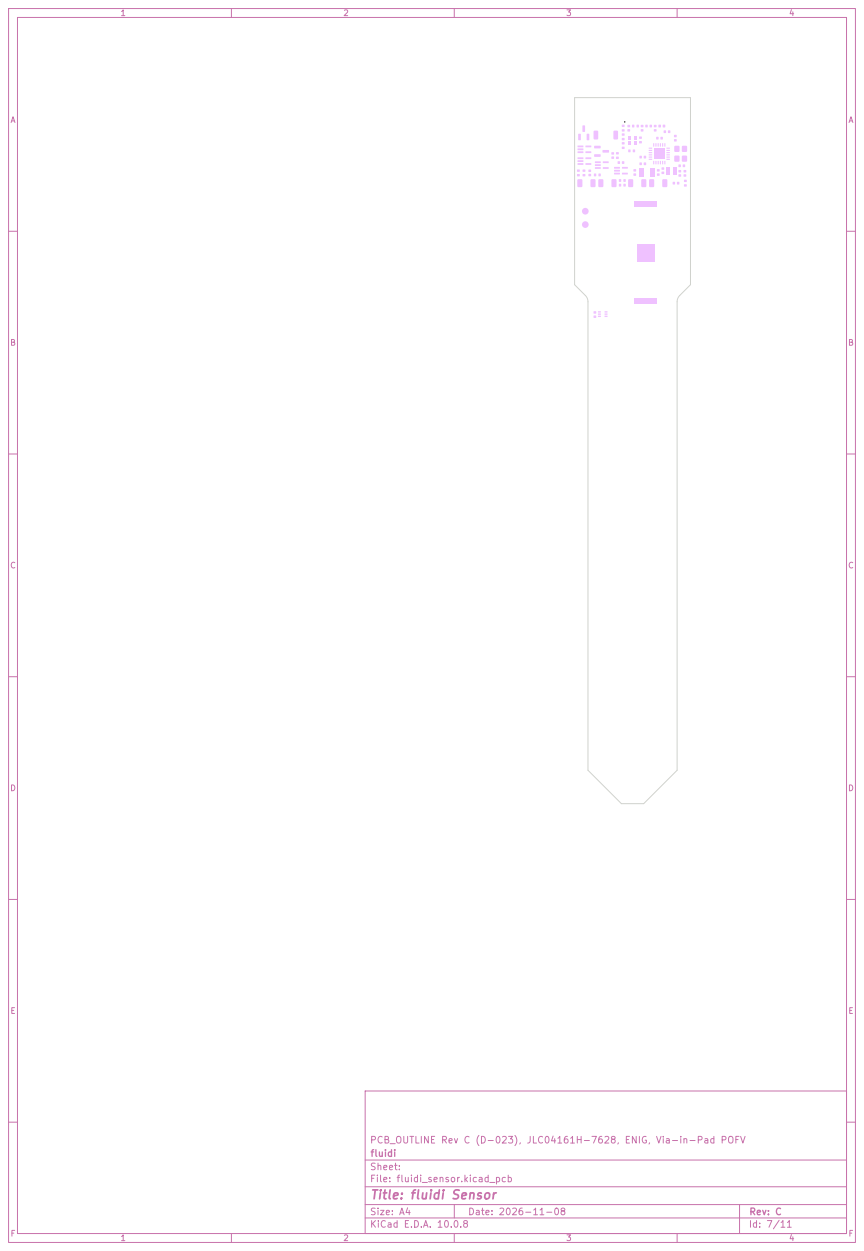
[picture p138: page 7]

PCB_OUTLINE Rev C (D-023), JLC04161H-7628, ENIG, Via-in-Pad POFV
fluidi
Sheet:

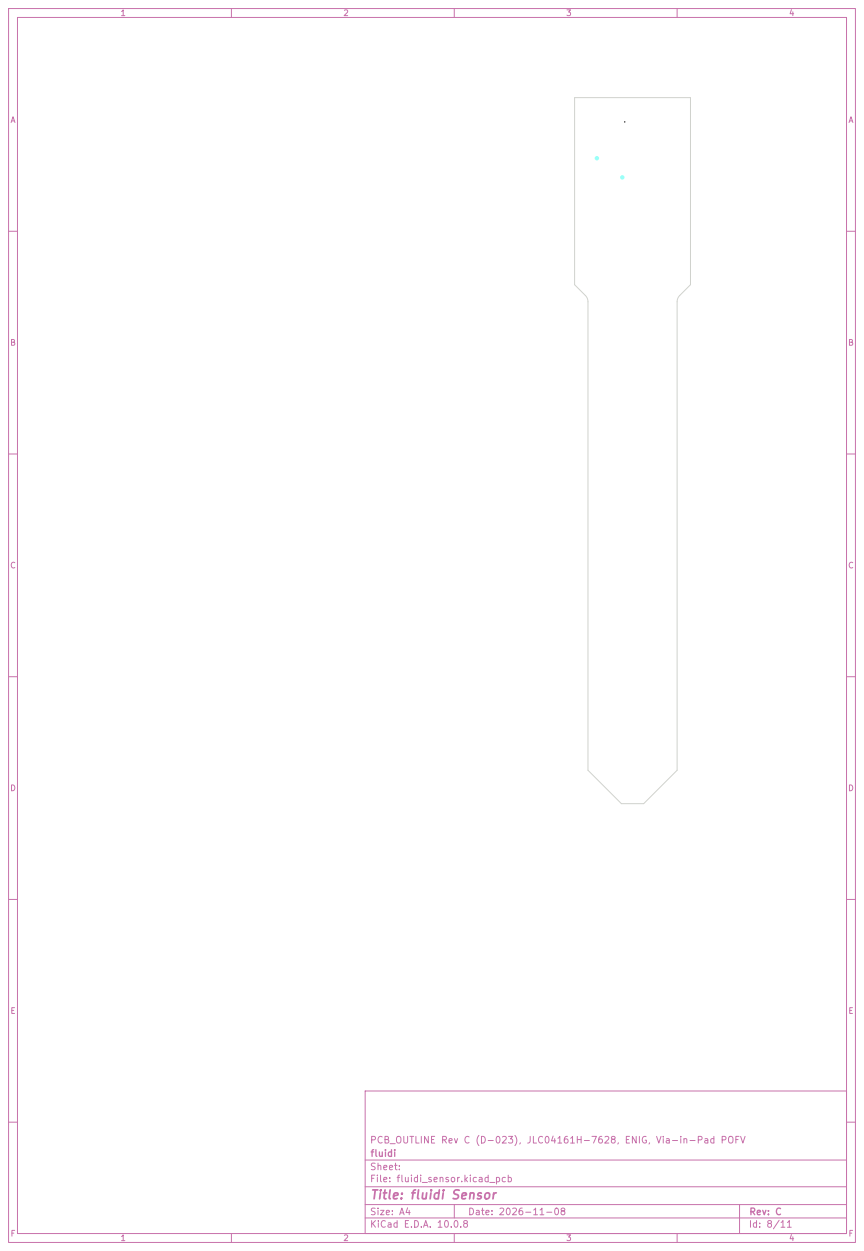
[picture p139: page 8]

PCB_OUTLINE Rev C (D-023), JLC04161H-7628, ENIG, Via-in-Pad POFV
fluidi
Sheet:

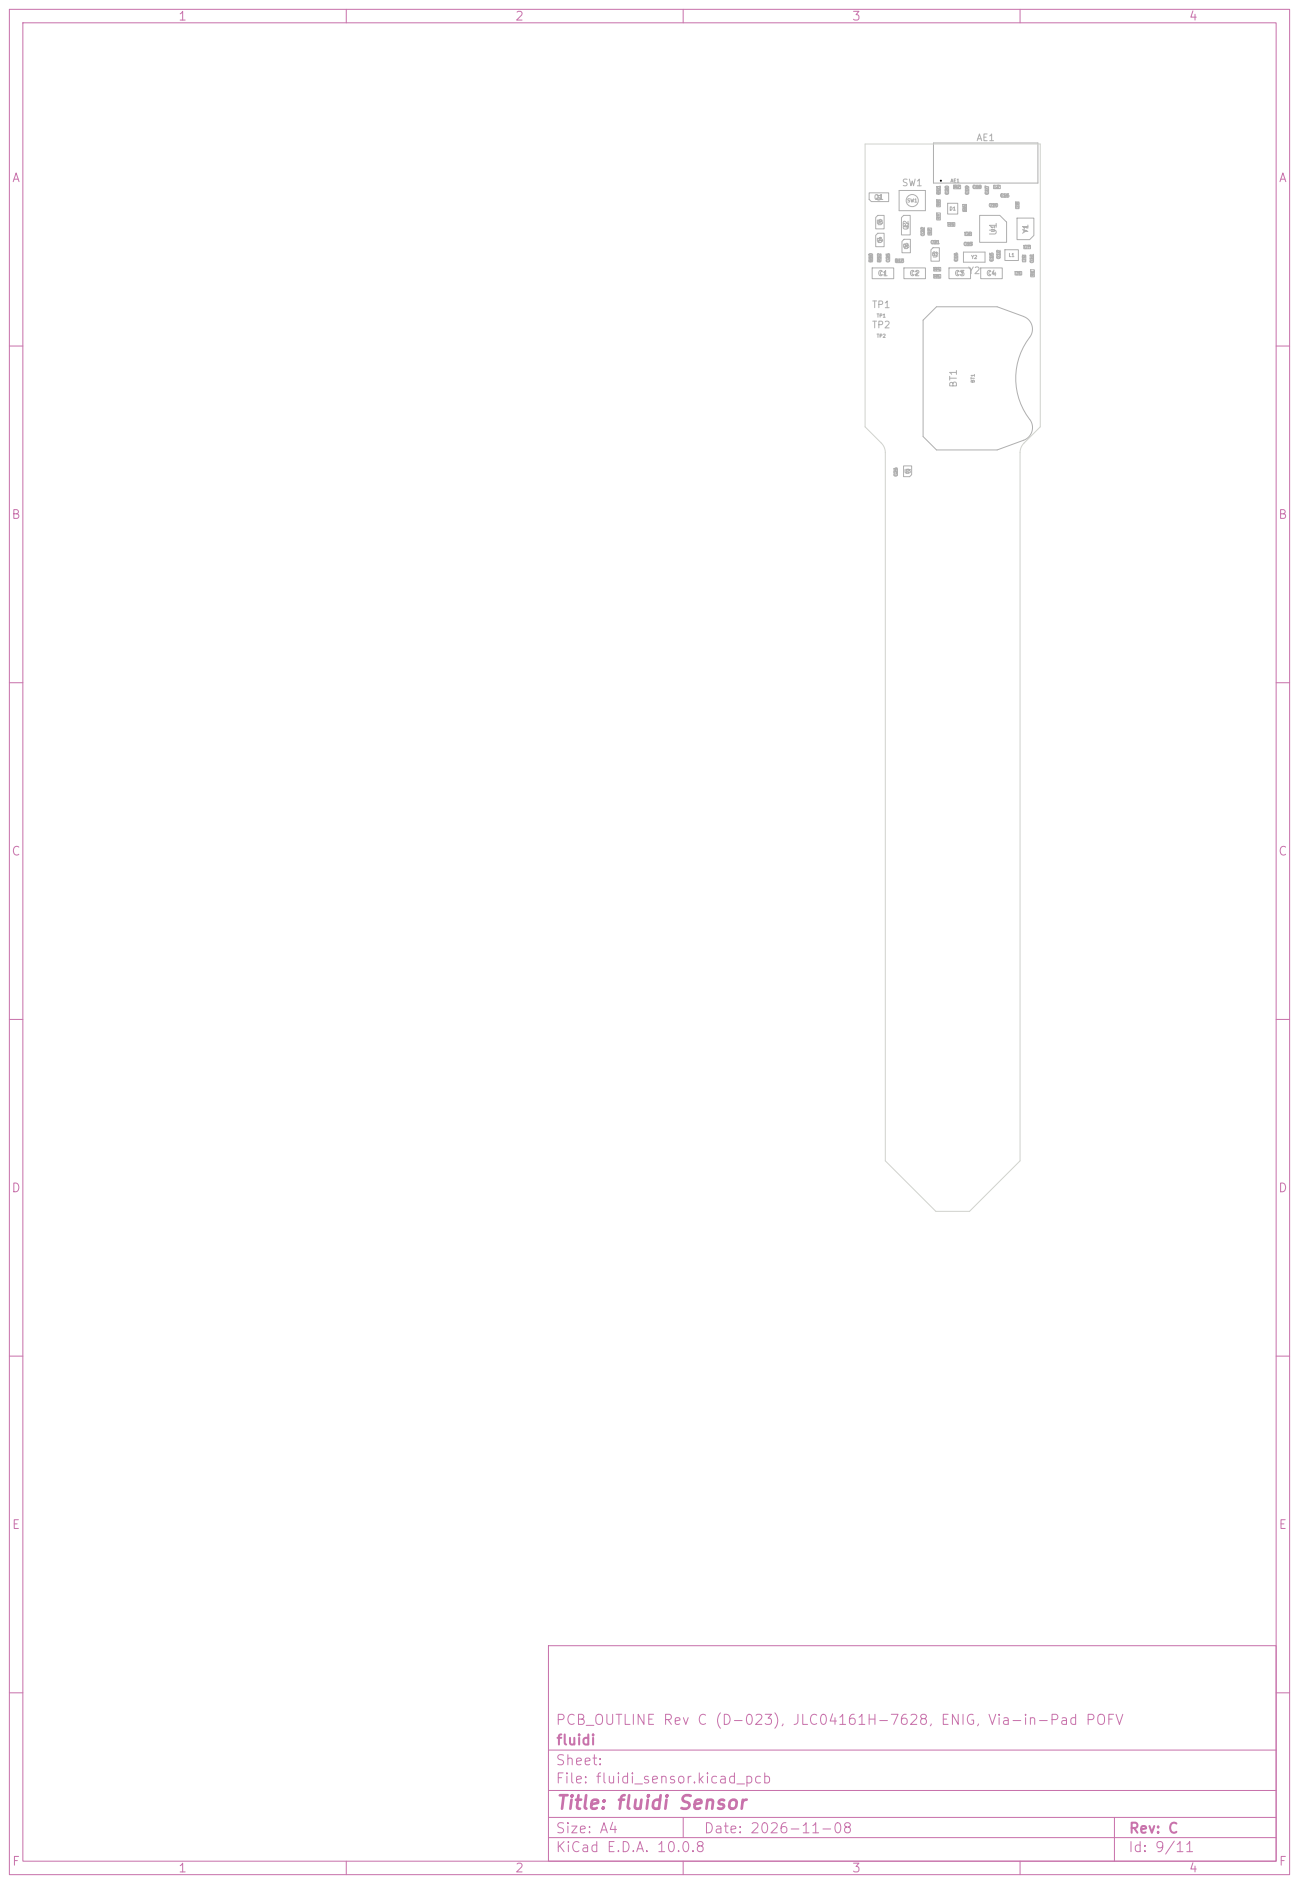
[picture p140: page 9]

PCB_OUTLINE Rev C (D-023), JLC04161H-7628, ENIG, Via-in-Pad POFV
fluidi
Sheet:

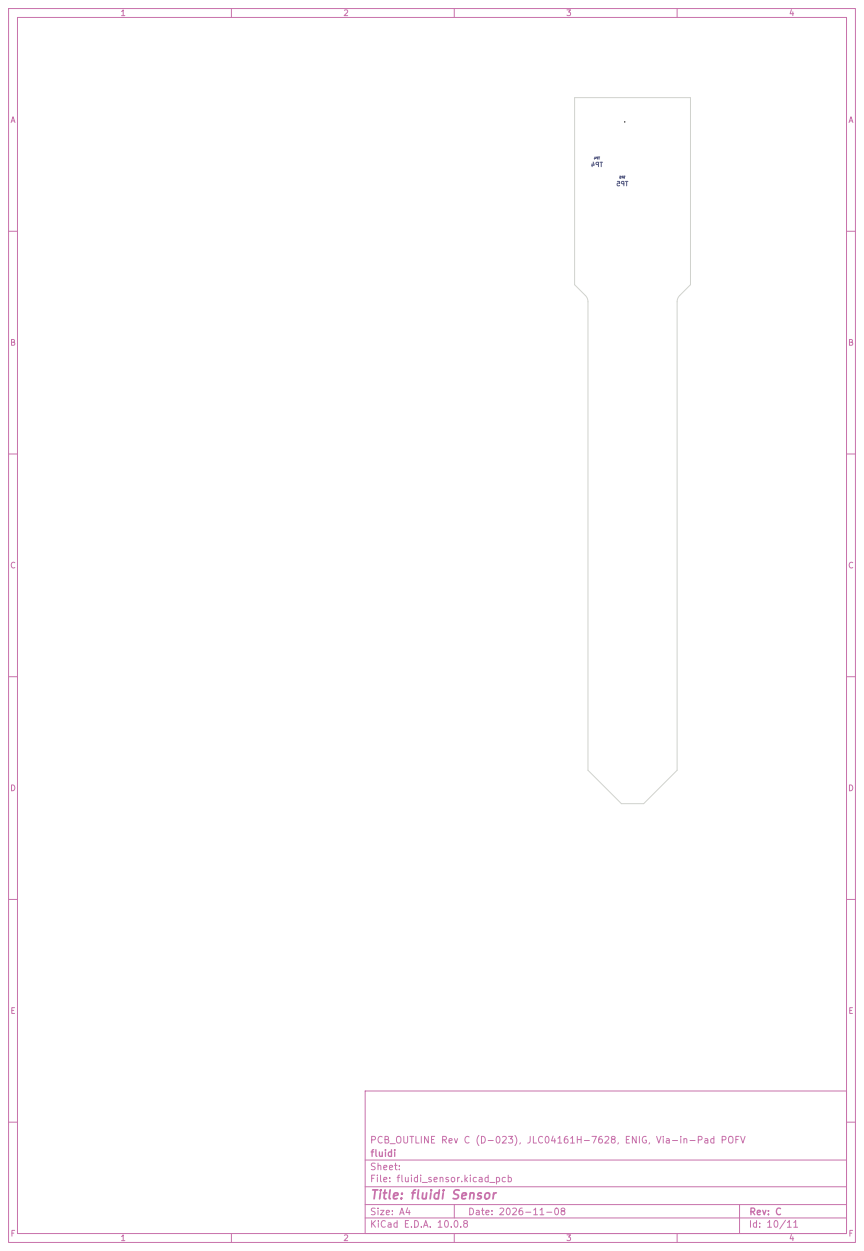
[picture p141: page 10]

PCB_OUTLINE Rev C (D-023), JLC04161H-7628, ENIG, Via-in-Pad POFV
fluidi
Sheet:

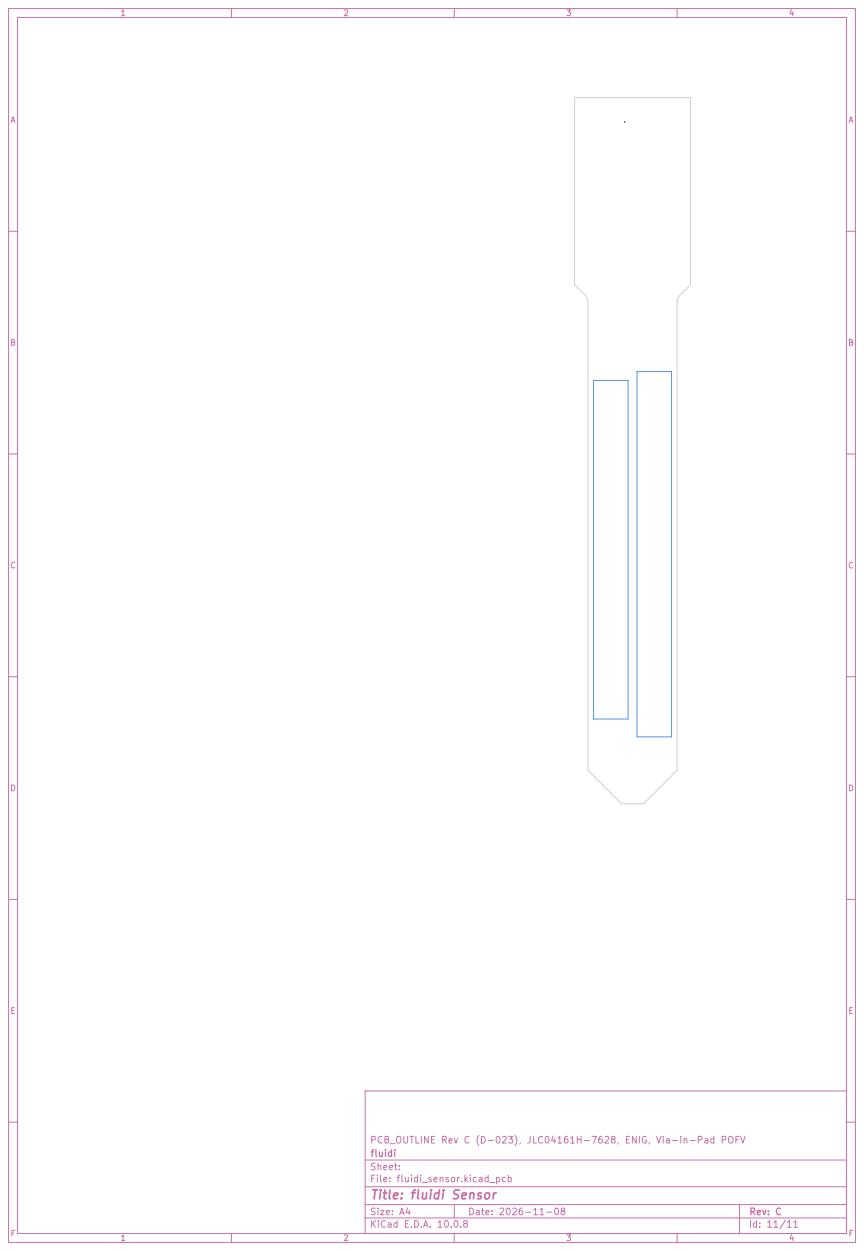
[picture p142: page 11]

PCB_OUTLINE Rev C (D-023), JLC04161H-7628, ENIG, Via-in-Pad POFV
fluidi
Sheet:
