sgeisser1/Tr-pfli/production/rev-C/7_programmieradapter/dummy_cell/fluidi_dummy_plus_layout.pdf

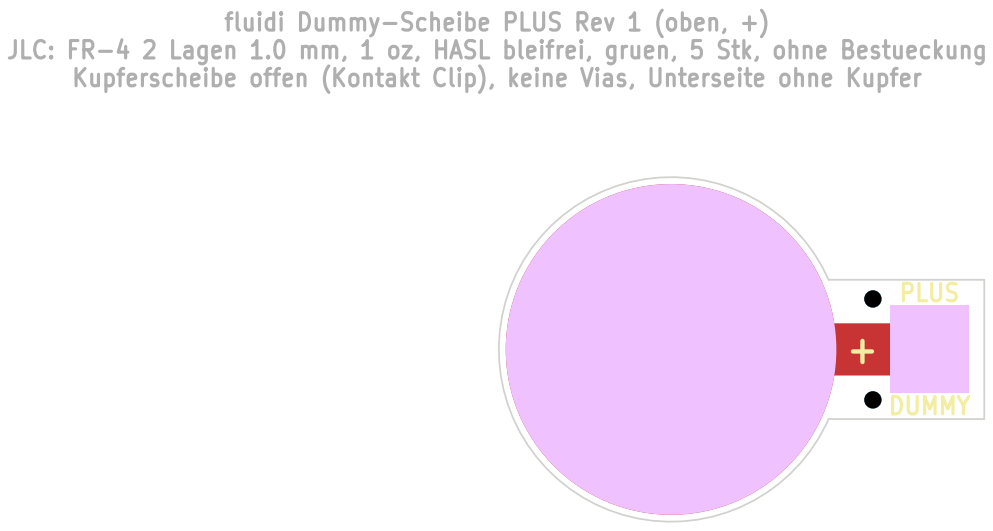
[picture p143: page 1]

fluidi Dummy-Scheibe PLUS Rev 1 (oben, +) JLC: FR-4 2 Lagen 1.0 mm, 1 oz, HASL bleifrei, gruen, 5 Stk, ohne Bestueckung Kupferscheibe offen (Kontakt Clip), keine Vias, Unterseite ohne Kupfer

Size: A4 | Rev:
KiCad E.D.A. 10.0.8 | Id: 1/1
