sgeisser1/Tr-pfli/mechanical/drawings/FL-S-00_zusammenbau_sensor.pdf

# A–A (2:1, Kopf)

# B–B (3:1, Tastenmechanik)

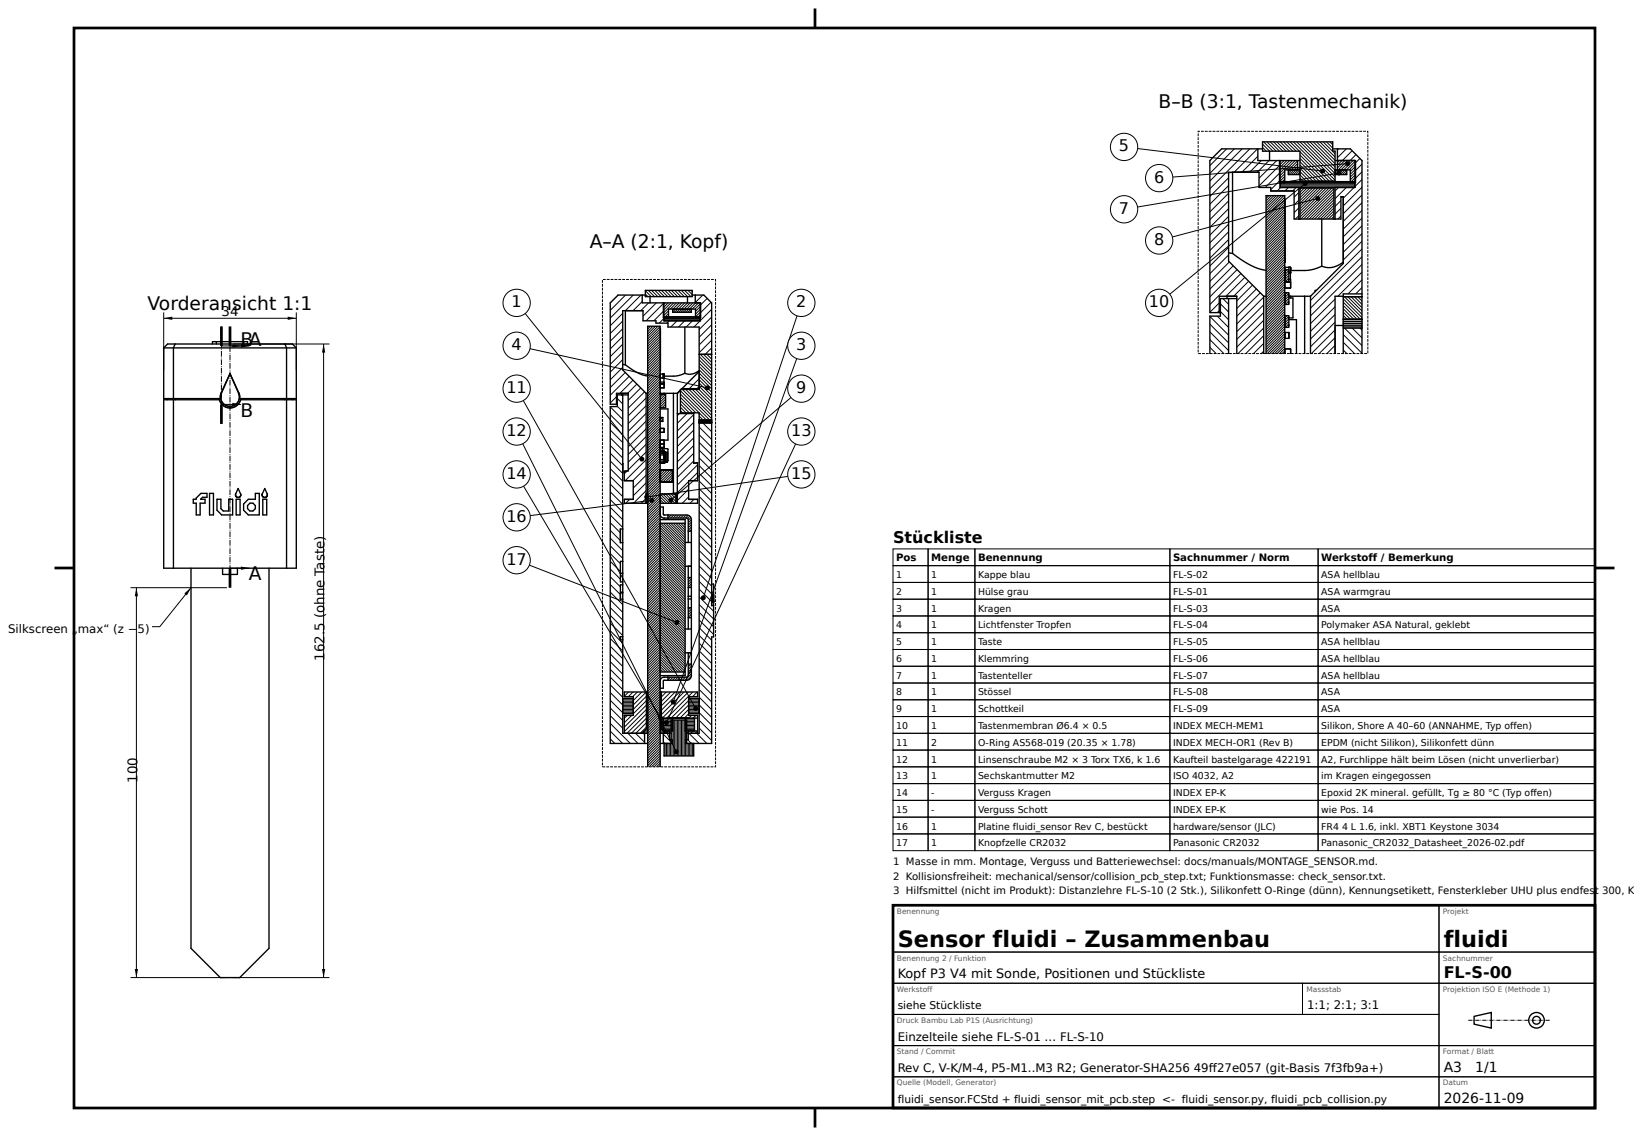
[picture p144: page 1]
Benennung; Projekt fluidi; Sachnummer FL-S-00; Massstab 1:1; 2:1; 3:1; Format / Blatt A3 1/1; Datum 2026-11-09; Vorderansicht 1:1; 162.5 (ohne Taste); Silkscreen „max“ (z −5); Pos; Menge Benennung; Sachnummer / Norm; Werkstoff / Bemerkung; Kappe blau; ASA hellblau; Hülse grau; ASA warmgrau; Kragen; ASA; Lichtfenster Tropfen; Polymaker ASA Natural, geklebt; Taste; Klemmring; Tastenteller; Stössel; Schottkeil; Tastenmembran Ø6.4 × 0.5; INDEX MECH-MEM1; Silikon, Shore A 40–60 (ANNAHME, Typ offen)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

1 Masse in mm. Montage, Verguss und Batteriewechsel: docs/manuals/MONTAGE_SENSOR.md.
2 Kollisionsfreiheit: mechanical/sensor/collision_pcb_step.txt; Funktionsmasse: check_sensor.txt.
3 Hilfsmittel (nicht im Produkt): Distanzlehre FL-S-10 (2 Stk.), Silikonfett O-Ringe (dünn), Kennungsetikett, Fensterkleber UHU plus endfest 300, Kapton-Punkt
Sensor fluidi – Zusammenbau

Benennung 2 / Funktion
Kopf P3 V4 mit Sonde, Positionen und Stückliste

Werkstoff
siehe Stückliste
Druck Bambu Lab P1S (Ausrichtung)
Einzelteile siehe FL-S-01 … FL-S-10

Projektion ISO E (Methode 1)

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

Quelle (Modell, Generator)
fluidi_sensor.FCStd + fluidi_sensor_mit_pcb.step <- fluidi_sensor.py, fluidi_pcb_collision.py
