sgeisser1/Tr-pfli/simulation/spice/programmer/prog_uart_b2_dc.cir

* fluidi PL2303 B2 Bp - erzeugt von prog_uart.py (nicht von Hand aendern)
.include ../led_rgb/led_models.inc
VDD vdd 0 DC 2.1
VTX tx0 0 DC 0.1
RTX tx0 tp2 200
R12 tp2 mid 100k
R11 mid dio20 100k
DBLED vdd aBLED DB
VOBLED aBLED bBLED DC {OFF_B_MIN}
RBLED bBLED dio20 100
.control
set wr_singlescale
set wr_vecnames
option numdgt=7
op
wrdata prog_uart_b2_dc.dat v(dio20)
quit
.endc
.end
