sgeisser1/Tr-pfli/simulation/spice/programmer/prog_uart_b2_rx.cir

* fluidi B2 RX - erzeugt von prog_uart.py (nicht von Hand aendern)
.include ../led_rgb/led_models.inc
VDD vdd 0 DC 2.1
VTX tx0 0 PWL(0 2.1 0.000104166667 2.1 0.000104176667 0 0.00015625 0 0.00015626 2.1 0.000208333333 2.1 0.000208343333 0 0.000260416667 0 0.000260426667 2.1 0.0003125 2.1 0.00031251 0 0.000364583333 0 0.000364593333 2.1 0.000416666667 2.1 0.000416676667 0 0.00046875 0 0.00046876 2.1 0.000520833333 2.1 0.000520843333 0 0.000572916667 0 0.000572926667 2.1 0.000625 2.1 0.00062501 0 0.000677083333 0 0.000677093333 2.1 0.000729166667 2.1 0.000729176667 0 0.00078125 0 0.00078126 2.1 0.000833333333 2.1 0.000833343333 0 0.000885416667 0 0.000885426667 2.1 0.0009375 2.1 0.00093751 0 0.000989583333 0 0.000989593333 2.1 0.00104166667 2.1 0.00104167667 0 0.00109375 0 0.00109376 2.1 0.00114583333 2.1 0.00114584333 0 0.00161458333 0 0.00161459333 2.1 0.00166666667 2.1 0.00166667667 0 0.00171875 0 0.00171876 2.1 0.0021875 2.1 0.00218751 0 0.00223958333 0 0.00223959333 2.1 0.00229166667 2.1 0.00229167667 0 0.00265625 0 0.00265626 2.1 0.00270833333 2.1 0.00270834333 0 0.003125 0 0.00312501 2.1 0.00322916667 2.1 0.00322917667 0 0.00338541667 0 0.00338542667 2.1 0.00348958333 2.1 0.00348959333 0 0.00359375 0 0.00359376 2.1 0.00375 2.1 0.00375001 0 0.00380208333 0 0.00380209333 2.1 0.00390625 2.1 0.00390626 0 0.00401041667 0 0.00401042667 2.1 0.00411458333 2.1 0.00411459333 0 0.00421875 0 0.00421876 2.1 0.00447916667 2.1 0.00447917667 0 0.00604166667 0 0.00604167667 2.1 0.00760416667 2.1)
RTX tx0 tp2 200
CTP2 tp2 0 30p
R12 tp2 mid 100k
CMID mid 0 3p
R11 mid dio20 100k
CPIN dio20 0 9p
DBLED vdd aBLED DB
VOBLED aBLED bBLED DC {OFF_B_MIN}
RBLED bBLED dio20 100
CLED vdd aBLED 30p
.control
set wr_singlescale
set wr_vecnames
option numdgt=7
tran 1.302e-07 0.00760417 0 2.604e-07
wrdata prog_uart_b2_rx.dat v(dio20) v(tp2)
quit
.endc
.end
