sgeisser1/Tr-pfli/simulation/spice/programmer/prog_uart_tx.cir

* fluidi TX - erzeugt von prog_uart.py (nicht von Hand aendern)
.include ../led_rgb/led_models.inc
VDD vdd 0 DC 2.0
VIO vio 0 DC 2.0
VDRV drv 0 PWL(0 2 3.47222222e-05 2 3.47322222e-05 0 5.20833333e-05 0 5.20933333e-05 2 6.94444444e-05 2 6.94544444e-05 0 8.68055556e-05 0 8.68155556e-05 2 0.000104166667 2 0.000104176667 0 0.000121527778 0 0.000121537778 2 0.000138888889 2 0.000138898889 0 0.00015625 0 0.00015626 2 0.000173611111 2 0.000173621111 0 0.000190972222 0 0.000190982222 2 0.000208333333 2 0.000208343333 0 0.000225694444 0 0.000225704444 2 0.000243055556 2 0.000243065556 0 0.000260416667 0 0.000260426667 2 0.000277777778 2 0.000277787778 0 0.000295138889 0 0.000295148889 2 0.0003125 2 0.00031251 0 0.000329861111 0 0.000329871111 2 0.000347222222 2 0.000347232222 0 0.000364583333 0 0.000364593333 2 0.000381944444 2 0.000381954444 0 0.000538194444 0 0.000538204444 2 0.000555555556 2 0.000555565556 0 0.000572916667 0 0.000572926667 2 0.000729166667 2 0.000729176667 0 0.000746527778 0 0.000746537778 2 0.000763888889 2 0.000763898889 0 0.000885416667 0 0.000885426667 2 0.000902777778 2 0.000902787778 0 0.00104166667 0 0.00104167667 2 0.00107638889 2 0.00107639889 0 0.00112847222 0 0.00112848222 2 0.00116319444 2 0.00116320444 0 0.00119791667 0 0.00119792667 2 0.00125 2 0.00125001 0 0.00126736111 0 0.00126737111 2 0.00130208333 2 0.00130209333 0 0.00133680556 0 0.00133681556 2 0.00137152778 2 0.00137153778 0 0.00140625 0 0.00140626 2 0.00149305556 2 0.00149306556 0 0.00201388889 0 0.00201389889 2 0.00253472222 2)
RDRV drv dio6 480
DRLED vdd aRLED DR
VORLED aRLED bRLED DC {OFF_R_MIN}
RRLED bRLED dio6 470
R9 dio6 mid 100k
CMID mid 0 1p
R10 mid tp1 100k
CTP tp1 0 2p
CAD tp1 0 40p
RPU tp1 vio 10Meg
ILK 0 tp1 DC 0.5u
.control
set wr_singlescale
set wr_vecnames
option numdgt=7
tran 4.34e-08 0.00253472 0 8.681e-08
wrdata prog_uart_tx.dat v(tp1) v(dio6)
quit
.endc
.end
