sgeisser1/Tr-pfli/simulation/spice/led_rgb/led_rgb_drive.cir

* fluidi RGB-LED-Treiber, erzeugt von led_rgb_drive.py
.include led_models.inc
VDD vdd 0 DC 3.0
D1 vdd a1 DR
VO1 a1 b1 DC {OFF_R_MIN}
RS1 b1 g1 470
RON1 g1 m1 100
VM1 m1 0 DC 0
D2 vdd a2 DR
VO2 a2 b2 DC {OFF_R_MIN}
RS2 b2 g2 470
RON2 g2 m2 40
VM2 m2 0 DC 0
D3 vdd a3 DR
VO3 a3 b3 DC {OFF_R_MID}
RS3 b3 g3 470
RON3 g3 m3 100
VM3 m3 0 DC 0
D4 vdd a4 DR
VO4 a4 b4 DC {OFF_R_MID}
RS4 b4 g4 470
RON4 g4 m4 40
VM4 m4 0 DC 0
D5 vdd a5 DR
VO5 a5 b5 DC {OFF_R_MAX}
RS5 b5 g5 470
RON5 g5 m5 100
VM5 m5 0 DC 0
D6 vdd a6 DR
VO6 a6 b6 DC {OFF_R_MAX}
RS6 b6 g6 470
RON6 g6 m6 40
VM6 m6 0 DC 0
D7 vdd a7 DR
VO7 a7 b7 DC {OFF_R_MIN}
RS7 b7 g7 200
RON7 g7 m7 100
VM7 m7 0 DC 0
D8 vdd a8 DR
VO8 a8 b8 DC {OFF_R_MIN}
RS8 b8 g8 200
RON8 g8 m8 40
VM8 m8 0 DC 0
D9 vdd a9 DR
VO9 a9 b9 DC {OFF_R_MID}
RS9 b9 g9 200
RON9 g9 m9 100
VM9 m9 0 DC 0
D10 vdd a10 DR
VO10 a10 b10 DC {OFF_R_MID}
RS10 b10 g10 200
RON10 g10 m10 40
VM10 m10 0 DC 0
D11 vdd a11 DR
VO11 a11 b11 DC {OFF_R_MAX}
RS11 b11 g11 200
RON11 g11 m11 100
VM11 m11 0 DC 0
D12 vdd a12 DR
VO12 a12 b12 DC {OFF_R_MAX}
RS12 b12 g12 200
RON12 g12 m12 40
VM12 m12 0 DC 0
D13 vdd a13 DG
VO13 a13 b13 DC {OFF_G_MIN}
RS13 b13 g13 470
RON13 g13 m13 100
VM13 m13 0 DC 0
D14 vdd a14 DG
VO14 a14 b14 DC {OFF_G_MIN}
RS14 b14 g14 470
RON14 g14 m14 40
VM14 m14 0 DC 0
D15 vdd a15 DG
VO15 a15 b15 DC {OFF_G_MID}
RS15 b15 g15 470
RON15 g15 m15 100
VM15 m15 0 DC 0
D16 vdd a16 DG
VO16 a16 b16 DC {OFF_G_MID}
RS16 b16 g16 470
RON16 g16 m16 40
VM16 m16 0 DC 0
D17 vdd a17 DG
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
print i(VM23)
print i(VM24)
print i(VM25)
print i(VM26)
print i(VM27)
print i(VM28)
print i(VM29)
print i(VM30)
print i(VM31)
print i(VM32)
print i(VM33)
print i(VM34)
print i(VM35)
print i(VM36)
print i(VM37)
print i(VM38)
print i(VM39)
print i(VM40)
print i(VM41)
print i(VM42)
.endc
.end
