sgeisser1/Tr-pfli/(list of files, drawings)

Other design files:
mechanical/interfaces/pcb_outline.json
