sgeisser1/Tr-pfli/docs/datasheets/Adafruit_4282_PiRTC-DS3231_Schematic_2021-02-22.sch

## EAGLE design docs/datasheets/Adafruit_4282_PiRTC-DS3231_Schematic_2021-02-22.sch (2026-11-08)

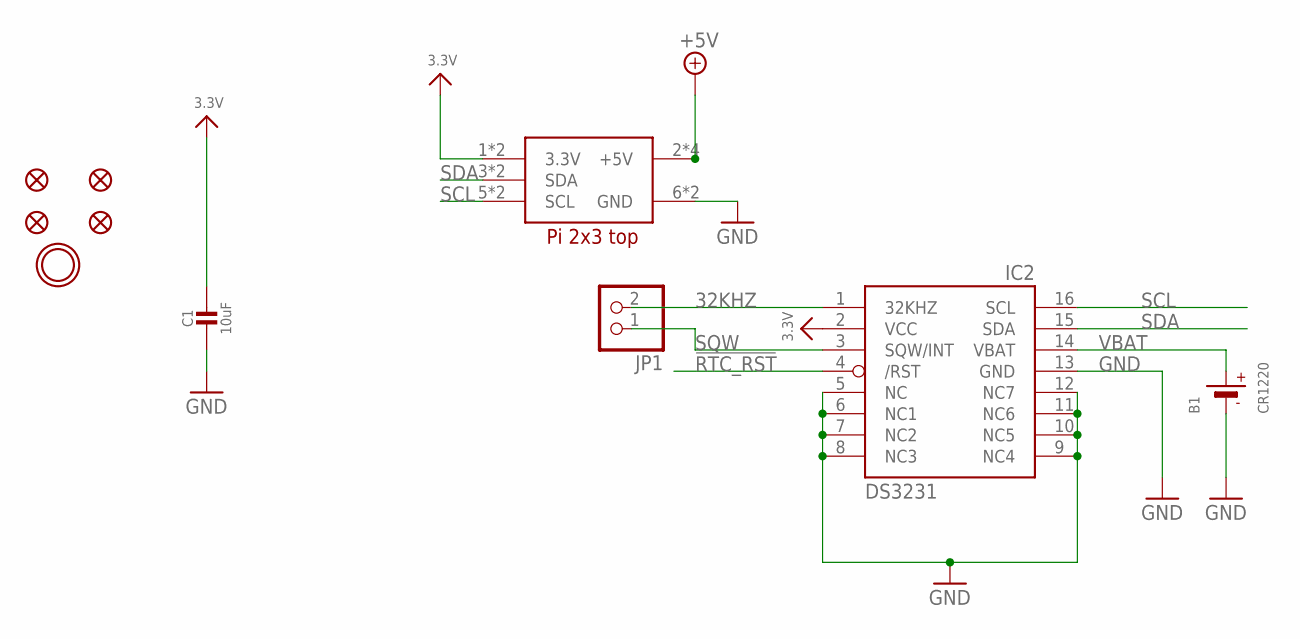
[picture p145: schematic Adafruit_4282_PiRTC-DS3231_Schematic_2021-02-22.sch]

Parts:
B1: CR1220
C1: 10uF; 0805-NO
FID1, FID2, FID3, FID4: FIDUCIAL_1MM
IC2: DS3231/SO; SO16W
JP1: HEADER-1X2ROUND; 1X02_ROUND
RPI1: RASPBERRYPI_2X3; RASPBERRYPI_2X3_THMSMT
U$4: MOUNTINGHOLE3.0THIN; MOUNTINGHOLE_3.0_PLATEDTHIN

Connections:
3.3V: C1.1, IC2.2 (VCC), RPI1.1 (3.3V)
32KHZ: IC2.1 (32KHZ), JP1.2
!RTC_RST: IC2.4 (/RST)
+5V: RPI1.2 (+5V)
GND: B1.-, C1.2, IC2.5 (NC), IC2.6 (NC1), IC2.7 (NC2), IC2.8 (NC3), IC2.9 (NC4), IC2.10 (NC5), IC2.11 (NC6), IC2.12 (NC7), IC2.13 (GND), RPI1.6 (GND)
SCL: IC2.16 (SCL), RPI1.5 (SCL)
SDA: IC2.15 (SDA), RPI1.3 (SDA)
SQW: IC2.3 (SQW/INT), JP1.1
VBAT: B1.+$1 (+), IC2.14 (VBAT)
