sgeisser1/Tr-pfli/(commit log)

2026-11-06 Phase 0: Projektstruktur, Toolcheck, Agentenrollen, Projektregeln
    - Ordnerstruktur gemäss Projektvorgabe
    - scripts/toolcheck.sh (reproduzierbarer Toolcheck) und Ergebnis
    - scripts/install_tools.sh (Vorschlag, noch nicht ausgeführt)
    - 8 Subagenten unter .claude/agents/
    - CLAUDE.md mit gemeinsamen Regeln, DECISIONS.md, Bauteilregister-Vorlage
    [INDEX.csv]
2026-11-06 Phase 0: Antworten des Auftraggebers festgehalten
2026-11-06 D-002: KiCad 9 vs 10 geprüft, Entscheid KiCad 10.0.8
2026-11-06 Phase 0 abgeschlossen: Tools installiert und verifiziert
    - KiCad 10.0.8 in WSL und Windows, .venv mit gmsh/scikit-fem/meshio/pypdf
    - Elmer-Hänger in WSL gelöst (HWLOC_COMPONENTS=-gl, scripts/elmer.sh), Selbsttest
    - toolcheck.sh nutzt .venv und testet Elmer
    - Präzisierungen des Auftraggebers (Aktualisierung, Firmen-WLAN)
2026-11-06 Phase 1: Anforderungsdokument Entwurf v0.1 und Projektauftrag abgelegt
2026-11-06 Phase 1: Anforderungen v0.2 nach Prüfrunde 1, Prüfberichte und Antworten
2026-11-06 Phase 2: Recherchen Elektronik, Energie, Fertigung, Gateway; Datenblätter und Bauteilregister
    [HEADER.csv, INDEX.csv, INDEX_elektronik.csv, INDEX_energie.csv, INDEX_gateway.csv]
2026-11-06 Auftraggeber: JLC-Preise, Versand CH, Firmen-WLAN-Test
    [INDEX_konzepte.csv, bom_A.csv, bom_B.csv, bom_B2.csv, bom_B_Osz.csv, bom_C.csv]
2026-11-06 Phase 2: Konzeptdokument v0.1 (A Knopf, B Spar, C Akku, Gateway), BOMs, Kosten- und Energieauswertung
    [INDEX.csv, bom_A2.csv]
2026-11-06 Phase 2: Konzepte v0.2 nach Prüfrunde 1, Antworten auf alle Befunde
    [INDEX.csv, INDEX_konzepte.csv, bom_A.csv, bom_A2.csv, bom_A32.csv, bom_B.csv, bom_B2.csv, bom_B_Osz.csv]
2026-11-06 Phase 2: Konzepte v0.3 mit Entscheiden des Projektleiters, Empfehlung A-32
    [INDEX.csv, INDEX_konzepte.csv, bom_A.csv, bom_A2.csv, bom_A32.csv, bom_B.csv, bom_C.csv]
2026-11-07 Phase 3: 4 Designvorschläge Sensorkopf, 2 Gateway-Gehäuse, 3 Logo-Varianten, Renderings und Generatoren
    [familie.blend, gateway.blend, p1_facette.blend, p2_keil.blend, p3_stele.blend, p4_gipfel.blend]
2026-11-07 Phase 3: Mechanik-Kurzprüfung der Designvorschläge
2026-11-07 Phase 3: Machbarkeit Hülsen-Batteriewechsel (Mechanik, Sicherheit), RGB-LED und interne Gateway-Antenne (Elektronik)
    [INDEX.csv, INDEX_rgb.csv, p3_sleeve_A1_28x13x48_sonde20.FCStd, p3_sleeve_A1_28x13x48_sonde20.step, p3_sleeve_A1_30x13x48_sonde22.FCStd, p3_sleeve_A1_30x13x48_sonde22.step]
2026-11-07 Phase 3: Verfeinerung 1 P3 fluidi (grau/blau, RGB-Tropfen, Hülsen-Batteriewechsel, Gateway ohne Stabantenne, Logo fluidi)
    [g1v2_familie.blend, g1v2_gateway.blend, p3v2_explosion.blend, p3v2_nah.blend, p3v2_topf_grau1.blend, p3v2_topf_grau2.blend, p3v2_unten.blend]
2026-11-07 Phase 3: Verfeinerung 2 (Gateway-Tropfen-LED, 4 ruhigere Wortmarken, App-Icon als Sensor-Kachel)
    [g1v3_familie_3sensoren.blend, g1v3_gateway.blend]
2026-11-07 D-011: Gateway freigegeben, Wortmarke v3a, App-Icon als Sensor-Nahaufnahme
2026-11-07 Phase 3: App-Icon final (Sensor-Nahaufnahme, alle Grössen, maskable), Design-Dokument v3
    [app_icon_render_2048.blend]
2026-11-07 Phase 4: Installationsskript Firmware-Werkzeuge (TI F3 SDK, TI Arm Clang, SysConfig, ESP-IDF v6.1), Funkprotokoll v0.1
    [INDEX.csv]
2026-11-07 Phase 4a: Schaltplan Sensor Rev A per Generator (ERC 0 Fehler KiCad 10 WSL+Windows), Pinplan, SPICE Versorgung/Oszillator/Rückstrom; D-013
    [INDEX.csv, INDEX_schaltplan.csv, deckel_blau.3mf, deckel_blau.step, deckel_blau.stl, distanzlehre_23p5.3mf, distanzlehre_23p5.step, distanzlehre_23p5.stl]
2026-11-07 Phase 4d: Gateway-Architektur (plattformneutral), API-Spezifikation, App-Prototyp mit Mock-Backend und Tests
    [INDEX.csv]
2026-11-07 Phase 4b: Schnittstelle PCB-Kontur Rev A, Sensor- und Gateway-CAD mit Druckteilen und Druckprofil, FEM Sonde
    [deckel_blau.3mf, deckel_blau.step, distanzlehre_23p5.3mf, distanzlehre_23p5.step, fenster_tropfen.3mf, fenster_tropfen.step, fenster_tropfen.stl, fenster_tropfen_gw.3mf]
2026-11-07 D-014 Gateway Raspberry Pi Zero 2 W, D-015 Software-Wünsche
2026-11-07 Phase 4a: Feldsimulation Sonde (2D/3D, Salz, Drift), Elektrodenempfehlung SG, Schnittstelle Sondenkapazität; ungültige Zwischenstände entfernt
    [INDEX.csv, results.csv, salt_index_2d.csv, study2d.csv, study2d_salt.csv]
2026-11-07 Phase 4a: Flächenbilanz Kopf und Optionen (Kopfhöhe, beidseitig, Temperatursensor im Kragen)
    [INDEX_gateway_pi.csv]
2026-11-07 D-017: Raumklima-Sensor im Gateway
2026-11-07 Phase 4b: Gateway-Gehäuse G1 v4 für Raspberry Pi Zero 2 W mit Klimakammer (84 x 42 x 20 mm)
    [INDEX.csv, deckel_blau.3mf, deckel_blau.step, deckel_blau.stl, fenster_tropfen_gw.3mf, fenster_tropfen_gw.step, fenster_tropfen_gw.stl, fluidi_gateway_pi.FCStd]
2026-11-07 Phase 4a: Entscheidungsvorlage Messkette/Salz (Varianten A-D, Empfehlung D3: 17-36 MHz + Teiler)
    [INDEX.csv, INDEX_salz.csv]
2026-11-07 Proportionsstudie Sensorkopf V0-V5 (Höhe/Breite/Fugenlage), Renderings und PDF
2026-11-07 Pflanzenprofile: 40 Arten mit Giessregime und Quellen; D-021
2026-11-07 Phase 4a: Schaltplan Sensor Rev B (Messkette D3, TMP1075N im Kragen, kleinere Bauteile), ERC 0 Fehler, PINMAP Rev B, SPICE, Kosten
    [INDEX.csv, INDEX_mech_b.csv, INDEX_schaltplan_b.csv, fluidi_sensor.kicad_sch, fluidi_sensor_bom_extra.csv, fluidi_sensor_bom_jlc.csv, fluidi_sensor_bom_raw.csv, osc_results.csv]
2026-11-07 Phase 4c: Sensor-Firmware CC2340R52 (BLE-Protokoll, Messkette D3, Ringpuffer, LED/Taster, MCUboot signiert), Flash-Werkzeug ROM-UART, Tests; Energiemessplan
2026-11-07 Phase 4b: PCB-Kontur Rev B (Kopf 26 mm, Band 392 mm²), Sensorgehäuse V4 34x13x57.5 mit Sichtschale, FEM Rev B
    [distanzlehre_23p5.3mf, distanzlehre_23p5.step, fenster_tropfen.3mf, fenster_tropfen.step, fenster_tropfen.stl, fluidi_sensor.FCStd, fluidi_sensor_assembly.step, huelse_grau.3mf]
2026-11-07 Phase 4: Sicherheitsprüfung Kragen (freigegeben mit Auflagen) und Firmware/Protokoll (VETO F-K1 Kopplung ohne Commitment)
2026-11-07 Phase 4c: Protokoll v2 (Commitment/Reveal bei der Kopplung, gateway-taugliche Fristen, Messung ohne Funk), Firmware-Härtung (Reset-Schleifen, RNG, Serien-CCFG, Schlüsselprüfung); Antwort auf Befunde
    [fl_app.c, fl_app.h, fl_ble.c, fl_hw.c, fl_ota.c, fl_ota.h, fl_port.h, fl_proto.c]
2026-11-07 Phase 4: Sicherheit Runde 2 – VETO F-K1 aufgehoben (Protokoll v2), Auflage G-1 Gateway v2, kleine Befunde N-1..N-5
2026-11-07 Phase 4c/4d: Gateway und PWA auf Protokoll v2 (Commitment-Kopplung, asynchrones MEASURE), byte-gleich mit Referenzvektoren; Protokollprüfung Runde 2
2026-11-07 Phase 4a: Layout Sensor Rev B (4 Lagen, DRC 0 in WSL/Windows, Gerber/CPL/BOM/STEP), Sicherheitsauflagen K-1..K-3 als DRC-Regeln; Fachzone mit 0.05 mm Reserve
    [fluidi_sensor-B_Cu.gbl, fluidi_sensor-B_Mask.gbs, fluidi_sensor-B_Paste.gbp, fluidi_sensor-B_Silkscreen.gbo, fluidi_sensor-Edge_Cuts.gm1, fluidi_sensor-F_Cu.gtl, fluidi_sensor-F_Mask.gts, fluidi_sensor-F_Paste.gtp]
2026-11-07 Phase 4 Welle 3: Sicherheitspruefung Layout Rev B (kein Veto, L-1 mit Auflagen), Pin-/Energieabgleich Rev B (Pins ok, Laufzeit neu)
2026-11-07 Firmware: LED-Ausgabe nach FW-4 (Pulse <= 5 ms, Software-Takt), Pull-up-Strom bei 3.8 V korrigiert (EP-2, EP-3)
    [energy_budget.py, fl_hw.c, fl_ui.c, fl_ui.h]
2026-11-07 Phase 4 Welle 3: Kollisionspruefung Gehaeuse/Platinen-STEP (keine Kollision), Platinenanschlag, Clip nach Datenblatt, PCB_OUTLINE Rev C
    [distanzlehre_23p5.3mf, distanzlehre_23p5.step, fenster_tropfen.3mf, fenster_tropfen.step, fluidi_sensor.FCStd, fluidi_sensor_assembly.step, fluidi_sensor_mit_pcb.step, huelse_grau.3mf]
2026-11-07 D-023: Via-in-Pad im Fach mit Auflagen, Fach +0.7 mm (V-K), Taster M-4, LED EP-2
2026-11-07 D-023 umgesetzt: Fach 24.2 mm (V-K), Taster M-4 mit Quetschrippen, FEM V-K (LC1 SF 2.31, LC6 238 N), PCB_OUTLINE Rev C
    [distanzlehre_23p5.3mf, distanzlehre_23p5.stl, distanzlehre_24p2.3mf, distanzlehre_24p2.step, distanzlehre_24p2.stl, fenster_tropfen.3mf, fenster_tropfen.step, fluidi_sensor.FCStd]
2026-11-07 Kosten Rev B mit JLC-Angebot (5 Stk 65.21 / 20 Stk 76.30 USD): Serie 8.38 CHF/Sensor, Ziel < 10 CHF erfuellt (DFM W-2)
2026-11-08 Layout Rev C: Clip W 23.1 an Lage V-K, TP3 entfaellt (4 VIP), ENIG, Via-Attribute, U3 TI-Landmuster, Regeln LS-K1/K2/Pad-Pad, Warnsymbol, Register Rev C; DRC 0 (WSL mit/ohne Neufuellung, Windows 0 Fe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
    [INDEX.csv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]
2026-11-08 Register-Staging Rev C nachgefuehrt
    [INDEX_schaltplan_b.csv]
2026-11-08 Erstprogrammierung (D-024): Programmieradapter Rev 1 (2.0 V, AUP1G17-Puffer), SPICE-Nachweis, Behelf fuer Muster, Anleitung; ERC-Warnung U3 behoben, run_all.sh erhaelt Layout-Einstellungen
    [INDEX.csv, fluidi_programmer.kicad_sch, fluidi_sensor.kicad_sch, prog_uart_dc.csv, prog_uart_tran.csv]
2026-11-08 Finale Renderings Phase 4e: 6 Bilder (Topf/LED gruen, nah/LED blau, Explosion, Batteriewechsel, Gateway Buero, Produktfoto) aus CAD Rev C und KiCad-STEP, Skripte; Meshes abgeleitet (gitignore)
2026-11-08 Phase 4: Zusammenfassung und Pruefbericht zur Freigabe
2026-11-08 Platinen-Ansichten (KiCad 3D-Render) Rev C mit Skript
2026-11-08 Veto PS-K1 umgesetzt: Weg B nur mit Dummy-Scheibe, feste Abbaureihenfolge, Zellen < 2.6 V entsorgen, Fotonachweis; .gitignore sperrt Schluesseldateien (CK-L1)
2026-11-08 Phase 5 Software: Gateway-Zeit einheitlich (timesvc.wall), Handyzeit automatisch und plausibilisiert, epoch_ms; Entscheidungsvorlage RTC (W-8), Checkliste, Testplan-Beitrag; 70+11+24+36 Tests OK. Sic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
2026-11-08 Phase 5 Fertigung: Bestellanleitung JLC Feld fuer Feld, ORDER Rev C an echtes Formular angepasst (Remove Mark, Confirm Production File, Remark POFV), Kosten final inkl. Gateway/RTC, Checkliste, Relea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
    [Adafruit_4282_PiRTC-DS3231_Schematic_2021-02-22.sch, BOM_GATEWAY.csv, INDEX.csv]
2026-11-08 Phase 5 Elektronik: Checkliste, Testplan-Beitrag (EI-1..40), Masszeichnung Platine (3 Blaetter), osc_sim-Haenger behoben (Timeout + tmax-Rueckfall), Oszillator mit Rev-B-Fit 4.76-36.44 MHz, PINMAP/Sc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
    [fluidi_sensor.kicad_sch, osc_results.csv]
2026-11-08 Phase 5 Mechanik: 14 Fertigungszeichnungen (Sensor FL-S-00..10, Gateway FL-G-01..03, Masse aus Modell, 170 Pruefungen), Montage- und Batteriewechselanleitung, Checkliste, Testplan-Beitrag; Korrekture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
    [INDEX.csv, deckel_blau.3mf, deckel_blau.step, deckel_blau.stl, fluidi_gateway_pi.FCStd, fluidi_gateway_pi_assembly.step, fluidi_sensor.FCStd, fluidi_sensor_assembly.step]
2026-11-08 Phase 5 Mechanik Runde 2: P5-M2 Tastermechanik (Nase 45 Grad an der Zunge, Worst Case +0.14 mm), RTC-Rahmen im Gateway-Deckel, SHT41-Konflikt als Entscheidungsvorlage, Zeichnungen neu (173 Pruefungen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
    [INDEX.csv, deckel_blau.3mf, deckel_blau.step, deckel_blau.stl, fluidi_gateway_pi.FCStd, fluidi_gateway_pi_assembly.step, fluidi_sensor.FCStd, fluidi_sensor_assembly.step]
2026-11-08 Fertigung: Antworten auf Red-Team W-1..W-5/K-1..K-7 (Release --check, Drehregel, Pre-reflow-Stopp, Platzhalter-Pruefung, Gateway-BOM-Status, Remark-Datei), R3-K5 Verpoltest; Hashes folgen nach Layout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
    [BOM_GATEWAY.csv]
2026-11-08 Layout Rev C ohne JLC-Platzhalter (W-4): nur B.Silkscreen geaendert (gerber_geom_diff), BOM/CPL bytegleich, DRC 0; neue Gerber-sha256 bf1902ea in ORDER/BESTELLEN. Antennenabstand 0.70 mm bestaetigt (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
    [INDEX.csv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]
2026-11-08 Mechanik Pruefrunde 2: Stoessel verdrehgesichert (+-1.5 Grad), 60-Grad-Keil Finger/Nase, Toleranzkette vollstaendig (Worst Case +0.17), Klemmring Presssitz, Membransitz 0.8, Zapfenwand Druckvorgabe, 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
    [fluidi_gateway_pi.FCStd, fluidi_gateway_pi_assembly.step, fluidi_sensor.FCStd, fluidi_sensor_assembly.step, fluidi_sensor_mit_pcb.step, kappe_blau.3mf, kappe_blau.step, kappe_blau.stl]
2026-11-08 D-026 Tastermechanik: Muster mit Auflagen; N-1 Rueckfall Batteriewechsel behoben (R3-W1-Text), Einsteckhinweis, Pruefungen vor Kappenverguss, PT11.08 mit 50 N und Fall
2026-11-08 Release-Paket production/rev-C (66 Dateien, Stand 16a1c84, Gerber bf1902ea); --check prueft Quellen seit Stand statt HEAD-Gleichheit
    [BOM_GATEWAY.csv, deckel_blau.3mf, deckel_blau.step, deckel_blau.stl, distanzlehre_24p2.3mf, distanzlehre_24p2.step, distanzlehre_24p2.stl, fenster_tropfen.3mf]
2026-11-08 Phase 5: Zusammenfassung und Pruefbericht zur Freigabe
2026-11-08 D-005 bestaetigt, D-027 Gateway-LED vorlaeufig
2026-11-08 Phase 6 Gateway: ohne RTC (D-028), Status-LED (D-027), Anleitungen Inbetriebnahme/Pairing-Kalibrierung/Fehlersuche, REQ-GW-09 an D-028
2026-11-08 Phase 6 O-1/O-2: Vorschlag Vergussmasse ER2223 und Kantenversiegelung (Vorschlag D-030, gesperrt bis Pruefung), Feldsimulation coat_epoxy
    [INDEX.csv, coat_epoxy.csv]
2026-11-08 Phase 6: Testfirmware TF-1..TF-4 (make TESTFW=n, Serie bit-gleich), testfw_eval.py, Anleitung TESTFIRMWARE; PROGRAMMIEREN Regel 2 auf 10 mA (EP-03)
2026-11-08 Phase 6 Einkauf: Einkaufsliste (Haendlergruppierung), SHT40 SEN0428 (D-029), Gateway-BOM ohne RTC, PL2303-Alternative (bedingt), Registerabgleich (1 Luecke: Netzteil)
    [BOM_GATEWAY.csv, EINKAUFSLISTE.csv, INDEX.csv]
2026-11-08 Firmware: BLE-Assert und Stackueberlauf -> fl_fault_handler (eigene fl_main.c/fl_assert.c statt SDK main_freertos.c), Buildpruefung erweitert
2026-11-08 Gateway/PWA: Diagnose abrufen (POST/GET /sensors/{id}/diag), fw_build und Testfirmware-Kennzeichnung, gemeinsamer Decoder sensordiag.py
2026-11-08 Programmierplatz: PL2303-Board statt CH343 freigegeben mit B1-B6 (SPICE prog_uart_pl2303), Weg B max. 2.1 V; Gateway-LED 470 Ohm bestaetigt
    [BOM_GATEWAY.csv, EINKAUFSLISTE.csv, INDEX.csv, fluidi_programmer.kicad_sch, prog_uart_pl2303_dc.csv, prog_uart_pl2303_pwr.csv, prog_uart_pl2303_tran.csv]
2026-11-08 Programmieradapter PA-6: R2 470 Ohm VIO-GND (C17710), USB-Ziehen 0.014 V; flash_sensor Hinweise 2.1 V/PL2303
    [INDEX.csv, fluidi_programmer.kicad_sch, prog_uart_pl2303_pwr.csv]
2026-11-08 Phase 6 Mechanik: Klimakammer SEN0428, RTC entfernt, Gewindeeinsatz 3.9 mm, Schraube TX6, eSun ASA+ bedingt (D-032); Exporte und Zeichnungen neu
    [deckel_blau.3mf, deckel_blau.step, deckel_blau.stl, distanzlehre_24p2.3mf, distanzlehre_24p2.step, fenster_tropfen.3mf, fenster_tropfen.step, fenster_tropfen_gw.3mf]
2026-11-09 Phase 6: Einkaufsliste mit Verguss- und Programmieradapter-Block, Gateway-BOM, Register, Release-Generator erweitert (Quellarchiv, Anleitungen, Renderings)
    [BOM_GATEWAY.csv, EINKAUFSLISTE.csv, INDEX.csv]
2026-11-09 Release-Paket production/rev-C Phase 6 neu erzeugt (--check aktuell, JLC-Dateien bytegleich, Quellarchiv ohne Schluessel)
    [BOM_GATEWAY.csv, EINKAUFSLISTE.csv, deckel_blau.3mf, deckel_blau.step, deckel_blau.stl, distanzlehre_24p2.3mf, distanzlehre_24p2.step, fenster_tropfen.3mf]
2026-11-09 D-033 LED-Fenster: UHU plus endfest 300 (Haerter H314 nachgetragen), Polymaker ASA Natural; Zeichnungen und Einkaufsliste nachgefuehrt
    [EINKAUFSLISTE.csv, INDEX.csv]
2026-11-09 Firmware C-1: IO-Latches nach Shutdown freigeben (RSTSTA vorher sichern); Fruehstart-Zaehler vor BLE-Init (F-67); flash_sensor verlangt --testfw fuer Testfirmware; PROGRAMMIEREN 10 mA ohne 20-mA-Zusa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
2026-11-09 Dummy-Scheibe als JLC-Platinen (PLUS 1.0 mm + MINUS 2.0 mm, DRC 0), Werkstatt-Voraussetzungen Weg B, Variante B2 (Puffer, Pruefung offen)
    [INDEX.csv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]
2026-11-09 Fertigung Schlusspruefung: Firmware aus Quellarchiv baubar (DEV-Hex Muster), Kassenbedarf, BT1-Vorrat 25 Stk, Haendler gebuendelt, LOKAL aus Einkaufsliste (Serie 8.69 CHF), Netzteil-DoC, Sicherheitsa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
    [BOM_GATEWAY.csv, EINKAUFSLISTE.csv]
2026-11-09 Dummy-Scheibe in JLC-Bestellung (Pflichtschritt, Stopp-Regel Versand), Werkstatt-Block Weg B, Release-Generator mit Dummy-Gerbern; Kassenbedarf 1078.69 CHF
    [EINKAUFSLISTE.csv]
2026-11-09 Sicherheit: Dummy-Scheibe und B2 ohne Veto (DS-B1..B5, DS-K1..K5), Handschuh MAPA Solo 977 mit HS-1..HS-5
2026-11-09 Mechanik Schlusspruefung: Gateway-LED-Rohr 3 mm in der Wanne, MONTAGE nach D-030 (Abhakliste, Kap. 3b OTA vor Verguss), EPDM-O-Ringe, Kennungsetikett, PRINT_SETTINGS Bambu Studio, Handschuh HS-1..5, 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
    [EINKAUFSLISTE.csv, deckel_blau.3mf, deckel_blau.step, fenster_tropfen_gw.3mf, fenster_tropfen_gw.step, fluidi_gateway_pi.FCStd, fluidi_gateway_pi_assembly.step, wanne_grau.3mf]
2026-11-09 Einkauf: Zubehoer beim Auftraggeber vorhanden, Filament nur nach Art (ASA, Farbe frei), Summen Muster 621.52 / Serie 274.87 CHF
    [EINKAUFSLISTE.csv]
2026-11-09 Dummy-Scheibe: Auflagen DS-B1..B5/DS-K1..K5 (B2-Ablauf 19200 Bd, Bruecke J3-J9, Leitung <= 10 cm, SPICE bis 2.1 V), PROGRAMMIEREN v1.3, neue Gerber-Hashes in BESTELLEN/ORDER
    [fluidi_dummy_minus-B_Cu.gbl, fluidi_dummy_minus-B_Mask.gbs, fluidi_dummy_minus-B_Silkscreen.gbo, fluidi_dummy_minus-Edge_Cuts.gm1, fluidi_dummy_minus-F_Cu.gtl, fluidi_dummy_minus-F_Mask.gts, fluidi_dummy_minus-F_Silkscreen.gto, fluidi_dummy_minus-NPTH.drl]
2026-11-09 Release-Paket production/rev-C nach Phase-6-Pruefrunde neu erzeugt (125 Dateien, --check aktuell, JLC bytegleich, DEV-Muster-Hex)
    [BOM_GATEWAY.csv, EINKAUFSLISTE.csv, deckel_blau.3mf, deckel_blau.step, fenster_tropfen_gw.3mf, fenster_tropfen_gw.step, wanne_grau.3mf, wanne_grau.step]
2026-11-09 Phase 6: Zusammenfassung und Pruefbericht zur Freigabe
